joeyliu522/VVI-project/CAD files/Older 3D printed parts/production_parts/electronics/external_harness/EL-HR0181_Y-Z-end_Harness_revC.pdf

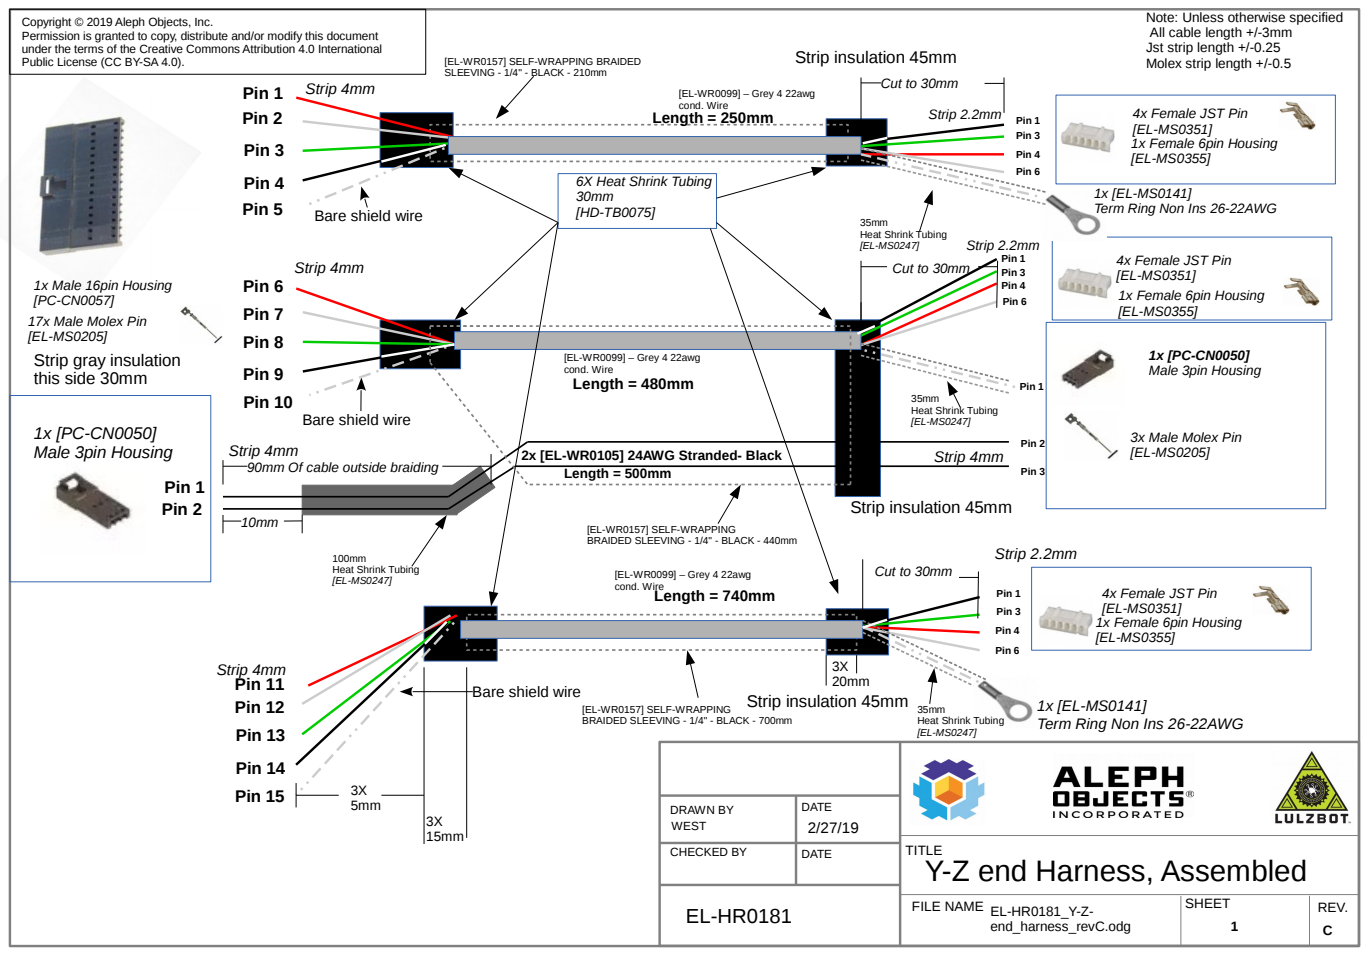
[picture p1: page 1]
FILE NAME; SHEET; REV.; Length = 250mm; Strip insulation 45mm; Pin 1 Pin 2; Pin 3; Pin 4 Pin 5; Pin 6; Strip 4mm; [EL-WR0099] – Grey 4 22awg; cond. Wire; 1x Female 6pin Housing [EL-MS0355]; Strip 2.2mm; Pin 7; Pin 8; Pin 9; Pin 10; Pin 11 Pin 12; Pin 15; Pin 13; Pin 14; [EL-MS0351] Pin 3; Pin 1; Pin 4; Length = 480mm; [EL-WR0099] – Grey 4 22awg cond. Wire; Length = 740mm; Pin 4 Pin 6; EL-HR0181_Y-Z- end_harness_revC.odg; Cut to 30mm; 35mm Heat Shrink Tubing [EL-MS0247]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

Copyright © 2019 Aleph Objects, Inc.
Permission is granted to copy, distribute and/or modify this document
under the terms of the Creative Commons Attribution 4.0 International
Public License (CC BY-SA 4.0).

Note: Unless otherwise specified
All cable length +/-3mm
Jst strip length +/-0.25
Molex strip length +/-0.5

[EL-WR0157] SELF-WRAPPING BRAIDED
SLEEVING - 1/4" - BLACK - 210mm

4x Female JST Pin

Term Ring Non Ins 26-22AWG

Bare shield wire

Heat Shrink Tubing
Cut to 30mm

1x Female 6pin Housing

1x Male 16pin Housing
17x Male Molex Pin
Strip gray insulation
this side 30mm

3x Male Molex Pin

Strip 4mm
90mm Of cable outside braiding

2x [EL-WR0105] 24AWG Stranded- Black
Length = 500mm

[EL-WR0157] SELF-WRAPPING
BRAIDED SLEEVING - 1/4" - BLACK - 440mm

BRAIDED SLEEVING - 1/4" - BLACK - 700mm

DRAWN BY WEST | DATE 2/27/19

CHECKED BY | DATE

TITLE
Y-Z end Harness, Assembled

Initial | comments | date | Rev
JW | update bom to have correct total amount of heat shrink tubing, remove pp-mp0059 | 03/25/19 | A
JW | Change pinout of z right jst side | 5/20/19 | B
JW | Add call out for position of heatshrink tubing | 7/10/19 | C

AO part number | qty | UoM | Supplier | supplier pn
EL-WR0099 | 1470 | mm | Allcable | C0762A.41.10
EL-MS0247 | 205 | mm | Electronics distributors corp | 88-01870
EL-MS0205 | 20 | pce | TTI global | 16-02-0107
HD-TB0075 | 180 | mm | McMaster | 7856k76
EL-WR0157 | 1350 | mm | Wirecare | F6N0.25BK
PC-CN0057 | 1 | pce | Sager | 70107-0015
EL-MS0351 | 12 | pce | Future electronics | SPH-002T-P0.5S
EL-MS0355 | 3 | pce | Future electronics | PHR-6
EL-MS0141 | 2 | pce | TTI global | P22-4R-M
PC-CN0050 | 2 | pce | TTI global | 701070002
EL-WR0105 | 1000 | mm | Allcable | HU1569247BK
