joeyliu522/VVI-project/CAD files/Older 3D printed parts/production_parts/electronics/external_harness/EL-HR0182_y_motor_ground_extension_revC.pdf

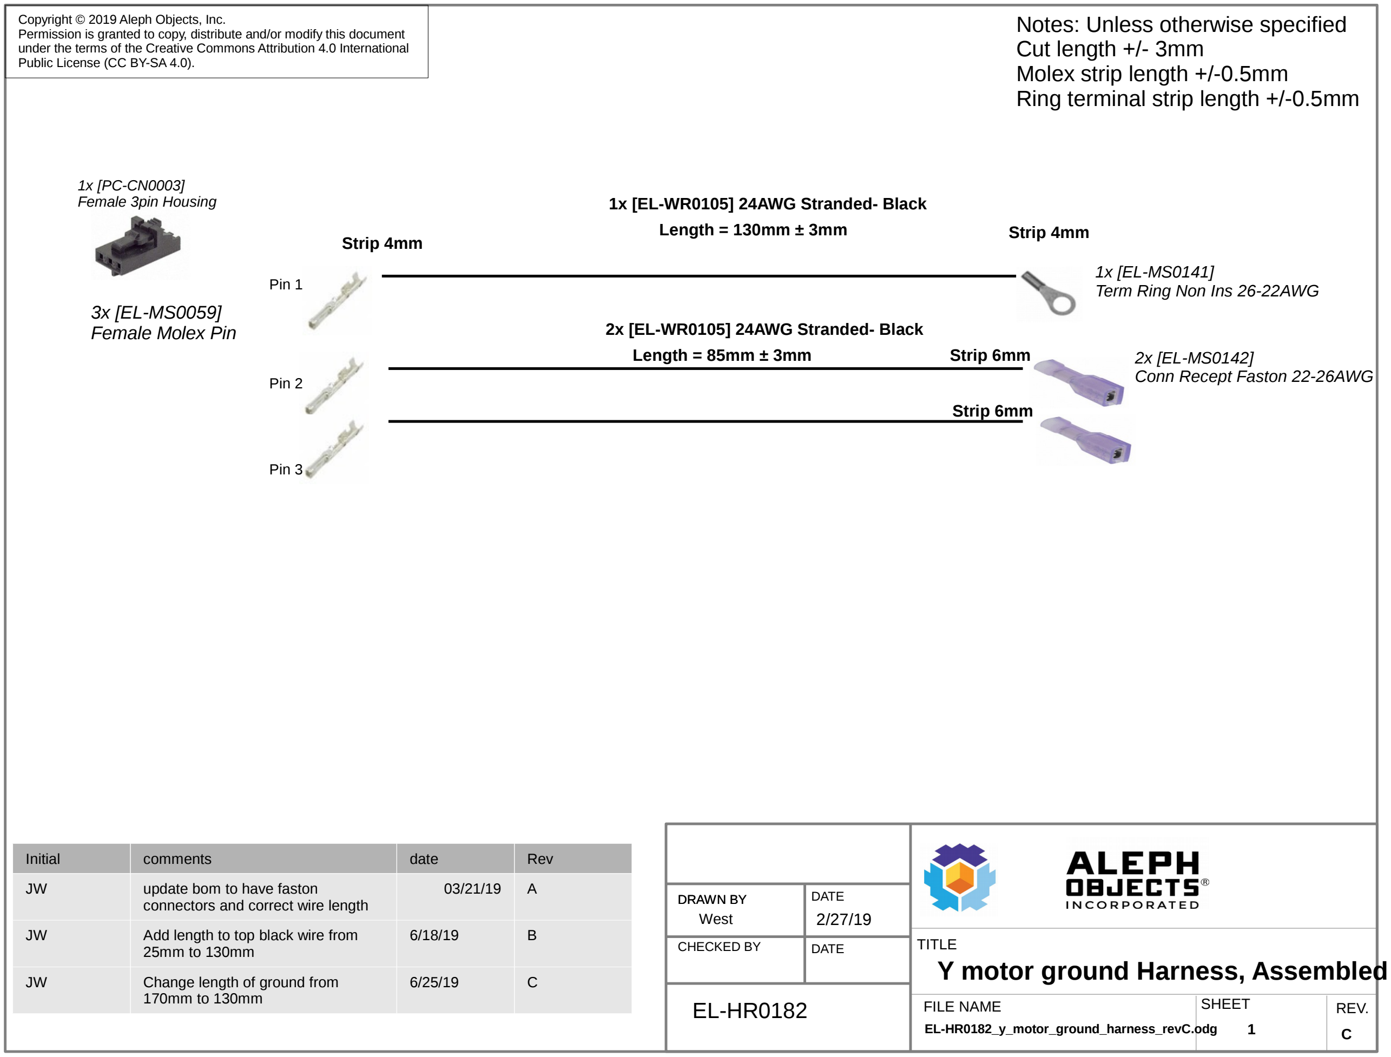
[picture p2: figure]
DRAWN BY DRAWN BY West; DATE 2/27/19; TITLE; FILE NAME; SHEET; REV.; Copyright © 2019 Aleph Objects, Inc.; Public License (CC BY-SA 4.0).; CHECKED BY; DATE; Length = 130mm ± 3mm; 1x [EL-WR0105] 24AWG Stranded- Black; Strip 4mm Strip 4mm; Pin 1; 1x [EL-MS0141] Term Ring Non Ins 26-22AWG; 3x [EL-MS0059] Female Molex Pin; Notes: Unless otherwise specified Cut length +/- 3mm Molex strip length +/-0.5mm Ring terminal strip length +/-0.5mm; 2x [EL-MS0142] Conn Recept Faston 22-26AWG; Strip 6mm; Pin 2; Pin 3; Length = 85mm ± 3mm; 1x [PC-CN0003] Female 3pin Housing; Y motor ground Harness, Assembled; 2x [EL-WR0105] 24AWG Stranded- Black; Initial; comments; date; Rev

Permission is granted to copy, distribute and/or modify this document under the terms of the Creative Commons Attribution 4.0 International

EL-HR0182_y_motor_ground_harness_revC.odg

JW | update bom to have faston connectors and correct wire length | 03/21/19 | A
JW | Add length to top black wire from 25mm to 130mm | 6/18/19 | B
JW | Change length of ground from 170mm to 130mm | 6/25/19 | C

AO P/n | qty | unit | Supplier | supplier P/n
PC-CN0003 | 1 | pce | TTI | 0050579403
EL-MS0059 | 3 | pce | TTI | 16-02-0086
EL-WR0105 | 340 | mm | Allcable | HU1569247B K
EL-MS0141 | 1 | pce | TTI | P22-4R-M
EL-MS0142 | 2 | pce | TTI | 7-520365-2
