joeyliu522/VVI-project/CAD files/Older 3D printed parts/production_parts/electronics/internal_harness/EL-HR0152_CB_PSU_to_ground_green.pdf

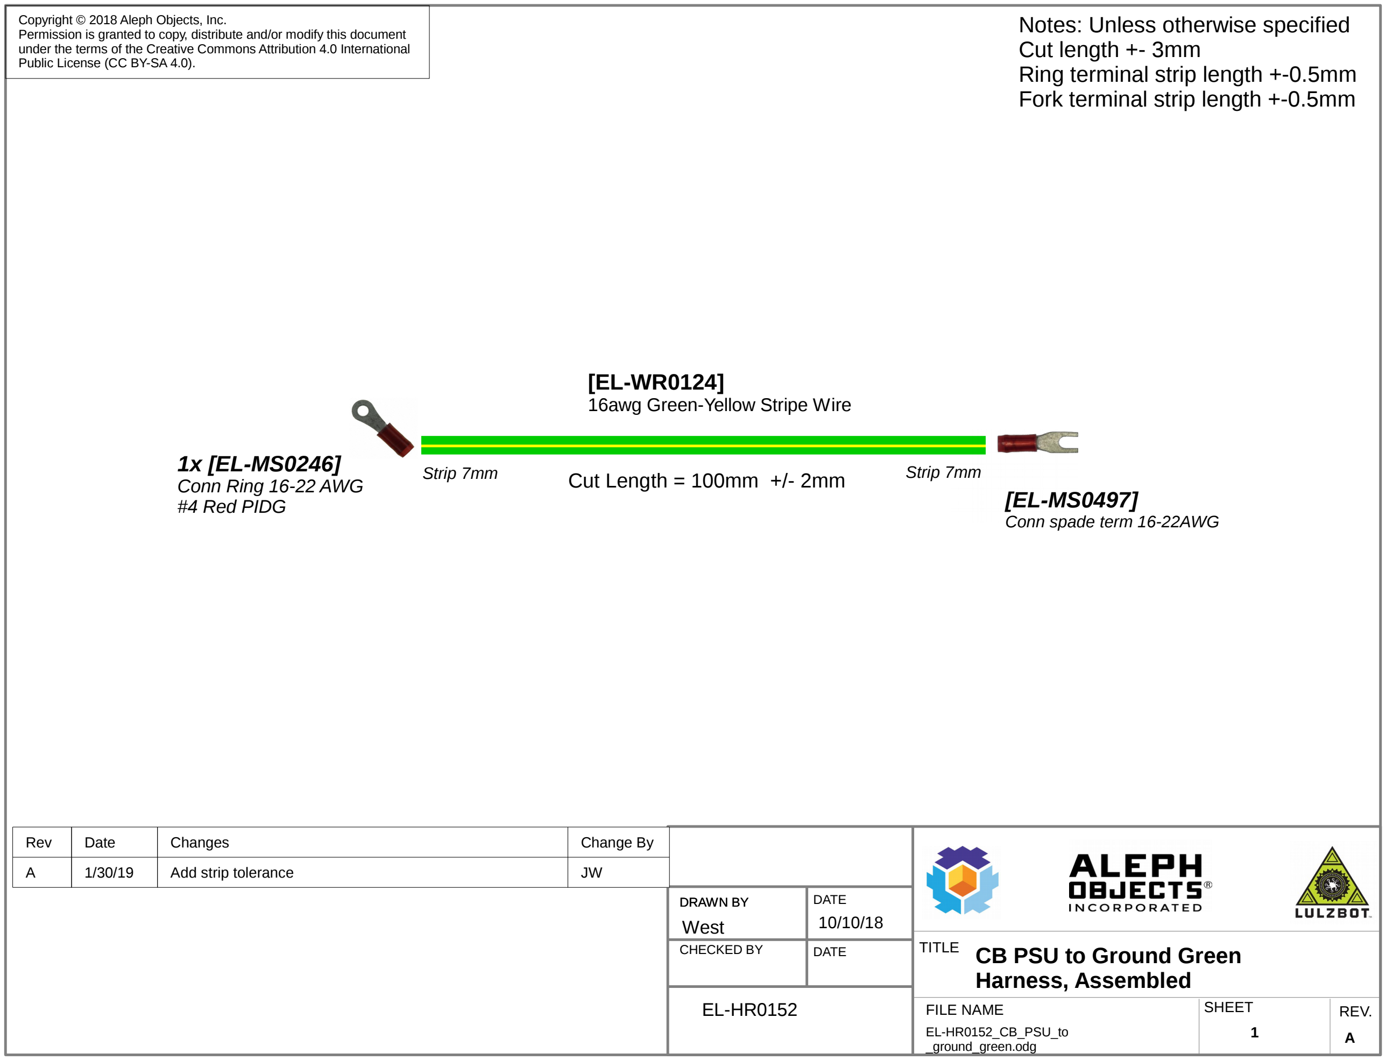
[picture p3: figure]
DRAWN BY DRAWN BY West; DATE 10/10/18; TITLE; FILE NAME; SHEET; REV.; CB PSU to Ground Green Harness, Assembled; Copyright © 2018 Aleph Objects, Inc.; Public License (CC BY-SA 4.0).; Cut Length = 100mm +/- 2mm; 1x [EL-MS0246] Conn Ring 16-22 AWG #4 Red PIDG; CHECKED BY; DATE; EL-HR0152_CB_PSU_to _ground_green.odg; [EL-WR0124] 16awg Green-Yellow Stripe Wire; Strip 7mm; [EL-MS0497] Conn spade term 16-22AWG; Notes: Unless otherwise specified Cut length +- 3mm Ring terminal strip length +-0.5mm Fork terminal strip length +-0.5mm; Rev; Date; Changes; Change By; Add strip tolerance

Permission is granted to copy, distribute and/or modify this document under the terms of the Creative Commons Attribution 4.0 International

AO P/n | qty | unit | Supplier | supplier P/n
EL-MS0246 | 1 | pce | digikey | A27229TR-ND
EL-WR0124 | 100 | mm | allcable | HU15691626 GN
EL-MS0497 | 1 | pce | tti | 2-34541-1
