joeyliu522/VVI-project/CAD files/Older 3D printed parts/production_parts/electronics/internal_harness/EL-HR0154_CB_DC_Power_Harness.pdf

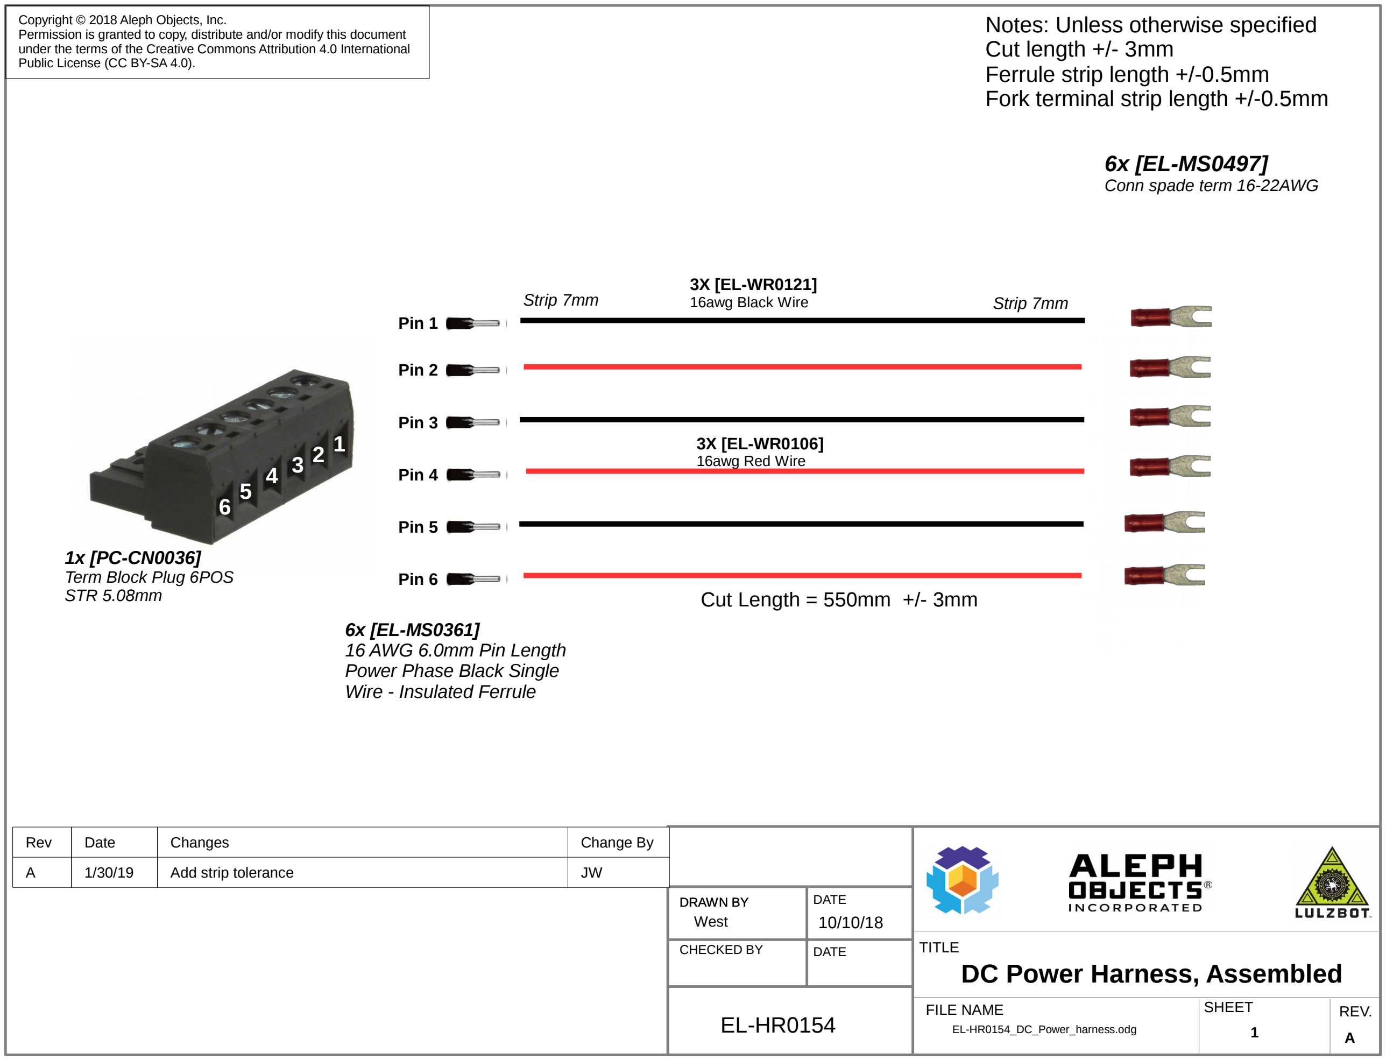
[picture p4: figure]
DRAWN BY DRAWN BY West; DATE 10/10/18; TITLE; FILE NAME; SHEET; REV.; DC Power Harness, Assembled; Copyright © 2018 Aleph Objects, Inc.; Public License (CC BY-SA 4.0).; Cut Length = 550mm +/- 3mm; 6x [EL-MS0361] 16 AWG 6.0mm Pin Length Power Phase Black Single Wire - Insulated Ferrule; CHECKED BY; DATE; Strip 7mm; 16awg Black Wire; 3X [EL-WR0106] 16awg Red Wire; Pin 1; Pin 2; Pin 3; Pin 4; Pin 5; Pin 6; 1x [PC-CN0036] Term Block Plug 6POS STR 5.08mm; 6x [EL-MS0497] Conn spade term 16-22AWG; EL-HR0154_DC_Power_harness.odg; Notes: Unless otherwise specified Cut length +/- 3mm Ferrule strip length +/-0.5mm Fork terminal strip length +/-0.5mm; Rev; Date; Changes; Change By; Add strip tolerance

Permission is granted to copy, distribute and/or modify this document under the terms of the Creative Commons Attribution 4.0 International

AO P/n | qty | unit | Supplier | supplier P/n
EL-WR0121 | 1650 | mm | Allcable | HU15691626BK
EL-WR0106 | 1650 | mm | Allcable | HU15691626RD
PC-CN0036 | 1 | pce | TTI Global Distribution | 03953000006
EL-MS0361 | 6 | pce | TTI Global Distribution | FSD78-6-D
EL-MS0497 | 6 | pce | TTI Global Distribution | 2-34541-1
