joeyliu522/VVI-project/CAD files/Older 3D printed parts/production_parts/electronics/internal_harness/EL-HR0167_plug_to_ground_green.pdf

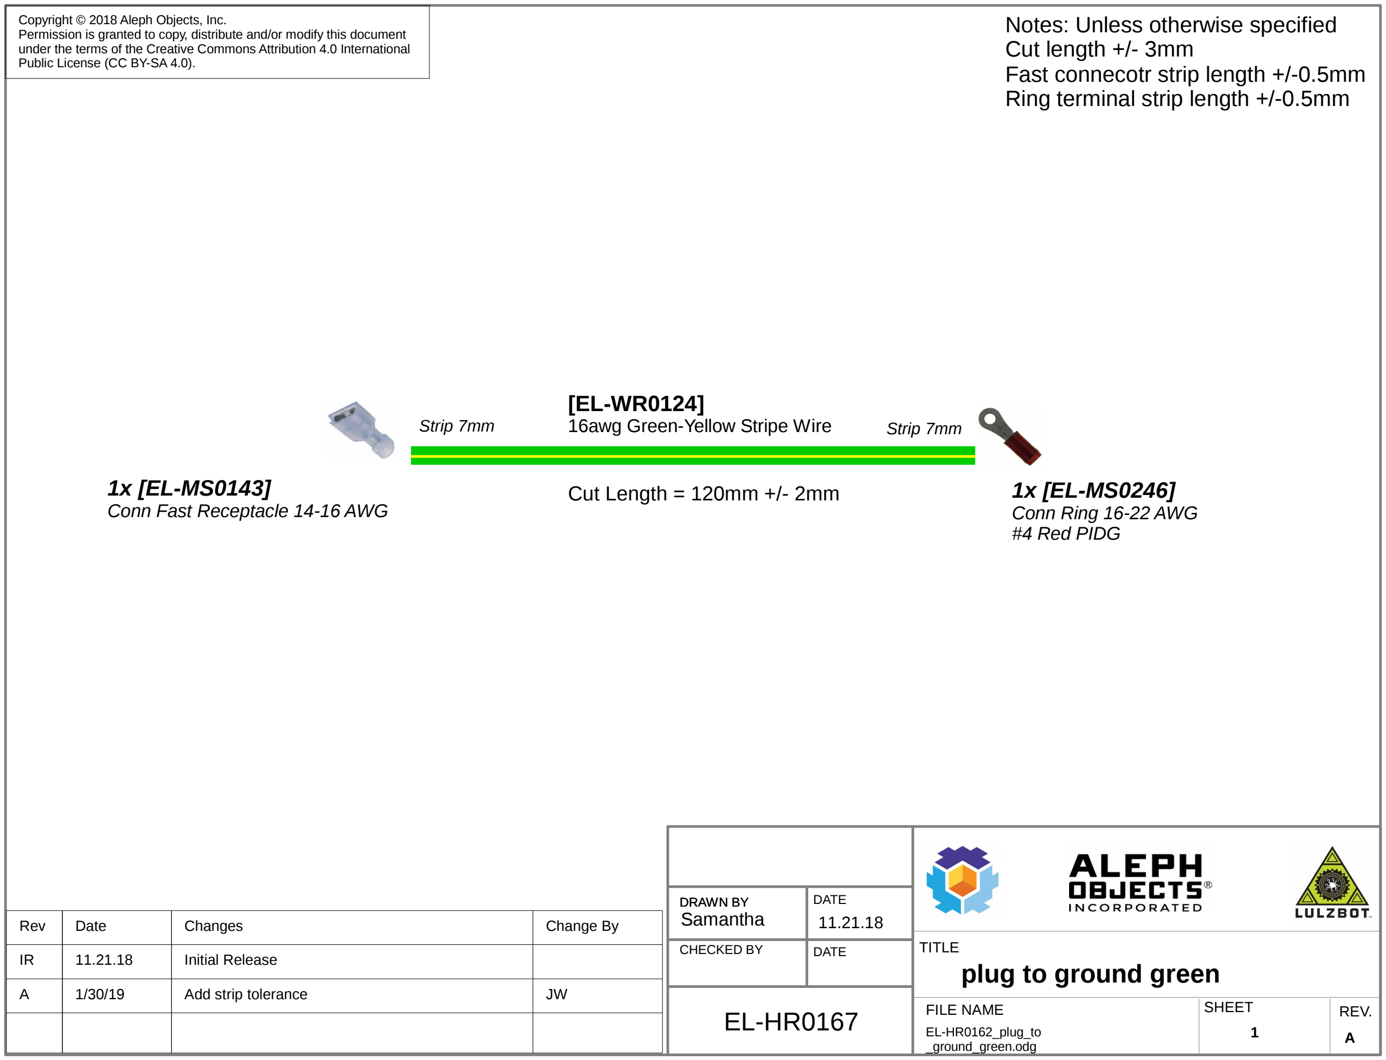
[picture p5: figure]
TITLE; FILE NAME; SHEET; REV.; plug to ground green; Copyright © 2018 Aleph Objects, Inc.; Public License (CC BY-SA 4.0).; Cut Length = 120mm +/- 2mm; CHECKED BY; DATE; EL-HR0162_plug_to _ground_green.odg; 1x [EL-MS0246] Conn Ring 16-22 AWG #4 Red PIDG; 1x [EL-MS0143] Conn Fast Receptacle 14-16 AWG; Rev; Date; Changes; Change By; Initial Release; Add strip tolerance; Notes: Unless otherwise specified Cut length +/- 3mm Fast connecotr strip length +/-0.5mm Ring terminal strip length +/-0.5mm

DRAWN BY DRAWN BY Samantha | DATE 11.21.18

Permission is granted to copy, distribute and/or modify this document under the terms of the Creative Commons Attribution 4.0 International

Strip 7mm | 16awg Green-Yellow Stripe Wire | Strip 7mm

AO P/n | qty | unit | Supplier | supplier P/n
EL-MS0143 | 1 | pce | TTI Global Distribution | 3-350820-2
EL-WR0124 | 120 | mm | Allcable | HU15691626GN
EL-MS0246 | 1 | pce | Digi-Key Corp | A27229TR-ND
