joeyliu522/VVI-project/CAD files/Older 3D printed parts/production_parts/electronics/toolhead/AS-CB0061_extruder_motor_harness_revB.pdf

DRAWN BY DRAWN BY Tutley | DATE 09/28/2017
CHECKED BY Kent | DATE 11/14/17

TITLE

FILE NAME AS-CB0061_extruder_motor_harness_revB.odg | SHEET 1 | REV. B

v2Aero Extruder Motor Harness

Copyright © 2017 Aleph Objects, Inc.
Permission is granted to copy, distribute and/or modify this document under the terms of the Creative Commons Attribution 4.0 International Public License (CC BY-SA 4.0).

4x
[EL-MS0480]
CONN TERM MALE
20-24AWG TIN
(Micro-Fit 3.0™)

1x [PC-CN0101]
Molex-CONN PLUG 20POS
3MM VERT DUAL, BLACK

1 11

2

3 | 13
4 | 14
5 | 15
6 | 16
7 | 17
8 | 18

Pin 1

12

| 9 | 19
Length = 180mm | 10 | 20

Pin 4

Strip 2.5mm | [EL-WR0103] – 24awg Red Wire

[EL-WR0105] – 24awg Black Wire

Strip 3mm

Pin 6

[EL-WR0107] – 24awg White Wire

[EL-WR0119] – 24awg Green Wire
Pin 3

Pin 1

Pin 11

Pin 1

Pin 12

Pin 2

1x 2mm 6pos Connector
[EL-MS0355]

4x Female JST Pin
[EL-MS0351]
Rev | Date | Changes | Change by
A | 11/1/17 | Adjusted strip length for molex microfit from 4mm to 3mm | TJU | AS-CB0061
B | 11/14/17 | Changed PN for connector housing | Kent

AO part number | qty | UoM | Supplier | supplier pn
EL-MS0351 | 4 | pce | Future electronics | SPH-002T-P0.5S
EL-MS0355 | 1 | pce | Future electronics | PHR-6
EL-MS0480 | 4 | pce | TTI global | 43031-0001
PC-CN0101 | 1 | pce | TTI global | 43020-2001
EL-WR0105 | 180 | mm | Allcable | HU1569247BK
EL-WR0107 | 180 | mm | Allcable | HU1569247WE
EL-WR0119 | 180 | mm | Allcable | HU1569247GN
EL-WR0103 | 180 | mm | Allcable | HU1569247RD
