joeyliu522/VVI-project/CAD files/Older 3D printed parts/production_parts/electronics/toolhead/AS-CB0062_230mm_extruder_blower_harness_revB.pdf

DRAWN BY DRAWN BY Tutley | DATE 09/28/2017
CHECKED BY | DATE

TITLE

FILE NAME | SHEET | REV.

# V2Aero Extruder Blower Harness

Copyright © 2018 Aleph Objects, Inc.
Permission is granted to copy, distribute and/or modify this document under the terms of the Creative Commons Attribution 4.0 International Public License (CC BY-SA 4.0).

B

AS-CB0062_230mm_extruder_
blower_harness_revB.odg | 1

### Length = 230mm

### 1x [EL-FA0047]

## 51x15 24v Blower

Rev | Date | Changes | Change By | Mini 2 / TAZ 7
A | 11/1/17 | Reduced strip length for microfit terminals from 4mm to 3mm | LF
B | 3/22/18 | Reduce cut length by 20mm | West

Strip 3mm
2x

## [EL-MS0480] CONN TERM MALE 20-24AWG TIN (Micro-Fit 3.0™)

# AS-CB0062

## These wires are 28AWG
