joeyliu522/VVI-project/CAD files/Older 3D printed parts/production_parts/electronics/toolhead/AS-CB0063_hotend_gnd_wire_revB.pdf

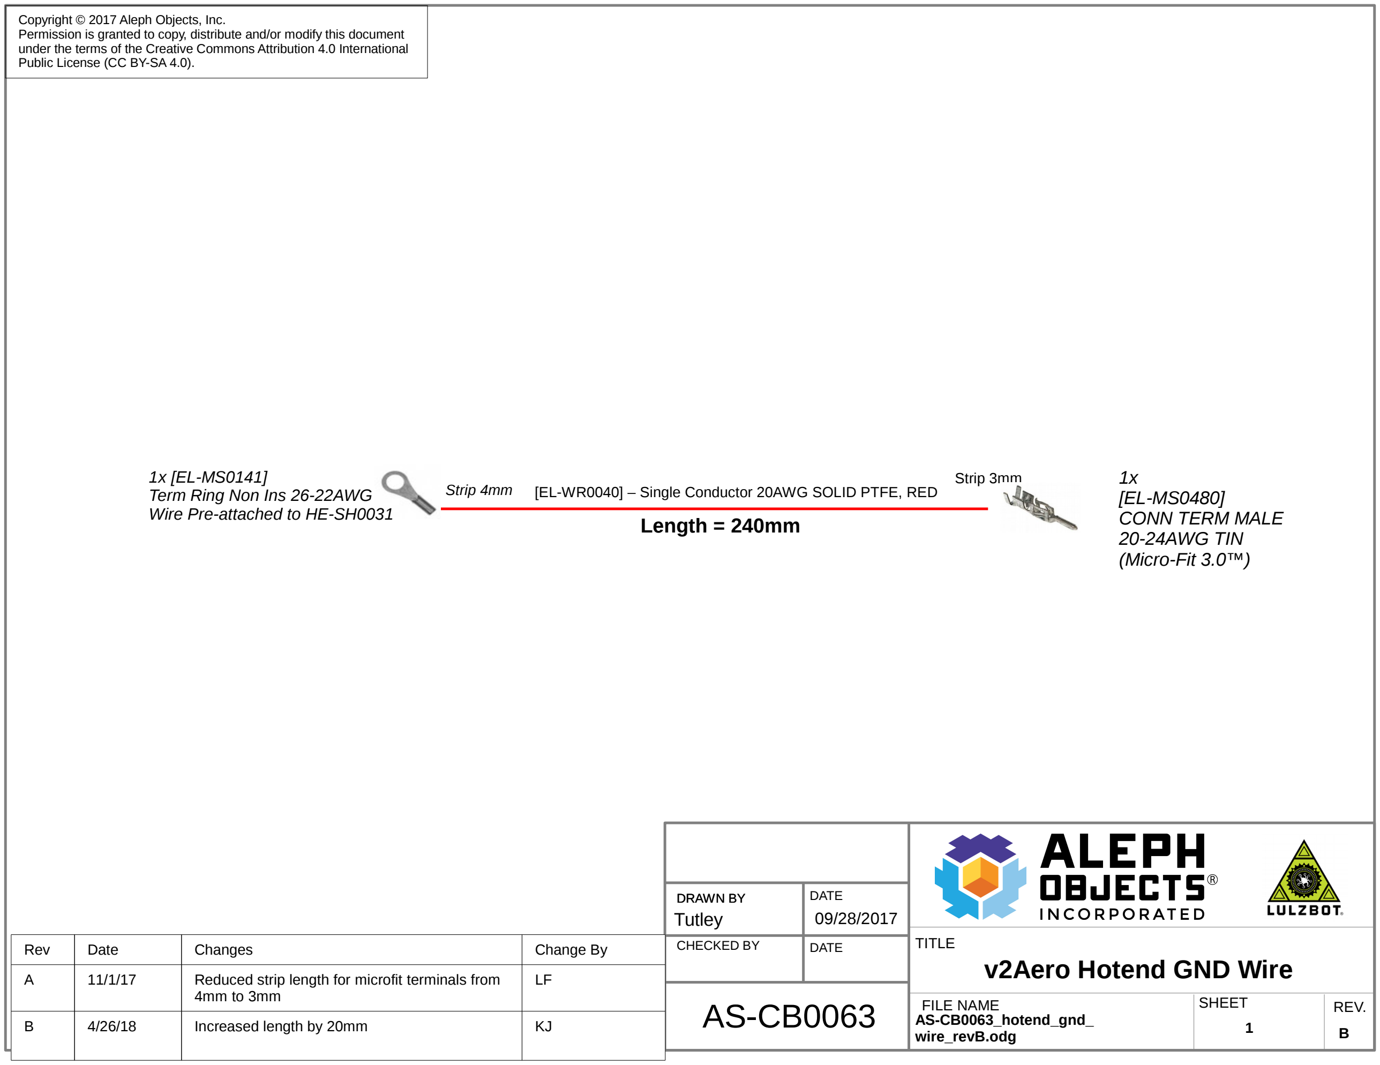
[picture p6: figure]
TITLE; FILE NAME; SHEET; REV.; v2Aero Hotend GND Wire; Copyright © 2017 Aleph Objects, Inc.; Public License (CC BY-SA 4.0).; Length = 240mm; 1x [EL-MS0141] Term Ring Non Ins 26-22AWG Wire Pre-attached to HE-SH0031; Strip 3mm; AS-CB0063_hotend_gnd_ wire_revB.odg; 1x [EL-MS0480] CONN TERM MALE 20-24AWG TIN (Micro-Fit 3.0™)

DRAWN BY DRAWN BY Tutley | DATE 09/28/2017
Rev | Date | Changes | Change By | CHECKED BY | DATE

Permission is granted to copy, distribute and/or modify this document under the terms of the Creative Commons Attribution 4.0 International

Strip 4mm | [EL-WR0040] – Single Conductor 20AWG SOLID PTFE, RED
A | 11/1/17 | Reduced strip length for microfit terminals from
B | 4/26/18 | Increased length by 20mm | KJ | AS-CB0063

AO part number | qty | UoM | Supplier | supplier pn
EL-MS0480 | 1 | pce | TTI global | 43031-0001
EL-MS0141 | 1 | pce | TTI global | P22-4R-M
EL-WR0040 | 240 | mm | Allcable | M16878/4BGA-2
