joeyliu522/VVI-project/CAD files/Older 3D printed parts/production_parts/electronics/toolhead/AS-CB0066_120mm_thermistor_harness_revA.pdf

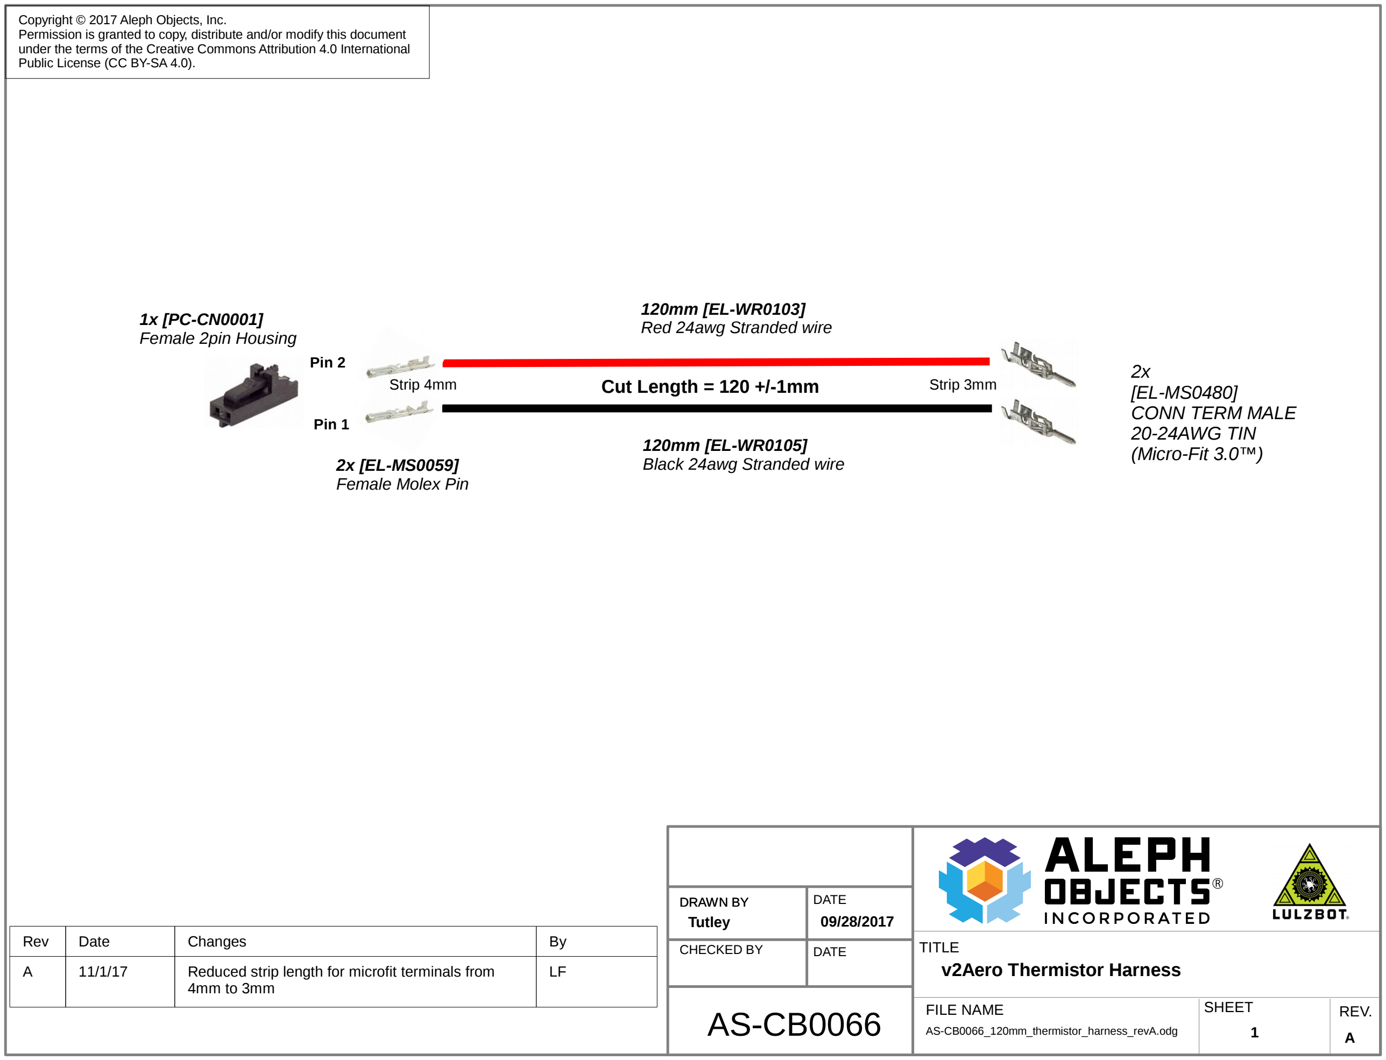
[picture p7: figure]
TITLE; FILE NAME; SHEET; REV.; v2Aero Thermistor Harness; Copyright © 2017 Aleph Objects, Inc.; Public License (CC BY-SA 4.0).; CHECKED BY; DATE; Cut Length = 120 +/-1mm; Strip 3mm; Rev; Date; Changes; 120mm [EL-WR0103] Red 24awg Stranded wire; 120mm [EL-WR0105] Black 24awg Stranded wire; Pin 1; Pin 2; 1x [PC-CN0001] Female 2pin Housing; 2x [EL-MS0059] Female Molex Pin; Strip 4mm; 2x [EL-MS0480] CONN TERM MALE 20-24AWG TIN (Micro-Fit 3.0™)

DRAWN BY DRAWN BY Tutley | DATE 09/28/2017

Permission is granted to copy, distribute and/or modify this document under the terms of the Creative Commons Attribution 4.0 International

AS-CB0066_120mm_thermistor_harness_revA.odg | 1
A | 11/1/17 | Reduced strip length for microfit terminals from 4mm to 3mm | LF

AO part number | qty | UoM | Supplier | supplier pn
PC-CN0001 | 1 | pce | Sager | 50579402
EL-MS0059 | 2 | pce | TTI global | 16-02-0086
EL-MS0480 | 2 | pce | TTI global | 43031-0001
EL-WR0105 | 180 | mm | Allcable | HU1569247BK
EL-WR0103 | 180 | mm | Allcable | HU1569247RD
