joeyliu522/VVI-project/CAD files/STLs/Servo_Mount_Chinese.stl

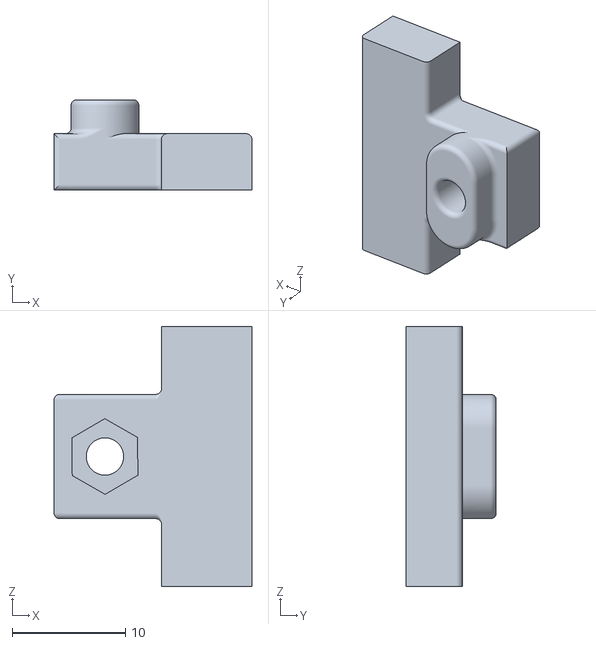
[picture p12: CAD file, 2023-08-08]
CAD files/STLs/Servo_Mount_Chinese.stl
17.5 x 8.00 x 23.0
