joeyliu522/VVI-project/CAD files/STLs/Cage_Holder_Corner.stl

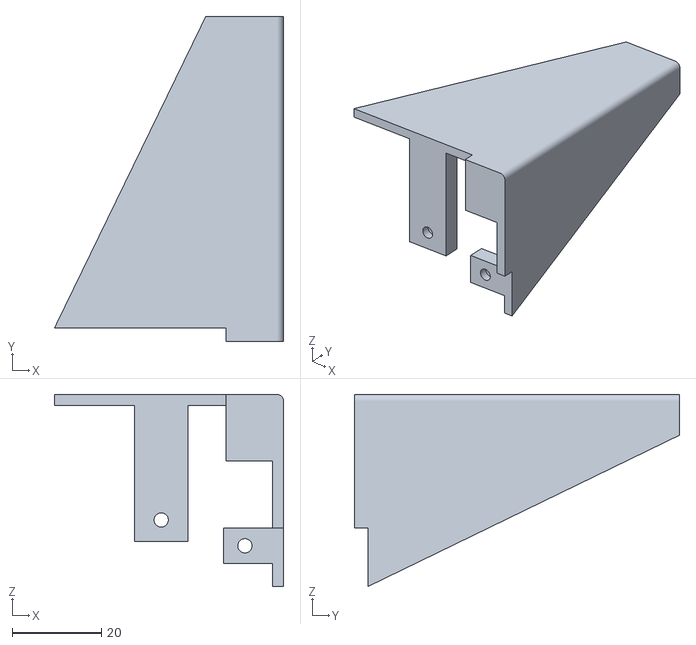
[picture p13: CAD file, 2023-08-08]
CAD files/STLs/Cage_Holder_Corner.stl
51.5 x 73.0 x 43.2
