joeyliu522/VVI-project/CAD files/STLs/Left_Cover_Sorter_Case.stl

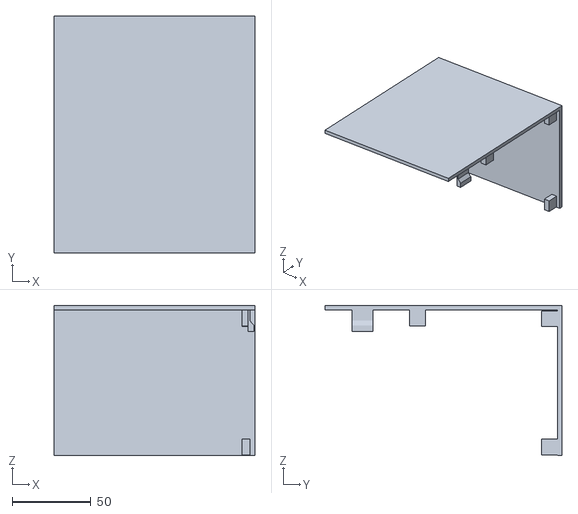
[picture p14: CAD file, 2023-08-08]
CAD files/STLs/Left_Cover_Sorter_Case.stl
128.0 x 150.9 x 95.7
