joeyliu522/VVI-project/CAD files/STLs/Antenna_Holder_Cap.stl

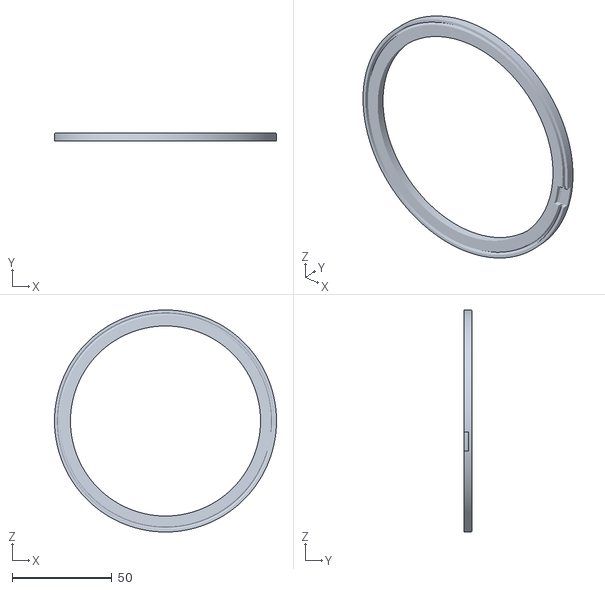
[picture p15: CAD file, 2023-08-08]
CAD files/STLs/Antenna_Holder_Cap.stl
111.1 x 4.00 x 111.1
