joeyliu522/VVI-project/CAD files/STLs/Cage_Holder_Leg.stl

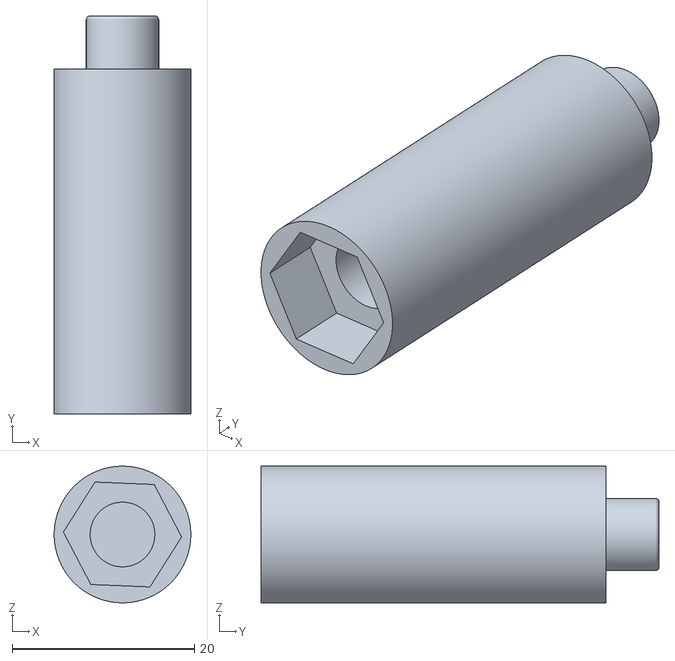
[picture p16: CAD file, 2023-08-08]
CAD files/STLs/Cage_Holder_Leg.stl
15.0 x 43.7 x 15.0
