joeyliu522/VVI-project/CAD files/STLs/Center_Cover_Sorter_Case.stl

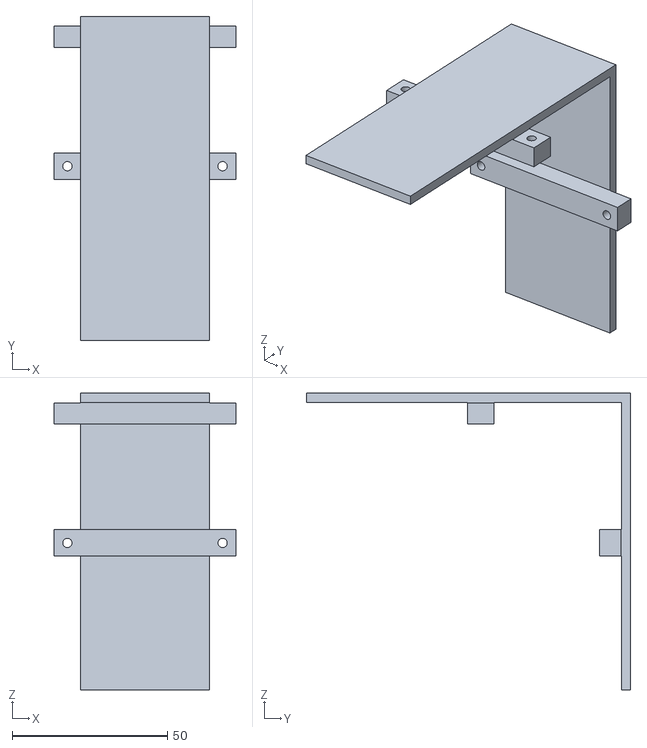
[picture p17: CAD file, 2023-08-08]
CAD files/STLs/Center_Cover_Sorter_Case.stl
58.5 x 104.5 x 95.7
