joeyliu522/VVI-project/CAD files/STLs/Antenna_Holder_Base.stl

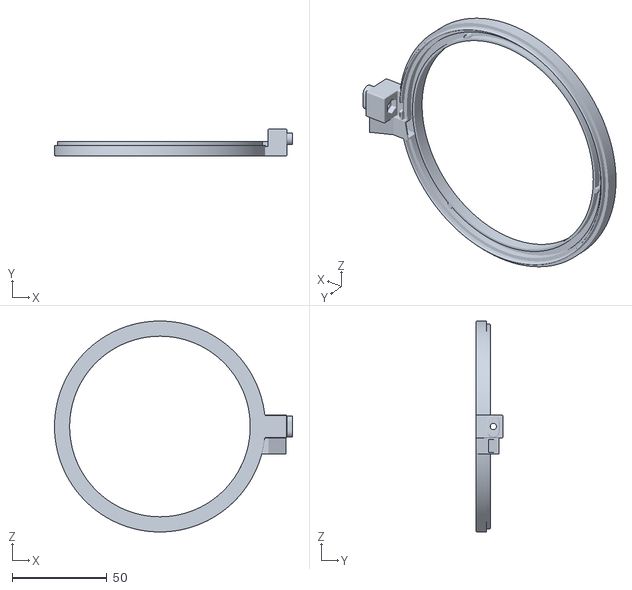
[picture p18: CAD file, 2023-08-08]
CAD files/STLs/Antenna_Holder_Base.stl
125.4 x 14.0 x 111.1
