joeyliu522/VVI-project/CAD files/STLs/Center_Wall_Sorter_Case.stl

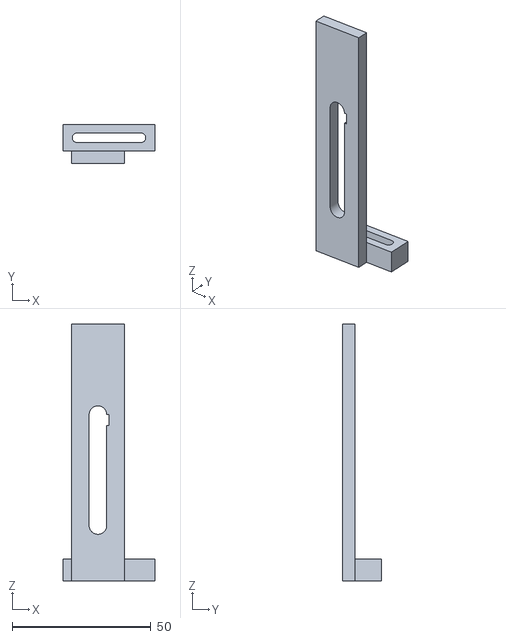
[picture p19: CAD file, 2023-08-08]
CAD files/STLs/Center_Wall_Sorter_Case.stl
33.0 x 14.0 x 92.7
