joeyliu522/VVI-project/CAD files/STLs/Right_Wall_Sorter_Case.stl

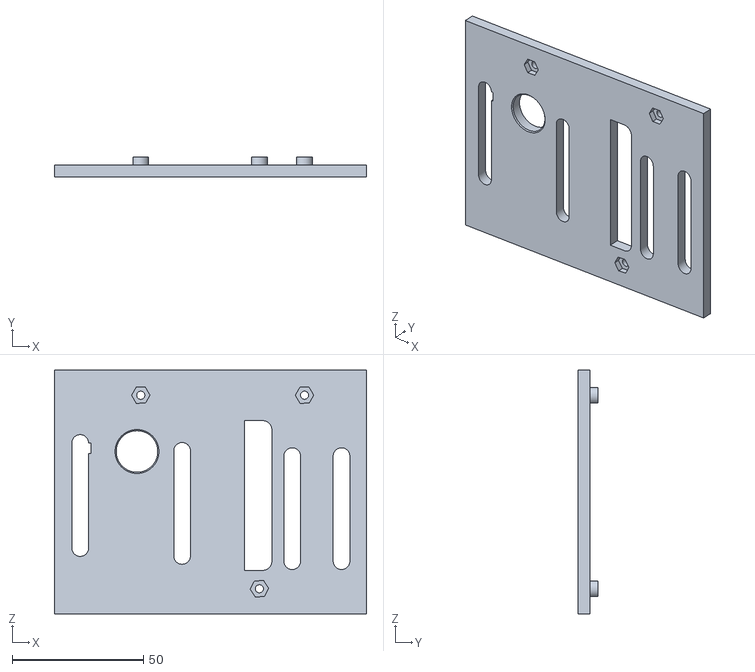
[picture p20: CAD file, 2023-08-08]
CAD files/STLs/Right_Wall_Sorter_Case.stl
118.8 x 7.50 x 92.7
