joeyliu522/VVI-project/CAD files/STLs/Left_Wall_Sorter_Case.stl

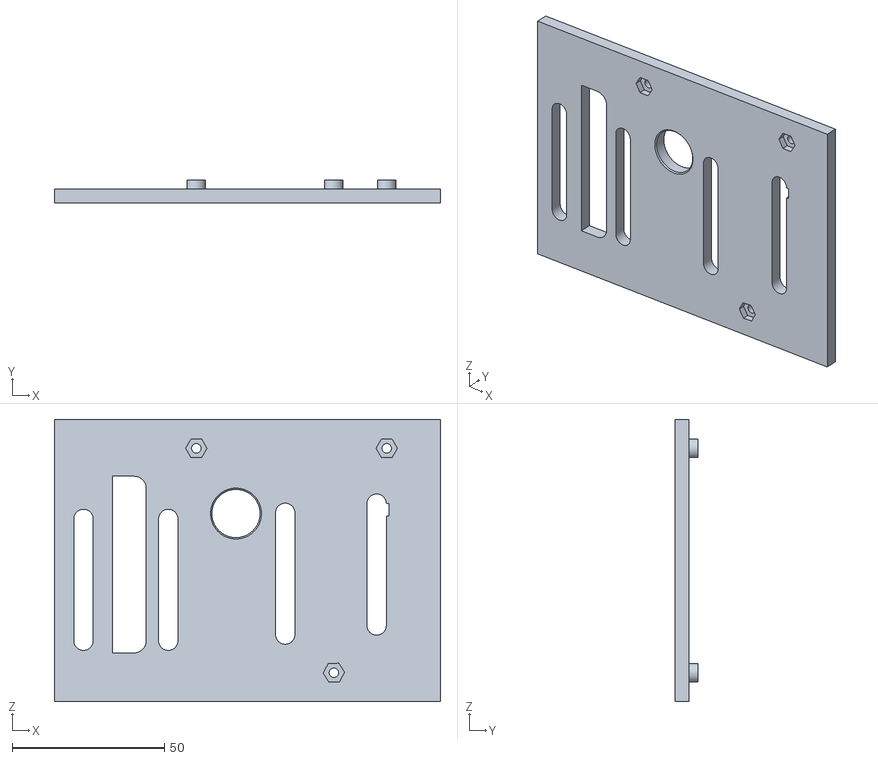
[picture p21: CAD file, 2023-08-08]
CAD files/STLs/Left_Wall_Sorter_Case.stl
126.7 x 7.50 x 92.7
