joeyliu522/VVI-project/CAD files/STLs/Servo_Mount_HiTec.stl

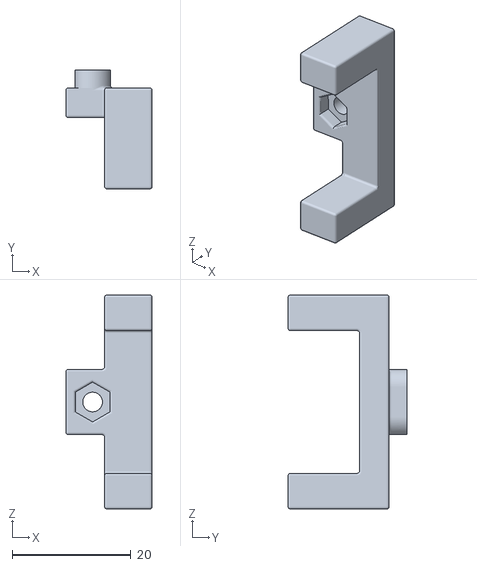
[picture p23: CAD file, 2023-08-08]
CAD files/STLs/Servo_Mount_HiTec.stl
14.5 x 20.0 x 36.0
