joeyliu522/VVI-project/CAD files/STLs/Connecting_Plate_Sorter_Case.stl

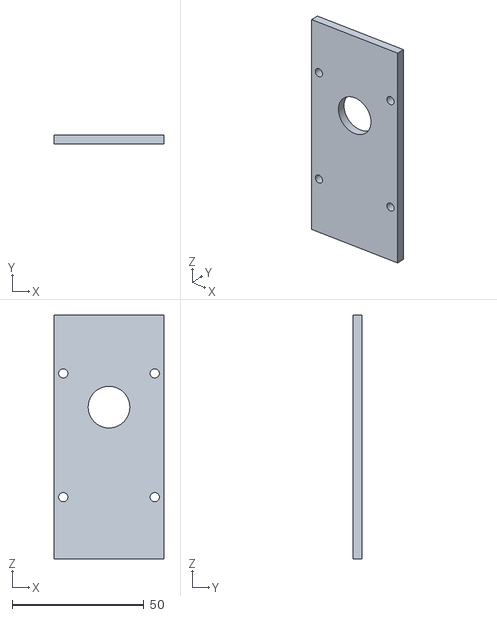
[picture p24: CAD file, 2023-08-08]
CAD files/STLs/Connecting_Plate_Sorter_Case.stl
41.8 x 3.50 x 92.7
