joeyliu522/VVI-project/CAD files/STLs/Left_Bracket_Sorter_Case.stl

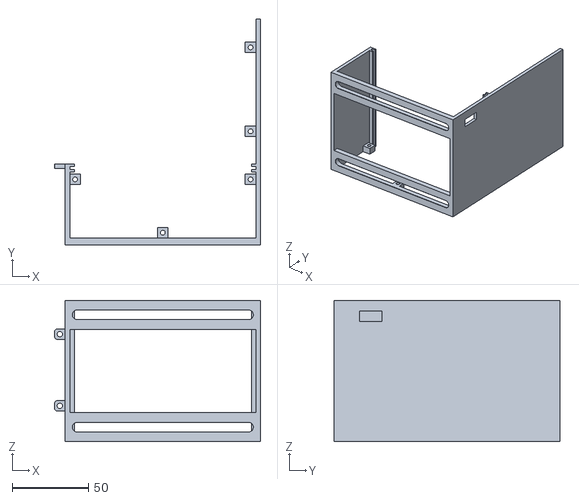
[picture p25: CAD file, 2023-08-08]
CAD files/STLs/Left_Bracket_Sorter_Case.stl
135.0 x 147.9 x 92.7
