joeyliu522/VVI-project/CAD files/STLs/Separating_Plate_Sorter_Case.stl

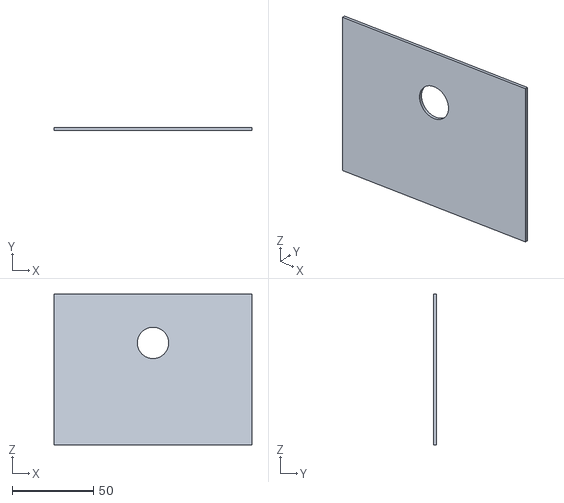
[picture p26: CAD file, 2023-08-08]
CAD files/STLs/Separating_Plate_Sorter_Case.stl
121.7 x 1.65 x 92.7
