joeyliu522/VVI-project/CAD files/Older 3D printed parts/production_parts/tooling/control_box_test_stand/assembly/assembly_front.fcstd

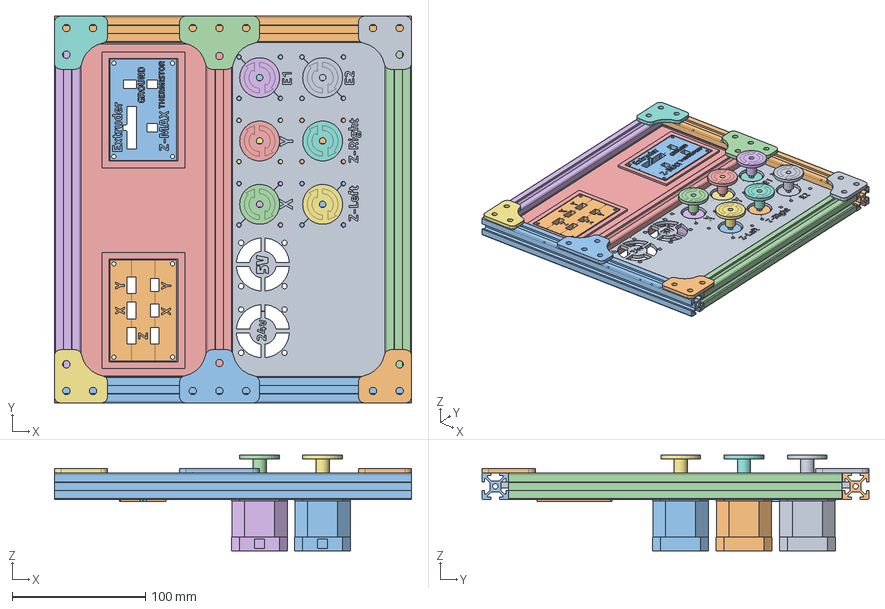
[picture p27: CAD file, 2023-08-08, an earlier design]
CAD files/Older 3D printed parts/production_parts/tooling/control_box_test_stand/assembly/assembly_front.fcstd
268.0 x 290.3 x 71.8 mm
panel_front_bottom_01
268mm_extrusion_01
268mm_extrusion_02
250mm_extrusion_01
250mm_extrusion_02
250mm_extrusion_03
frame_corner_01
frame_corner_02
frame_corner_03
frame_corner_04
frame_t_01
frame_t_02
panel_front_top_main_01
nema_17_motor_01
nema_17_motor_02
nema_17_motor_03
nema_17_motor_04
nema_17_motor_05
nema_17_motor_06
stepper_arrow_01
stepper_arrow_02
stepper_arrow_03
stepper_arrow_04
stepper_arrow_05
stepper_arrow_06
panel_front_top_left_01
panel_front_top_right_01
