joeyliu522/VVI-project/CAD files/Older 3D printed parts/production_parts/tooling/y-axis_assembly_jig/y-axis_assemblyjig_v2.1.fcstd

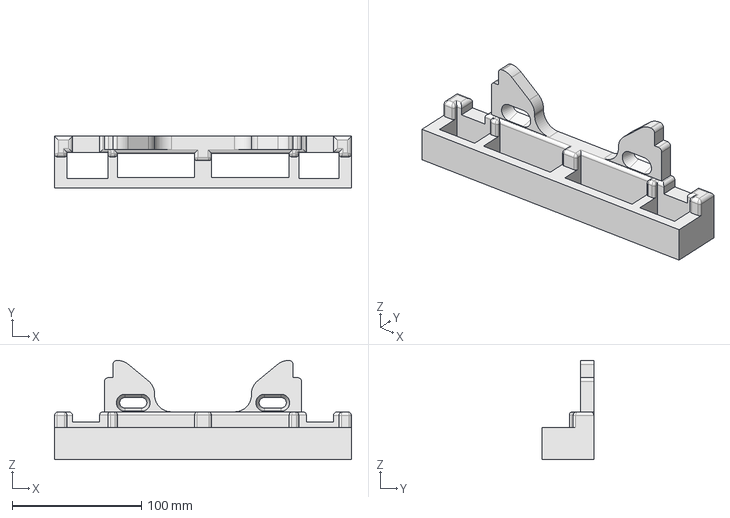
[picture p28: CAD file, 2023-08-08, an earlier design]
CAD files/Older 3D printed parts/production_parts/tooling/y-axis_assembly_jig/y-axis_assemblyjig_v2.1.fcstd
230.0 x 40.0 x 76.8 mm
