joeyliu522/VVI-project/(list of files, cad)

Other CAD files:
CAD files/STLs/Right_Cover_Sorter_Case.stl
CAD files/Older 3D printed parts/STL files/Center Cover.stl
CAD files/Older 3D printed parts/STL files/Center Wall.stl
CAD files/Older 3D printed parts/STL files/Connecting Plate.stl
CAD files/Older 3D printed parts/STL files/Left Bracket.stl
CAD files/Older 3D printed parts/STL files/Left Cover.stl
CAD files/Older 3D printed parts/STL files/Left Wall.stl
CAD files/Older 3D printed parts/STL files/Right Bracket.stl
CAD files/Older 3D printed parts/STL files/Right Cover.stl
CAD files/Older 3D printed parts/STL files/Right Wall.stl
CAD files/Older 3D printed parts/STL files/Separating Plate.stl
CAD files/Older 3D printed parts/production_parts/assemblies/10mm_high_precision_bushing.fcstd
CAD files/Older 3D printed parts/production_parts/assemblies/10mm_leveling_washer_spacer.fcstd
CAD files/Older 3D printed parts/production_parts/assemblies/10mm_self_aligning_bushing.fcstd
CAD files/Older 3D printed parts/production_parts/assemblies/10x405mm_smooth_rod.fcstd
CAD files/Older 3D printed parts/production_parts/assemblies/10x500_smooth_rod.fcstd
CAD files/Older 3D printed parts/production_parts/assemblies/12mm_high_precision_bushing.fcstd
CAD files/Older 3D printed parts/production_parts/assemblies/12x540MM_smooth_rod.fcstd
CAD files/Older 3D printed parts/production_parts/assemblies/40mm_fan.fcstd
CAD files/Older 3D printed parts/production_parts/assemblies/50mm_blower.fcstd
CAD files/Older 3D printed parts/production_parts/assemblies/5_1_stepper_motor.fcstd
CAD files/Older 3D printed parts/production_parts/assemblies/625_bearing.fcstd
CAD files/Older 3D printed parts/production_parts/assemblies/80MM_FAN.fcstd
CAD files/Older 3D printed parts/production_parts/assemblies/8x10mm_spacer.fcstd
CAD files/Older 3D printed parts/production_parts/assemblies/90degree_bracket.fcstd
CAD files/Older 3D printed parts/production_parts/assemblies/LCD.fcstd
CAD files/Older 3D printed parts/production_parts/assemblies/M2_insert.fcstd
CAD files/Older 3D printed parts/production_parts/assemblies/M3_insert.fcstd
CAD files/Older 3D printed parts/production_parts/assemblies/M5_insert.fcstd
CAD files/Older 3D printed parts/production_parts/assemblies/M5x16_thumb_screw.fcstd
CAD files/Older 3D printed parts/production_parts/assemblies/NEMA17_half_size.fcstd
CAD files/Older 3D printed parts/production_parts/assemblies/RAMBo.fcstd
CAD files/Older 3D printed parts/production_parts/assemblies/bed_standoff.fcstd
CAD files/Older 3D printed parts/production_parts/assemblies/dual_connector.fcstd
CAD files/Older 3D printed parts/production_parts/assemblies/grounding_bracket.fcstd
CAD files/Older 3D printed parts/production_parts/assemblies/heatbed.fcstd
CAD files/Older 3D printed parts/production_parts/assemblies/insert_assmeblies/Y_belt_clamp_inserts.fcstd
CAD files/Older 3D printed parts/production_parts/assemblies/insert_assmeblies/Y_corner_left_insert.fcstd
CAD files/Older 3D printed parts/production_parts/assemblies/insert_assmeblies/Y_corner_right_inserts.fcstd
CAD files/Older 3D printed parts/production_parts/assemblies/insert_assmeblies/Y_idler_housing_inserts.fcstd
CAD files/Older 3D printed parts/production_parts/assemblies/insert_assmeblies/Z_upper_right_inserts.fcstd
CAD files/Older 3D printed parts/production_parts/assemblies/insert_assmeblies/bed_mount_chassis_inserts.fcstd
CAD files/Older 3D printed parts/production_parts/assemblies/insert_assmeblies/extruder_cap_inserts_revA.fcstd
CAD files/Older 3D printed parts/production_parts/assemblies/insert_assmeblies/extruder_mount_inserts.fcstd
CAD files/Older 3D printed parts/production_parts/assemblies/insert_assmeblies/idler-tube-clamp_right_inserts.fcstd
CAD files/Older 3D printed parts/production_parts/assemblies/insert_assmeblies/universal_blower_shroud_inserts.fcstd
CAD files/Older 3D printed parts/production_parts/assemblies/insert_assmeblies/v3_adaptor_inserts.fcstd
CAD files/Older 3D printed parts/production_parts/assemblies/insert_assmeblies/x_belt_clamp_inserts.fcstd
CAD files/Older 3D printed parts/production_parts/assemblies/insert_assmeblies/x_belt_tensioner_inserts.fcstd
CAD files/Older 3D printed parts/production_parts/assemblies/insert_assmeblies/x_carriage_cover_inserts.fcstd
CAD files/Older 3D printed parts/production_parts/assemblies/insert_assmeblies/x_carriage_sub assembly.fcstd
CAD files/Older 3D printed parts/production_parts/assemblies/insert_assmeblies/x_double_bearing_holder_sub-assembly.fcstd
CAD files/Older 3D printed parts/production_parts/assemblies/insert_assmeblies/x_idler_inserts.fcstd
CAD files/Older 3D printed parts/production_parts/assemblies/insert_assmeblies/x_motor_sub_assmebly.fcstd
CAD files/Older 3D printed parts/production_parts/assemblies/insert_assmeblies/y_cable_mount_inserts.fcstd
CAD files/Older 3D printed parts/production_parts/assemblies/insert_assmeblies/y_motor_mount_inserts.fcstd
CAD files/Older 3D printed parts/production_parts/assemblies/insert_assmeblies/z_upper_left_inserts.fcstd
CAD files/Older 3D printed parts/production_parts/assemblies/internal_corner_bracket.fcstd
CAD files/Older 3D printed parts/production_parts/assemblies/limit_switch.fcstd
CAD files/Older 3D printed parts/production_parts/assemblies/m3_nylock_nut.fcstd
CAD files/Older 3D printed parts/production_parts/assemblies/m5_nylock_nut.fcstd
CAD files/Older 3D printed parts/production_parts/assemblies/nema_17_motor.fcstd
CAD files/Older 3D printed parts/production_parts/assemblies/power_entry_module.fcstd
CAD files/Older 3D printed parts/production_parts/assemblies/power_switch.fcstd
CAD files/Older 3D printed parts/production_parts/assemblies/pully.fcstd
CAD files/Older 3D printed parts/production_parts/assemblies/schnoz_wad.fcstd
CAD files/Older 3D printed parts/production_parts/assemblies/sub_assemblies/aerostruder_v2_HS0.5.fcstd
CAD files/Older 3D printed parts/production_parts/assemblies/sub_assemblies/control_box.fcstd
CAD files/Older 3D printed parts/production_parts/assemblies/sub_assemblies/final_frame.fcstd
CAD files/Older 3D printed parts/production_parts/assemblies/sub_assemblies/x_axis.fcstd
CAD files/Older 3D printed parts/production_parts/assemblies/sub_assemblies/y_bed.fcstd
CAD files/Older 3D printed parts/production_parts/assemblies/t-slot_nut_position_back.fcstd
CAD files/Older 3D printed parts/production_parts/assemblies/t-slot_nut_position_front.fcstd
CAD files/Older 3D printed parts/production_parts/assemblies/t_slot_500mm.fcstd
CAD files/Older 3D printed parts/production_parts/assemblies/t_slot_530mm.fcstd
CAD files/Older 3D printed parts/production_parts/assemblies/x_belt.fcstd
CAD files/Older 3D printed parts/production_parts/assemblies/y_belt.fcstd
CAD files/Older 3D printed parts/production_parts/assemblies/z_belt.fcstd
CAD files/Older 3D printed parts/production_parts/assemblies/z_upper_left_switch.fcstd
CAD files/Older 3D printed parts/production_parts/assemblies/z_upper_right_switch.fcstd
CAD files/Older 3D printed parts/production_parts/hot_end/e3d_hot_tightened_assembly/hardened_steel_0.5_hotend.fcstd
CAD files/Older 3D printed parts/production_parts/hot_end/e3d_hot_tightened_assembly/step_files/Idler_tension_screw.step
CAD files/Older 3D printed parts/production_parts/hot_end/e3d_hot_tightened_assembly/step_files/Mirrored_aero_assem.fcstd
CAD files/Older 3D printed parts/production_parts/hot_end/e3d_hot_tightened_assembly/step_files/PTFE_HOLDER_300 (Edition 2.3)_MIRRORED.stp
CAD files/Older 3D printed parts/production_parts/hot_end/e3d_hot_tightened_assembly/step_files/TITAN-GUIDE-300-LH.stp
CAD files/Older 3D printed parts/production_parts/hot_end/e3d_hot_tightened_assembly/step_files/V6 3mm Break.stp
CAD files/Older 3D printed parts/production_parts/hot_end/e3d_hot_tightened_assembly/step_files/V6 Heater Block.stp
CAD files/Older 3D printed parts/production_parts/hot_end/e3d_hot_tightened_assembly/step_files/V6 Nozzle.stp
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
