joeyliu522/VVI-project/CAD files/Older 3D printed parts/production_docs/assembly_instructions/README.txt

For complete assembly instructions, visit https://ohai.lulzbot.com/
