joeyliu522/VVI-project/CAD files/Older 3D printed parts/production_parts/electronics/internal_harness/EL-FA0061_CB_Case_Fan_Assembly.pdf

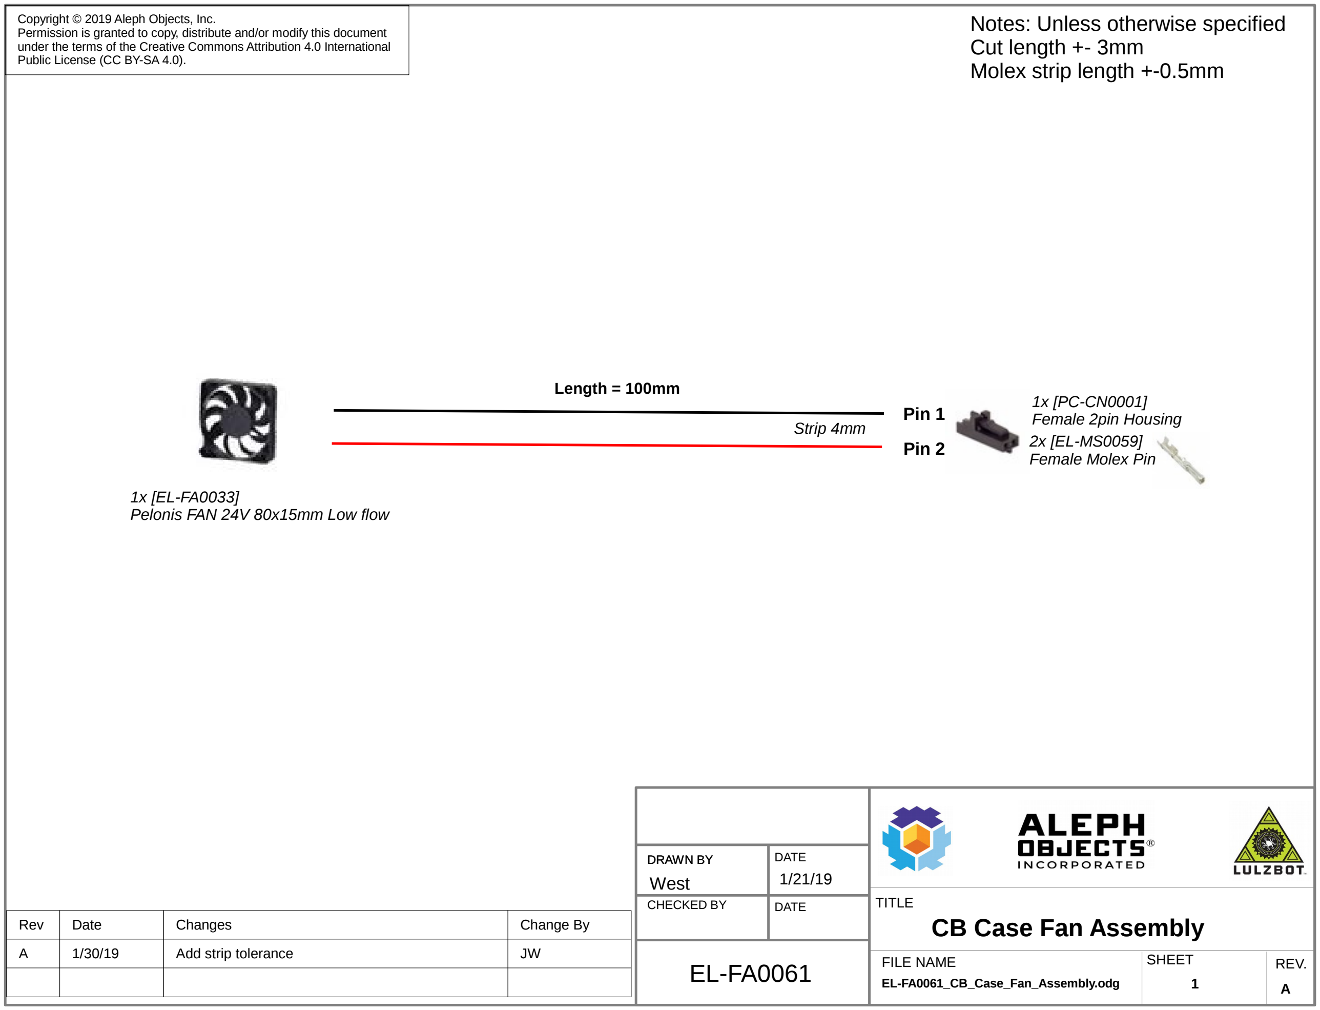
[picture p29: figure]
DRAWN BY DRAWN BY West; DATE 1/21/19; TITLE; FILE NAME; SHEET; REV.; CB Case Fan Assembly; Copyright © 2019 Aleph Objects, Inc.; Public License (CC BY-SA 4.0).; CHECKED BY; DATE; EL-FA0061_CB_Case_Fan_Assembly.odg; 1x [EL-FA0033] Pelonis FAN 24V 80x15mm Low flow; Pin 1; Length = 100mm; Strip 4mm; Pin 2; 1x [PC-CN0001] Female 2pin Housing 2x [EL-MS0059] Female Molex Pin; Rev; Date; Changes; Change By; Notes: Unless otherwise specified Cut length +- 3mm Molex strip length +-0.5mm

Permission is granted to copy, distribute and/or modify this document under the terms of the Creative Commons Attribution 4.0 International

A | 1/30/19 | Add strip tolerance | JW | EL-FA0061

AO P/n | qty | unit | Supplier | supplier P/n
EL-FA0033 | 1 | pce | Pelonis Technologies, Inc. | C8015L24BPLP1b-7
PC-CN0001 | 1 | pce | Sager Electronics | 050579402
EL-MS0059 | 2 | pce | TTI Global Distribution | 16-02-0086
