joeyliu522/VVI-project/CAD files/Older 3D printed parts/production_parts/electronics/toolhead/AS-HE0043_workhorse_0.5_aero_hotend_assembly_revA.pdf

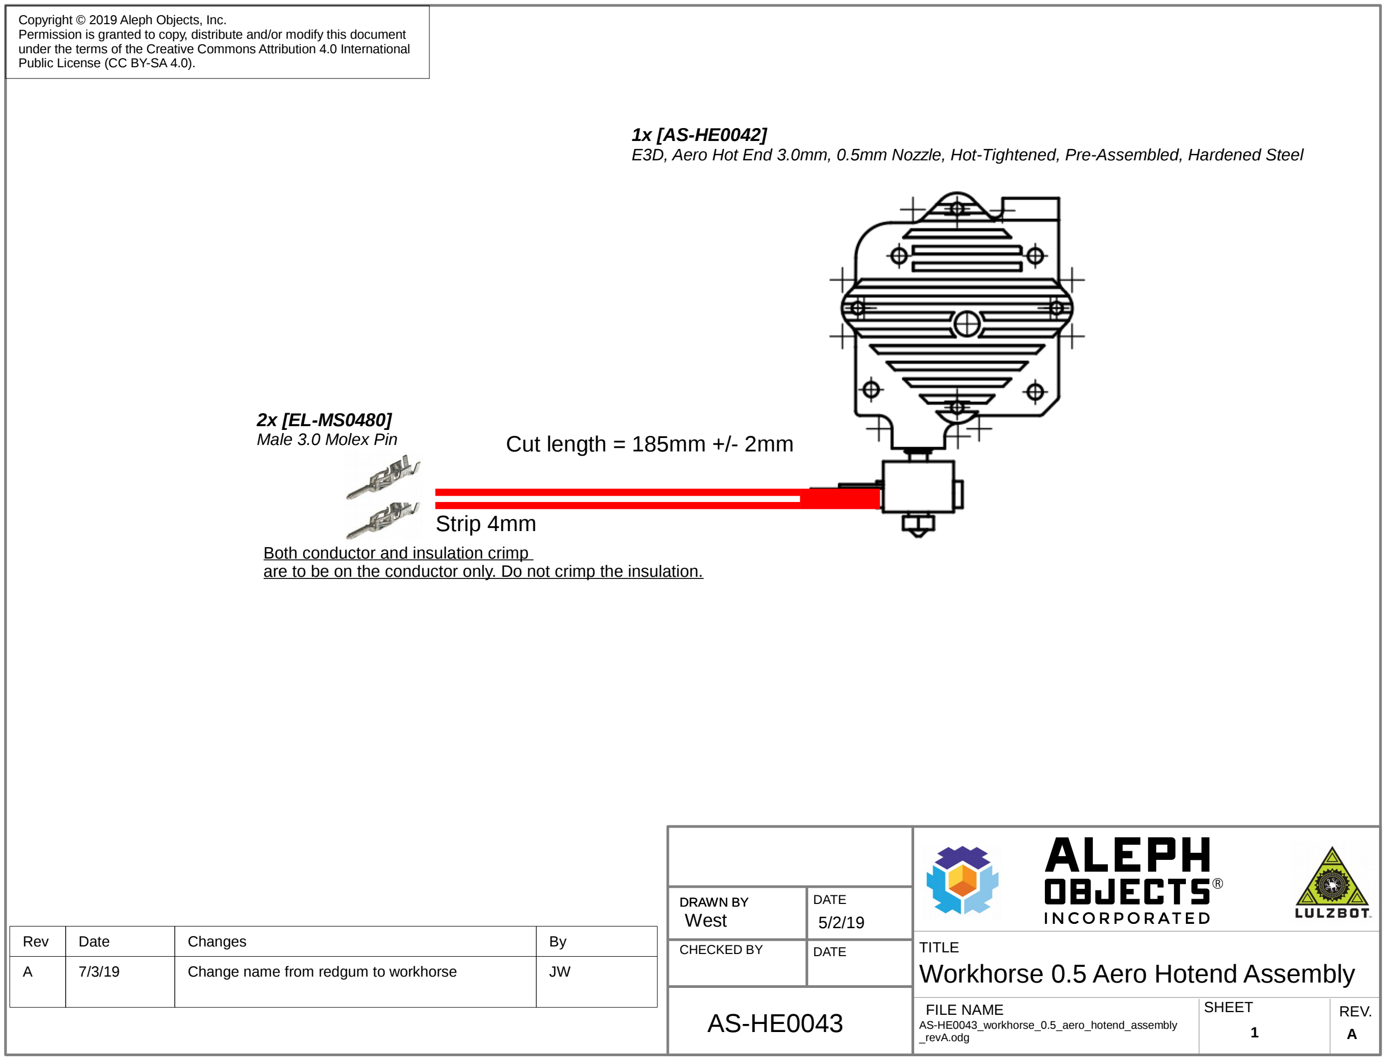
[picture p30: figure]
DRAWN BY DRAWN BY West; DATE 5/2/19; TITLE; FILE NAME; SHEET; REV.; Copyright © 2019 Aleph Objects, Inc.; Public License (CC BY-SA 4.0).; CHECKED BY; DATE; 2x [EL-MS0480] Male 3.0 Molex Pin; Workhorse 0.5 Aero Hotend Assembly; _revA.odg; Strip 4mm; Cut length = 185mm +/- 2mm; Both conductor and insulation crimp; Rev; Date; Changes

Permission is granted to copy, distribute and/or modify this document under the terms of the Creative Commons Attribution 4.0 International

AS-HE0043_workhorse_0.5_aero_hotend_assembly

### E3D, Aero Hot End 3.0mm, 0.5mm Nozzle, Hot-Tightened, Pre-Assembled, Hardened Steel

are to be on the conductor only. Do not crimp the insulation.

A | 7/3/19 | Change name from redgum to workhorse | JW
