joeyliu522/VVI-project/CAD files/Older 3D printed parts/production_docs/compliance/Aleph_Objects-TAZ_Workhorse-EMC_Emissions_and_Immunity_CE_and_AS_NZS_Test_Report_27-June-2019-Rev_1_0.pdf

EMI Test Lab LLC Electro Magnetic Interference Testing

EmiTestLab.com

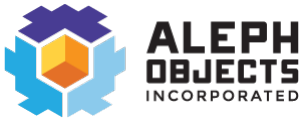
[picture p31: figure]

Test Specification: CISPR 24, 32 | Prepared by EMI Test Lab - EMITestLab.com
Model Name of EUT: TAZ Workhorse
Manufacturer: Aleph Objects Inc. | Revision 1.0
Page 1 of 80

# Electro Magnetic Compatibility Test Report Regarding the CE Mark and the Australia / New Zealand Compliance of the Aleph Objects TAZ Workhorse 3D Printer

## In Accordance with the Information Technology Standards

AS/NZS CISPR 24, AS/NZS CISPR 32 and EN 55024, EN 55032,

## EN 61000-3-2, EN 61000-3-3 for Emissions, Class B for home use

Report Revision History

Revision | Date | Reason
1.0 | 27 June 2019 | Initial Release

EMI Test Lab LLC Electro Magnetic Interference Testing

EmiTestLab.com

Test Specification: CISPR 24, 32 | Prepared by EMI Test Lab - EMITestLab.com
Model Name of EUT: TAZ Workhorse
Manufacturer: Aleph Objects Inc. | Revision 1.0
Page 2 of 80

Description of Equipment Under Test (EUT)
Test Item | : | TAZ Workhorse 3D Printer
Manufacturer | : | Aleph Objects, Inc.

Manufacturer’s information
Manufacturers
Representative | : | Mark Pelletier - Engineer
Company | : | Aleph Objects, Inc.
Address | : | 626 West 66th Street
| | Loveland, Colorado 80538
| | U.S.A.
Website | : | https://www.lulzbot.com/store/printers/lulzbot-taz-Workhorse

Tests Performed at
Address | : | EMI Test Lab LLC
| | 1822 Skyway Drive Unit J
| | Longmont, Colorado 80504
| | U.S.A
Website | : | http://www.emitestlab.com/
Test Specifications | : | EN 55024, EN 55032, CISPR 24,
| | CISPR 32, AS/NZS CISPR 24 and 32, All Class B emissions
Tests completed | : | 28 May 2019
Result of Testing | : | The EUT is in Compliance with EN 61000-3-2, EN 61000-3-3
| | EN 55024:2010+A1:2015, EN 55032:2015,
| | CISPR 24:2015, CISPR 32:2015, Class B
| | AS/NZS CISPR 24:2013, AS/NZS CISPR 32:2015
Senior EMC Engineer | : | Dennis King
Report written by | : | Dennis King – EMI Test Lab
Test Plan | : | Dennis King and Mark Pelletier for Aleph Objects
Report date | : | 27 June 2019

These test results relate only to the specific unit that was tested. A periodic production audit to verify continued compliance is recommended.

EMI Test Lab LLC Electro Magnetic Interference Testing

EmiTestLab.com

Test Specification: CISPR 24, 32 | Prepared by EMI Test Lab - EMITestLab.com
Model Name of EUT: TAZ Workhorse
Manufacturer: Aleph Objects Inc. | Revision 1.0
Page 3 of 80

Table of Contents
1. General Test Information | page 4
1.1. Applied Standards
1.2. Detailed description of test configuration, input and output ports 1.2.1.Description of test configuration
1.2.2.Description of input and output ports and power supply information 1.2.3.Operating modes
2. Emissions | page 9
2.1. AC Mains conducted emissions
2.2. Enclosure radiated emissions
2.2.1.30-1,000 MHz
2.2.2.1-6 GHz
2.3. Harmonic current emissions
2.4.Voltage fluctuations and flicker
3. Immunity | page 41
3.1. Performance criteria
3.2. Enclosure tests
3.2.1.Radio-frequency electromagnetic fields
3.2.2.Electrostatic discharge
3.2.3.RF common mode on signal and telecom ports 3.2.4.Fast transients on signal and telecom ports
3.3. AC power port tests
3.3.1.Radio-frequency immunity, common mode 3.3.2.Surges
3.3.3.Fast Transients, common mode
3.3.4.Voltage Dips and Interruptions
3.3.5.Power Frequency Magnetic Fields
4. Modifications | page 74
5. Test equipment. | page 75
6. Measurement Uncertainty | page 77
7. Test Plan | page 79
8. Conclusion | page 80

EMI Test Lab LLC Electro Magnetic Interference Testing

EmiTestLab.com

Test Specification: CISPR 24, 32 | Prepared by EMI Test Lab - EMITestLab.com
Model Name of EUT: TAZ Workhorse
Manufacturer: Aleph Objects Inc. | Revision 1.0
Page 4 of 80

### 1 General

### 1.1 Applied Standards

The Aleph TAZ Workhorse 3D Printer was evaluated for emissions using the international standards CISPR 32:2015, the EU European standards EN 55032:2015 and Australia’s standard AS/NZS CISPR 32:2015.

Immunity standards applied are the international standards CISPR 24:2015, the EU European standard EN 55024:2010+A1:2015 and Australia’s standard AS/NZS CISPR 24:2013.

CISPR are the international standards, countries across the world adopt the CISPR standards with sometimes minor changes and sometimes with no changes at all. The EU adopts the CISPR standards and adds the prefix “EN”. Australia and New Zealand adopt the CISPR standards and adopt the prefix AS/NZS, and so on around the world. North America has harmonized with the CISPR emissions standards but has no requirement for immunity.

### 1.2 Detailed description of the test configuration, input and output ports

The 3D Printer was tested while running test code that simulates a worst case for operation of the printer. The heater bed was on during all the testing.
Test code used is called TEST_2.gcode
For all test configurations the equipment under test (EUT) is powered by European AC power: 230VAC/50Hz. This voltage also covers Australia and New Zealand. All I/O cables are less than 3 meters.

LulzBot Software:

The default software for the TAZ WORKHORSE 3D printer is called Cura LulzBot Edition. Cura is a Free Software program that both prepares your files for printing (by converting your model into GCODE), and also allows you to control the operation of your LulzBot 3D printer.

EMI Test Lab LLC Electro Magnetic Interference Testing

EmiTestLab.com

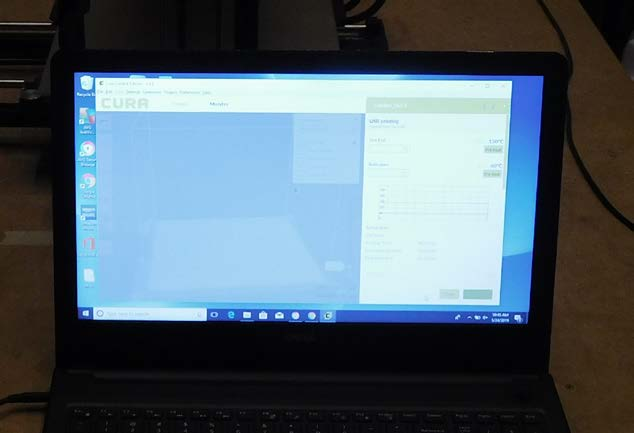
[picture p32: figure]
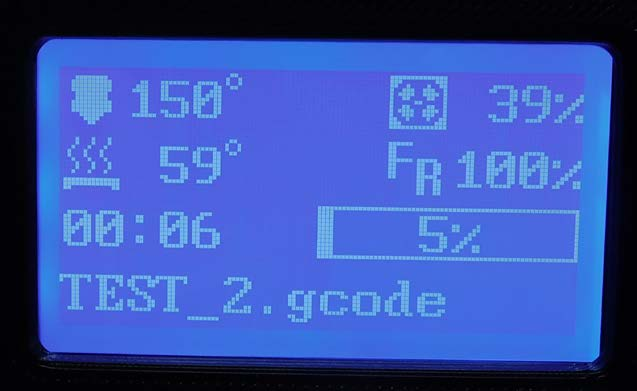
[picture p33: figure]

Test Specification: CISPR 24, 32 | Prepared by EMI Test Lab - EMITestLab.com
Model Name of EUT: TAZ Workhorse
Manufacturer: Aleph Objects Inc. | Revision 1.0
Page 5 of 80

Typical screen shot of software used during emissions and immunity testing.

EMI Test Lab LLC Electro Magnetic Interference Testing

EmiTestLab.com

Test Specification: CISPR 24, 32 | Prepared by EMI Test Lab - EMITestLab.com
Model Name of EUT: TAZ Workhorse
Manufacturer: Aleph Objects Inc. | Revision 1.0
Page 6 of 80

### 1.2.1 Description of test configuration

EUT | : | TAZ Workhorse 3D Printer
Manufacturer | : | Aleph Objects, Inc.
System model name | : | TAZ Workhorse
Serial Number | : | WH001
Test Voltage | : | 230 VAC 50 Hz

### 1.2.2. Description of tested input and output ports and power supply information

Number of cable type | Type of Cable | From | To | Shielded? | Remarks - length
1 | USB | unterminated | TAZ Workhorse | Yes | 6 ft. Tripp Lite model: U023-006 – ferrites on both ends
Power supply location | Manufacturer | Model | Serial number | Shielded | Remarks
Internal AC supply | Meanwell | RSP-500-24 | Not available | Shielded enclosure | UL and TUV Rheinland Certified – Output; 24V 21A

EMI Test Lab LLC Electro Magnetic Interference Testing

EmiTestLab.com

Test Specification: CISPR 24, 32 | Prepared by EMI Test Lab - EMITestLab.com
Model Name of EUT: TAZ Workhorse
Manufacturer: Aleph Objects Inc. | Revision 1.0
Page 7 of 80

### 1.2.3 Operation modes

During preliminary testing for emissions it was determined that the following configurations are worst case for emissions and immunity. All further testing was done in these modes.

The 3D Printer was tested while running test code that continuously moves the print heads and heats the heater bed.
The 3D Printer was checked while printing from the SD Card and also while operated from a laptop connecting to the printer through a USB cable that is supplied with the unit.

EMI Test Lab LLC Electro Magnetic Interference Testing

EmiTestLab.com

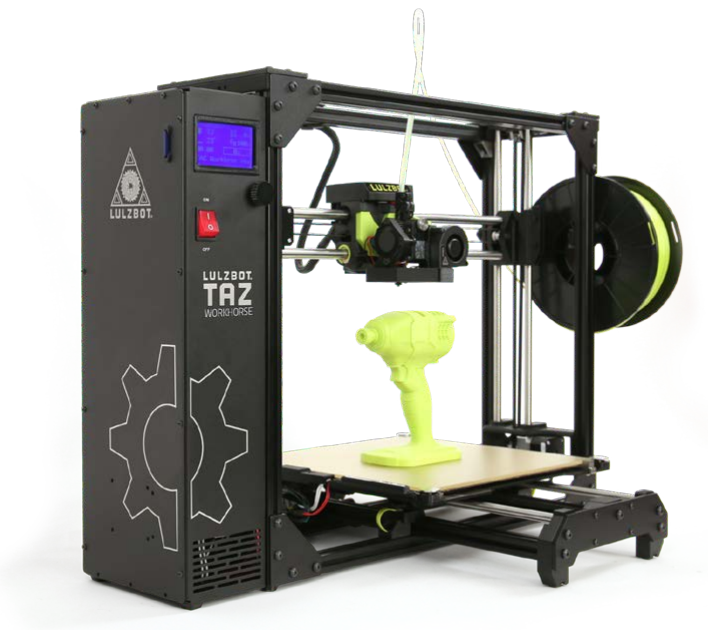
[picture p34: figure]

Test Specification: CISPR 24, 32 | Prepared by EMI Test Lab - EMITestLab.com
Model Name of EUT: TAZ Workhorse
Manufacturer: Aleph Objects Inc. | Revision 1.0
Page 8 of 80

## The TAZ Workhorse – 3D Printer

https://www.lulzbot.com/store/printers/lulzbot-taz-workhorse

EMI Test Lab LLC Electro Magnetic Interference Testing

EmiTestLab.com

Test Specification: CISPR 24, 32 | Prepared by EMI Test Lab - EMITestLab.com
Model Name of EUT: TAZ Workhorse
Manufacturer: Aleph Objects Inc. | Revision 1.0
Page 9 of 80

### 2 Emissions

The EUT (equipment under test) has been tested to determine conformity with the relevant emissions parts of EN 55032:2015, CISPR 32, and AS/NZS 32:2015.
AC Power line conducted and radiated field strength measurements concerning the emission of radiated and conducted electromagnetic disturbances were made. Harmonic currents at the AC mains connection terminals of the EUT were measured in conformance with and according to EN 61000-3-2:2014.

Voltage fluctuations and flicker at the AC mains connection terminals of the EUT were measured in conformance with and according to EN 61000-3-3:2013.

EMI Test Lab LLC Electro Magnetic Interference Testing

EmiTestLab.com

Test Specification: CISPR 24, 32 | Prepared by EMI Test Lab - EMITestLab.com
Model Name of EUT: TAZ Workhorse
Manufacturer: Aleph Objects Inc. | Revision 1.0
Page 10 of 80

### 2.1 AC Mains Power Input Ports

The disturbance voltage emissions levels at the AC mains power port of the EUT were measured in conformity with and according to the criteria as stated below.
Basic standard | : | CISPR 32:2015
Test setup | : | EN 55032, AS/NZS CISOR 32
Frequency range 1 | : | 0.15 – 0.5 MHz
Limit | : | 66 dBuV quasi peak, 56 dBuV average
| | Decreasing with the log of frequency to range 2
Frequency range 2 | : | 0.5 – 5 MHz
Limit | : | 56 dBuV quasi peak, 46 dBuV average
Frequency range 3 | : | 5 – 30 MHz
Limit | : | 60 dBuV quasi peak, 50 dBuV average
Results of the measurements concerning the emissions of voltage levels at the AC mains input port of the EUT. | PASS Class B
Name of Test Engineer: Signature: Date: | Dennis King 27 May 2019

Remarks: The configuration was tested at 230 VAC 50Hz. Conducted Emission Summary:
Passing.

EMI Test Lab LLC Electro Magnetic Interference Testing

EmiTestLab.com

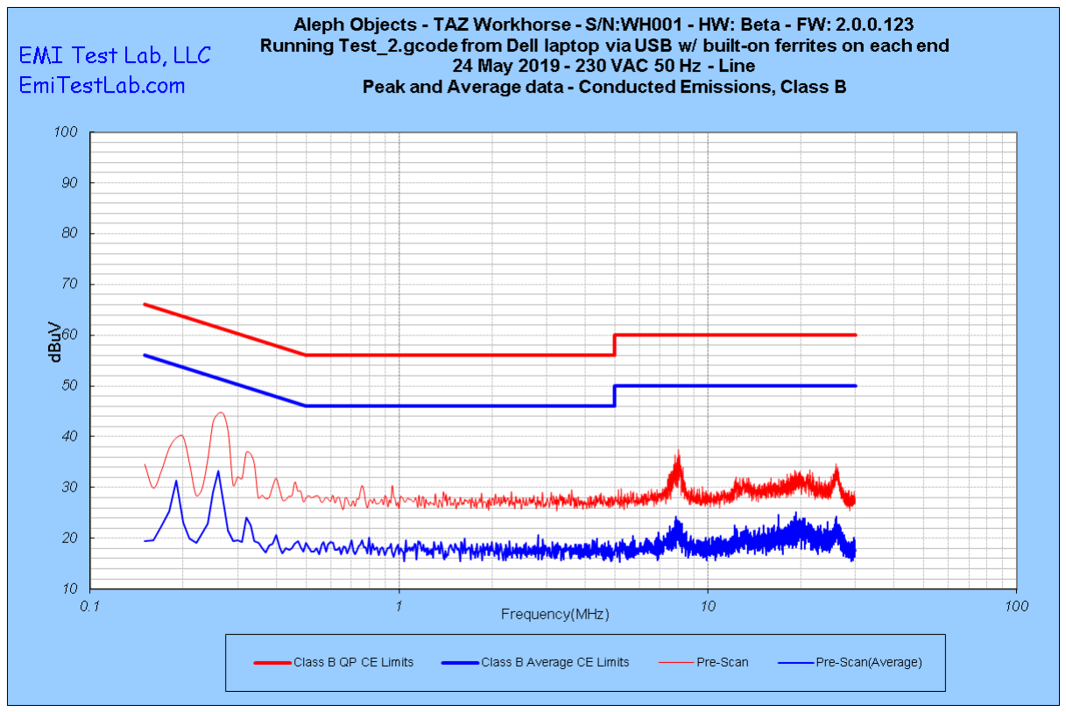
[picture p35: figure]

Test Specification: CISPR 24, 32 | Prepared by EMI Test Lab - EMITestLab.com
Model Name of EUT: TAZ Workhorse
Manufacturer: Aleph Objects Inc. | Revision 1.0
Page 11 of 80

230 VAC 50 Hz – Line – Peak passing Quasi peak limit – Average data passing the average limit
Running from a laptop through usb

EMI Test Lab LLC Electro Magnetic Interference Testing

EmiTestLab.com

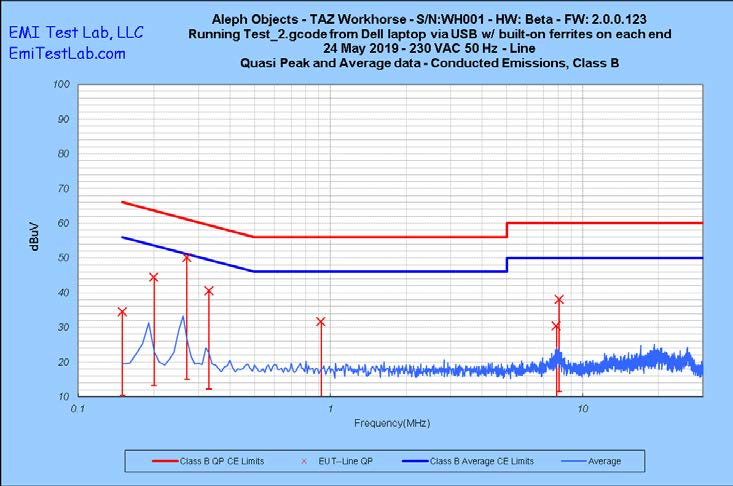
[picture p36: figure]

Test Specification: CISPR 24, 32 | Prepared by EMI Test Lab - EMITestLab.com
Model Name of EUT: TAZ Workhorse
Manufacturer: Aleph Objects Inc. | Revision 1.0
Page 12 of 80

230 VAC 50 Hz – Line – Peak passing Quasi peak limit – Average data passing the average limit
Running from a laptop through usb
Frequency (MHz) | QP Disturbance (dBuV) | QP Limit | EUT--Line QP | Tranducer Connection | Correction Factor (dB)
0.150 | 36.00 | 66.00 | 30.00 | AMN | 0.20
7.880 | 30.43 | 60.00 | 29.57 | AMN | 1.13
0.200 | 44.31 | 64.57 | 20.26 | AMN | 0.21
0.338 | 40.55 | 60.63 | 20.08 | AMN | 0.25
0.270 | 50.03 | 62.56 | 12.53 | AMN | 0.23
0.920 | 31.60 | 56.00 | 24.40 | AMN | 0.80
8.100 | 38.08 | 60.00 | 21.92 | AMN | 1.14

EMI Test Lab LLC Electro Magnetic Interference Testing

EmiTestLab.com

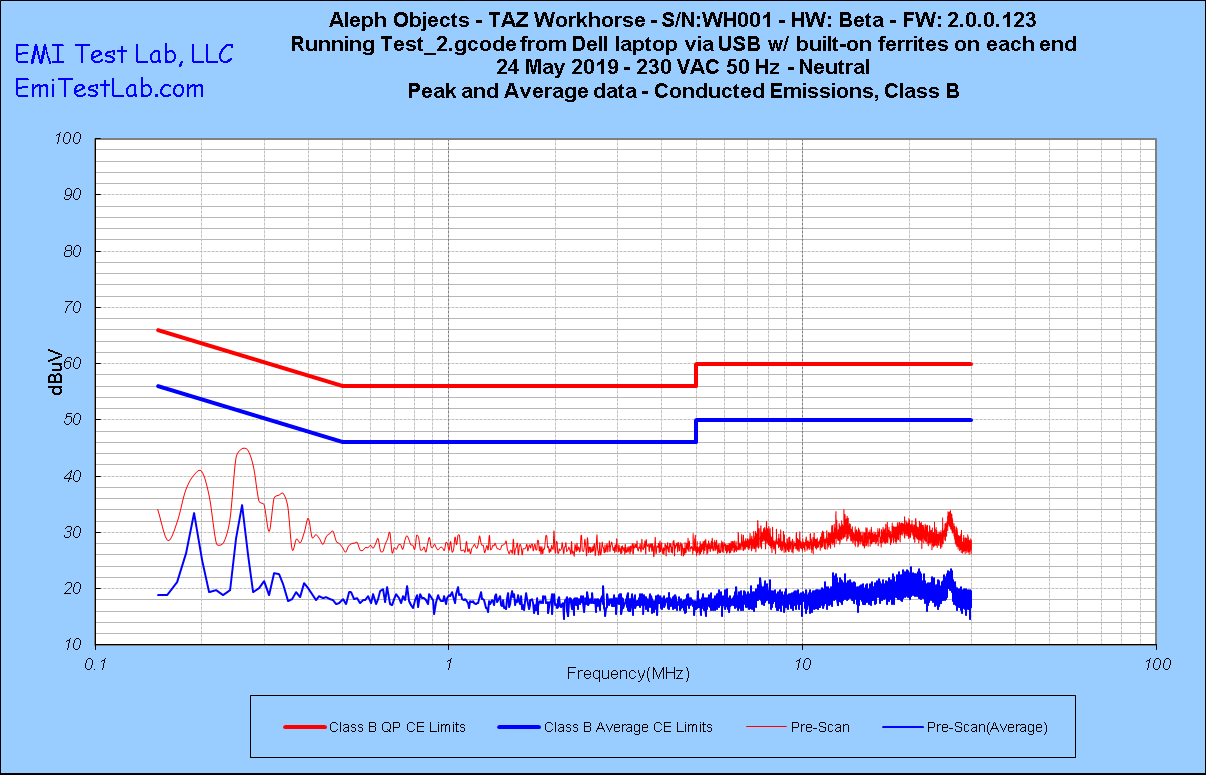
[picture p37: figure]

Test Specification: CISPR 24, 32 | Prepared by EMI Test Lab - EMITestLab.com
Model Name of EUT: TAZ Workhorse
Manufacturer: Aleph Objects Inc. | Revision 1.0
Page 13 of 80

230 VAC 50 Hz – Neutral – Peak passing Quasi peak limit – Average data passing the average limit
Running from a laptop through usb

EMI Test Lab LLC Electro Magnetic Interference Testing

EmiTestLab.com

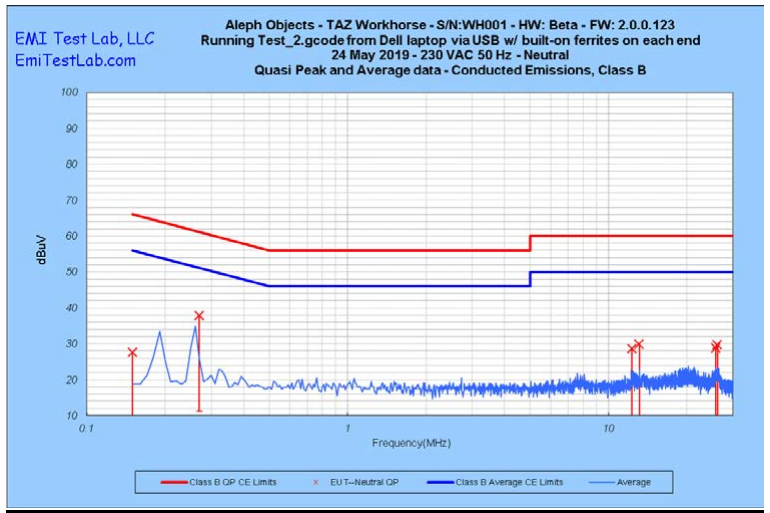
[picture p38: figure]

Test Specification: CISPR 24, 32 | Prepared by EMI Test Lab - EMITestLab.com
Model Name of EUT: TAZ Workhorse
Manufacturer: Aleph Objects Inc. | Revision 1.0
Page 14 of 80

230 VAC 50 Hz – Neutral – Peak passing Quasi peak limit – Average data passing the average limit
Running from a laptop through usb
Frequency (MHz) | QP Disturbance (dBuV) | QP Limit | EUT--Line QP | Tranducer Connection | Correction Factor (dB)
0.150 | 36.40 | 66.00 | 29.60 | AMN | 0.20
0.270 | 43.34 | 62.57 | 19.23 | AMN | 0.23
12.320 | 28.53 | 60.00 | 31.47 | AMN | 1.23
13.130 | 29.92 | 60.00 | 30.08 | AMN | 1.25
25.770 | 28.74 | 60.00 | 31.26 | AMN | 1.44
26.150 | 29.71 | 60.00 | 30.29 | AMN | 1.44

EMI Test Lab LLC Electro Magnetic Interference Testing

EmiTestLab.com

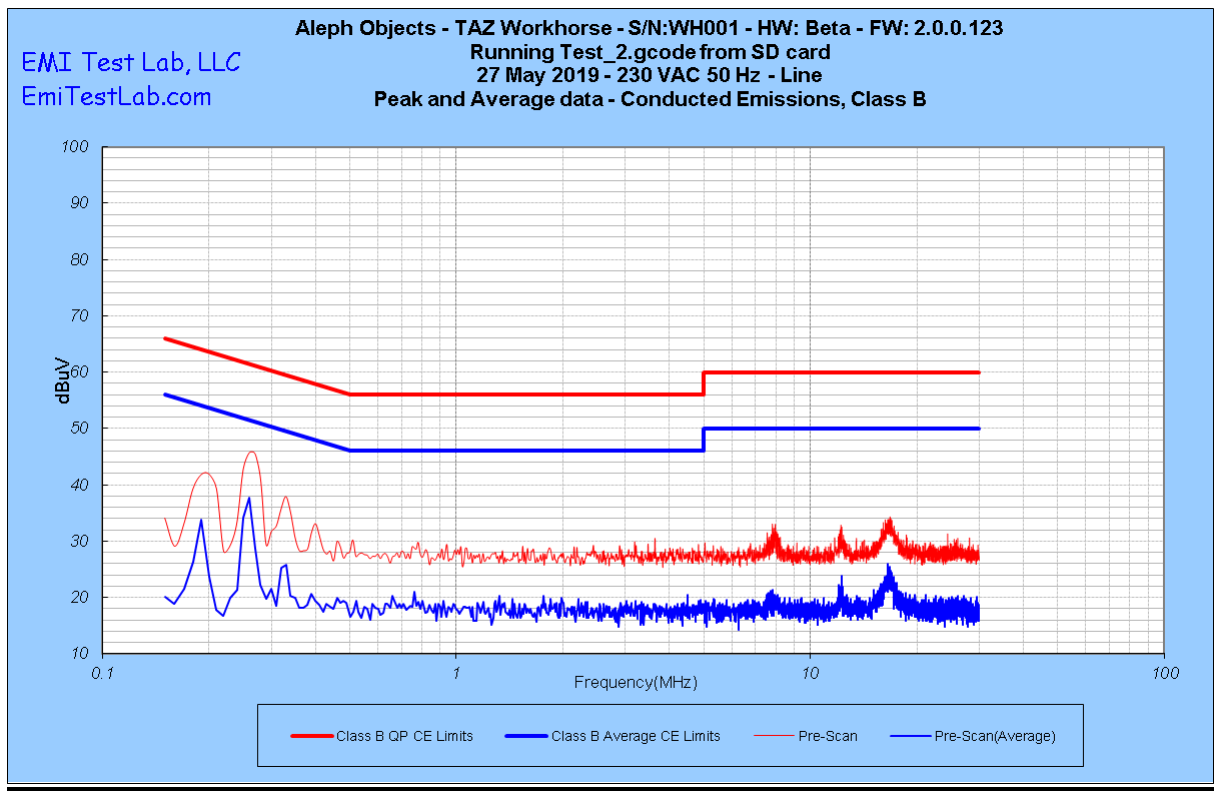
[picture p39: figure]

Test Specification: CISPR 24, 32 | Prepared by EMI Test Lab - EMITestLab.com
Model Name of EUT: TAZ Workhorse
Manufacturer: Aleph Objects Inc. | Revision 1.0
Page 15 of 80

230 VAC 50 Hz – Line – Peak passing Quasi peak limit – Average data passing the average limit
Running from the SD card

EMI Test Lab LLC Electro Magnetic Interference Testing

EmiTestLab.com

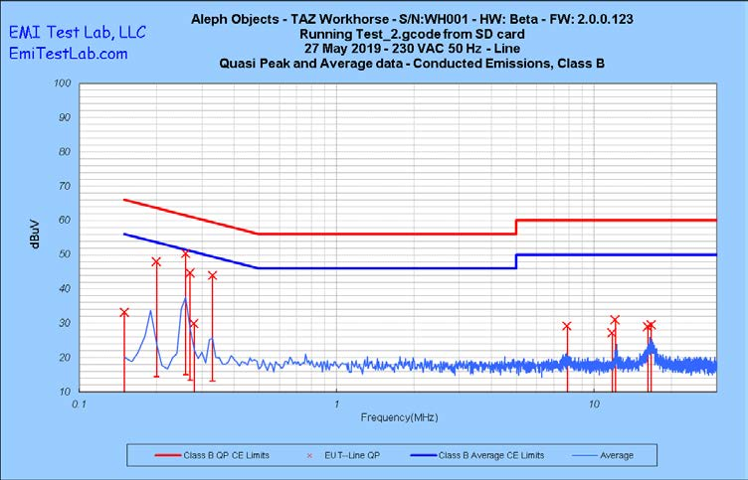
[picture p40: figure]

Test Specification: CISPR 24, 32 | Prepared by EMI Test Lab - EMITestLab.com
Model Name of EUT: TAZ Workhorse
Manufacturer: Aleph Objects Inc. | Revision 1.0
Page 16 of 80

230 VAC 50 Hz – Line – Peak passing Quasi peak limit – Average data passing the average limit
Running from the SD card
Frequency (MHz) | QP Disturbance (dBuV) | QP Limit | EUT--Line QP | Tranducer Connection | Correction Factor (dB)
0.150 | 36.00 | 66.00 | 30.00 | AMN | 0.20
0.270 | 44.56 | 62.57 | 18.01 | AMN | 0.23
0.280 | 29.84 | 62.28 | 32.45 | AMN | 0.24
7.880 | 29.22 | 60.00 | 30.78 | AMN | 1.13
11.780 | 27.15 | 60.00 | 32.85 | AMN | 1.23
12.120 | 30.94 | 60.00 | 29.06 | AMN | 1.23
16.190 | 28.95 | 60.00 | 31.05 | AMN | 1.29
16.710 | 29.60 | 60.00 | 30.40 | AMN | 1.30
0.203 | 48.02 | 64.49 | 16.48 | AMN | 0.22
0.269 | 50.23 | 62.61 | 12.38 | AMN | 0.23
0.339 | 43.95 | 60.61 | 16.66 | AMN | 0.25

EMI Test Lab LLC Electro Magnetic Interference Testing

EmiTestLab.com

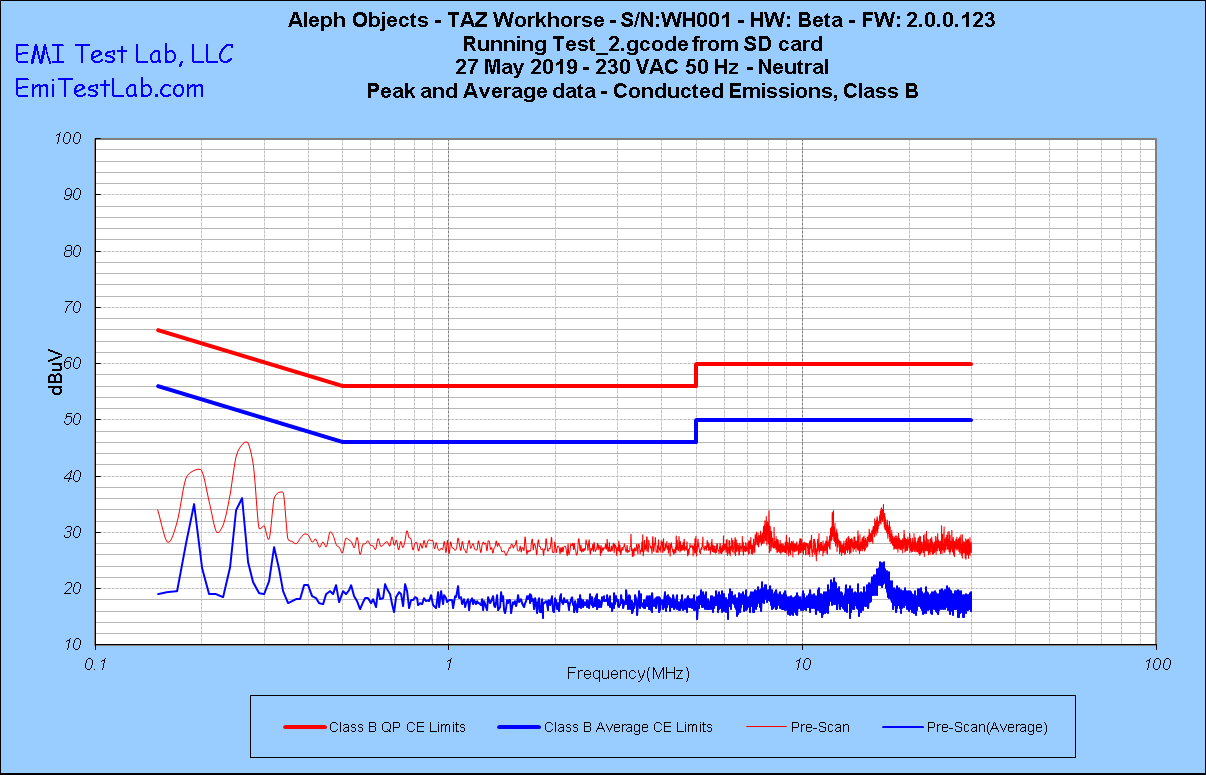
[picture p41: figure]

Test Specification: CISPR 24, 32 | Prepared by EMI Test Lab - EMITestLab.com
Model Name of EUT: TAZ Workhorse
Manufacturer: Aleph Objects Inc. | Revision 1.0
Page 17 of 80

230 VAC 50 Hz – Neutral – Peak passing Quasi peak limit – Average data passing the average limit
Running from the SD card

EMI Test Lab LLC Electro Magnetic Interference Testing

EmiTestLab.com

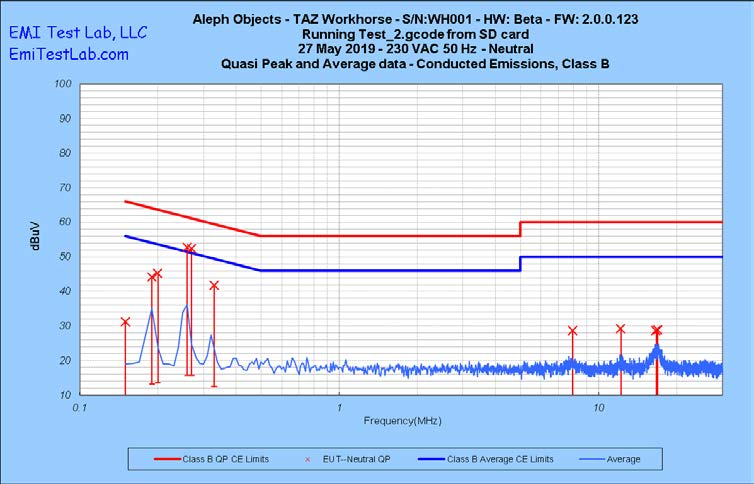
[picture p42: figure]

Test Specification: CISPR 24, 32 | Prepared by EMI Test Lab - EMITestLab.com
Model Name of EUT: TAZ Workhorse
Manufacturer: Aleph Objects Inc. | Revision 1.0
Page 18 of 80

230 VAC 50 Hz – Neutral – Peak passing Quasi peak limit – Average data passing the average limit
Running from the SD card
Frequency (MHz) | QP Disturbance (dBuV) | QP Limit | EUT--Line QP | Tranducer Connection | Correction Factor (dB)
0.150 | 34.70 | 66.00 | 31.30 | AMN | 0.20
7.950 | 28.61 | 60.00 | 31.39 | AMN | 1.13
0.150 | 31.10 | 66.00 | 34.90 | AMN | 0.20
12.180 | 29.16 | 60.00 | 30.84 | AMN | 1.23
16.680 | 28.60 | 60.00 | 31.40 | AMN | 1.30
16.880 | 28.71 | 60.00 | 31.29 | AMN | 1.30
0.204 | 45.22 | 64.45 | 19.23 | AMN | 0.22
0.200 | 44.01 | 64.57 | 20.56 | AMN | 0.21
0.270 | 52.73 | 62.58 | 9.85 | AMN | 0.23
0.337 | 41.65 | 60.64 | 18.99 | AMN | 0.25

EMI Test Lab LLC Electro Magnetic Interference Testing

EmiTestLab.com

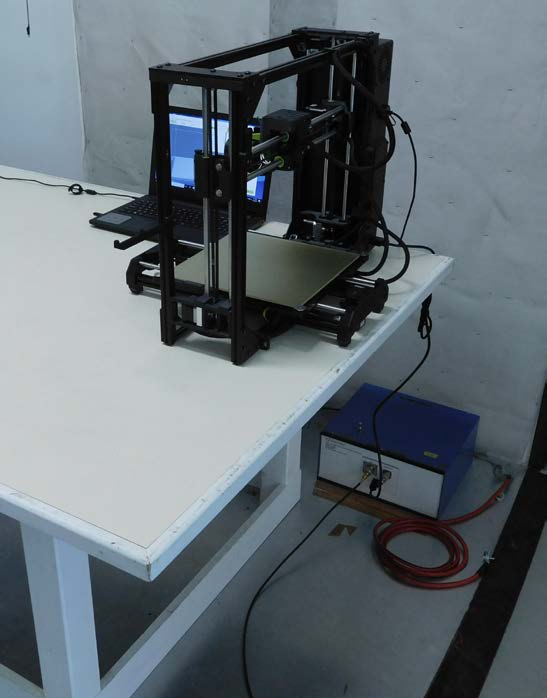
[picture p43: figure]

Test Specification: CISPR 24, 32 | Prepared by EMI Test Lab - EMITestLab.com
Model Name of EUT: TAZ Workhorse
Manufacturer: Aleph Objects Inc. | Revision 1.0
Page 19 of 80

Test setup for Conducted Emissions – with laptop

EMI Test Lab LLC Electro Magnetic Interference Testing

EmiTestLab.com

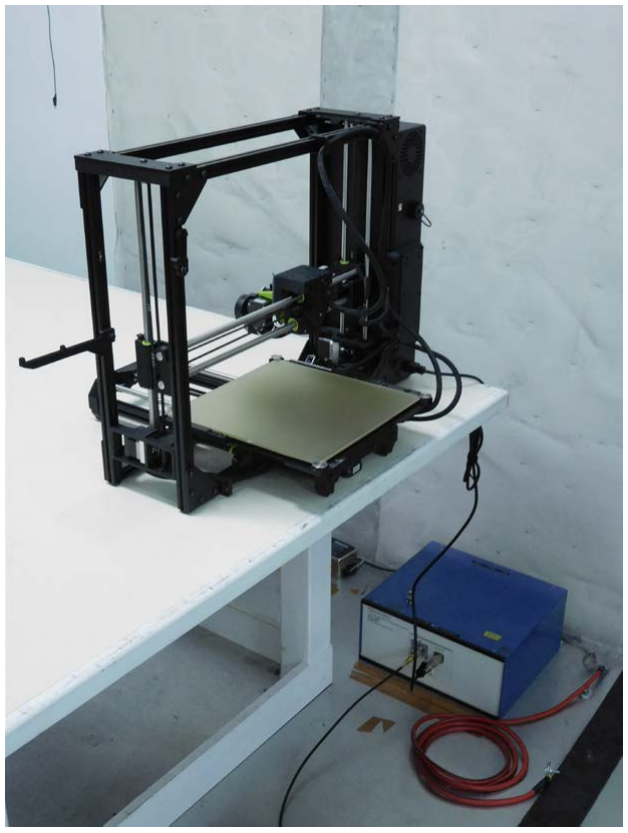
[picture p44: figure]

Test Specification: CISPR 24, 32 | Prepared by EMI Test Lab - EMITestLab.com
Model Name of EUT: TAZ Workhorse
Manufacturer: Aleph Objects Inc. | Revision 1.0
Page 20 of 80

Test setup for Conducted Emissions – with SD Card

EMI Test Lab LLC Electro Magnetic Interference Testing

EmiTestLab.com

Test Specification: CISPR 24, 32 | Prepared by EMI Test Lab - EMITestLab.com
Model Name of EUT: TAZ Workhorse
Manufacturer: Aleph Objects Inc. | Revision 1.0
Page 21 of 80

### 2.2 Enclosure

2.2.1 30-1,000 MHz
The radiated field strength levels (electric component) have been measured in conformity with and according to the criteria as stated below.
Basic standard | : | CISPR 32:2015
Test setup | : | EN 55032, AS/NZS CISPR 32
Limit distance | : | 3 meters
Frequency range 1 | : | 30 -230 MHz
Limits | : | 40 dBuV/m
Frequency range 2 | : | 230 – 1,000 MHz
Limits | : | 47 dBuV/m
Results of the measurements concerning radiated electromagnetic fields (electric component) emitted by the EUT, enclosure, as a tested system | PASS Class B
Name of Test Engineer: Signature: Date: | Dennis King 24 May 2019

Remarks:
Radiated Emissions Summary:
Passing Class B for Home and Commercial use.

EMI Test Lab LLC Electro Magnetic Interference Testing

EmiTestLab.com

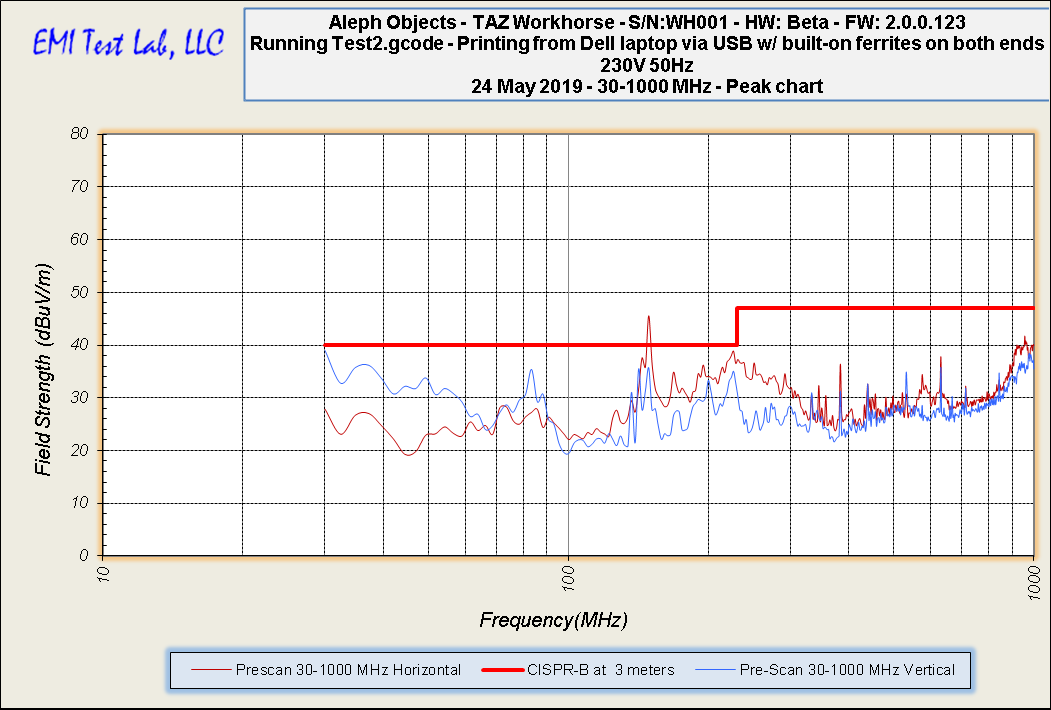
[picture p45: figure]

Test Specification: CISPR 24, 32 | Prepared by EMI Test Lab - EMITestLab.com
Model Name of EUT: TAZ Workhorse
Manufacturer: Aleph Objects Inc. | Revision 1.0
Page 22 of 80

Peak data compared to a quasi peak limit – see the next chart for the passing quasi peak data – with usb connection

EMI Test Lab LLC Electro Magnetic Interference Testing

EmiTestLab.com

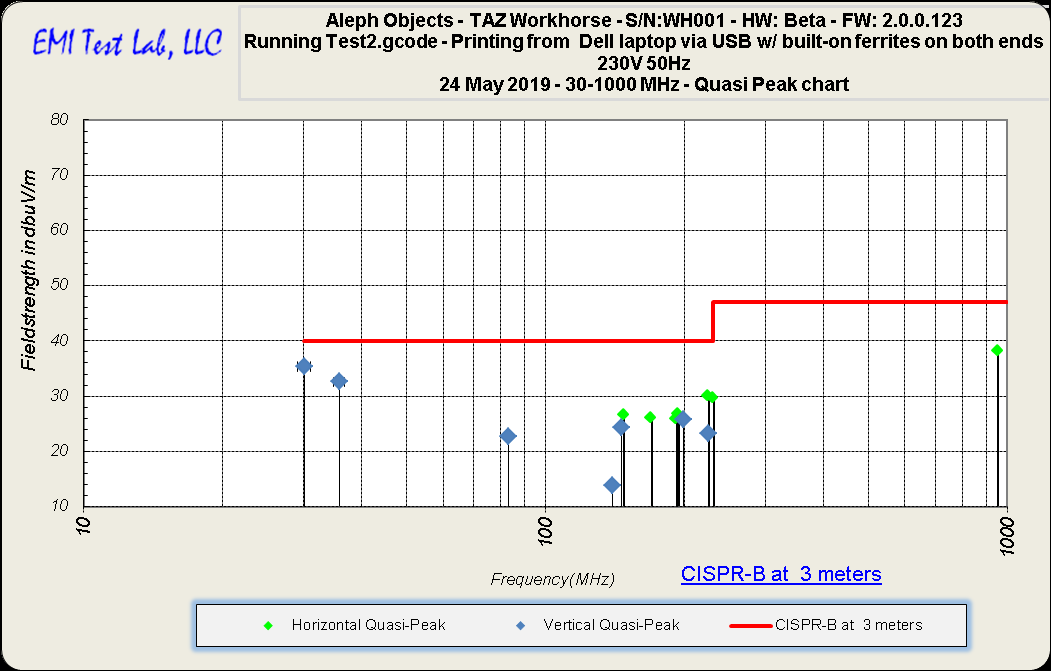
[picture p46: figure]

Test Specification: CISPR 24, 32 | Prepared by EMI Test Lab - EMITestLab.com
Model Name of EUT: TAZ Workhorse
Manufacturer: Aleph Objects Inc. | Revision 1.0
Page 23 of 80

Passing Quasi peak data compared to the quasi peak limit – with usb connection

EMI Test Lab LLC Electro Magnetic Interference Testing

EmiTestLab.com

Test Specification: CISPR 24, 32 | Prepared by EMI Test Lab - EMITestLab.com
Model Name of EUT: TAZ Workhorse
Manufacturer: Aleph Objects Inc. | Revision 1.0
Page 24 of 80

Quasi peak data – with usb connection

Sheet4

Frequency | Field Strength EUT | Limit | Azimuth | Height | Antenna Polarization | Delta from the Limit
(MHz) | (dBuV/m) | (dBuV/m) | Degrees | meters | H or V | dB micro volts
199.45 | 25.83 | 40 | 20.0 | 1.4 | V | -14.17
139.55 | 13.84 | 40 | 32.0 | 1.4 | V | -26.16
225.26 | 23.32 | 40 | 168.0 | 1.4 | V | -16.68
83.36 | 22.76 | 40 | 192.0 | 1.4 | V | -17.24
30.04 | 35.37 | 40 | 236.0 | 1.4 | V | -4.63
35.74 | 32.61 | 40 | 272.0 | 1.4 | V | -7.39
146.39 | 24.28 | 40 | 356.0 | 1.4 | V | -15.72
231.56 | 29.51 | 47 | 4.0 | 1.4 | H | -17.49
192.20 | 25.75 | 40 | 76.0 | 1.4 | H | -14.25
225.99 | 30.53 | 40 | 168.0 | 1.4 | H | -9.47
955.71 | 38.17 | 47 | 228.0 | 1.4 | H | -8.83
170.03 | 25.88 | 40 | 316.0 | 1.4 | H | -14.12
194.40 | 26.65 | 40 | 356.0 | 1.4 | H | -13.35
225.55 | 29.98 | 40 | 356.0 | 1.4 | H | -10.02
148.05 | 26.56 | 40 | 356.0 | 1 | H | -13.44

## EMI Test Lab

EMI Test Lab LLC Electro Magnetic Interference Testing

EmiTestLab.com

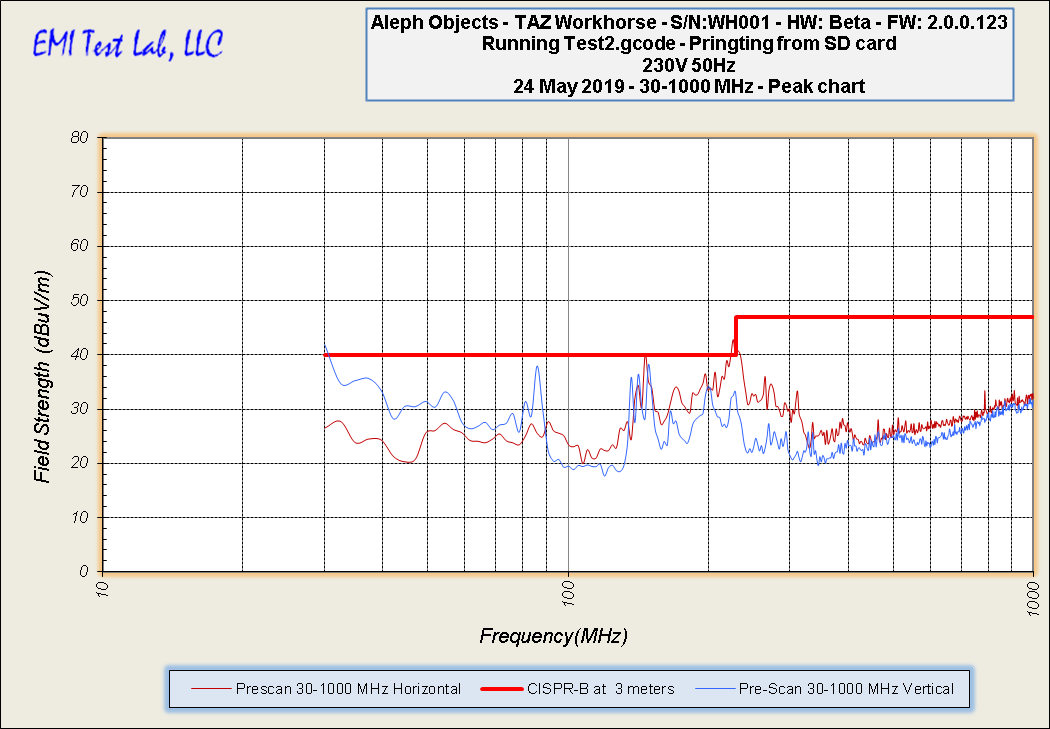
[picture p47: figure]

Test Specification: CISPR 24, 32 | Prepared by EMI Test Lab - EMITestLab.com
Model Name of EUT: TAZ Workhorse
Manufacturer: Aleph Objects Inc. | Revision 1.0
Page 25 of 80

Peak data compared to a quasi peak limit – see the next chart for the passing quasi peak data – with SD Card

EMI Test Lab LLC Electro Magnetic Interference Testing

EmiTestLab.com

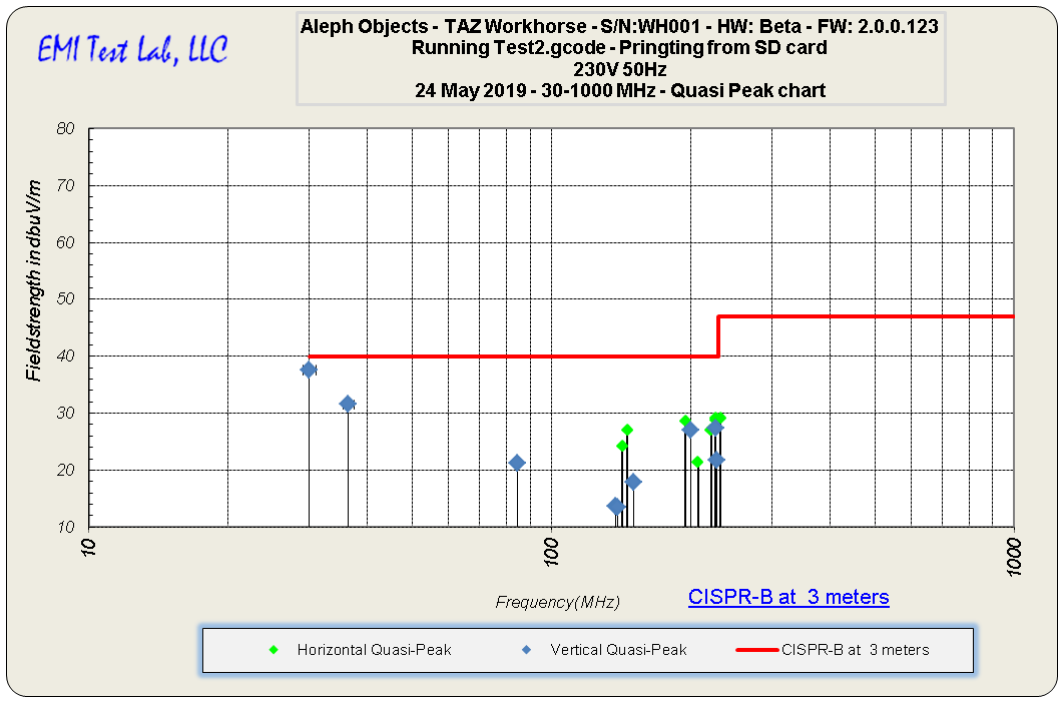
[picture p48: figure]

Test Specification: CISPR 24, 32 | Prepared by EMI Test Lab - EMITestLab.com
Model Name of EUT: TAZ Workhorse
Manufacturer: Aleph Objects Inc. | Revision 1.0
Page 26 of 80

Passing Quasi peak data compared to the quasi peak limit – with SD Card

EMI Test Lab LLC Electro Magnetic Interference Testing

EmiTestLab.com

Test Specification: CISPR 24, 32 | Prepared by EMI Test Lab - EMITestLab.com
Model Name of EUT: TAZ Workhorse
Manufacturer: Aleph Objects Inc. | Revision 1.0
Page 27 of 80

Quasi peak data – with SD Card

Sheet4

Frequency | Field Strength EUT | Limit | Azimuth | Height | Antenna Polarization | Delta from the Limit
(MHz) | (dBuV/m) | (dBuV/m) | Degrees | meters | H or V | dB micro volts
227.65 | 21.69 | 40 | 32.0 | 1.4 | V | -18.31
137.95 | 13.6 | 40 | 32.0 | 1.4 | V | -26.4
227.30 | 27.36 | 40 | 48.0 | 1.4 | V | -12.64
150.40 | 17.79 | 40 | 148.0 | 1.4 | V | -22.21
84.36 | 21.13 | 40 | 152.0 | 1.4 | V | -18.87
30.00 | 37.60 | 40 | 232.0 | 1.4 | V | -2.4
36.45 | 31.52 | 40 | 264.0 | 1.4 | V | -8.48
139.15 | 13.50 | 40 | 340.0 | 1.4 | V | -26.5
200.46 | 26.94 | 40 | 352.0 | 1.4 | V | -13.06
146.13 | 26.99 | 40 | 0.0 | 1.4 | H | -13.01
207.49 | 21.42 | 40 | 24.0 | 1.4 | H | -18.58
195.14 | 28.52 | 40 | 24.0 | 1.4 | H | -11.48
226.44 | 28.74 | 40 | 32.0 | 1.4 | H | -11.26
232.29 | 29.15 | 47 | 48.0 | 1.4 | H | -17.85
226.59 | 29.21 | 40 | 48.0 | 1 | H | -10.79
221.64 | 27.00 | 40 | 192.0 | 1 | H | -13
142.35 | 24.22 | 40 | 340.0 | 1 | H | -15.78

## EMI Test Lab

EMI Test Lab LLC Electro Magnetic Interference Testing

EmiTestLab.com

Test Specification: CISPR 24, 32 | Prepared by EMI Test Lab - EMITestLab.com
Model Name of EUT: TAZ Workhorse
Manufacturer: Aleph Objects Inc. | Revision 1.0
Page 28 of 80

2.2.2 1-6 GHz
The radiated field strength levels (electric component) have been measured in conformity with and according to the criteria as stated below.
Basic standard | : | CISPR 32:2015
Test setup | : | EN 55032, AS/NZS CISPR 32
Limit distance | : | 3 meters
Frequency range 1 | : | 1-3 GHz
Limits | : | Average 50 dBuV/m, Peak 70 dBuV/m
Frequency range 2 | : | 3-6 GHz
Limits | : | Average 54 dBuV/m, Peak 74 dBuV/m
Results of the measurements concerning radiated electromagnetic fields (electric component) emitted by the EUT, enclosure, as a tested system | Pass
Name of Test Engineer: Signature: Date: | Dennis King 24 May 2019

Remarks:

Passing from 1-6 GHz

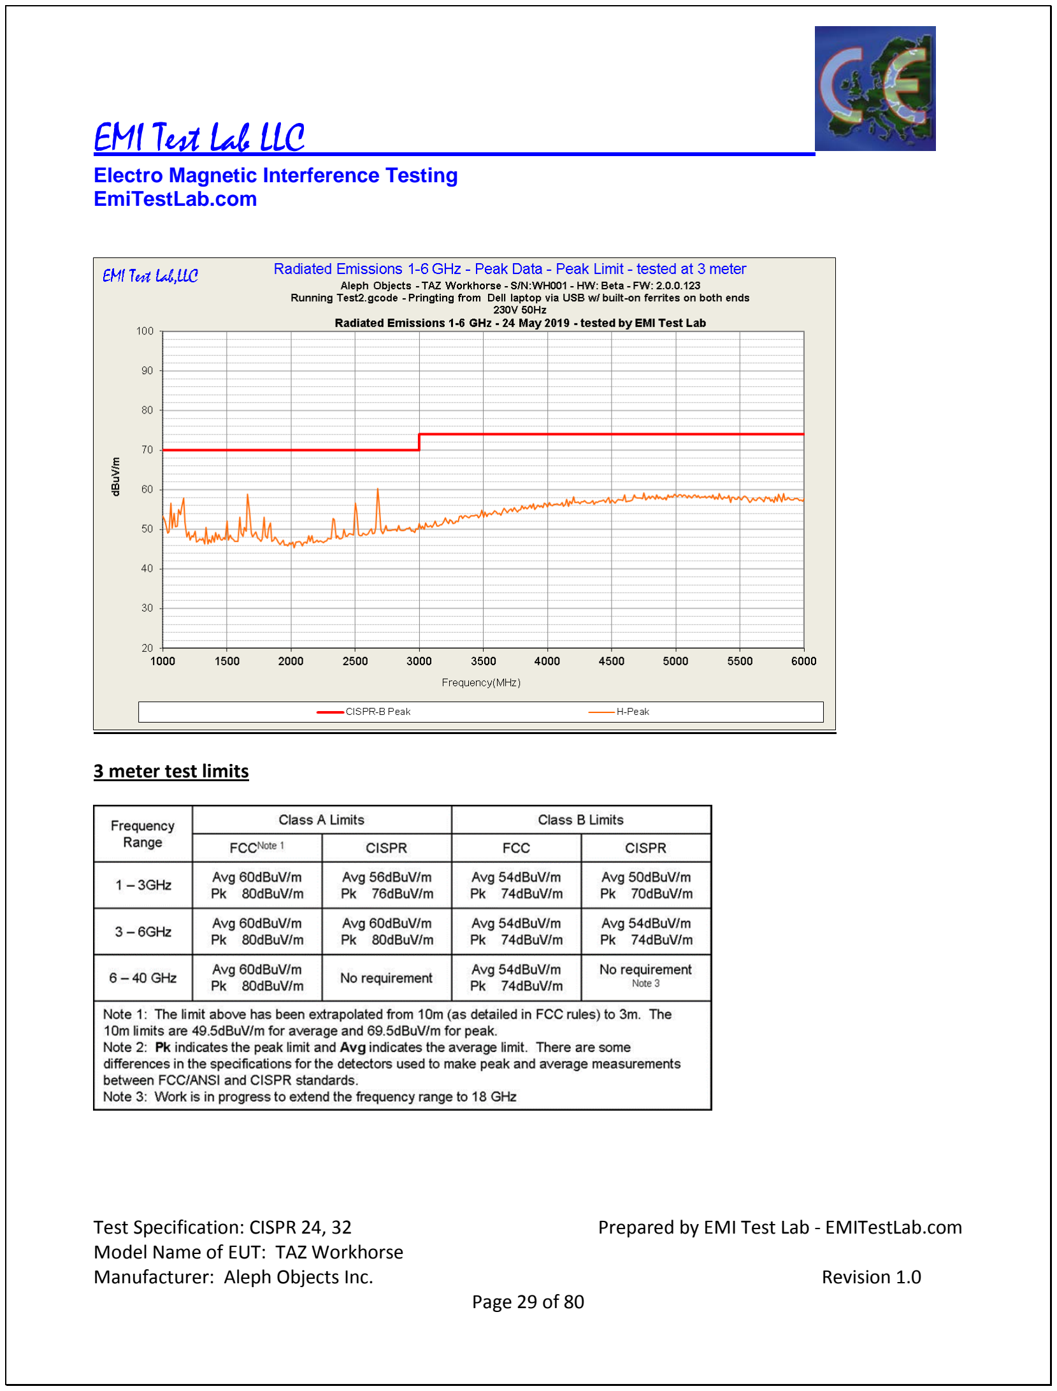
[picture p49: page 29]

EMI Test Lab LLC Electro Magnetic Interference Testing

EmiTestLab.com

Test Specification: CISPR 24, 32 | Prepared by EMI Test Lab - EMITestLab.com
Model Name of EUT: TAZ Workhorse
Manufacturer: Aleph Objects Inc. | Revision 1.0
Page 29 of 80

### 3 meter test limits

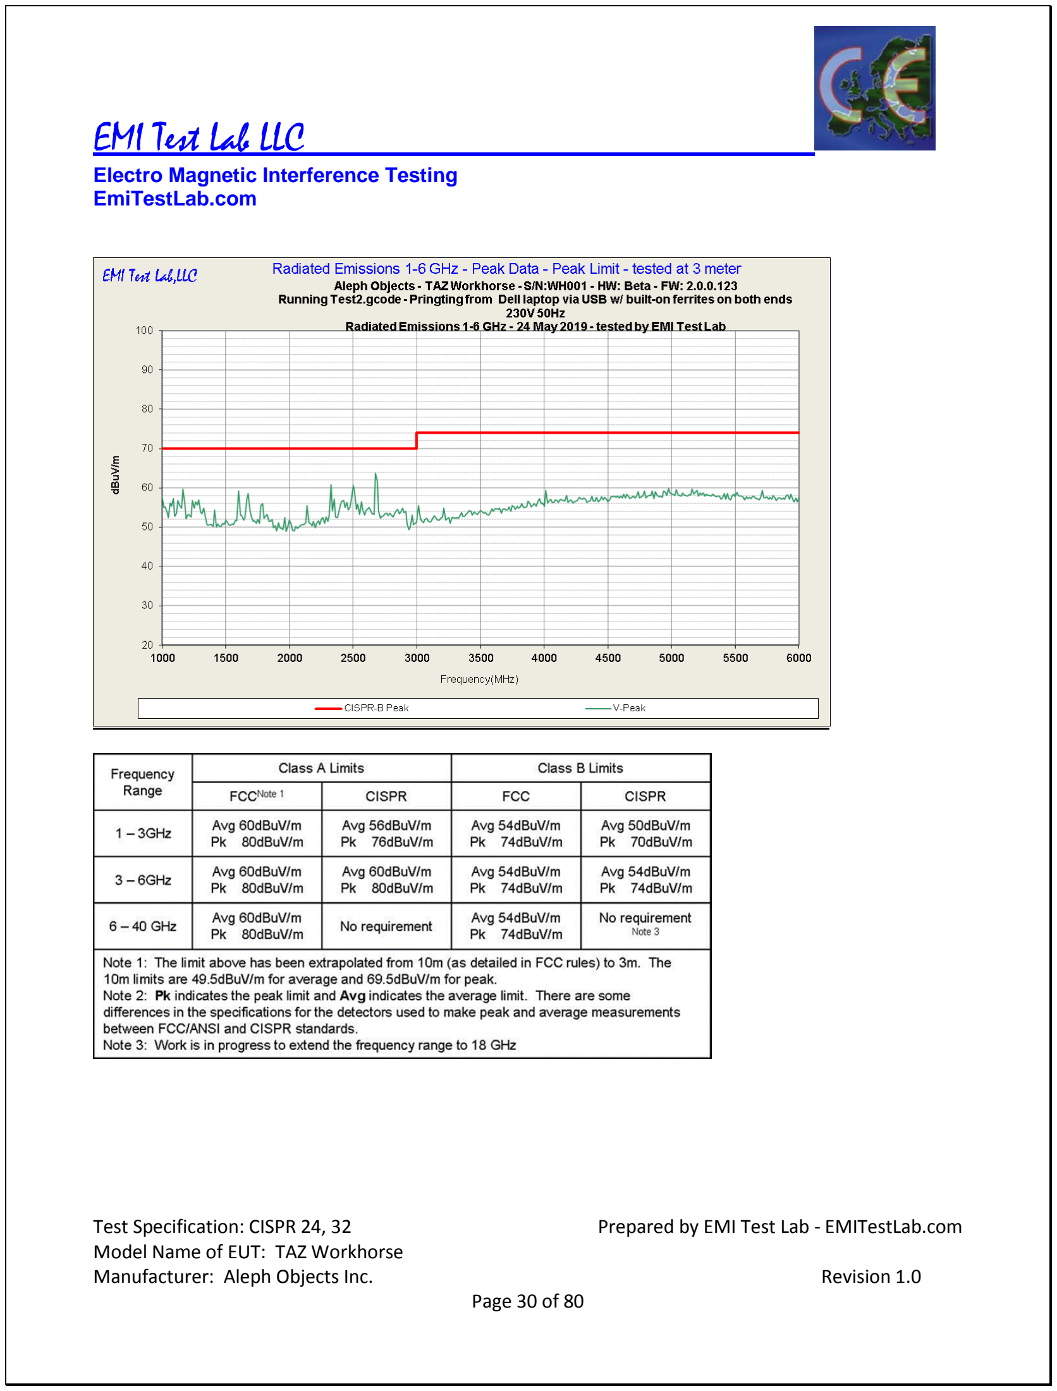
[picture p50: page 30]

EMI Test Lab LLC Electro Magnetic Interference Testing

EmiTestLab.com

Test Specification: CISPR 24, 32 | Prepared by EMI Test Lab - EMITestLab.com
Model Name of EUT: TAZ Workhorse
Manufacturer: Aleph Objects Inc. | Revision 1.0
Page 30 of 80

EMI Test Lab LLC Electro Magnetic Interference Testing

EmiTestLab.com

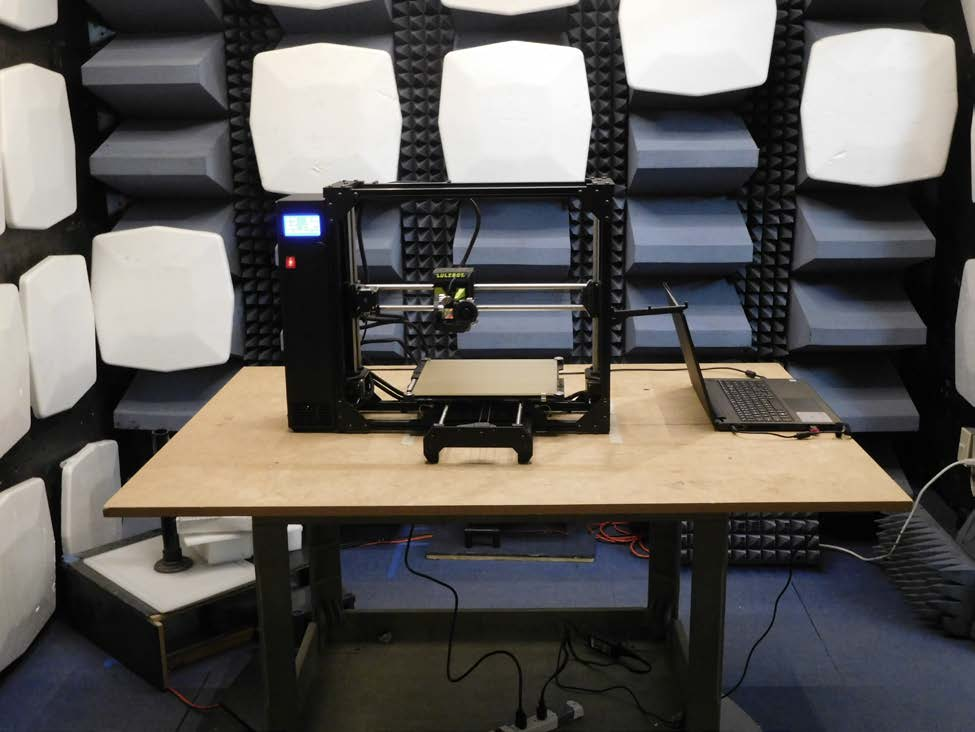
[picture p51: figure]

Test Specification: CISPR 24, 32 | Prepared by EMI Test Lab - EMITestLab.com
Model Name of EUT: TAZ Workhorse
Manufacturer: Aleph Objects Inc. | Revision 1.0
Page 31 of 80

Test setup for Radiated Emissions - usb

EMI Test Lab LLC Electro Magnetic Interference Testing

EmiTestLab.com

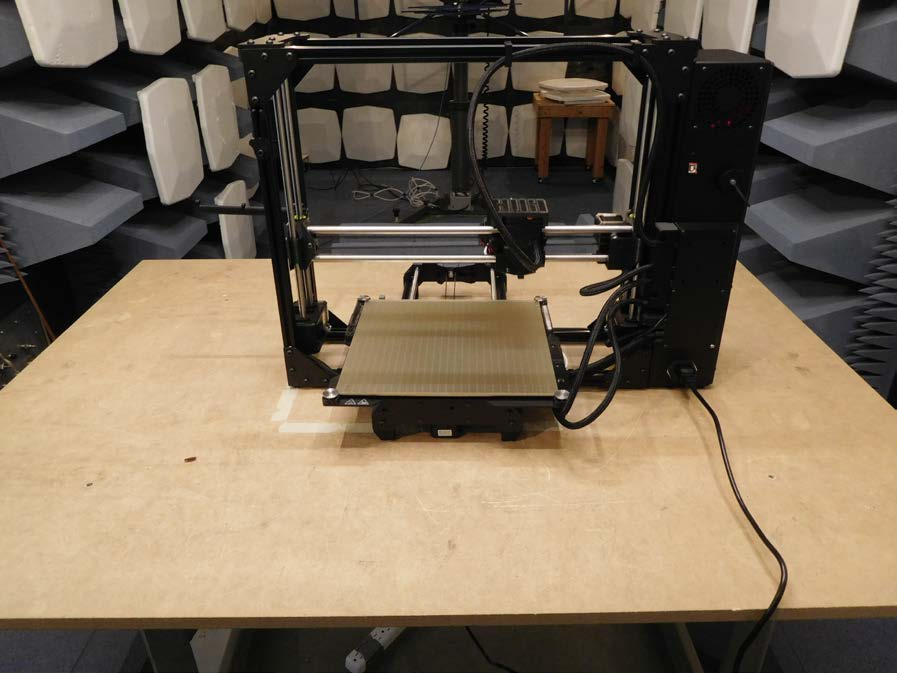
[picture p52: figure]

Test Specification: CISPR 24, 32 | Prepared by EMI Test Lab - EMITestLab.com
Model Name of EUT: TAZ Workhorse
Manufacturer: Aleph Objects Inc. | Revision 1.0
Page 32 of 80

Test setup for Radiated Emissions – SD Card

EMI Test Lab LLC Electro Magnetic Interference Testing

EmiTestLab.com

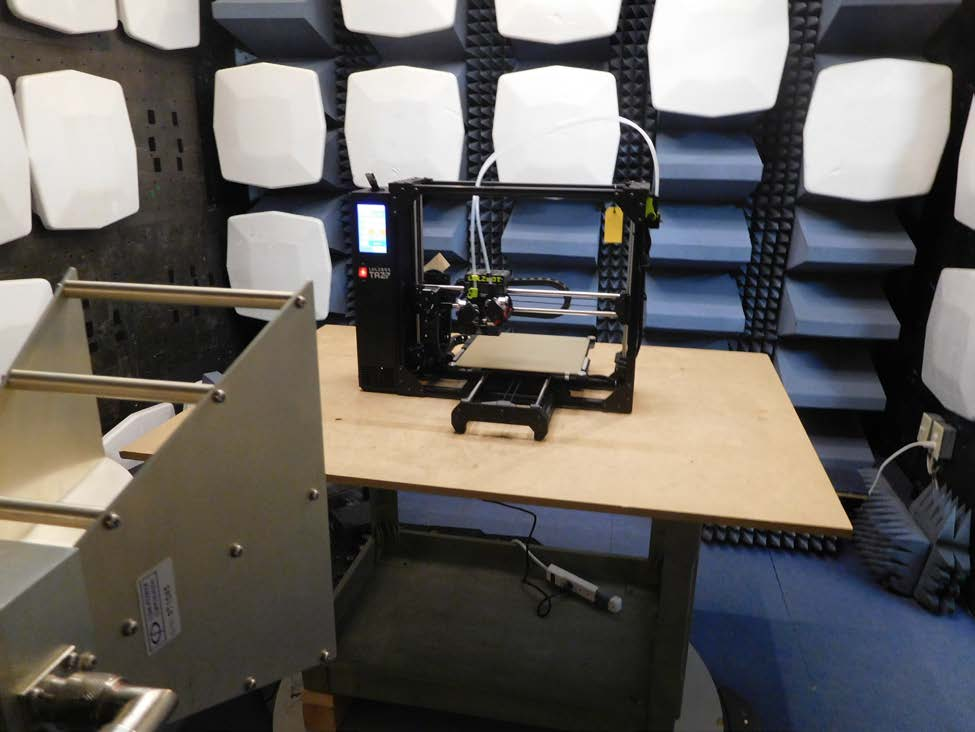
[picture p53: figure]

Test Specification: CISPR 24, 32 | Prepared by EMI Test Lab - EMITestLab.com
Model Name of EUT: TAZ Workhorse
Manufacturer: Aleph Objects Inc. | Revision 1.0
Page 33 of 80

Test setup for Radiated Emissions – SD card – 1- 6 GHz Horn antenna

EMI Test Lab LLC Electro Magnetic Interference Testing

EmiTestLab.com

Test Specification: CISPR 24, 32 | Prepared by EMI Test Lab - EMITestLab.com
Model Name of EUT: TAZ Workhorse
Manufacturer: Aleph Objects Inc. | Revision 1.0
Page 34 of 80

### 2.3 Harmonic current emissions

The emissions of harmonic currents at the AC mains connection terminals of the EUT were measured in conformance with and according to the criteria as stated below.

Basic standard | : | EN 61000-3-2:2014
Test setup | : | EN 61000-3-2:2014
Frequency range : | 100 Hz – 2000 Hz
Results of the measurements concerning the emission of harmonic currents at the AC mains connection terminals of the EUT | PASS
Name of Test Engineer: Signature: Date: | Dennis King 28 May 2019

Remarks:

The power supply was tested at 230VAC 50Hz.

EMI Test Lab LLC Electro Magnetic Interference Testing

EmiTestLab.com

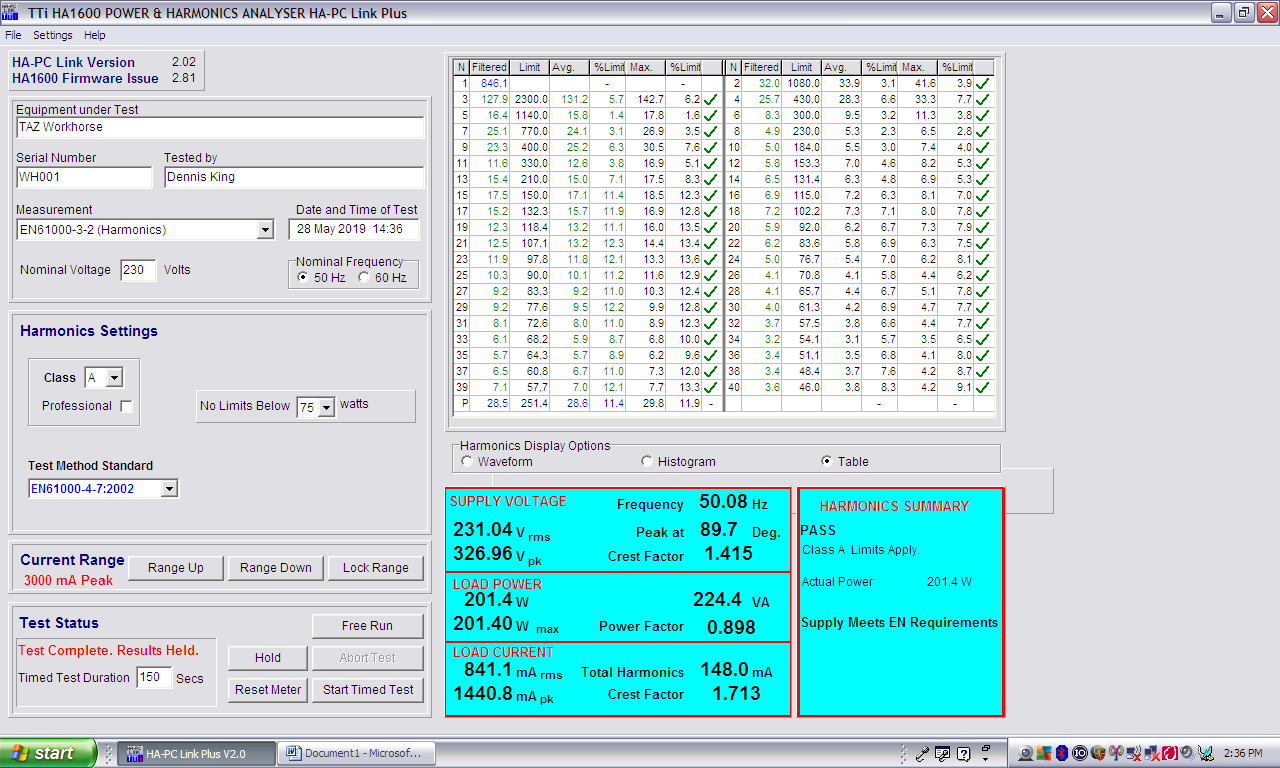
[picture p54: figure]

Test Specification: CISPR 24, 32 | Prepared by EMI Test Lab - EMITestLab.com
Model Name of EUT: TAZ Workhorse
Manufacturer: Aleph Objects Inc. | Revision 1.0
Page 35 of 80

HA-PC Link Plus. Software v2.02. Firmware v2.81
Report Number | : 165
Tested On | : 28 May 2019 15:40 for 150 Seconds.
Equipment Under Test : TAZ Workhorse
Serial Number | :
Tested by | : Dennis King
Supply Voltage : 230.8 to 231.1 Vrms 327.0 Vpk Frequency : 50.07 to 50.18 Hz Supply Meets EN Requirements
Load Power : 0.36 to 386.80 W 199.7 VA Power Factor 0.881
Load Current : 0.9 to 1555.1 mArms 1.4 to 2512.0 mApk Crest Factor: 1.703 Measurement Standard : EN61000-4-7:2002
Limits Applied | : EN61000-3-2 Class A Limits Apply.
Harmonic | Limit | Average | % | max. Value % | Assessment
Number | Current (filtered) Limit (Filtered) Limit
| mA | mA | | mA
Fundamental : | 846.1
2 : | 1080.0 | 33.9 | 3.1 | 41.6 | 3.9 | Pass
3 : | 2300.0 | 131.2 | 5.7 | 142.7 | 6.2 | Pass
4 : | 430.0 | 28.3 | 6.6 | 33.3 | 7.7 | Pass

EMI Test Lab LLC Electro Magnetic Interference Testing

EmiTestLab.com

Test Specification: CISPR 24, 32 | Prepared by EMI Test Lab - EMITestLab.com
Model Name of EUT: TAZ Workhorse
Manufacturer: Aleph Objects Inc. | Revision 1.0
Page 36 of 80
5 : | 1140.0 | 15.8 | 1.4 | 17.8 | 1.6 | Pass
6 : | 300.0 | 9.5 | 3.2 | 11.3 | 3.8 | Pass
7 : | 770.0 | 24.1 | 3.1 | 26.9 | 3.5 | Pass
8 : | 230.0 | 5.3 | 2.3 | 6.5 | 2.8 | Pass
9 : | 400.0 | 25.2 | 6.3 | 30.5 | 7.6 | Pass
10 : | 184.0 | 5.5 | 3.0 | 7.4 | 4.0 | Pass
11 : | 330.0 | 12.6 | 3.8 | 16.9 | 5.1 | Pass
12 : | 153.3 | 7.0 | 4.6 | 8.2 | 5.3 | Pass
13 : | 210.0 | 15.0 | 7.1 | 17.5 | 8.3 | Pass
14 : | 131.4 | 6.3 | 4.8 | 6.9 | 5.3 | Pass
15 : | 150.0 | 17.1 | 11.4 | 18.5 | 12.3 | Pass
16 : | 115.0 | 7.2 | 6.3 | 8.1 | 7.0 | Pass
17 : | 132.3 | 15.7 | 11.9 | 16.9 | 12.8 | Pass
18 : | 102.2 | 7.3 | 7.1 | 8.0 | 7.8 | Pass
19 : | 118.4 | 13.2 | 11.1 | 16.0 | 13.5 | Pass
20 : | 92.0 | 6.2 | 6.7 | 7.3 | 7.9 | Pass
21 : | 107.1 | 13.2 | 12.3 | 14.4 | 13.4 | Pass
22 : | 83.6 | 5.8 | 6.9 | 6.3 | 7.5 | Pass
23 : | 97.8 | 11.8 | 12.1 | 13.3 | 13.6 | Pass
24 : | 76.7 | 5.4 | 7.0 | 6.2 | 8.1 | Pass
25 : | 90.0 | 10.1 | 11.2 | 11.6 | 12.9 | Pass
26 : | 70.8 | 4.1 | 5.8 | 4.4 | 6.2 | Pass
27 : | 83.3 | 9.2 | 11.0 | 10.3 | 12.4 | Pass
28 : | 65.7 | 4.4 | 6.7 | 5.1 | 7.8 | Pass
29 : | 77.6 | 9.5 | 12.2 | 9.9 | 12.8 | Pass
30 : | 61.3 | 4.2 | 6.9 | 4.7 | 7.7 | Pass
31 : | 72.6 | 8.0 | 11.0 | 8.9 | 12.3 | Pass
32 : | 57.5 | 3.8 | 6.6 | 4.4 | 7.7 | Pass
33 : | 68.2 | 5.9 | 8.7 | 6.8 | 10.0 | Pass
34 : | 54.1 | 3.1 | 5.7 | 3.5 | 6.5 | Pass
35 : | 64.3 | 5.7 | 8.9 | 6.2 | 9.6 | Pass
36 : | 51.1 | 3.5 | 6.8 | 4.1 | 8.0 | Pass
37 : | 60.8 | 6.7 | 11.0 | 7.3 | 12.0 | Pass
38 : | 48.4 | 3.7 | 7.6 | 4.2 | 8.7 | Pass
39 : | 57.7 | 7.0 | 12.1 | 7.7 | 13.3 | Pass
40 : | 46.0 | 3.8 | 8.3 | 4.2 | 9.1 | Pass
21 - 39 : 251.4 | 28.6 | 11.4 | 29.8 | 11.9 | -

EMI Test Lab LLC Electro Magnetic Interference Testing

EmiTestLab.com

Test Specification: CISPR 24, 32 | Prepared by EMI Test Lab - EMITestLab.com
Model Name of EUT: TAZ Workhorse
Manufacturer: Aleph Objects Inc. | Revision 1.0
Page 37 of 80

### 2.4 Voltage fluctuations and flicker

Voltage fluctuations and flicker at the AC mains connection terminals of the EUT were measured in conformance with and according to the criteria as stated below.

Basic standard | : | EN 61000-3-3:2013
Test setup | : | EN 61000-3-3:2013
Results of the measurements concerning voltage fluctuations and flicker at the AC mains connection terminals of the EUT | PASS
Name of Test Engineer: Signature: Date: | Dennis King 28 May 2019

Remarks:
The unit was tested at 230VAC 50Hz.

EMI Test Lab LLC Electro Magnetic Interference Testing

EmiTestLab.com

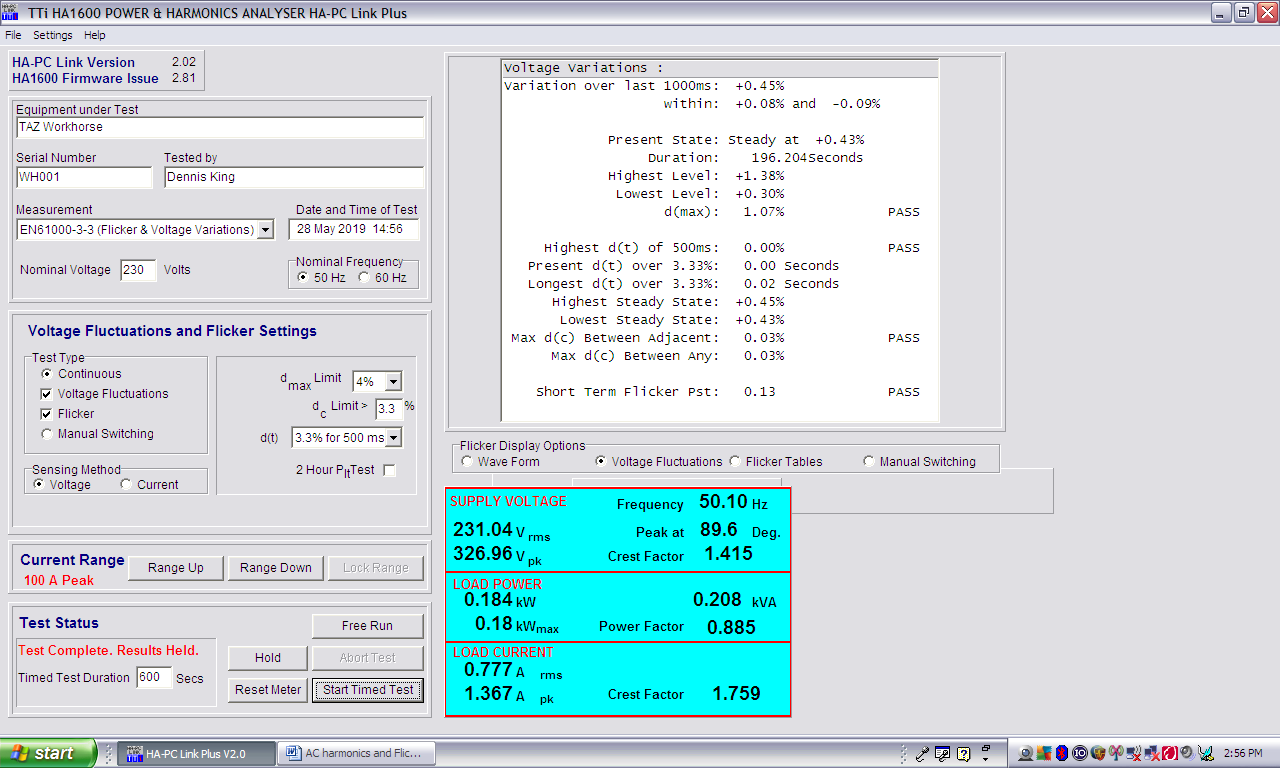
[picture p55: figure]

Test Specification: CISPR 24, 32 | Prepared by EMI Test Lab - EMITestLab.com
Model Name of EUT: TAZ Workhorse
Manufacturer: Aleph Objects Inc. | Revision 1.0
Page 38 of 80

HA-PC Link Plus. Software v2.02. Firmware v2.81
Report Number | : 166
Tested On | : 28 May 2019 14:30 for 600 Seconds.
Equipment Under Test : TAZ Workhorse
Serial Number | : WH001
Tested by | : Dennis King

Supply Voltage : 231.1 Vrms 327.0 Vpk Frequency : 50.07 to 50.18 Hz Load Current : 0.8 Arms 1.4 Apk Crest Factor: 1.707

Test Method: EN61000-3-3:2008

Voltage Variations :
Highest Level: +1.38%
Lowest Level: +0.30%
d(max): 1.07% | PASS
Highest d(t) of 500ms: 0.00% | PASS
Present d(t) over 3.33%: 0.00 Seconds Longest d(t) over 3.33%: 0.02 Seconds Highest Steady State: +0.45%

EMI Test Lab LLC Electro Magnetic Interference Testing

EmiTestLab.com

Test Specification: CISPR 24, 32 | Prepared by EMI Test Lab - EMITestLab.com
Model Name of EUT: TAZ Workhorse
Manufacturer: Aleph Objects Inc. | Revision 1.0
Page 39 of 80

Lowest Steady State: +0.43%
Max d(c) Between Adjacent: 0.03% PASS Max d(c) Between Any: 0.03%

Short Term Flicker Pst: 0.13 PASS

Flicker Results :
Pst Classifier | Plt Calculation
Duration | Flicker Interval Pst
0.1% | 0.18
0.7% | 0.04
1.0% | 0.04
1.5% | 0.03
2.2% | 0.03
3% | 0.03
4% | 0.03
6% | 0.02
8% | 0.02
10% | 0.02
13% | 0.02
17% | 0.02
30% | 0.02
50% | 0.02
80% | 0.01

EMI Test Lab LLC Electro Magnetic Interference Testing

EmiTestLab.com

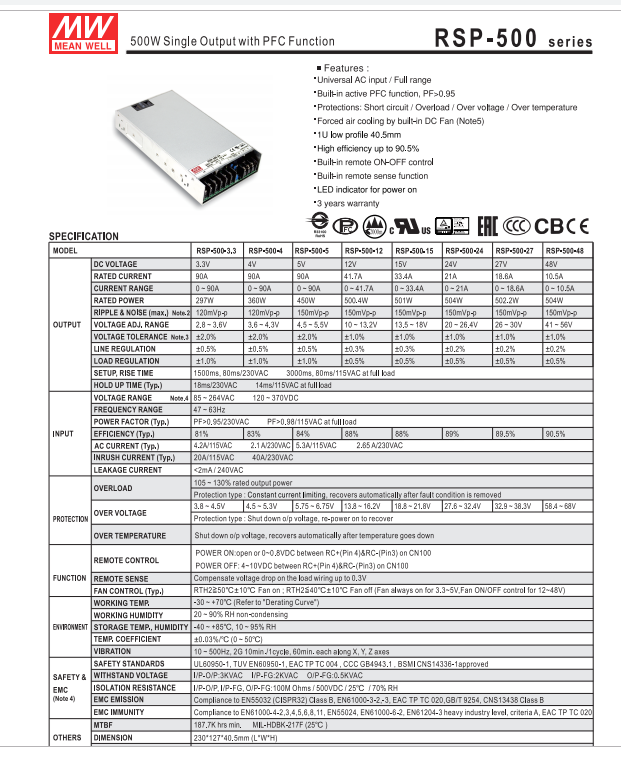
[picture p56: figure]

Test Specification: CISPR 24, 32 | Prepared by EMI Test Lab - EMITestLab.com
Model Name of EUT: TAZ Workhorse
Manufacturer: Aleph Objects Inc. | Revision 1.0
Page 40 of 80

EMI Test Lab LLC Electro Magnetic Interference Testing

EmiTestLab.com

Test Specification: CISPR 24, 32 | Prepared by EMI Test Lab - EMITestLab.com
Model Name of EUT: TAZ Workhorse
Manufacturer: Aleph Objects Inc. | Revision 1.0
Page 41 of 80

### 3 Immunity

The EUT has been tested in conformity with the standards EN 55024:2010+A1:2015, CISPR 24:2015 and AS/NZS CISPR 24:2013 (immunity) concerning susceptibility and transient, conducted and radiated disturbances including electrostatic discharges.

### 3.1 Performance criteria

The general principles (performance criteria) for the evaluation of the immunity test results are given below. The details are in EN 55024:2010+A1:2015, CISPR 24:2015 and AS/NZS CISPR 24:2013.

Performance Criterion A: The apparatus shall continue to operate as intended during the test. No degradation of performance or loss of function is allowed below a performance level (or permissible loss of performance) specified by the manufacturer, when the apparatus is used as intended.

Performance Criterion B: The apparatus shall continue to operate as intended after the test. No degradation of performance or loss of function is allowed below a performance level (or permissible loss of function) specified by the manufacturer, when the apparatus is used as intended. During the test, degradation of performance is allowed, however, no change of actual operating state or stored data is allowed.

Performance Criterion C: Temporary loss of function is allowed, provided the function is self-recoverable or can be restored by the operation of the controls, or by any operation specified in the instructions for use.

EMI Test Lab LLC Electro Magnetic Interference Testing

EmiTestLab.com

Test Specification: CISPR 24, 32 | Prepared by EMI Test Lab - EMITestLab.com
Model Name of EUT: TAZ Workhorse
Manufacturer: Aleph Objects Inc. | Revision 1.0
Page 42 of 80

### 3.2 Enclosure Port

3.2.1 Radio-frequency electromagnetic field. Amplitude modulated.

The susceptibility of the EUT to radio-frequency electromagnetic fields has been tested in conformity with and according to the criteria as stated below.

Basic standard | : | CISPR 24:2015
Test setup | : | EN 61000-4-3
Frequency range | : | 80 MHz to 1000 MHz
Field strength level | : | 3 V/m (selected w/o modulation, applied w/mod.)
Modulation | : | 1 kHz AM modulation, 80% depth
Performance criteria | : | Criteria A
Results of the measurements concerning the susceptibility of the EUT to radio-frequency electromagnetic fields | PASS Criteria A
Name of Test Engineer: Signature: Date: | Dennis King 27 May 2019

Remarks:
No loss of performance was observed during and after the test, all sides and both antenna polarizations meet Performance Criteria A.
Radiated Immunity Summary:
Configuration :The printer was running test software during the entire test using the usb cable connected to a laptop: PASS 3 V/M
No loss of function or data was detected during the testing.

EMI Test Lab LLC Electro Magnetic Interference Testing

EmiTestLab.com

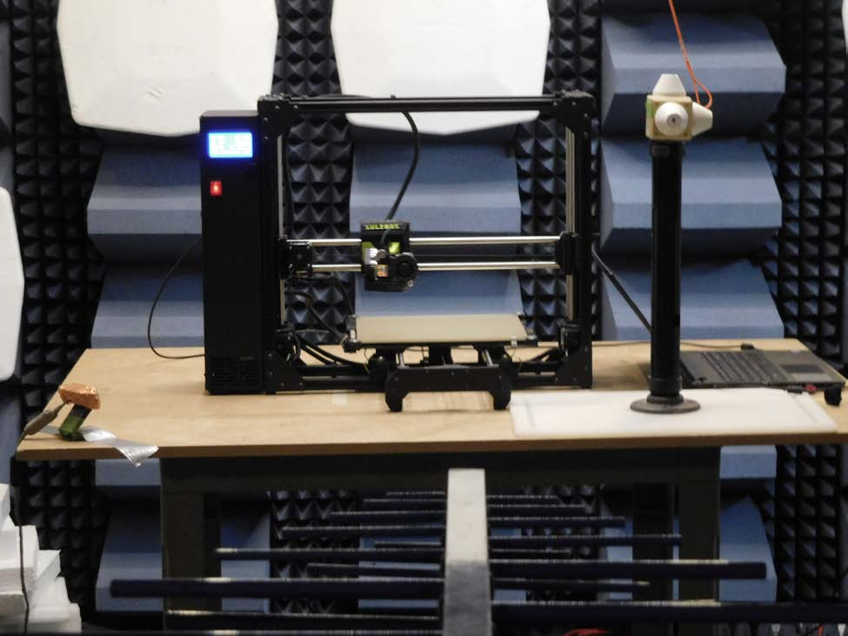
[picture p57: figure]

Test Specification: CISPR 24, 32 | Prepared by EMI Test Lab - EMITestLab.com
Model Name of EUT: TAZ Workhorse
Manufacturer: Aleph Objects Inc. | Revision 1.0
Page 43 of 80

Radiated immunity test setup – 80-1,000 MHz

All 4 sides, Vertical and Horizontal were checked at 3 V/M No errors were detected - passing Criteria A.

EMI Test Lab LLC Electro Magnetic Interference Testing

EmiTestLab.com

Test Specification: CISPR 24, 32 | Prepared by EMI Test Lab - EMITestLab.com
Model Name of EUT: TAZ Workhorse
Manufacturer: Aleph Objects Inc. | Revision 1.0
Page 44 of 80

### 3.2.2 Electrostatic discharge

The susceptibility of the EUT to electrostatic discharge was tested.
Basic standard | : | CISPR 24:2015
Test setup | : | EN 61000-4-2
Test levels | : | +- 2,4kV and +- 8 kV air discharge
| | +- 2kV and +- 4 kV contact discharge
| | +- 2kV and +- 4 kV, indirect, horizontal and vertical
| | coupling plane.
Performance criteria | : | B
Results of the test concerning the susceptibility of the EUT to electrostatic discharges (enclosure port) | Pass Criteria A
Name of Test Engineer: Signature: Date: | Dennis King 27 May 2019

Remarks:
The printer continued to function as intended during the testing with no loss of data or function. PASS Criteria A.

EMI Test Lab LLC Electro Magnetic Interference Testing

EmiTestLab.com

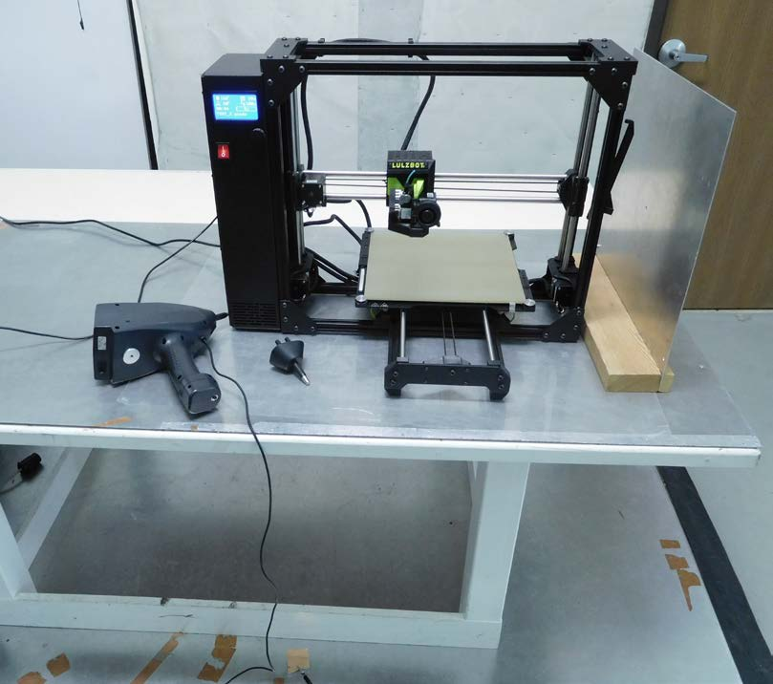
[picture p58: figure]

Test Specification: CISPR 24, 32 | Prepared by EMI Test Lab - EMITestLab.com
Model Name of EUT: TAZ Workhorse
Manufacturer: Aleph Objects Inc. | Revision 1.0
Page 45 of 80

ESD test setup per EN 61000-4-2 Horizontal and Vertical coupling planes were also checked

EMI Test Lab LLC Electro Magnetic Interference Testing

EmiTestLab.com

Test Specification: CISPR 24, 32 | Prepared by EMI Test Lab - EMITestLab.com
Model Name of EUT: TAZ Workhorse
Manufacturer: Aleph Objects Inc. | Revision 1.0
Page 46 of 80

ESD Test Setup per EN 61000-4-2:2009

Blue arrows are places that were checked for Air Discharge Red arrows are places that were checked for Contact Discharge

All metal parts that the user might touch were tested for contact discharge. All plastic areas that the user might touch were tested for air discharge.

EMI Test Lab LLC Electro Magnetic Interference Testing

EmiTestLab.com

Test Specification: CISPR 24, 32 | Prepared by EMI Test Lab - EMITestLab.com
Model Name of EUT: TAZ Workhorse
Manufacturer: Aleph Objects Inc. | Revision 1.0
Page 47 of 80

ESD Test Setup per EN 61000-4-2:2009

Blue arrows are places that were checked for Air Discharge Red arrows are places that were checked for Contact Discharge

All metal parts that the user might touch were tested for contact discharge. All plastic areas that the user might touch were tested for air discharge.

EMI Test Lab LLC Electro Magnetic Interference Testing

EmiTestLab.com

Test Specification: CISPR 24, 32 | Prepared by EMI Test Lab - EMITestLab.com
Model Name of EUT: TAZ Workhorse
Manufacturer: Aleph Objects Inc. | Revision 1.0
Page 48 of 80

Signal ports including telecommunication ports

### 3.2.3 Radio-frequency (common mode). Amplitude modulated

The susceptibility of the EUT to radio-frequency (common mode, amplitude modulated) signals to be tested in conformity with and according to the criteria as stated below

Basic Standard | : | CISPR 24:2015
Test setup | : | EN 61000-4-6
Frequency range | : | 0.15 – 80 MHz
Test level | : | 3 Vrms
Modulation | : | 1 kHz AM to a depth of 80%
Source impedance | : | 150 Ohms
Performance criteria | : | Criteria A

Note: Conducted only on ports interfacing with cables whose total length, according to the manufacturer’s functional specification, may exceed 3 meters.

Results of the test concerning the susceptibility of the EUT to radio-frequency signals (common mode, AM modulated applied to signal and telecom ports) | Not Applicable
Name of Test Engineer: Signature: Date: | Dennis King 27 May 2019

Remarks: No I/O cables 3 meters or longer.
There are no interconnecting cables on the unit that exceed 3 meters. See the test plan.

EMI Test Lab LLC Electro Magnetic Interference Testing

EmiTestLab.com

Test Specification: CISPR 24, 32 | Prepared by EMI Test Lab - EMITestLab.com
Model Name of EUT: TAZ Workhorse
Manufacturer: Aleph Objects Inc. | Revision 1.0
Page 49 of 80

### 3.2.4 Fast Transients

The susceptibility of the EUT to fast transients has been tested in conformity with and according to the criteria as stated below.

Basic standard | : | CISPR 24:2015
Test setup | : | EN 61000-4-4
Test level | : | +- 0.5 KV
Tr/Th | : | 5/50 nSec
Repetition frequency | : | 5 kHz
Performance criteria | : | Criteria B

Note: Conducted only on ports interfacing with cables whose total length, according to the manufacturer’s functional specification, may exceed 3 meters.

Results of the test concerning the susceptibility of the EUT to fast transients | Not Applicable
Name of Test Engineer: Signature: Date: | Dennis King 27 May 2019

Remarks:
There are no interconnecting cables on the unit that exceed 3 meters.

EMI Test Lab LLC Electro Magnetic Interference Testing

EmiTestLab.com

Test Specification: CISPR 24, 32 | Prepared by EMI Test Lab - EMITestLab.com
Model Name of EUT: TAZ Workhorse
Manufacturer: Aleph Objects Inc. | Revision 1.0
Page 50 of 80

### 3.3 AC input and AC output power ports

### 3.3.1 Radio-frequency (common mode, amplitude modulated)

The susceptibility of the EUT to radio-frequency signals (common mode, amplitude modulated, has been tested in conformity with and according to the criteria as stated below.

Basic standard | : | CISPR 24:2015
Test setup | : | EN 61000-4-6
Frequency range | : | 0.15 – 80 MHz
Test level | : | 3 Vrms
Source impedance | : | 150 Ohms
Performance criteria | : | Criteria A
Results of the test concerning the susceptibility of the EUT to radio-frequency signals (common mode, amplitude modulated) – AC input and AC output power ports | Pass Criteria A – 3 Vrms
Name of Test Engineer: Signature: Date: | Dennis King 27 May 2019

Remarks:
Tested at 230 VAC 50 Hz – the EUT continued to operate as intended with no loss of data or function.
The TAZ WORKHORSE passed Criteria A, 3 Vrms PASS

EMI Test Lab LLC Electro Magnetic Interference Testing

EmiTestLab.com

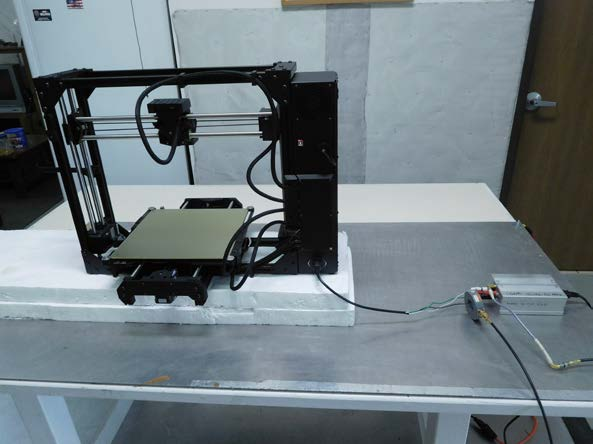
[picture p59: figure]
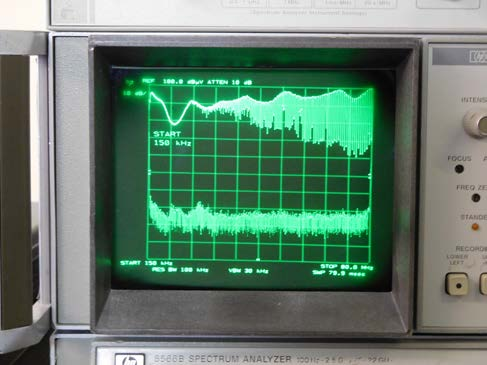
[picture p60: figure]

Test Specification: CISPR 24, 32 | Prepared by EMI Test Lab - EMITestLab.com
Model Name of EUT: TAZ Workhorse
Manufacturer: Aleph Objects Inc. | Revision 1.0
Page 51 of 80

AC power line conducted immunity setup per EN 61000-4-6 The injected signal is monitored with the current clamp on the spectrum analyzer

The spectrum analyzer display is recorded below

EMI Test Lab LLC Electro Magnetic Interference Testing

EmiTestLab.com

Test Specification: CISPR 24, 32 | Prepared by EMI Test Lab - EMITestLab.com
Model Name of EUT: TAZ Workhorse
Manufacturer: Aleph Objects Inc. | Revision 1.0
Page 52 of 80

### 3.3.2 Surges

The susceptibility of the EUT to surges has been tested in conformity with and according to the criteria as stated below

Basic Standard | : | CISPR 24:2015
Test setup | : | EN 61000-4-5
Test level 1 | : | +- 0.5 kV, +- 1.0 kV, Differential mode
Test level 2 | : | +- 0.5 kV, +- 1.0 kV, +- 2 kV Common Mode
Tr/Th | : | 1.2/50(8/20) micro Seconds
Number of pulses
Per phase angle/voltage : | 5
Performance criteria | : | Criteria B
Note | : | Applicable only to input AC ports
Results of the test concerning the susceptibility of the EUT to surges (AC input and AC output power ports | Pass Criteria A
Name of Test Engineer: Signature: Date: | Dennis King 27 May 2019

Remarks:
Tested at the highest voltage levels since this is a confirmation of the original passing data from the power supply manufacturer. PASS

EMI Test Lab LLC Electro Magnetic Interference Testing

EmiTestLab.com

Test Specification: CISPR 24, 32 | Prepared by EMI Test Lab - EMITestLab.com
Model Name of EUT: TAZ Workhorse
Manufacturer: Aleph Objects Inc. | Revision 1.0
Page 53 of 80

Surge Test Data

- Step #1 Setup

Filename: Internal\500V L-N
**** Setup ****
Peak Voltage: | +500 V | Repetition Rate: | 1 min
Async: | | Number of Surge: | 10
Trigger: | Auto | Test Mode: | Standard
Output: | Line
L1-N | ON | L1-PE | OFF
N-PE | OFF
Test Stop and Line Off | External Source: | ON
Monitor Line Current: | ON | Max Line Current | 16 A
Monitor Peak Voltage min: | OFF | Peak Voltage min: | ---
Monitor Peak Voltage max: | OFF | Peak Voltage max: | ---
Monitor Peak Current min: | OFF | Peak Current min: | ---
Monitor Peak Current max: | OFF | Peak Current max: | ---
**** Test End ****
Line: | OFF | Sound: | ON
**** Transition Function ****
** Alternate Polarity: | ON
No. of Surge Positive: | 5 | No. of Surge Negative | 5
** Peak Voltage Transition: | OFF
** Phase Transition: | OFF
- Step #2 Setup

Filename: Internal\1 kV L-N
**** Setup ****
Peak Voltage: | +1.00 kV | Repetition Rate: | 1 min
Line sync: | Transition | Number of Surge: | 10
Trigger: | Auto | Test Mode: | Standard
Output: | Line
L1-N | ON | L1-PE | OFF
N-PE | OFF
**** EUT Fail ****
EUT Fail Action: | Test Stop and Line Off | External Source: | ON
Monitor Line Current: | ON | Max Line Current | 16 A
Monitor Peak Voltage min: | OFF | Peak Voltage min: | ---

EMI Test Lab LLC Electro Magnetic Interference Testing

EmiTestLab.com

Test Specification: CISPR 24, 32 | Prepared by EMI Test Lab - EMITestLab.com
Model Name of EUT: TAZ Workhorse
Manufacturer: Aleph Objects Inc. | Revision 1.0
Page 54 of 80
Monitor Peak Voltage max: | OFF | Peak Voltage max: | ---
Monitor Peak Current min: | OFF | Peak Current min: | ---
Monitor Peak Current max: | OFF | Peak Current max: | ---
**** Test End ****
Line: | OFF | Sound: | ON
**** Transition Function ****
** Alternate Polarity: | ON
No. of Surge Positive: | 5 | No. of Surge Negative | 5
** Peak Voltage Transition: | OFF
** Phase Transition: | ON
Start Phase: | 0 deg | Delta Phase: | 90 deg
Stop Phase: | 270 deg

## Logs

- Sequence Log

Step
No.
Start Date | Start Time | End Date | End Time | Result
#1 | 27.05.2019 | 10:26:01

#1 | | | 27.05.2019 | 10:36:02 | PASSED

#2 | 27.05.2019 | 10:40:57

#2 | | | 27.05.2019 | 11:21:00 | PASSED

- Step #1 AXOS Surge Log
- Date Time

Coupling
Path

Repetition
Rate

Peak
Voltage
Sync | U peak | I peak
27.05.2019 | 10:26:02 | L1-N | 1 min | +500 V | --- | -2.39 kV | -0.05 kA | Test Start
27.05.2019 | 10:27:02 | L1-N | 1 min | +500 V | --- | +0.40 kV | 0.12 kA
27.05.2019 | 10:28:02 | L1-N | 1 min | +500 V | --- | +0.37 kV | 0.11 kA
27.05.2019 | 10:29:02 | L1-N | 1 min | +500 V | --- | +0.40 kV | 0.11 kA
27.05.2019 | 10:30:02 | L1-N | 1 min | +500 V | --- | +0.47 kV | 0.11 kA
27.05.2019 | 10:31:02 | L1-N | 1 min | +500 V | --- | +0.38 kV | 0.11 kA
27.05.2019 | 10:32:02 | L1-N | 1 min | -500 V | --- | -0.36 kV | -0.11 kA
27.05.2019 | 10:33:02 | L1-N | 1 min | -500 V | --- | -0.47 kV | -0.11 kA
27.05.2019 | 10:34:02 | L1-N | 1 min | -500 V | --- | -0.46 kV | -0.12 kA
27.05.2019 | 10:35:02 | L1-N | 1 min | -500 V | --- | -0.49 kV | -0.12 kA
27.05.2019 | 10:36:02 | L1-N | 1 min | -500 V | --- | -0.34 kV | -0.11 kA
27.05.2019 | 10:36:02 | L1-N | 1 min | -500 V | --- | -0.34 kV | -0.11 kA | Test End

EMI Test Lab LLC Electro Magnetic Interference Testing

EmiTestLab.com

Test Specification: CISPR 24, 32 | Prepared by EMI Test Lab - EMITestLab.com
Model Name of EUT: TAZ Workhorse
Manufacturer: Aleph Objects Inc. | Revision 1.0
Page 55 of 80
- Step #2 AXOS Surge Log
- Date Time

Coupling
Path

Repetition
Rate

Peak
Voltage
Sync | U peak | I peak
27.05.2019 | 10:40:57 | L1-N | 1 min | +1.00 kV | 0 deg | +0.84 kV | 0.23 kA | Test Start
27.05.2019 | 10:41:57 | L1-N | 1 min | +1.00 kV | 0 deg | +0.83 kV | 0.23 kA
27.05.2019 | 10:42:57 | L1-N | 1 min | +1.00 kV | 0 deg | +0.83 kV | 0.23 kA
27.05.2019 | 10:43:57 | L1-N | 1 min | +1.00 kV | 0 deg | +0.84 kV | 0.23 kA
27.05.2019 | 10:44:57 | L1-N | 1 min | +1.00 kV | 0 deg | +0.84 kV | 0.23 kA
27.05.2019 | 10:45:57 | L1-N | 1 min | +1.00 kV | 0 deg | +0.84 kV | 0.23 kA
27.05.2019 | 10:45:58 | L1-N | 1 min | +1.00 kV | 90 deg | +0.84 kV | 0.23 kA
27.05.2019 | 10:46:58 | L1-N | 1 min | +1.00 kV | 90 deg | +0.56 kV | 0.26 kA
27.05.2019 | 10:47:58 | L1-N | 1 min | +1.00 kV | 90 deg | +0.60 kV | 0.26 kA
27.05.2019 | 10:48:58 | L1-N | 1 min | +1.00 kV | 90 deg | +0.60 kV | 0.26 kA
27.05.2019 | 10:49:58 | L1-N | 1 min | +1.00 kV | 90 deg | +0.61 kV | 0.26 kA
27.05.2019 | 10:50:58 | L1-N | 1 min | +1.00 kV | 90 deg | +0.61 kV | 0.26 kA
27.05.2019 | 10:50:58 | L1-N | 1 min | +1.00 kV | 180 deg | +0.61 kV | 0.26 kA
27.05.2019 | 10:51:58 | L1-N | 1 min | +1.00 kV | 180 deg | +0.85 kV | 0.24 kA
27.05.2019 | 10:52:58 | L1-N | 1 min | +1.00 kV | 180 deg | +0.76 kV | 0.24 kA
27.05.2019 | 10:53:58 | L1-N | 1 min | +1.00 kV | 180 deg | +0.76 kV | 0.24 kA
27.05.2019 | 10:54:58 | L1-N | 1 min | +1.00 kV | 180 deg | +0.76 kV | 0.24 kA
27.05.2019 | 10:55:58 | L1-N | 1 min | +1.00 kV | 180 deg | +0.76 kV | 0.24 kA
27.05.2019 | 10:55:58 | L1-N | 1 min | +1.00 kV | 270 deg | +0.76 kV | 0.24 kA
27.05.2019 | 10:56:58 | L1-N | 1 min | +1.00 kV | 270 deg | +0.93 kV | 0.23 kA
27.05.2019 | 10:57:58 | L1-N | 1 min | +1.00 kV | 270 deg | +0.92 kV | 0.23 kA
27.05.2019 | 10:58:58 | L1-N | 1 min | +1.00 kV | 270 deg | +0.92 kV | 0.23 kA
27.05.2019 | 10:59:58 | L1-N | 1 min | +1.00 kV | 270 deg | +0.92 kV | 0.23 kA
27.05.2019 | 11:00:58 | L1-N | 1 min | +1.00 kV | 270 deg | +0.92 kV | 0.23 kA
27.05.2019 | 11:00:58 | L1-N | 1 min | -1.00 kV | 0 deg | +0.92 kV | 0.23 kA
27.05.2019 | 11:01:58 | L1-N | 1 min | -1.00 kV | 0 deg | -0.78 kV | -0.24 kA
27.05.2019 | 11:02:58 | L1-N | 1 min | -1.00 kV | 0 deg | -0.76 kV | -0.24 kA
27.05.2019 | 11:03:58 | L1-N | 1 min | -1.00 kV | 0 deg | -0.76 kV | -0.24 kA
27.05.2019 | 11:04:58 | L1-N | 1 min | -1.00 kV | 0 deg | -0.76 kV | -0.24 kA
27.05.2019 | 11:05:58 | L1-N | 1 min | -1.00 kV | 0 deg | -0.78 kV | -0.24 kA
27.05.2019 | 11:05:59 | L1-N | 1 min | -1.00 kV | 90 deg | -0.78 kV | -0.24 kA
27.05.2019 | 11:06:59 | L1-N | 1 min | -1.00 kV | 90 deg | -0.92 kV | -0.23 kA
27.05.2019 | 11:07:59 | L1-N | 1 min | -1.00 kV | 90 deg | -0.94 kV | -0.24 kA
27.05.2019 | 11:08:59 | L1-N | 1 min | -1.00 kV | 90 deg | -0.94 kV | -0.24 kA
27.05.2019 | 11:09:59 | L1-N | 1 min | -1.00 kV | 90 deg | -0.94 kV | -0.24 kA
27.05.2019 | 11:10:59 | L1-N | 1 min | -1.00 kV | 90 deg | -0.94 kV | -0.24 kA
27.05.2019 | 11:10:59 | L1-N | 1 min | -1.00 kV | 180 deg | -0.94 kV | -0.24 kA

EMI Test Lab LLC Electro Magnetic Interference Testing

EmiTestLab.com

Test Specification: CISPR 24, 32 | Prepared by EMI Test Lab - EMITestLab.com
Model Name of EUT: TAZ Workhorse
Manufacturer: Aleph Objects Inc. | Revision 1.0
Page 56 of 80
27.05.2019 11:11:59 | L1-N | 1 min | -1.00 kV | 180 deg | -0.85 kV -0.23 kA
27.05.2019 11:12:59 | L1-N | 1 min | -1.00 kV | 180 deg | -0.77 kV -0.23 kA
27.05.2019 11:13:59 | L1-N | 1 min | -1.00 kV | 180 deg | -0.84 kV -0.23 kA
27.05.2019 11:14:59 | L1-N | 1 min | -1.00 kV | 180 deg | -0.88 kV -0.23 kA
27.05.2019 11:15:59 | L1-N | 1 min | -1.00 kV | 180 deg | -0.85 kV -0.23 kA
27.05.2019 11:15:59 | L1-N | 1 min | -1.00 kV | 270 deg | -0.85 kV -0.23 kA
27.05.2019 11:16:59 | L1-N | 1 min | -1.00 kV | 270 deg | -0.58 kV -0.27 kA
27.05.2019 11:17:59 | L1-N | 1 min | -1.00 kV | 270 deg | -0.62 kV -0.27 kA
27.05.2019 11:18:59 | L1-N | 1 min | -1.00 kV | 270 deg | -0.62 kV -0.27 kA
27.05.2019 11:19:59 | L1-N | 1 min | -1.00 kV | 270 deg | -0.61 kV -0.27 kA
27.05.2019 11:20:59 | L1-N | 1 min | -1.00 kV | 270 deg | -0.60 kV -0.27 kA
27.05.2019 11:21:00 | L1-N | 1 min | -1.00 kV | 270 deg | -0.60 kV -0.27 kA Test End

## Results

- Sequence Result
- → Sequence Result (summary) : PASSED
- | → Immunity supervised : | YES
- | → EUT Immunity Criteria : | Normal performance of device
- Step Results

Step
No.
Step Type Generator Filename | Comments | Result
#1 | TEST | AXOS | Internal\500V L-N | PASSED

#2 | TEST | AXOS | Internal\1 kV L-N | PASSED

EMI Test Lab LLC Electro Magnetic Interference Testing

EmiTestLab.com

Test Specification: CISPR 24, 32 | Prepared by EMI Test Lab - EMITestLab.com
Model Name of EUT: TAZ Workhorse
Manufacturer: Aleph Objects Inc. | Revision 1.0
Page 57 of 80
- Date Time

Coupling
Path

Repetition
Rate

Peak
Voltage
Sync | U peak | I peak
#1 | 27.05.2019 | 17:51:26

#1 | | | 27.05.2019 | 19:11:29 | PASSED

1 ● Step #1 AXOS Surge Log

2
- Date

3
- Time

4
Coupling
Path

Repetition
Rate

Peak
Voltage
Sync | U peak | I peak | 5
27.05.2019 | 17:51:26 | L1-PE | 1 min | +2.00 kV | 0 deg | +0.00 kV | 0.00 kA | Test Start
27.05.2019 | 17:52:27 | L1-PE | 1 min | +2.00 kV | 0 deg | +2.49 kV | 0.04 kA
27.05.2019 | 17:53:27 | L1-PE | 1 min | +2.00 kV | 0 deg | +2.50 kV | 0.04 kA
27.05.2019 | 17:54:27 | L1-PE | 1 min | +2.00 kV | 0 deg | +2.47 kV | 0.05 kA
27.05.2019 | 17:55:27 | L1-PE | 1 min | +2.00 kV | 0 deg | +2.46 kV | 0.05 kA
27.05.2019 | 17:56:27 | L1-PE | 1 min | +2.00 kV | 0 deg | +2.46 kV | 0.05 kA
27.05.2019 | 17:56:27 | L1-PE | 1 min | +2.00 kV | 90 deg | +2.46 kV | 0.05 kA
27.05.2019 | 17:57:27 | L1-PE | 1 min | +2.00 kV | 90 deg | +2.33 kV | 0.05 kA
27.05.2019 | 17:58:27 | L1-PE | 1 min | +2.00 kV | 90 deg | +2.29 kV | 0.05 kA
27.05.2019 | 17:59:27 | L1-PE | 1 min | +2.00 kV | 90 deg | +2.35 kV | 0.05 kA
27.05.2019 | 18:00:27 | L1-PE | 1 min | +2.00 kV | 90 deg | +2.36 kV | 0.05 kA
27.05.2019 | 18:01:27 | L1-PE | 1 min | +2.00 kV | 90 deg | +2.32 kV | 0.05 kA
27.05.2019 | 18:01:27 | L1-PE | 1 min | +2.00 kV | 180 deg | +2.32 kV | 0.05 kA
27.05.2019 | 18:02:27 | L1-PE | 1 min | +2.00 kV | 180 deg | +2.47 kV | 0.05 kA
27.05.2019 | 18:03:27 | L1-PE | 1 min | +2.00 kV | 180 deg | +2.49 kV | 0.05 kA
27.05.2019 | 18:04:27 | L1-PE | 1 min | +2.00 kV | 180 deg | +2.51 kV | 0.05 kA
27.05.2019 | 18:05:27 | L1-PE | 1 min | +2.00 kV | 180 deg | +2.50 kV | 0.05 kA
27.05.2019 | 18:06:27 | L1-PE | 1 min | +2.00 kV | 180 deg | +2.51 kV | 0.04 kA
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
27.05.2019 | 19:10:29 | N-PE | 1 min | -2.00 kV | 270 deg | -2.40 kV | -0.05 kA
27.05.2019 | 19:11:29 | N-PE | 1 min | -2.00 kV | 270 deg | -2.39 kV | -0.05 kA
27.05.2019 | 19:11:29 | N-PE | 1 min | -2.00 kV | 270 deg | -2.39 kV | -0.05 kA | Test End

EMI Test Lab LLC Electro Magnetic Interference Testing

EmiTestLab.com

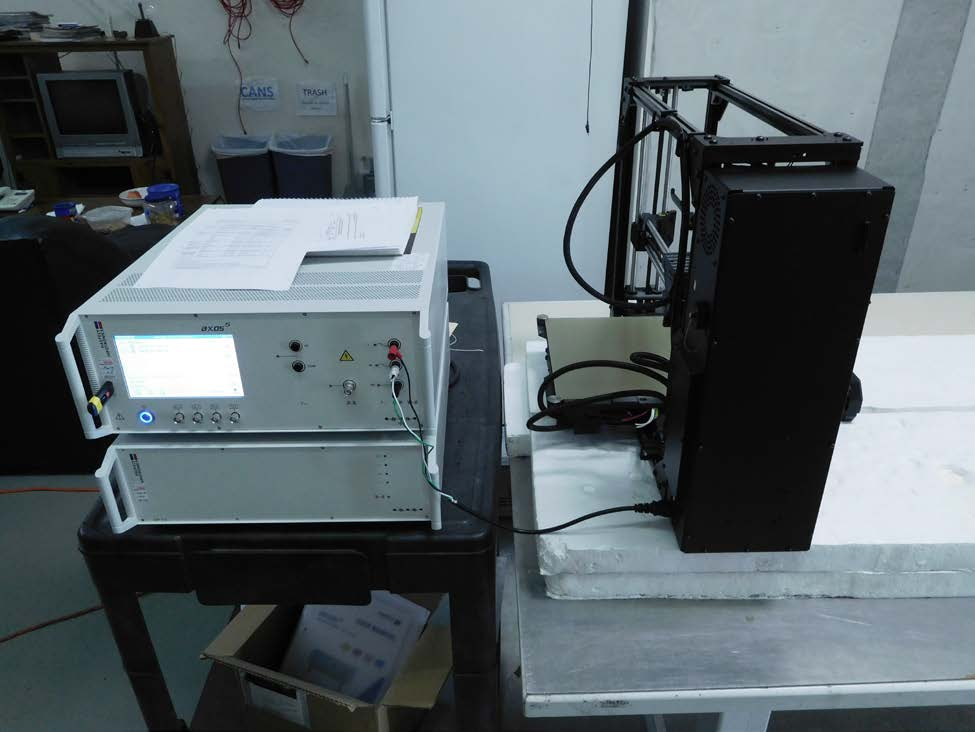
[picture p61: figure]

Test Specification: CISPR 24, 32 | Prepared by EMI Test Lab - EMITestLab.com
Model Name of EUT: TAZ Workhorse
Manufacturer: Aleph Objects Inc. | Revision 1.0
Page 60 of 80

Test setup according to EN 61000-4-5, Surge

EMI Test Lab LLC Electro Magnetic Interference Testing

EmiTestLab.com

Test Specification: CISPR 24, 32 | Prepared by EMI Test Lab - EMITestLab.com
Model Name of EUT: TAZ Workhorse
Manufacturer: Aleph Objects Inc. | Revision 1.0
Page 61 of 80

### 3.2.4 Fast Transients

The susceptibility of the EUT to fast transients (common mode) has been tested in conformity with and according to the criteria as stated below.

Basic standard | : | CISPR 24:2015
Test setup | : | EN 61000-4-4
Test level | : | +- 1 KV
Tr/Th | : | 5/50 nSec
Repetition frequency | : | 5 kHz
Performance criteria | : | Criteria B
Note | : | Conducted on the AC input.
Results of the test concerning the susceptibility of the EUT to fast transients (common mode, AC input and AC output ports) | Pass Criteria A
Name of Test Engineer: Signature: Date: | Dennis King 27 May 2019

Remarks:
Tested at 230 VAC 50 Hz . The unit continued to function as intended.

EMI Test Lab LLC Electro Magnetic Interference Testing

EmiTestLab.com

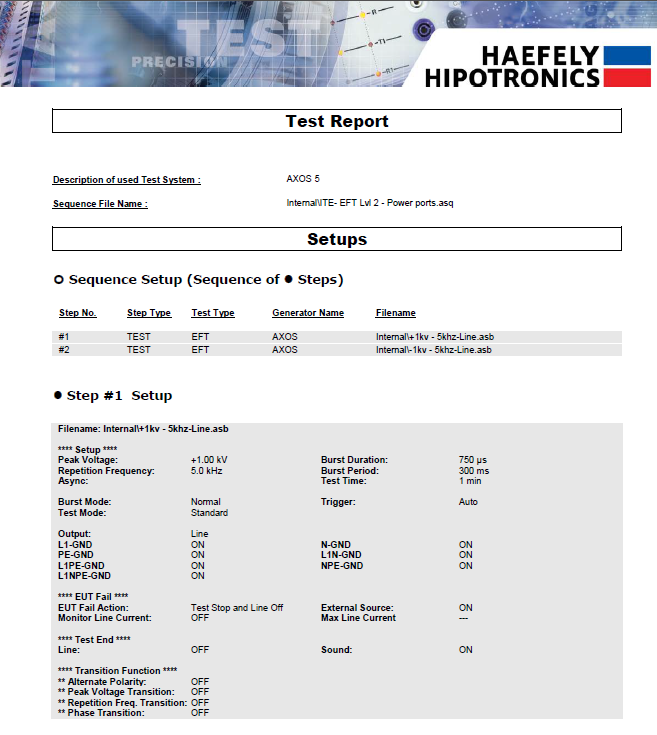
[picture p62: figure]

Test Specification: CISPR 24, 32 | Prepared by EMI Test Lab - EMITestLab.com
Model Name of EUT: TAZ Workhorse
Manufacturer: Aleph Objects Inc. | Revision 1.0
Page 62 of 80

EMI Test Lab LLC Electro Magnetic Interference Testing

EmiTestLab.com

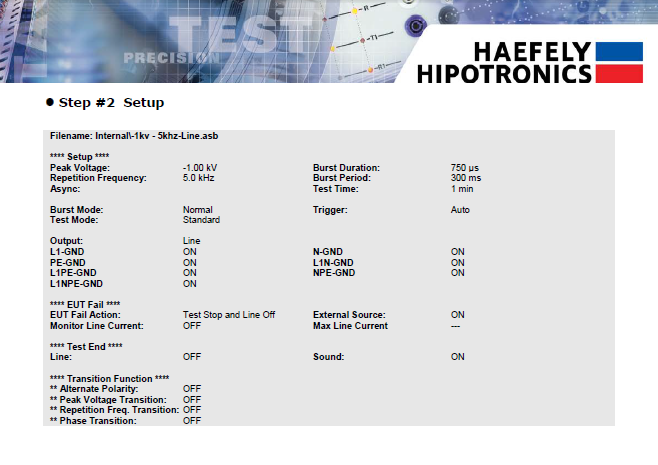
[picture p63: figure]

Test Specification: CISPR 24, 32 | Prepared by EMI Test Lab - EMITestLab.com
Model Name of EUT: TAZ Workhorse
Manufacturer: Aleph Objects Inc. | Revision 1.0
Page 63 of 80

EMI Test Lab LLC Electro Magnetic Interference Testing

EmiTestLab.com

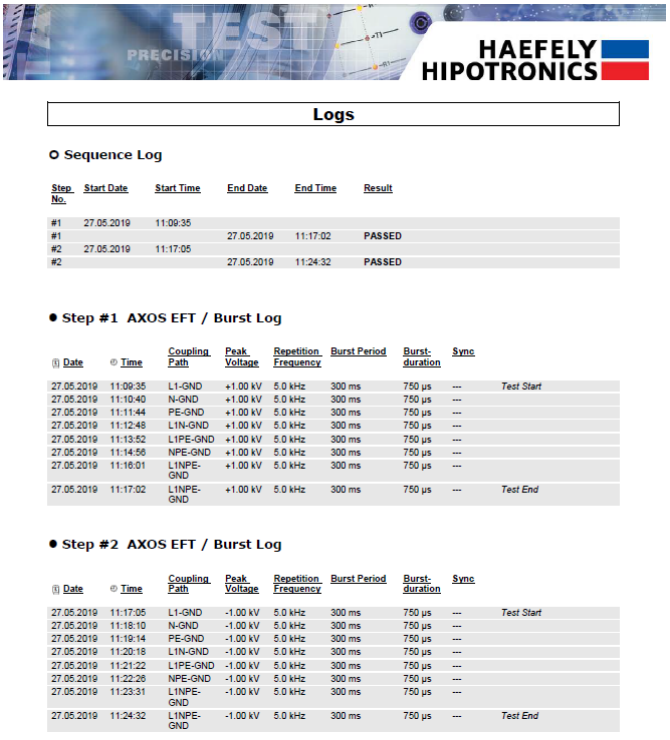
[picture p64: figure]

Test Specification: CISPR 24, 32 | Prepared by EMI Test Lab - EMITestLab.com
Model Name of EUT: TAZ Workhorse
Manufacturer: Aleph Objects Inc. | Revision 1.0
Page 64 of 80

EMI Test Lab LLC Electro Magnetic Interference Testing

EmiTestLab.com

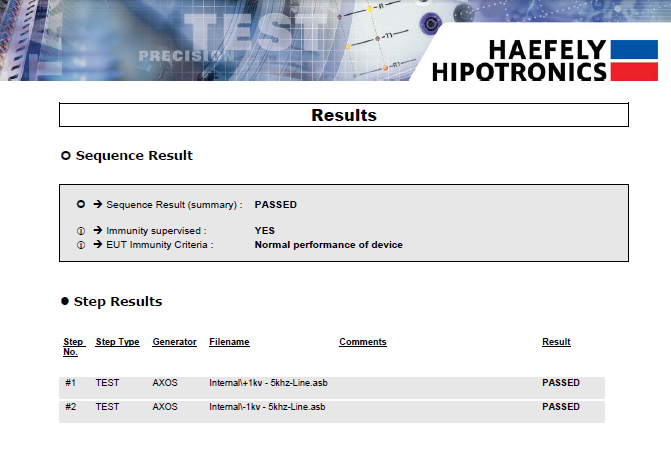
[picture p65: figure]

Test Specification: CISPR 24, 32 | Prepared by EMI Test Lab - EMITestLab.com
Model Name of EUT: TAZ Workhorse
Manufacturer: Aleph Objects Inc. | Revision 1.0
Page 65 of 80

EMI Test Lab LLC Electro Magnetic Interference Testing

EmiTestLab.com

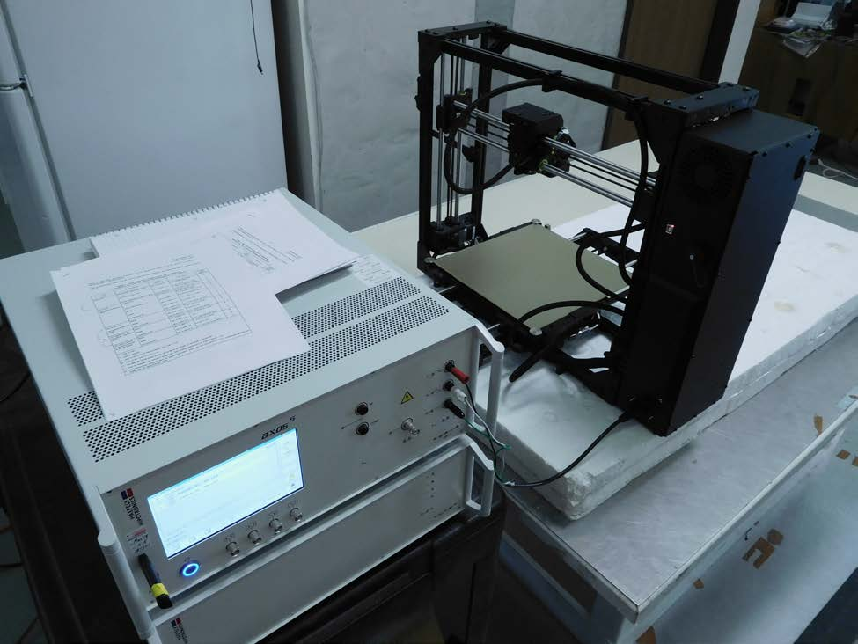
[picture p66: figure]

Test Specification: CISPR 24, 32 | Prepared by EMI Test Lab - EMITestLab.com
Model Name of EUT: TAZ Workhorse
Manufacturer: Aleph Objects Inc. | Revision 1.0
Page 66 of 80

Test Setup per EN 61000-4-4

EMI Test Lab LLC Electro Magnetic Interference Testing

EmiTestLab.com

Test Specification: CISPR 24, 32 | Prepared by EMI Test Lab - EMITestLab.com
Model Name of EUT: TAZ Workhorse
Manufacturer: Aleph Objects Inc. | Revision 1.0
Page 67 of 80

### 3.3.4 Voltage Dips and Interruptions

The susceptibility of the EUT to voltage dips and interruptions has been tested in conformity with and according to the criteria as stated below.

Basic Standard | : | CISPR 24:2015
Test setup | : | EN 61000-4-11
Test level (a) | : | Line at <5% of nominal for 0 .5 cycles
Test level (b) | : | Line at 70% of nominal for 25 cycles
Test level (c) | : | Line at <5% of nominal for 250 cycles
Results of the test concerning the susceptibility of the EUT to voltage dips and interruptions – AC input and AC output ports | Pass
Name of Test Engineer: Signature: Date: | Dennis King 27 May 2019

Remarks:
Tested at 230 VAC 50 Hz while printing. The unit continued to function as intended.

EMI Test Lab LLC Electro Magnetic Interference Testing

EmiTestLab.com

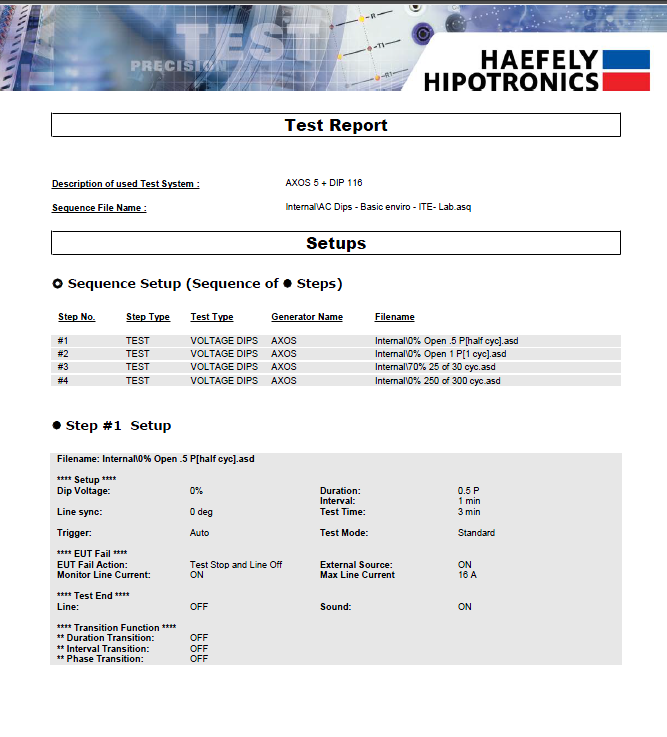
[picture p67: figure]

Test Specification: CISPR 24, 32 | Prepared by EMI Test Lab - EMITestLab.com
Model Name of EUT: TAZ Workhorse
Manufacturer: Aleph Objects Inc. | Revision 1.0
Page 68 of 80

EMI Test Lab LLC Electro Magnetic Interference Testing

EmiTestLab.com

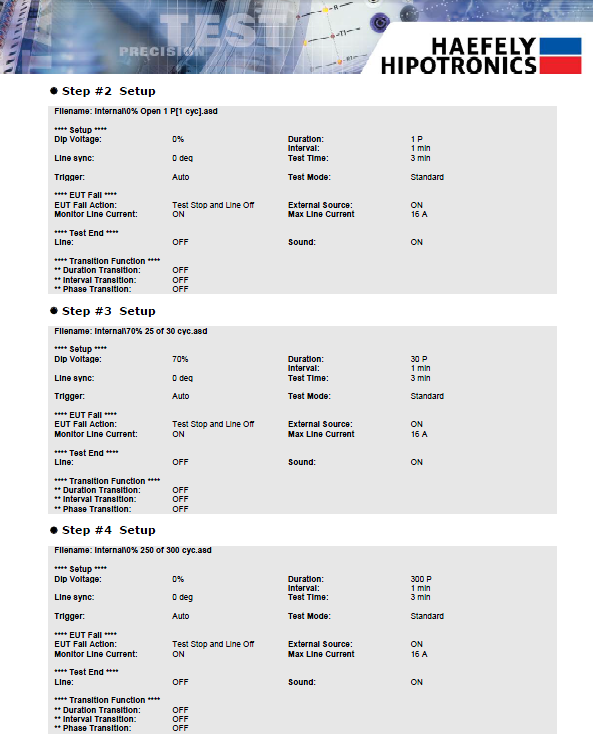
[picture p68: figure]

Test Specification: CISPR 24, 32 | Prepared by EMI Test Lab - EMITestLab.com
Model Name of EUT: TAZ Workhorse
Manufacturer: Aleph Objects Inc. | Revision 1.0
Page 69 of 80

EMI Test Lab LLC Electro Magnetic Interference Testing

EmiTestLab.com

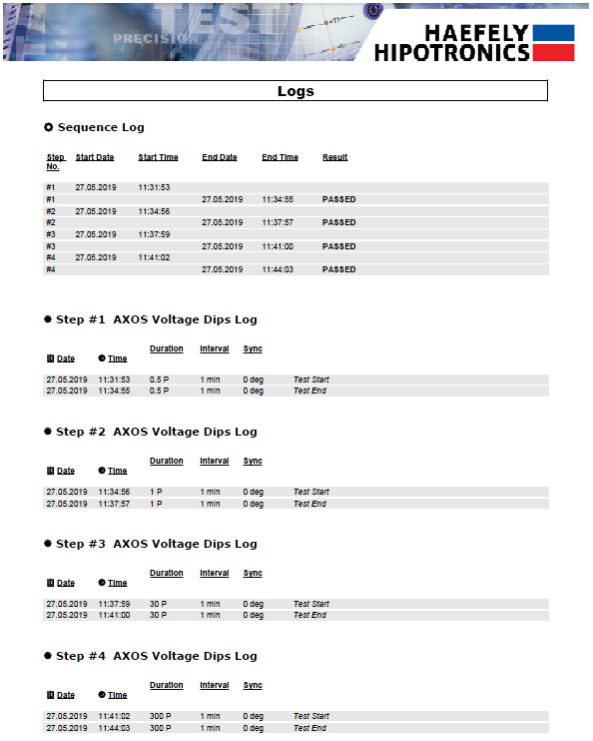
[picture p69: figure]

Test Specification: CISPR 24, 32 | Prepared by EMI Test Lab - EMITestLab.com
Model Name of EUT: TAZ Workhorse
Manufacturer: Aleph Objects Inc. | Revision 1.0
Page 70 of 80

EMI Test Lab LLC Electro Magnetic Interference Testing

EmiTestLab.com

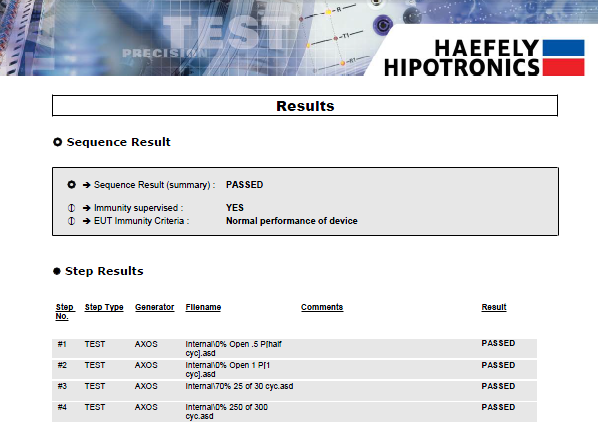
[picture p70: figure]

Test Specification: CISPR 24, 32 | Prepared by EMI Test Lab - EMITestLab.com
Model Name of EUT: TAZ Workhorse
Manufacturer: Aleph Objects Inc. | Revision 1.0
Page 71 of 80

EMI Test Lab LLC Electro Magnetic Interference Testing

EmiTestLab.com

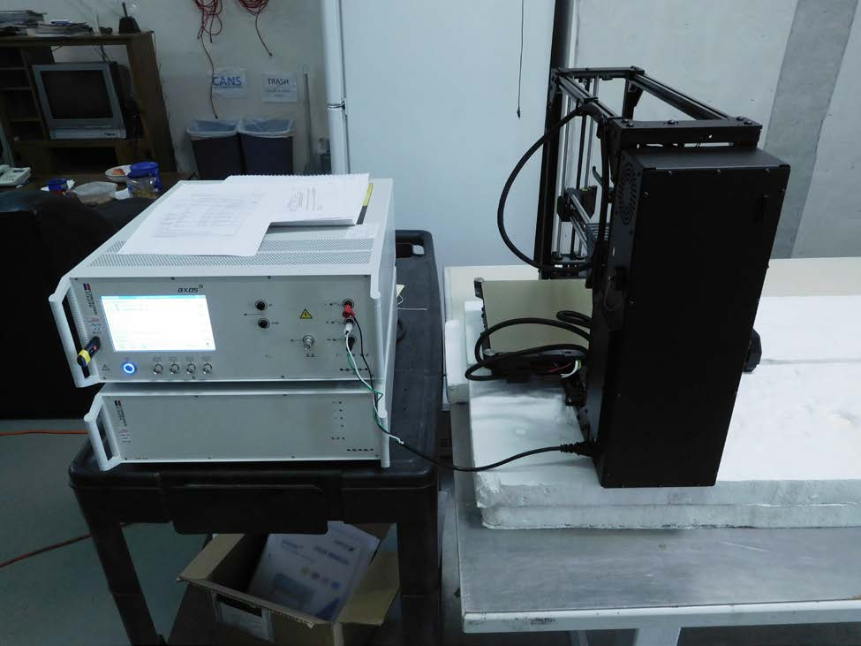
[picture p71: figure]

Test Specification: CISPR 24, 32 | Prepared by EMI Test Lab - EMITestLab.com
Model Name of EUT: TAZ Workhorse
Manufacturer: Aleph Objects Inc. | Revision 1.0
Page 72 of 80

Test setup according to EN 61000-4-11

EMI Test Lab LLC Electro Magnetic Interference Testing

EmiTestLab.com

Test Specification: CISPR 24, 32 | Prepared by EMI Test Lab - EMITestLab.com
Model Name of EUT: TAZ Workhorse
Manufacturer: Aleph Objects Inc. | Revision 1.0
Page 73 of 80

### 3.3.5 Power Frequency Magnetic Fields

The susceptibility of the EUT to power frequency magnetic fields has been tested in conformity with and according to the criteria as stated below.

Basic Standard | : | CISPR 24:2015
Test setup | : | EN 61000-4-8
Test level | : | 3 Amps per meter, X,Y and Z axis
Results of the test concerning the susceptibility of the EUT to | Not applicable
Name of Test Engineer: Signature: Date: | Dennis King 27 May 2019

Remarks:

Due to previous experience and magnetic field testing with this line of 3D printers there are no magnetically sensitive components in the system. Per the standard this test is not required.

EMI Test Lab LLC Electro Magnetic Interference Testing

EmiTestLab.com

Test Specification: CISPR 24, 32 | Prepared by EMI Test Lab - EMITestLab.com
Model Name of EUT: TAZ Workhorse
Manufacturer: Aleph Objects Inc. | Revision 1.0
Page 74 of 80

### 4.0 Modifications

No modifications required at the time of the compliance testing.

EMI Test Lab LLC Electro Magnetic Interference Testing

EmiTestLab.com

Test Specification: CISPR 24, 32 | Prepared by EMI Test Lab - EMITestLab.com
Model Name of EUT: TAZ Workhorse
Manufacturer: Aleph Objects Inc. | Revision 1.0
Page 75 of 80

### 5.0 Test equipment and Environmental Conditions

All tests were conducted within parameters specified for each test, for example >30% humidity for ESD. The lab temperature during all testing was between 72-74 degrees F.
All equipment used for testing has been calibrated or verified for cal using NIST traceable standards. Each piece of test equipment has a cal verification procedure that is conducted before and after each test.
Table of Test Equipment
Equipment | Description and Test | Model | Serial number | Next cal due
EMC Compact Tester -Haefely | EFT, Surge, AC Dips and Interrupts | AXOS 5 | 185501 | 28 March 2020
HP Spectrum Analyzer | Used for Radiated and Conducted Emissions | 8566B | 2607A02760 | 3 June 2020
HP Quasi-Peak Adapter | Used for Radiated and Conducted Emissions | 85650A | 8574A00233 | 3 June 2020
HP/Agilent Spectrum Analyzer | Used for Radiated and Conducted Emissions | E7401A | US41110467 | 22 Jan 2021
HP/Agilent Spectrum Analyzer | Used for Radiated Emissions 1-22 GHz | 8593E | 3710A02875 | 9 Jan 2021
HP/Agilent Spectrum Analyzer | Used for Radiated and Conducted Emissions | E7401A | US40240440 | 9 Jan 2021
Com-Power transient Limiter | Conducted Emissions | HZ560 | 001 | 3 June 2020
RF Bay Pre-Amp | Radiated emissions – 100kHz to 10 GHz | LPA-10-20 | 0643 | 12 Dec 2019
GTEM | Radiated Emissions and Radiated Immunity | 5317 | 9703-1209 | 25 April 2020 – Field Uniformity Cal per IEC 61000-4-20
3 Meter FAR – Fully Anechoic Room | Radiated Immunity and Emissions | N/A | FAR #1 | 15 October 2019 Field Uniformity per IEC/EN 61000-4-3 and Correlation data to GTEM
ComPower Horn Antenna | 1-18 GHz – Radiated Immunity and Emissions | AH 118 | 071040 | 20 March 2020
Chase BiLog Antenna | Radiated Emissions and Immunity | CBL6111 | 1121 | 20 March 2020
Marconi Instruments – Signal Generator 10kHz | Radiated Immunity | 2031 | 1196061031 | 20 October 2019

EMI Test Lab LLC Electro Magnetic Interference Testing

EmiTestLab.com

Test Specification: CISPR 24, 32 | Prepared by EMI Test Lab - EMITestLab.com
Model Name of EUT: TAZ Workhorse
Manufacturer: Aleph Objects Inc. | Revision 1.0
Page 76 of 80

– 2.7 GHz
HP Signal Generator | Radiated Immunity | 8657A | STD0578 | 3 May 2020
Amplifier Research .800 – 4.2 GHz Amp | Radiated Immunity – 1 GHz to 2.7 GHz | 10S1G4 | 34516 | 4 May 2020
Antenna Research Associates – 100 Watt amplifier w/controller | Radiated Immunity – 80-1000 MHz in the FAR | ARAPS/PC757LC ARA757LC-CE | 587V7 587V7 | 20 October 2019
Kalmus Power Amplifier | Radiated Immunity 150kHz – 1 GHz – in the GTEM | 747LC-CE | 7894-1 | 12 May 2020
Amplifier Research E- Field probe | Radiated Immunity | FP 2000 | 12845 | 12 May 2020
Com-Power LISN | Conducted emissions | LI-115 | 241010 | 17 May 2020
Com-Power LISN | Conducted emissions | LI-115 | 241011 | 17 May 2020
California Instruments 1000 VA Power Source | Emissions and Immunity -used as a 100/120/230/240-VAC 50/60 Hz AC source | 1001WP | L04788 | 4 June 2020
EMI Labs CDN | Conducted Immunity | EMICDN | 001 | 9 Dec 2019
Hafely ESD Gun | Electro Static Discharge | ONYX16 | 181726 | 24 June 2020
KeyTek ECAT | Fast transients / Burst | E412 | 32612 | 5 June 2020
FCC Inc. RF Current probe | Monitor Conducted Immunity signal | F-33-1 | 423 | 9 Dec 2019
EMI Labs Mag Loop | Magnetic Loop Antenna | Mag100 | 80162 | 12 Dec 2019
Thermo Keytek CE Master | Surge/ AC Dips and Interrupts | CE Master | 0405277 | 15 Dec 2019
Audio Frequency Helmholtz Coil – Tektronix Audio Signal Generator and Audio Amplifier Test System | 50 Hz to 10 kHz Magnetic field, homogenous – Immunity test | Audio Magnetic Field Test System | EMI-HH001 | 20 August 2020

EMI Test Lab LLC Electro Magnetic Interference Testing

EmiTestLab.com

Test Specification: CISPR 24, 32 | Prepared by EMI Test Lab - EMITestLab.com
Model Name of EUT: TAZ Workhorse
Manufacturer: Aleph Objects Inc. | Revision 1.0
Page 77 of 80

6.0 Measurement Uncertainty - Radiated Emissions example;
Table of Uncertainty Calculation
√ | Contribution | Designation | Probability Distribution | k | Uncertainty (dB)
| Equipment Under Test Uncertainties | UEUT | | | Note 1
√ | Measuring Receiver Amplitude Accuracy | URXaccuracy | rectangular | 3 | ± 0.9
√ | GTEM Uniformity | UUniformity | rectangular | 3 | ± 4.0
√ | Secondary Field Components | USecondary | | | Excluded by Test Method
√ | Mismatch Uncertainty-GTEM to Pre-Amplifier | U Mismatch | U-shaped | 2 | +0.63 and -0.65
√ | Mismatch Uncertainty-Pre-Amplifier to Spectrum Analyzer | U Mismatch | U-shaped | 2 | +0.92 and -1.03
√ | System Sensitivity Error | USensitivity | rectangular | 3 | 0.28
√ | GTEM Electric-Field Frequency Response | UE−Field | rectangular | 3 | ± 1.6
| Ambient Signal Uncertainty | U Abient | | | Not Significant
√ | GTEM to OATS Correlation | UCorr | rectangular | 3 | ±1.2
√ | Septum Height Variation | USeptum | normal | 2 | +0.72 and -0.82
| Coaxial Cable Temperature Variations | UCableTemperature | | | Not Significant
√ | Coaxial Cable Calibration | UCableCalibration | rectangular | 3 | ±0.05
√ | Pre-amplifier Calibration Uncertainty | UPr e−Amp | rectangular | 3 | ±0.05
| Combined Uncertainty(dB) Positive Terms | | | | 2.77
| Combined Uncertainty(dB) Negative Terms | | | | -2.75
| Expanded Uncertainty Positive Terms | | Normal | 2 | 5.54
| Expanded Uncertainty Negative Terms | | Normal | 2 | -5.50

EMI Test Lab LLC Electro Magnetic Interference Testing

EmiTestLab.com

Test Specification: CISPR 24, 32 | Prepared by EMI Test Lab - EMITestLab.com
Model Name of EUT: TAZ Workhorse
Manufacturer: Aleph Objects Inc. | Revision 1.0
Page 78 of 80

Typical Measurement Uncertainty for the following Tests:

The estimated combined standard uncertainty for ESD testing, EN 61000-4-2 is ± 4%
The estimated combined standard uncertainty for Radiated Immunity, EN 61000-4-3 is ± 2.7dB The estimated combined standard uncertainty for EFT/Burst, EN 61000-4-4 is ± 5.8%
The estimated combined standard uncertainty for Surge, EN 61000-4-5 is ± 8%
The estimated combined standard uncertainty for Conducted Immunity, EN 61000-4-6 is ± 1.5 dB
The estimated combined standard uncertainty for Magnetic Fields, EN 61000-4-8 is ± 0.6%
The estimated combined standard uncertainty for Voltage Dips and Interrupts, EN 61000-4-11 is ± 4.3% The estimated combined standard uncertainty for Conducted Emissions is ± 1.2dB
The estimated combined standard uncertainty for Harmonic current and flicker is ± 11.6%

EMI Test Lab LLC Electro Magnetic Interference Testing

EmiTestLab.com

Test Specification: CISPR 24, 32 | Prepared by EMI Test Lab - EMITestLab.com
Model Name of EUT: TAZ Workhorse
Manufacturer: Aleph Objects Inc. | Revision 1.0
Page 79 of 80

### 7.0 Test Plan

Testing required
The LulzBot TAZ WORKHORSE 3D Printer will be tested for Radiated and Conducted emissions, Harmonics and Flicker and all applicable Immunity tests as required for the EMC portion of the CE Mark and the Australia / New Zealand EMC standards. Previous power supply testing may be used as applicable.

Test Setup
The TAZ WORKHORSE will be operating using test software during all the testing.

The test software will be installed on an SD card, the program will be loaded from this drive.

The Printer will also be tested while connected and operated from a laptop through the usb cable supplied with the unit.

Failure Criteria
If the unit stops working or the printing process is altered by the injected noise, this would be considered a failure.

I/O cables
The unit has only one I/O cable, the USB cable that is used to control the printer from software installed on the host computer. There are no I/O cables on the unit 3 meters or longer.

Status of the test unit
Beta build.

EMI Test Lab LLC Electro Magnetic Interference Testing

EmiTestLab.com

Test Specification: CISPR 24, 32 | Prepared by EMI Test Lab - EMITestLab.com
Model Name of EUT: TAZ Workhorse
Manufacturer: Aleph Objects Inc. | Revision 1.0
Page 80 of 80

## 8.0 Conclusion

The Aleph Objects – TAZ Workhorse 3D Printer complies with the emissions standards:

### 1. AS/NZS CISPR 32:2015 2. EN 55032:2015 3. EN 61000-3-2:2014 4. EN 61000-3-3:2013

and the immunity standards:

### 1. AS/NZS CISPR 24:2013 2. EN 55024:2015

in the configurations and operating modes as stated in this test report.

End of Report
