joeyliu522/VVI-project/CAD files/Older 3D printed parts/production_docs/compliance/Aleph_Objects-TAZ_Workhorse-EMC_Emissions_FCC_and_Canada_Test_Report_28-June-2019_Rev_1_0.pdf

EMI Test Lab LLC Electro Magnetic Interference Testing

EmiTestLab.com

Test Specification: Title 47 CFR Part 15 and ICES-003 Prepared by EMI Test Lab - EMITestLab.com Model Name of EUT: TAZ WORKHORSE
Manufacturer: Aleph Objects Inc. | Revision 1.0
Page 1 of 44

# FCC Part 15 Subpart B Class B Verification Test Report Industry Canada ICES-003 Test Report

## Regarding Emissions Compliance of the

# Aleph Objects TAZ Workhorse 3D Printer

## In Accordance with the Emissions Standards FCC’s Title 47 CFR Part 15 Subpart B Class B ICES-003 Information Technology Equipment Class B

## Revision History

Release | Date | Description
1.0 | 28 June 2019 | Initial release

EMI Test Lab LLC Electro Magnetic Interference Testing

EmiTestLab.com

Test Specification: Title 47 CFR Part 15 and ICES-003 Prepared by EMI Test Lab - EMITestLab.com Model Name of EUT: TAZ WORKHORSE
Manufacturer: Aleph Objects Inc. | Revision 1.0
Page 2 of 44

Description of Equipment Under Test (EUT)

Test Item | : | TAZ Workhorse 3D Printer
Manufacturer | : | Aleph Objects, Inc.

Manufacturer’s information
Manufacturers
Representative | : | Mark Pelletier - Engineer
Company | : | Aleph Objects, Inc.
Address | : | 626 West 66th Street
| | Loveland, Colorado 80538
| | U.S.A.
Website | : | https://www.alephobjects.com/index.html
Tests Performed at
Address | : | EMI Test Lab LLC
| | 1822 Skyway Drive Unit J
| | Longmont, Colorado 80504
| | U.S.A
Website | : | http://www.emitestlab.com/
Test Specifications | : | FCC Part 15 Subpart B Class B, ICES-003 Class B
Tests completed | : | 28 May 2019
Result of Testing | : | The EUT is in Compliance with FCC Part 15 Class B for
home use. The EUT also meets ICES-003 Class B (Canada)
Senior EMC Engineer | : | Dennis King
Report written by | : | Dennis King – EMI Test Lab
Test Plan | : | Dennis King and Mark Pelletier for Aleph Objects
Report date | : | 28 June 2019

These test results relate only to the specific unit that was tested. A periodic production audit to verify continued compliance is recommended.

EMI Test Lab LLC Electro Magnetic Interference Testing

EmiTestLab.com

Test Specification: Title 47 CFR Part 15 and ICES-003 Prepared by EMI Test Lab - EMITestLab.com Model Name of EUT: TAZ WORKHORSE
Manufacturer: Aleph Objects Inc. | Revision 1.0
Page 3 of 44

Table of Contents

1. General Test Information | page 4
1.1. Applied Standards
1.2. Detailed description of test configuration, input and output ports 1.2.1.Description of test configuration
1.2.2.Description of input and output ports and power supply information 1.2.3.Operating modes
2. Emissions | page 9
2.1. AC Mains conducted emissions
2.2. Enclosure radiated emissions
2.2.1.30-1,000 MHz
2.2.2.1-6 GHz
3. Modifications | page 23
4. User Guide statements and labels | page 24
5. Test equipment. | page 28
6. Measurement Uncertainty | page 30
7. Test Plan | page 32
8. Conclusion | page 33

EMI Test Lab LLC Electro Magnetic Interference Testing

EmiTestLab.com

Test Specification: Title 47 CFR Part 15 and ICES-003 Prepared by EMI Test Lab - EMITestLab.com Model Name of EUT: TAZ WORKHORSE
Manufacturer: Aleph Objects Inc. | Revision 1.0
Page 4 of 44

### 1 General

### 1.1 Applied Standards

The TAZ Workhorse was evaluated for emissions using the FCC’s Title 47 CFR Part 15 Subpart B Class B for home use and Industry Canada’s ICES-003 Issue 6 Class B.

The following documents were also used as guidance for testing;

- (a) Canadian Standards Association Standard CAN/CSA-CISPR 22-10(R2014), Information technology equipment — Radio disturbance characteristics — Limits and methods of measurement
- This is an adoption with Canadian deviations of the identically titled IEC (International Electrotechnical Commission) Standard CISPR (International Special Committee on Radio Interference) 22, Sixth edition, 2008-09.
- (b) ANSI C63.4-2014, American National Standard for Methods of Measurement of Radio-Noise Emissions from Low-Voltage Electrical and Electronic Equipment in the Range of 9 kHz to 40 GHz, 2014

### 1.2 Detailed description of the test configuration, input and output ports

Test Configuration Definition:

The 3D Printer was tested while running test code that simulates a worst case for operation of the printer. The heater bed was on during all the testing.
Test code used is called TEST_2.gcode
All testing was done at 120 VAC 60 Hz, the nominal North American voltage and frequency.

Taz Workhorse Software:

The default software for the TAZ WORKHORSE 3D printer is called Cura LulzBot Edition. Cura is a Free Software program that both prepares your files for printing (by converting your model into GCODE), and also allows you to control the operation of your LulzBot 3D printer.

EMI Test Lab LLC Electro Magnetic Interference Testing

EmiTestLab.com


Test Specification: Title 47 CFR Part 15 and ICES-003 Prepared by EMI Test Lab - EMITestLab.com Model Name of EUT: TAZ WORKHORSE
Manufacturer: Aleph Objects Inc. | Revision 1.0
Page 5 of 44

Typical screen shot of software used during emissions and immunity testing.

EMI Test Lab LLC Electro Magnetic Interference Testing

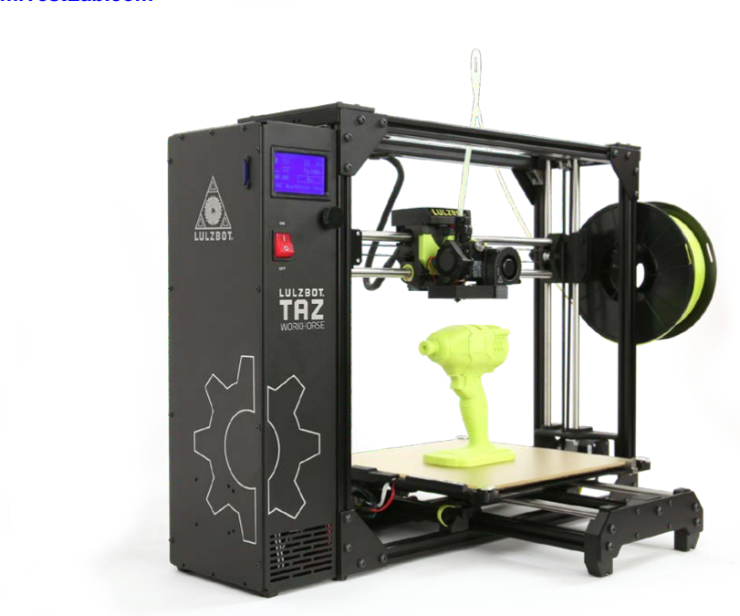
[picture p72: figure]

EmiTestLab.com

Test Specification: Title 47 CFR Part 15 and ICES-003 Prepared by EMI Test Lab - EMITestLab.com Model Name of EUT: TAZ WORKHORSE
Manufacturer: Aleph Objects Inc. | Revision 1.0
Page 6 of 44

## The Taz Workhorse – 3D Printer

https://www.lulzbot.com/store/printers/lulzbot-taz-workhorse

EMI Test Lab LLC Electro Magnetic Interference Testing

EmiTestLab.com

Test Specification: Title 47 CFR Part 15 and ICES-003 Prepared by EMI Test Lab - EMITestLab.com Model Name of EUT: TAZ WORKHORSE
Manufacturer: Aleph Objects Inc. | Revision 1.0
Page 7 of 44

### 1.2.1 Description of test configuration

EUT | : | TAZ WORKHORSE 3D Printer
Manufacturer | : | Aleph Objects, Inc.
System model name | : | TAZ WORKHORSE
Serial Number | : | WH001
Test Voltage | : | 120 VAC 60 Hz

### 1.2.2. Description of tested input and output ports and power supply information

Number of cable type | Type of Cable | From | To | Shielded? | Remarks - length
1 | USB | unterminated | Taz Workhorse | Yes | 6 ft. Tripp Lite model: U023-006 – ferrites on both ends
Power supply location | Manufacturer | Model | Serial number | Shielded | Remarks
Internal AC supply | Meanwell | RSP-500-24 | Not available | Shielded enclosure | UL and TUV Rheinland Certified – Output; 24V 21A

EMI Test Lab LLC Electro Magnetic Interference Testing

EmiTestLab.com

Test Specification: Title 47 CFR Part 15 and ICES-003 Prepared by EMI Test Lab - EMITestLab.com Model Name of EUT: TAZ WORKHORSE
Manufacturer: Aleph Objects Inc. | Revision 1.0
Page 8 of 44

### 1.2.3 Operation modes

The Equipment Under Test (EUT) was set up and operated as described in section 1.2.

During preliminary testing for emissions it was determined that the following configurations are worst case for emissions and immunity. All further testing was done in these modes.

The 3D Printer was tested while running test code that continuously moves the print heads and heats the heater bed.
The 3D Printer was checked while printing from the SD Card and also while operated from a laptop connecting to the printer through a USB cable that is supplied with the unit.

All testing was done at 120 VAC 60 Hz, the nominal North American voltage and frequency.

EMI Test Lab LLC Electro Magnetic Interference Testing

EmiTestLab.com

Test Specification: Title 47 CFR Part 15 and ICES-003 Prepared by EMI Test Lab - EMITestLab.com Model Name of EUT: TAZ WORKHORSE
Manufacturer: Aleph Objects Inc. | Revision 1.0
Page 9 of 44

## 2 Emissions

The EUT (equipment under test) has been tested to determine conformity with the relevant emissions parts of the FCC’s Title 47 CFR Part 15 Subpart B Class B for home or commercial use - section 15.107 for conducted and section 15.109 for radiated - and ICES-003 Issue 6 Class B for Canada.

AC Power line conducted and radiated field strength measurements concerning the emission of radiated and conducted electromagnetic disturbances were made.

EMI Test Lab LLC Electro Magnetic Interference Testing

EmiTestLab.com

Test Specification: Title 47 CFR Part 15 and ICES-003 Prepared by EMI Test Lab - EMITestLab.com Model Name of EUT: TAZ WORKHORSE
Manufacturer: Aleph Objects Inc. | Revision 1.0
Page 10 of 44

### 2.1 AC Mains Power Input Ports

The disturbance voltage emissions levels at the AC mains power port of the EUT were measured in conformity with and according to the criteria as stated below.
Basic standard | : | FCC Part 15, Subpart B, ICES-003 Issue 6
Test method | : | ANSI C63.4-2014, CAN/CSA – CISPR 22-10
Frequency range 1 | : | 0.15 – 0.5 MHz
Limit | : | 66 dBuV quasi peak, 56 dBuV average
| | Decreasing with the log of frequency to range 2
Frequency range 2 | : | 0.5 – 5 MHz
Limit | : | 56 dBuV quasi peak, 46 dBuV average
Frequency range 3 | : | 5 – 30 MHz
Limit | : | 60 dBuV quasi peak, 50 dBuV average
Results of the measurements concerning the emissions of voltage levels at the AC mains input port of the EUT. | PASS Class B for home or commercial use
Name of Test Engineer: Signature: Date: | Dennis King 27 May 2019

Remarks.
The EUT is plugged into the LISN powered at 120 VAC 60 Hz.

Conducted Emission Summary:
The EUT passes both the quasi peak and the average limits. | PASS

EMI Test Lab LLC Electro Magnetic Interference Testing

EmiTestLab.com

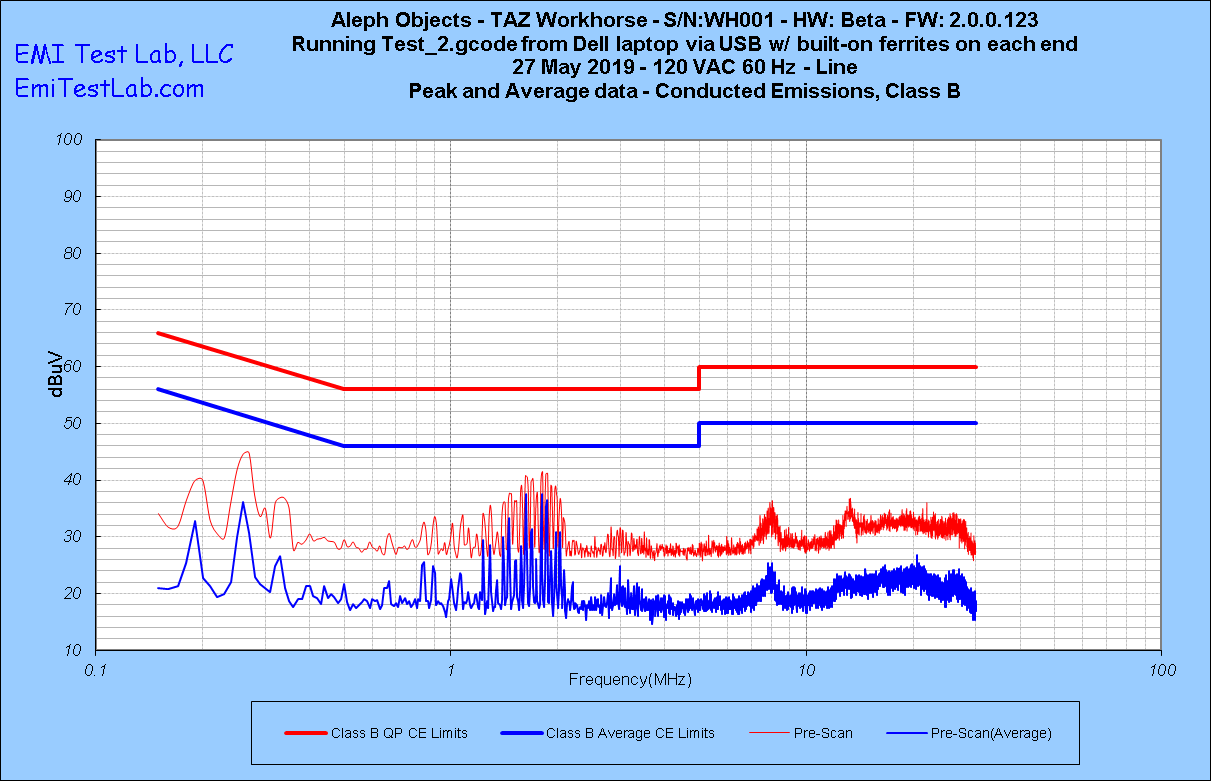
[picture p73: figure]

Test Specification: Title 47 CFR Part 15 and ICES-003 Prepared by EMI Test Lab - EMITestLab.com Model Name of EUT: TAZ WORKHORSE
Manufacturer: Aleph Objects Inc. | Revision 1.0
Page 11 of 44

### Peak Data – Line - usb connected to laptop see the following page for passing quasi peak data

EMI Test Lab LLC Electro Magnetic Interference Testing

EmiTestLab.com

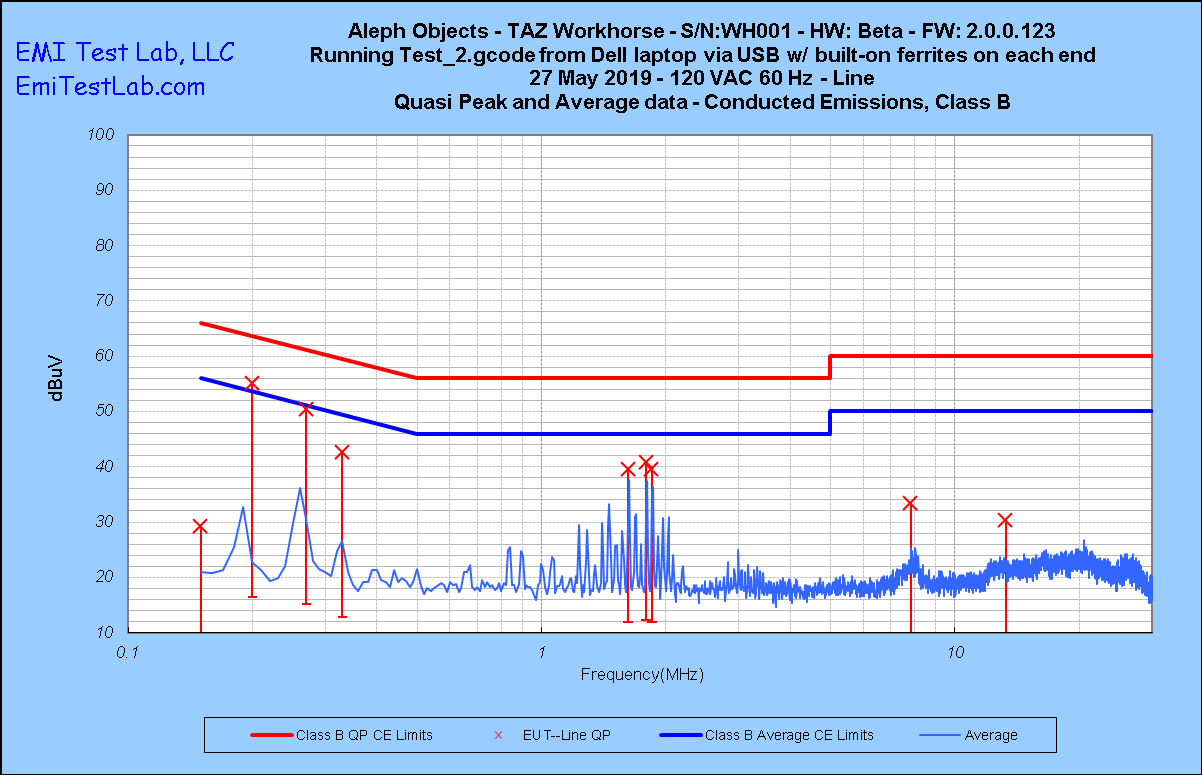
[picture p74: figure]

Test Specification: Title 47 CFR Part 15 and ICES-003 Prepared by EMI Test Lab - EMITestLab.com Model Name of EUT: TAZ WORKHORSE
Manufacturer: Aleph Objects Inc. | Revision 1.0
Page 12 of 44

### Quasi Peak Data – Line – usb connected to laptop

Frequency (MHz) | QP Disturbance (dBuV) | QP Limit | EUT--Line QP | Tranducer Connection | Correction Factor (dB)
0.150 | 34.60 | 66.00 | 31.40 | AMN | 0.20
1.620 | 39.47 | 56.00 | 16.53 | AMN | 0.92
1.850 | 39.48 | 56.00 | 16.52 | AMN | 0.93
1.790 | 40.73 | 56.00 | 15.27 | AMN | 0.93
7.820 | 33.41 | 60.00 | 26.59 | AMN | 1.13
13.260 | 30.31 | 60.00 | 29.69 | AMN | 1.25
0.204 | 55.12 | 64.45 | 9.33 | AMN | 0.22
0.272 | 50.43 | 62.53 | 12.09 | AMN | 0.23
0.339 | 42.65 | 60.60 | 17.95 | AMN | 0.25

EMI Test Lab LLC Electro Magnetic Interference Testing

EmiTestLab.com

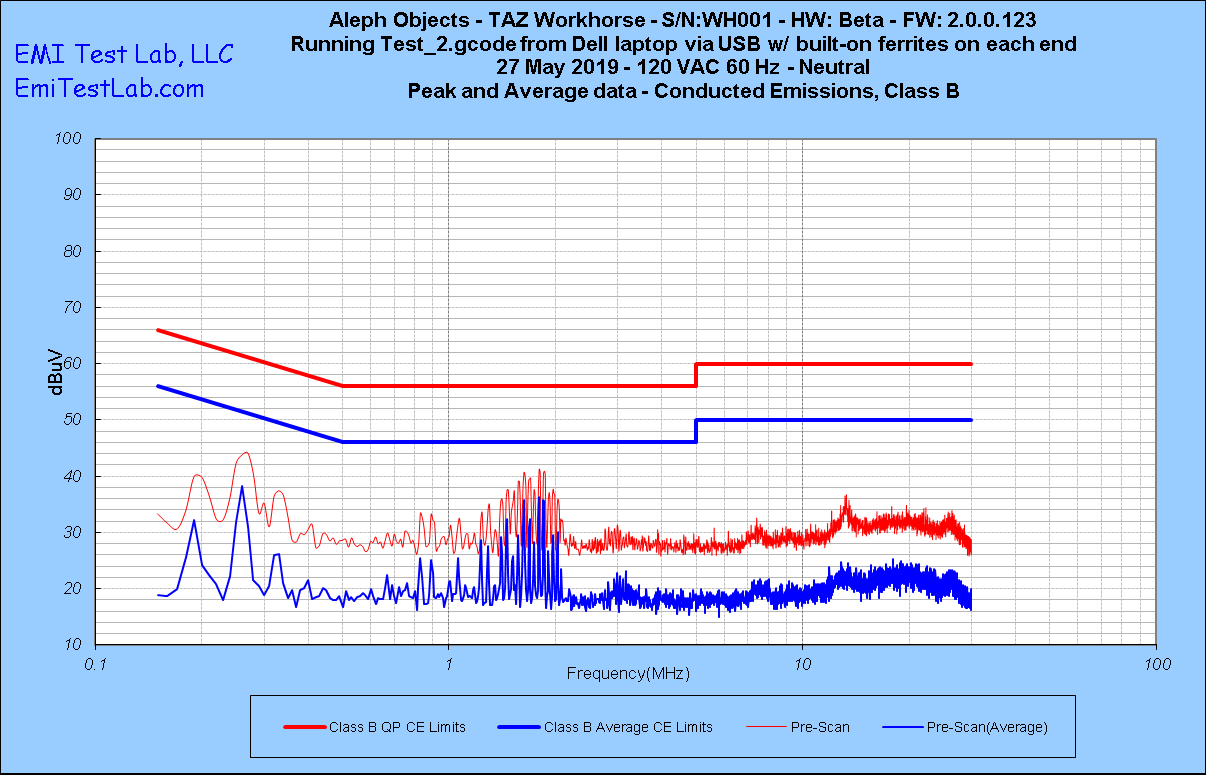
[picture p75: figure]

Test Specification: Title 47 CFR Part 15 and ICES-003 Prepared by EMI Test Lab - EMITestLab.com Model Name of EUT: TAZ WORKHORSE
Manufacturer: Aleph Objects Inc. | Revision 1.0
Page 13 of 44

### Peak Data – Neutral – usb connected to laptop - see the following page for passing quasi peak data

EMI Test Lab LLC Electro Magnetic Interference Testing

EmiTestLab.com

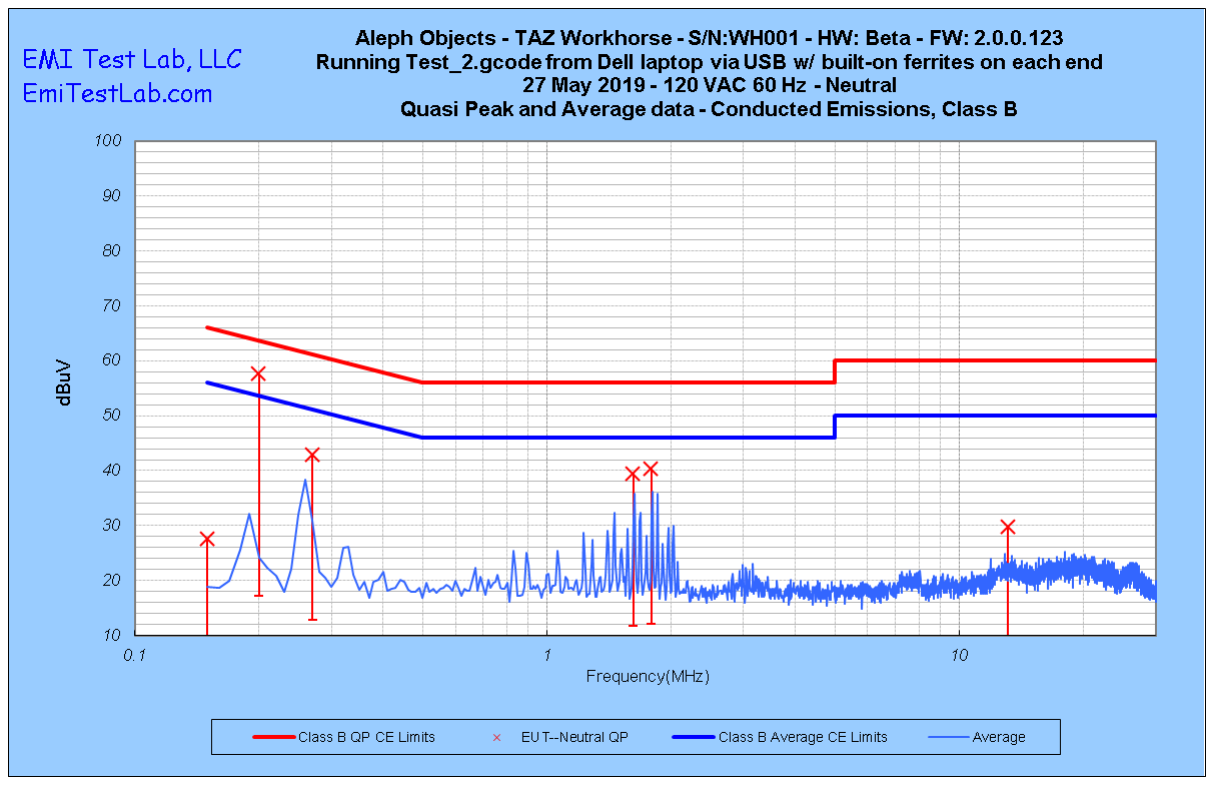
[picture p76: figure]

Test Specification: Title 47 CFR Part 15 and ICES-003 Prepared by EMI Test Lab - EMITestLab.com Model Name of EUT: TAZ WORKHORSE
Manufacturer: Aleph Objects Inc. | Revision 1.0
Page 14 of 44

### Quasi Peak Data – Neutral – usb connected to laptop

Frequency (MHz) | QP Disturbance (dBuV) | QP Limit | EUT--Line QP | Tranducer Connection | Correction Factor (dB)
0.150 | 34.90 | 66.00 | 31.10 | AMN | 0.20
0.270 | 42.79 | 62.57 | 19.78 | AMN | 0.23
1.620 | 39.36 | 56.00 | 16.64 | AMN | 0.92
1.790 | 40.44 | 56.00 | 15.56 | AMN | 0.93
1.790 | 40.34 | 56.00 | 15.66 | AMN | 0.93
13.130 | 29.63 | 60.00 | 30.37 | AMN | 1.25
0.204 | 57.58 | 64.46 | 6.88 | AMN | 0.22

EMI Test Lab LLC Electro Magnetic Interference Testing

EmiTestLab.com

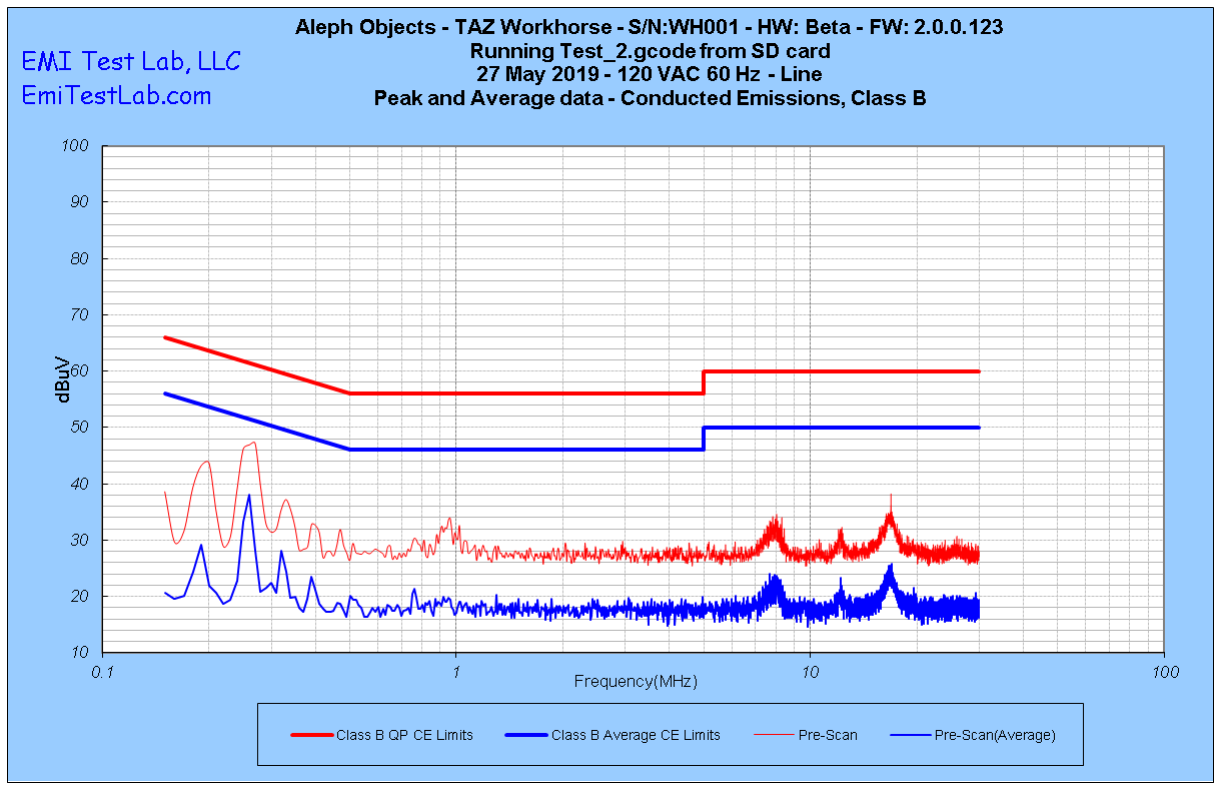
[picture p77: figure]

Test Specification: Title 47 CFR Part 15 and ICES-003 Prepared by EMI Test Lab - EMITestLab.com Model Name of EUT: TAZ WORKHORSE
Manufacturer: Aleph Objects Inc. | Revision 1.0
Page 15 of 44

### Peak Data – Line – running from sd card - see the following page for passing quasi peak data

EMI Test Lab LLC Electro Magnetic Interference Testing

EmiTestLab.com

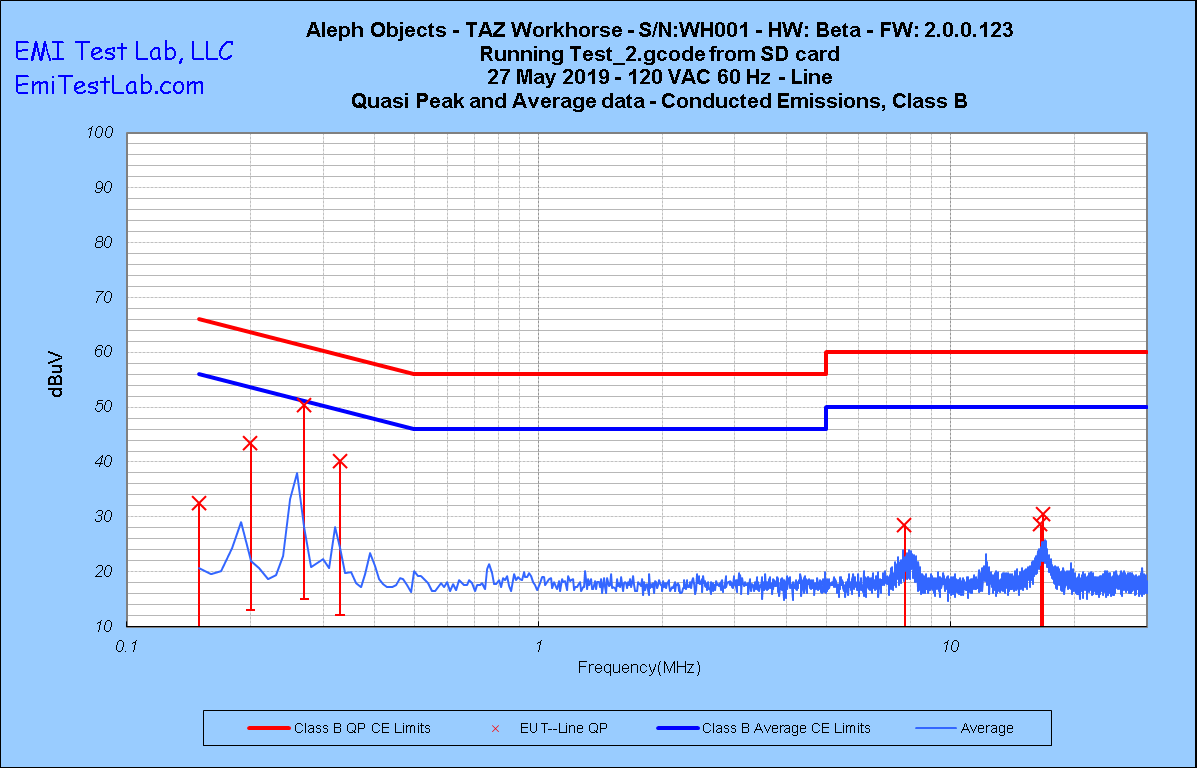
[picture p78: figure]

Test Specification: Title 47 CFR Part 15 and ICES-003 Prepared by EMI Test Lab - EMITestLab.com Model Name of EUT: TAZ WORKHORSE
Manufacturer: Aleph Objects Inc. | Revision 1.0
Page 16 of 44

### Quasi Peak Data – Line – running from sd card

Frequency (MHz) | QP Disturbance (dBuV) | QP Limit | EUT--Line QP | Tranducer Connection | Correction Factor (dB)
0.150 | 36.60 | 66.00 | 29.40 | AMN | 0.20
0.270 | 43.11 | 62.57 | 19.46 | AMN | 0.23
0.270 | 43.03 | 62.57 | 19.54 | AMN | 0.23
7.740 | 28.42 | 60.00 | 31.58 | AMN | 1.12
16.560 | 28.60 | 60.00 | 31.40 | AMN | 1.30
16.800 | 30.40 | 60.00 | 29.60 | AMN | 1.30
0.338 | 40.15 | 60.63 | 20.47 | AMN | 0.25
0.273 | 50.24 | 62.49 | 12.25 | AMN | 0.24

EMI Test Lab LLC Electro Magnetic Interference Testing

EmiTestLab.com

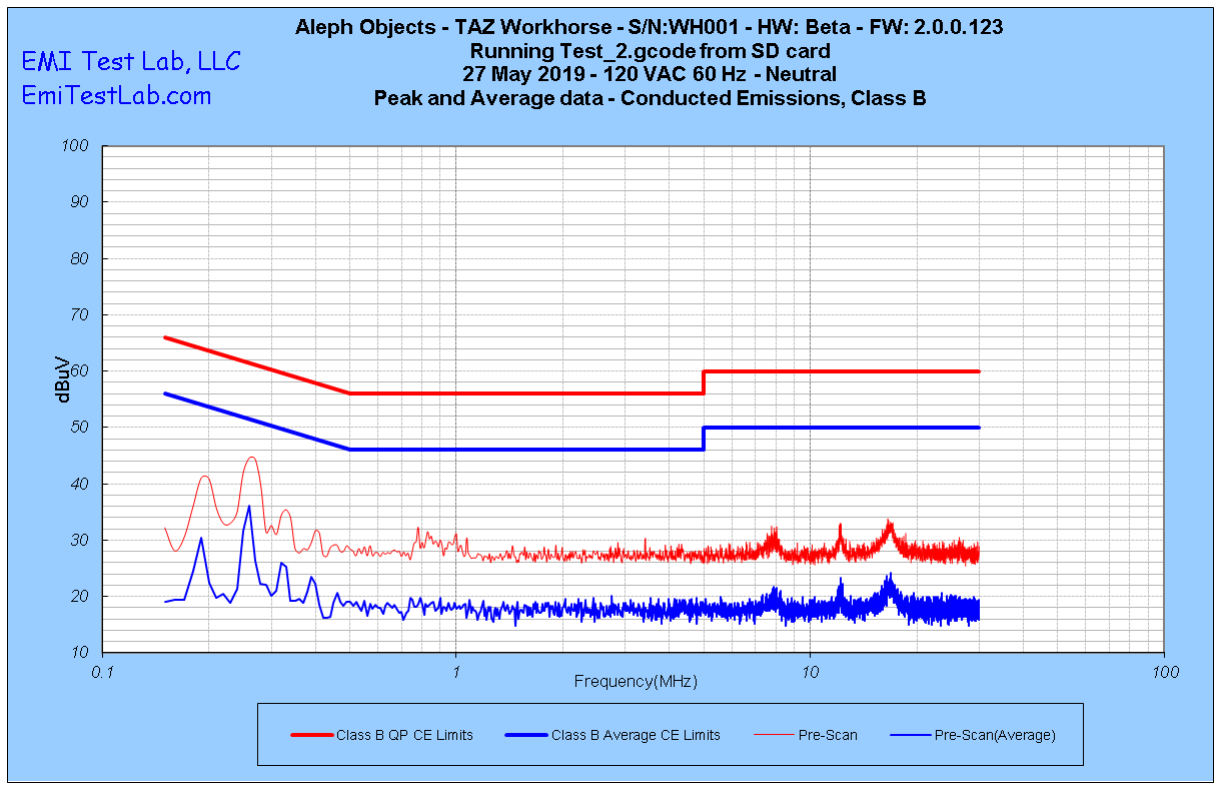
[picture p79: figure]

Test Specification: Title 47 CFR Part 15 and ICES-003 Prepared by EMI Test Lab - EMITestLab.com Model Name of EUT: TAZ WORKHORSE
Manufacturer: Aleph Objects Inc. | Revision 1.0
Page 17 of 44

### Peak Data – Neutral – running from sd card - see the following page for passing quasi peak data

EMI Test Lab LLC Electro Magnetic Interference Testing

EmiTestLab.com

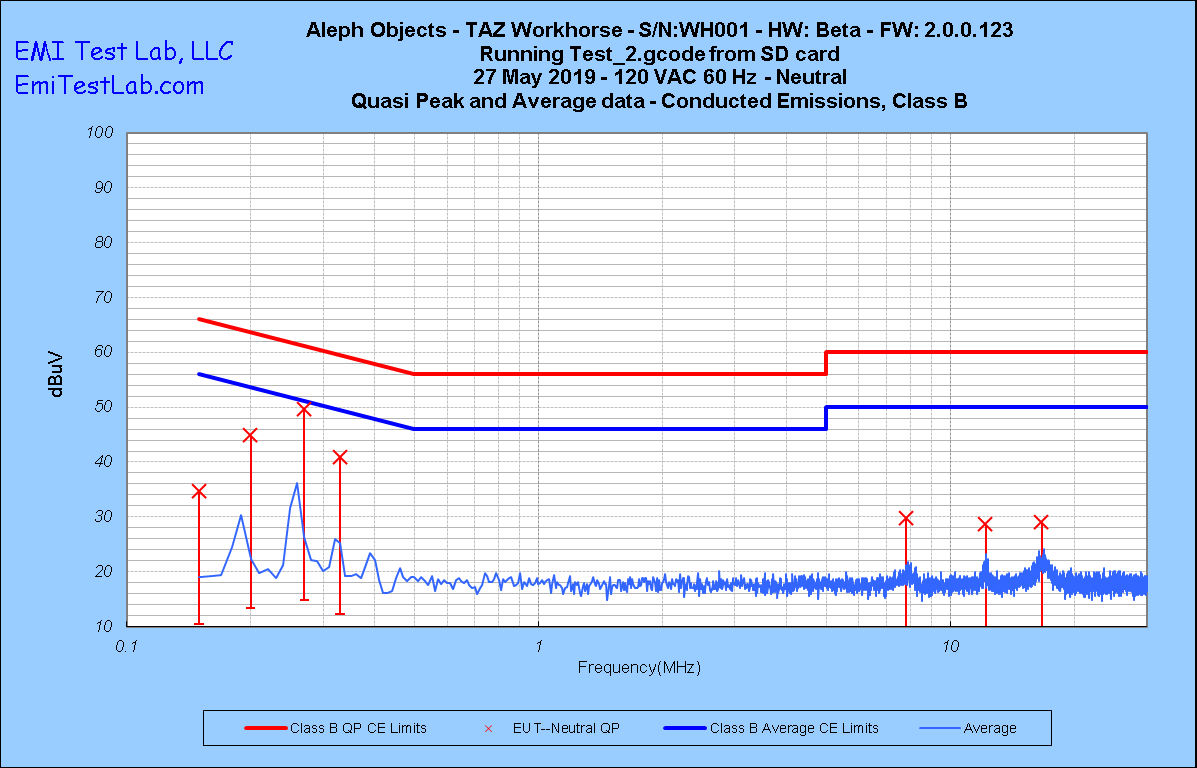
[picture p80: figure]

Test Specification: Title 47 CFR Part 15 and ICES-003 Prepared by EMI Test Lab - EMITestLab.com Model Name of EUT: TAZ WORKHORSE
Manufacturer: Aleph Objects Inc. | Revision 1.0
Page 18 of 44

### Quasi Peak Data – Neutral – running from sd card

Frequency (MHz) | QP Disturbance (dBuV) | QP Limit | EUT--Line QP | Tranducer Connection | Correction Factor (dB)
0.150 | 36.90 | 66.00 | 29.10 | AMN | 0.20
7.820 | 29.64 | 60.00 | 30.36 | AMN | 1.13
12.190 | 28.53 | 60.00 | 31.47 | AMN | 1.23
16.680 | 29.00 | 60.00 | 31.00 | AMN | 1.30
0.203 | 44.82 | 64.48 | 19.66 | AMN | 0.22
0.272 | 49.63 | 62.53 | 12.89 | AMN | 0.23
0.339 | 40.75 | 60.59 | 19.83 | AMN | 0.25

EMI Test Lab LLC Electro Magnetic Interference Testing

EmiTestLab.com

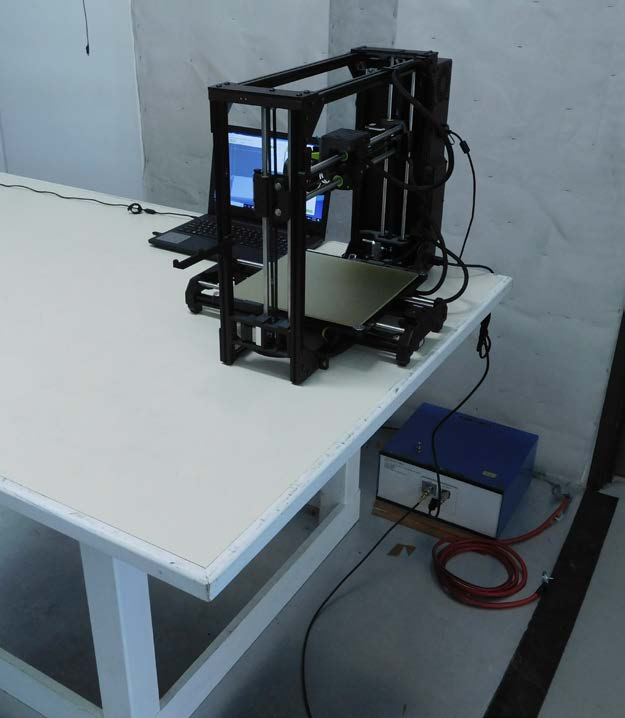
[picture p81: figure]

Test Specification: Title 47 CFR Part 15 and ICES-003 Prepared by EMI Test Lab - EMITestLab.com Model Name of EUT: TAZ WORKHORSE
Manufacturer: Aleph Objects Inc. | Revision 1.0
Page 19 of 44

Conducted emissions test setup – connected through usb cable

EMI Test Lab LLC Electro Magnetic Interference Testing

EmiTestLab.com

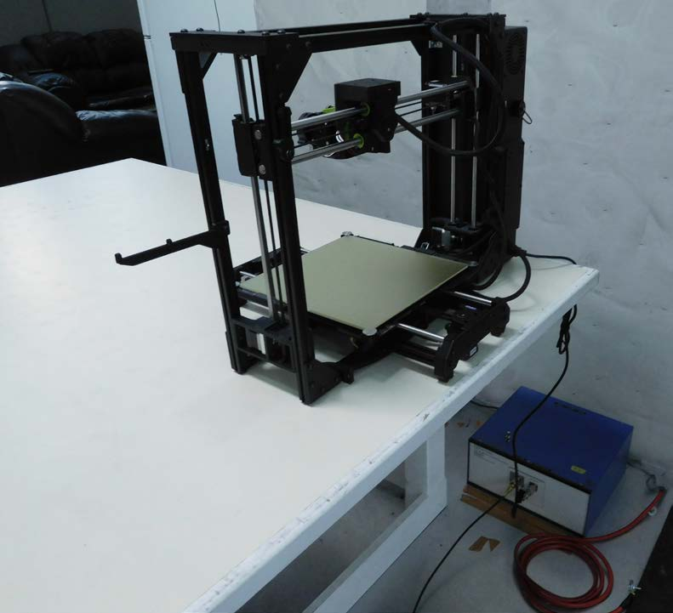
[picture p82: figure]

Test Specification: Title 47 CFR Part 15 and ICES-003 Prepared by EMI Test Lab - EMITestLab.com Model Name of EUT: TAZ WORKHORSE
Manufacturer: Aleph Objects Inc. | Revision 1.0
Page 20 of 44

Conducted emissions test setup – running from sd card

EMI Test Lab LLC Electro Magnetic Interference Testing

EmiTestLab.com

Test Specification: Title 47 CFR Part 15 and ICES-003 Prepared by EMI Test Lab - EMITestLab.com Model Name of EUT: TAZ WORKHORSE
Manufacturer: Aleph Objects Inc. | Revision 1.0
Page 21 of 44

### 2.2 Enclosure

2.2.1 30-1,000 MHz
The radiated field strength levels (electric component) have been measured in conformity with and according to the criteria as stated below.
Basic standard | : | FCC Part 15, Subpart B, ICES-003 Issue 6
Test method | : | ANSI C63.4-2014, CAN/CSA – CISPR 22-10
Limit distance | : | 3 meters
Frequency range 1 | : | 30 -230 MHz
Limits | : | 40 dBuV/m
Frequency range 2 | : | 230 – 1,000 MHz
Limits | : | 47 dBuV/m
Results of the measurements concerning radiated electromagnetic fields (electric component) emitted by the EUT, enclosure, as a tested system | PASS Class B for home or commercial use
Name of Test Engineer: Signature: Date: | Dennis King 24 May 2019
Radiated Emissions Summary: | PASS Class B
Remarks: 120 VAC 60 Hz
Max frequency or data rate is less than 108 MHz

EMI Test Lab LLC Electro Magnetic Interference Testing

EmiTestLab.com

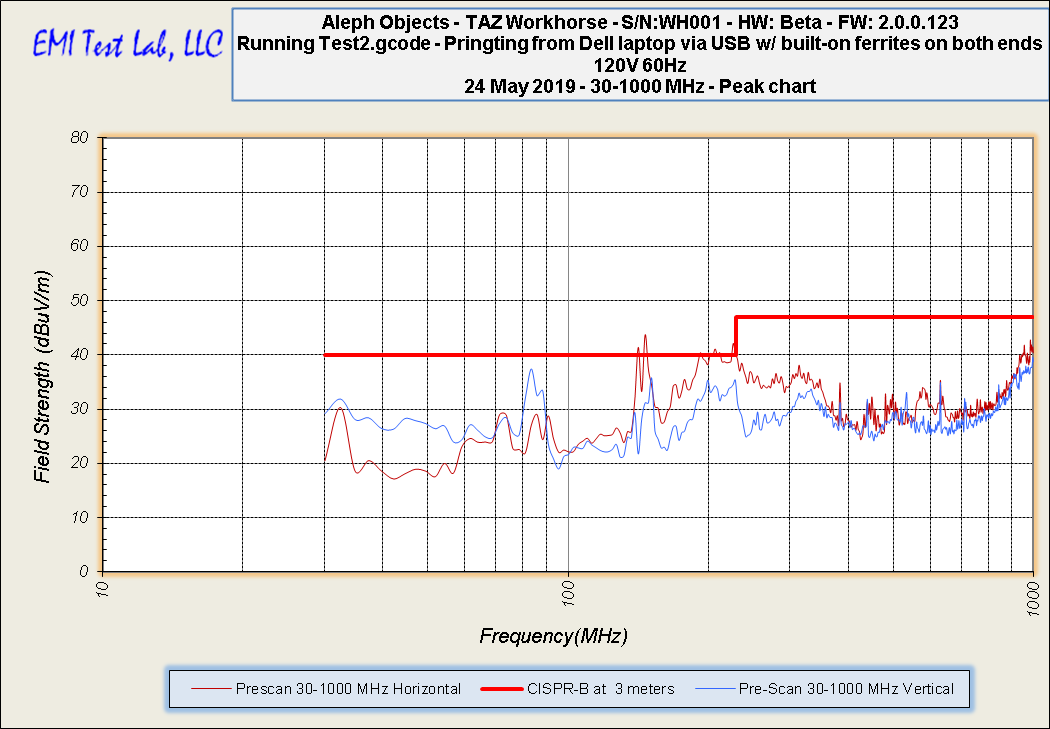
[picture p83: figure]

Test Specification: Title 47 CFR Part 15 and ICES-003 Prepared by EMI Test Lab - EMITestLab.com Model Name of EUT: TAZ WORKHORSE
Manufacturer: Aleph Objects Inc. | Revision 1.0
Page 22 of 44

The chart below is peak data compared to a quasi-peak limit – connected through the usb cable to a laptop See the Quasi peak data for passing results

The above chart is corrected peak data;
Spectrum Analyzer reading + Cable loss + Antenna Factor – pre-amp gain

EMI Test Lab LLC Electro Magnetic Interference Testing

EmiTestLab.com

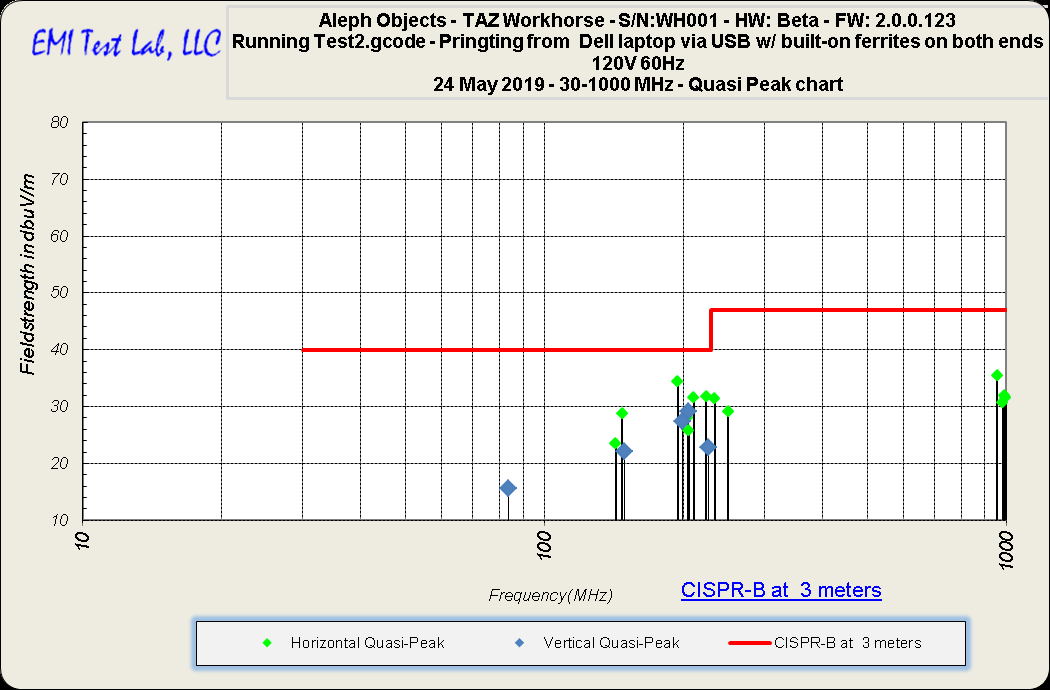
[picture p84: figure]

Test Specification: Title 47 CFR Part 15 and ICES-003 Prepared by EMI Test Lab - EMITestLab.com Model Name of EUT: TAZ WORKHORSE
Manufacturer: Aleph Objects Inc. | Revision 1.0
Page 23 of 44

The chart below is quasi peak data compared to a quasi-peak limit connected through the usb cable to a laptop

The above chart is corrected quasi peak data;
Spectrum Analyzer reading + Cable loss + Antenna Factor – pre-amp gain

EMI Test Lab LLC Electro Magnetic Interference Testing

EmiTestLab.com

Test Specification: Title 47 CFR Part 15 and ICES-003 Prepared by EMI Test Lab - EMITestLab.com Model Name of EUT: TAZ WORKHORSE
Manufacturer: Aleph Objects Inc. | Revision 1.0
Page 24 of 44

Quasi Peak Data
connected through the usb cable to a laptop

Sheet4

Frequency | Field Strength EUT | Limit | Azimuth | Height | Antenna Polarization | Delta from the Limit
(MHz) | (dBuV/m) | (dBuV/m) | Degrees | meters | H or V | dB micro volts
83.63 | 15.66 | 40 | 92.0 | 1.4 | V | -24.34
226.36 | 22.79 | 40 | 148.0 | 1.4 | V | -17.21
205.44 | 29.08 | 40 | 280.0 | 1.4 | V | -10.92
149.10 | 22.11 | 40 | 304.0 | 1.4 | V | -17.89
199.00 | 27.33 | 40 | 348.0 | 1.4 | V | -12.67
984.45 | 30.65 | 47 | 0.0 | 1.4 | H | -16.35
142.86 | 23.55 | 40 | 4.0 | 1.4 | H | -16.45
147.38 | 28.80 | 40 | 48.0 | 1.4 | H | -11.2
204.36 | 28.11 | 40 | 84.0 | 1.4 | H | -11.89
224.05 | 31.80 | 40 | 108.0 | 1.4 | H | -8.2
194.25 | 34.44 | 40 | 140.0 | 1.4 | H | -5.56
990.89 | 31.91 | 47 | 152.0 | 1.4 | H | -15.09
998.83 | 31.61 | 47 | 156.0 | 1.4 | H | -15.39
955.99 | 35.40 | 47 | 232.0 | 1.4 | H | -11.6
250.04 | 29.16 | 47 | 268.0 | 1.4 | H | -17.84
205.61 | 25.85 | 40 | 280.0 | 1.4 | H | -14.15
234.09 | 31.50 | 47 | 284.0 | 1.4 | H | -15.5
210.39 | 31.67 | 40 | 288.0 | 1.4 | H | -8.33

### EMI Test Lab

EMI Test Lab LLC Electro Magnetic Interference Testing

EmiTestLab.com

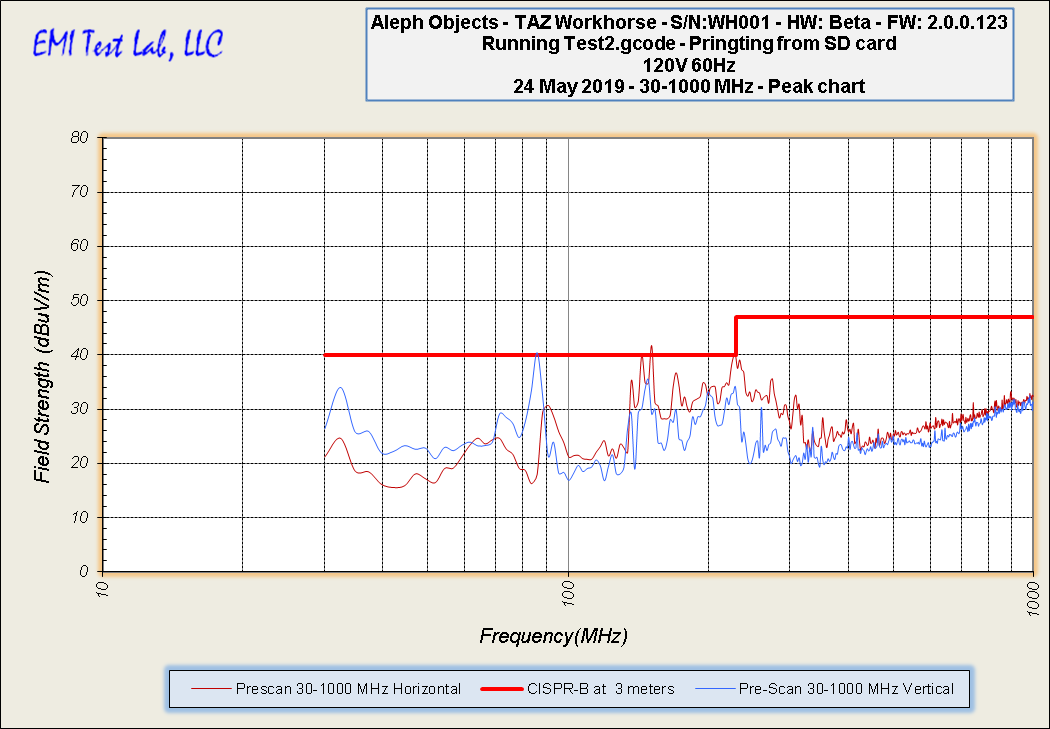
[picture p85: figure]

Test Specification: Title 47 CFR Part 15 and ICES-003 Prepared by EMI Test Lab - EMITestLab.com Model Name of EUT: TAZ WORKHORSE
Manufacturer: Aleph Objects Inc. | Revision 1.0
Page 25 of 44

The chart below is peak data compared to a quasi-peak limit – Running from the SD Card
See the Quasi peak data for passing results

The above chart is corrected peak data;
Spectrum Analyzer reading + Cable loss + Antenna Factor – pre-amp gain

EMI Test Lab LLC Electro Magnetic Interference Testing

EmiTestLab.com

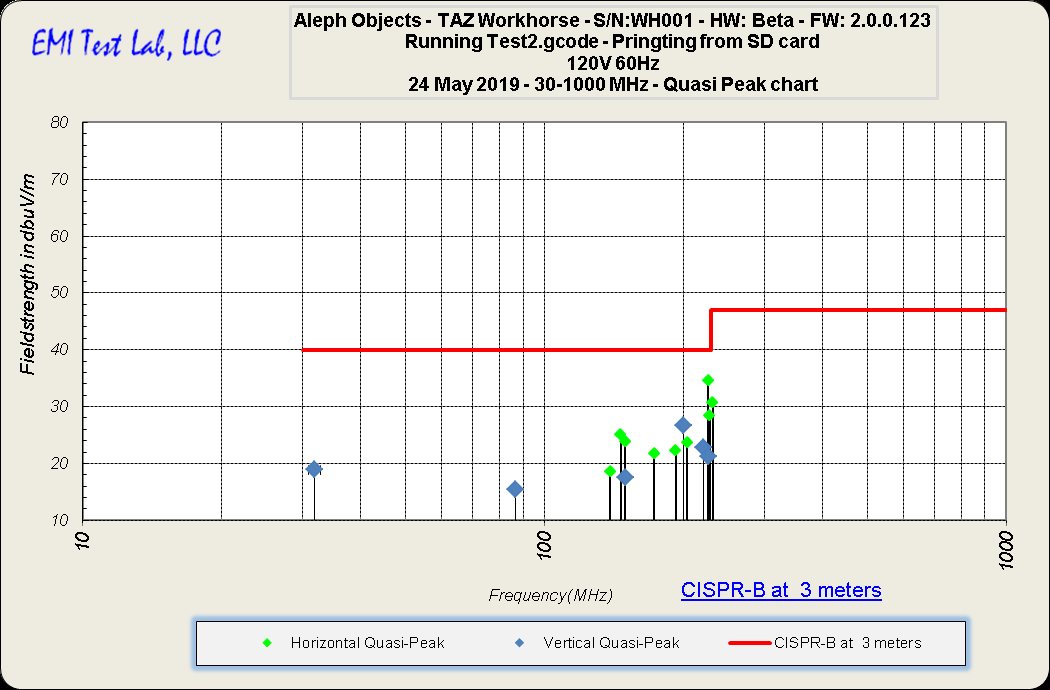
[picture p86: figure]

Test Specification: Title 47 CFR Part 15 and ICES-003 Prepared by EMI Test Lab - EMITestLab.com Model Name of EUT: TAZ WORKHORSE
Manufacturer: Aleph Objects Inc. | Revision 1.0
Page 26 of 44

The chart below is quasi peak data compared to a quasi-peak limit Running from the SD Card

The above chart is corrected quasi peak data;
Spectrum Analyzer reading + Cable loss + Antenna Factor – pre-amp gain

EMI Test Lab LLC Electro Magnetic Interference Testing

EmiTestLab.com

Test Specification: Title 47 CFR Part 15 and ICES-003 Prepared by EMI Test Lab - EMITestLab.com Model Name of EUT: TAZ WORKHORSE
Manufacturer: Aleph Objects Inc. | Revision 1.0
Page 27 of 44

Quasi Peak Data
Running from the SD Card

Sheet4

Frequency | Field Strength EUT | Limit | Azimuth | Height | Antenna Polarization | Delta from the Limit
(MHz) | (dBuV/m) | (dBuV/m) | Degrees | meters | H or V | dB micro volts
31.78 | 18.86 | 40 | 28.0 | 1.4 | V | -21.14
226.38 | 21.17 | 40 | 148.0 | 1.4 | V | -18.83
220.96 | 22.74 | 40 | 156.0 | 1.4 | V | -17.26
150.36 | 17.43 | 40 | 164.0 | 1.4 | V | -22.57
86.40 | 15.38 | 40 | 168.0 | 1.4 | V | -24.62
200.19 | 26.69 | 40 | 188.0 | 1.4 | V | -13.31
192.61 | 22.30 | 40 | 12.0 | 1.4 | H | -17.7
149.55 | 23.87 | 40 | 12.0 | 1.4 | H | -16.13
146.43 | 25.00 | 40 | 24.0 | 1.4 | H | -15
231.44 | 30.69 | 47 | 68.0 | 1.4 | H | -16.31
228.10 | 28.45 | 40 | 148.0 | 1.4 | H | -11.55
204.15 | 23.60 | 40 | 212.0 | 1.4 | H | -16.4
138.98 | 18.50 | 40 | 304.0 | 1.4 | H | -21.5
172.98 | 21.74 | 40 | 308.0 | 1.4 | H | -18.26
226.28 | 34.67 | 40 | 348.0 | 1.4 | H | -5.33

## EMI Test Lab

EMI Test Lab LLC Electro Magnetic Interference Testing

EmiTestLab.com

Test Specification: Title 47 CFR Part 15 and ICES-003 Prepared by EMI Test Lab - EMITestLab.com Model Name of EUT: TAZ WORKHORSE
Manufacturer: Aleph Objects Inc. | Revision 1.0
Page 28 of 44

2.2.2 1 – 40 GHz
The radiated field strength levels (electric component) have been measured in conformity with and according to the criteria as stated below.
Basic standard | : | FCC Part 15, Subpart B, ICES-003 Issue 6
Test method | : | ANSI C63.4-2014, CAN/CSA – CISPR 22-10
Limit distance | : | 3 meters
Frequency range | : | 1-40 GHz
Limits | : | Average 54 dBuV/m, Peak 74 dBuV/m
Results of the measurements concerning radiated electromagnetic fields (electric component) emitted by the EUT, enclosure, as a tested system | Not Required Highest frequency clock is less than 108 MHz
Name of Test Engineer: Signature: Date: | Dennis King 27 May 2019

Remarks:
The highest frequency clock is < 108 MHz. Not required data for information only.

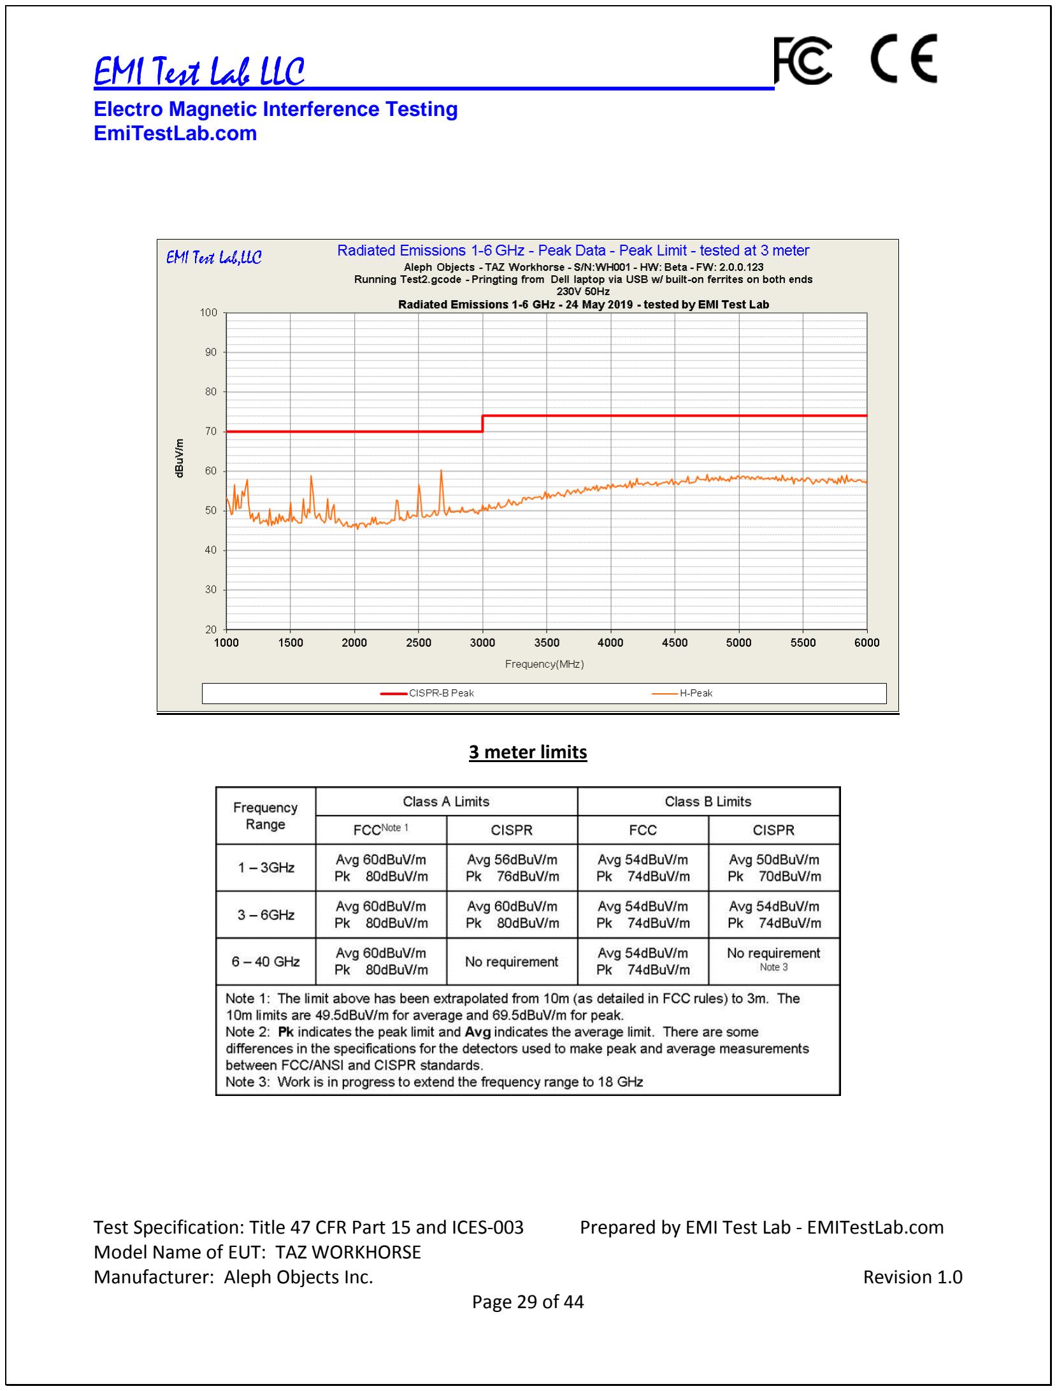
[picture p87: page 29]

EMI Test Lab LLC Electro Magnetic Interference Testing

EmiTestLab.com

Test Specification: Title 47 CFR Part 15 and ICES-003 Prepared by EMI Test Lab - EMITestLab.com Model Name of EUT: TAZ WORKHORSE
Manufacturer: Aleph Objects Inc. | Revision 1.0
Page 29 of 44

### 3 meter limits

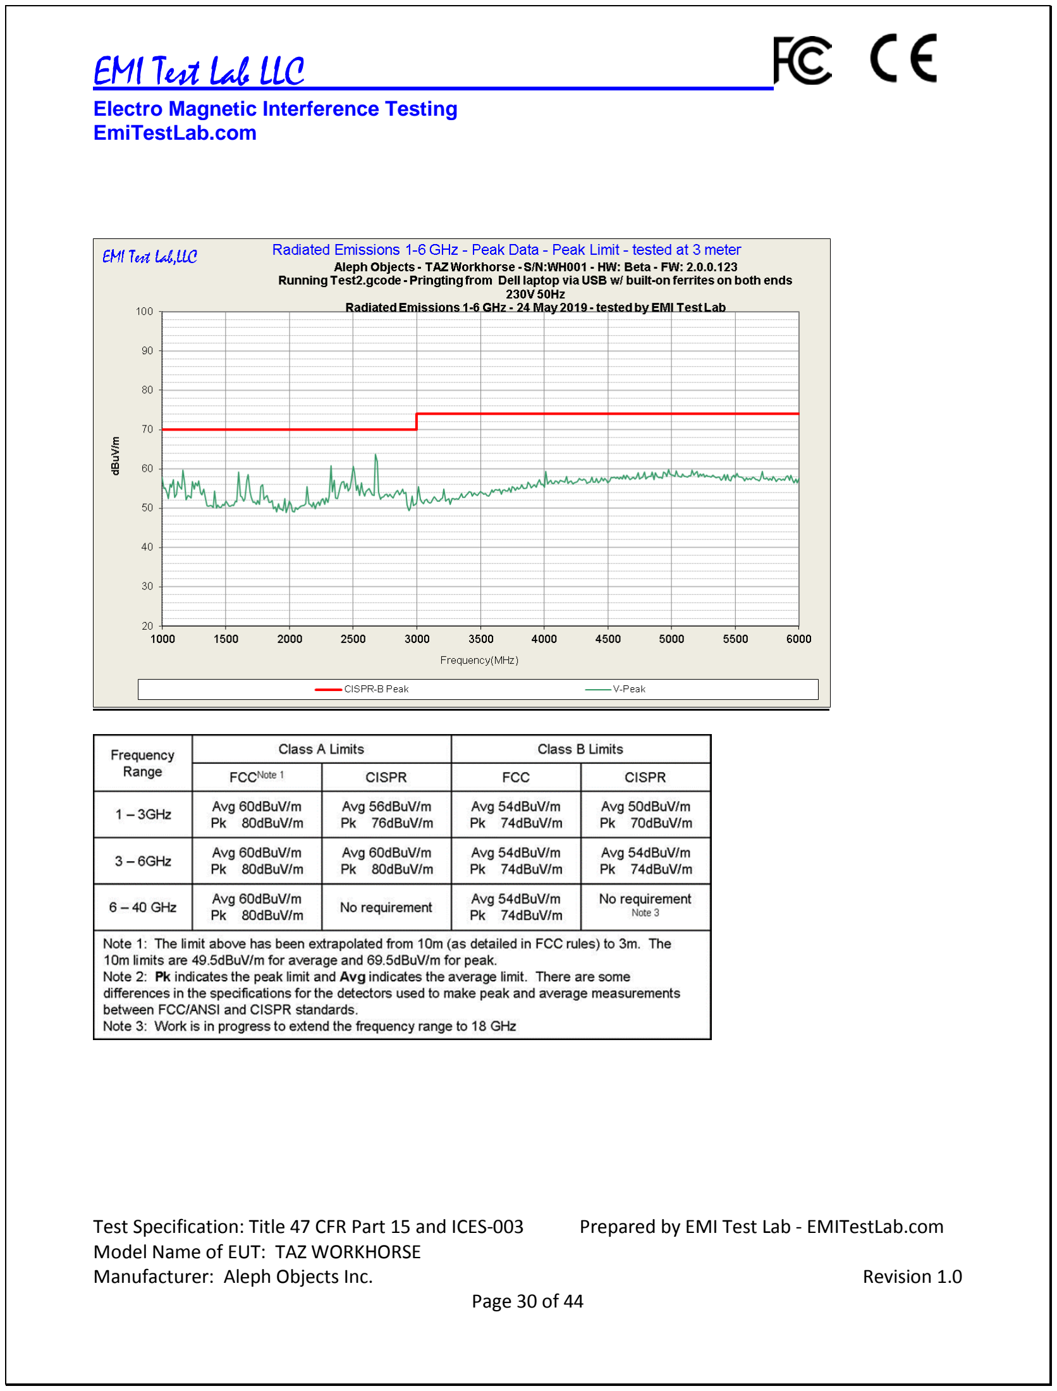
[picture p88: page 30]

EMI Test Lab LLC Electro Magnetic Interference Testing

EmiTestLab.com

Test Specification: Title 47 CFR Part 15 and ICES-003 Prepared by EMI Test Lab - EMITestLab.com Model Name of EUT: TAZ WORKHORSE
Manufacturer: Aleph Objects Inc. | Revision 1.0
Page 30 of 44

EMI Test Lab LLC Electro Magnetic Interference Testing

EmiTestLab.com

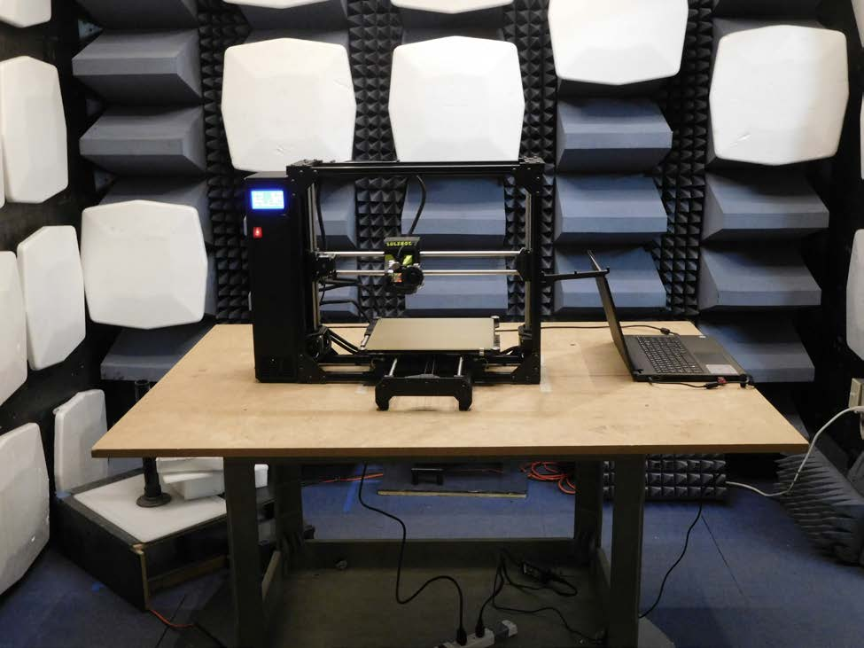
[picture p89: figure]

Test Specification: Title 47 CFR Part 15 and ICES-003 Prepared by EMI Test Lab - EMITestLab.com Model Name of EUT: TAZ WORKHORSE
Manufacturer: Aleph Objects Inc. | Revision 1.0
Page 31 of 44

Test setup for Radiated Emissions - usb

EMI Test Lab LLC Electro Magnetic Interference Testing

EmiTestLab.com


Test Specification: Title 47 CFR Part 15 and ICES-003 Prepared by EMI Test Lab - EMITestLab.com Model Name of EUT: TAZ WORKHORSE
Manufacturer: Aleph Objects Inc. | Revision 1.0
Page 32 of 44

Test setup for Radiated Emissions – SD Card

EMI Test Lab LLC Electro Magnetic Interference Testing

EmiTestLab.com


Test Specification: Title 47 CFR Part 15 and ICES-003 Prepared by EMI Test Lab - EMITestLab.com Model Name of EUT: TAZ WORKHORSE
Manufacturer: Aleph Objects Inc. | Revision 1.0
Page 33 of 44

Test setup for Radiated Emissions – SD card – 1- 6 GHz Horn antenna

EMI Test Lab LLC Electro Magnetic Interference Testing

EmiTestLab.com

Test Specification: Title 47 CFR Part 15 and ICES-003 Prepared by EMI Test Lab - EMITestLab.com Model Name of EUT: TAZ WORKHORSE
Manufacturer: Aleph Objects Inc. | Revision 1.0
Page 34 of 44

## 3.0 Modifications

No modifications were made during the testing.

EMI Test Lab LLC Electro Magnetic Interference Testing

EmiTestLab.com

Test Specification: Title 47 CFR Part 15 and ICES-003 Prepared by EMI Test Lab - EMITestLab.com Model Name of EUT: TAZ WORKHORSE
Manufacturer: Aleph Objects Inc. | Revision 1.0
Page 35 of 44

### 4.0 User Guide Statements and labels

From the FCC’s CFR Part 15 Subpart B
1.1 §15.105 Information to the user.
User Guide Statement
(a) For a Class A digital device or peripheral, the instructions furnished the user shall include the following or similar statement, placed in a prominent location in the text of the manual:

NOTE: This equipment has been tested and found to comply with the limits for a Class A digital device, pursuant to part 15 of the FCC Rules. These limits are designed to provide reasonable protection against harmful interference when the equipment is operated in a commercial environment. This equipment generates, uses, and can radiate radio frequency energy and, if not installed and used in accordance with the instruction manual, may cause harmful interference to radio communications. Operation of this equipment in a residential area is likely to cause harmful interference in which case the user will be required to correct the interference at his own expense.
Modifications not expressly approved by the manufacturer could void the user's authority to operate the equipment under FCC rules.

EMI Test Lab LLC Electro Magnetic Interference Testing

EmiTestLab.com

Test Specification: Title 47 CFR Part 15 and ICES-003 Prepared by EMI Test Lab - EMITestLab.com Model Name of EUT: TAZ WORKHORSE
Manufacturer: Aleph Objects Inc. | Revision 1.0
Page 36 of 44
(b) For a Class B digital device or peripheral, the instructions furnished the user shall include the following or similar statement, placed in a prominent location in the text of the manual:

NOTE: This equipment has been tested and found to comply with the limits for a Class B digital device, pursuant to part 15 of the FCC Rules. These limits are designed to provide reasonable protection against harmful interference in a residential installation. This equipment generates, uses and can radiate radio frequency energy and, if not installed and used in accordance with the instructions, may cause harmful interference to radio communications. However, there is no guarantee that interference will not occur in a particular installation. If this equipment does cause harmful interference to radio or television reception, which can be determined by turning the equipment off and on, the user is encouraged to try to correct the interference by one or more of the following measures:

—Reorient or relocate the receiving antenna.

—Increase the separation between the equipment and receiver.

—Connect the equipment into an outlet on a circuit different from that to which the receiver is connected.

—Consult the dealer or an experienced radio/TV technician for help.
Modifications not expressly approved by the manufacturer could void the user's authority to operate the equipment under FCC rules.

EMI Test Lab LLC Electro Magnetic Interference Testing

EmiTestLab.com

Test Specification: Title 47 CFR Part 15 and ICES-003 Prepared by EMI Test Lab - EMITestLab.com Model Name of EUT: TAZ WORKHORSE
Manufacturer: Aleph Objects Inc. | Revision 1.0
Page 37 of 44

§15.19 Labelling requirements.
(a) In addition to the requirements in part 2 of this chapter, a device subject to certification, or verification shall be labelled as follows:
(1) Receivers associated with the operation of a licensed radio service, e.g., FM broadcast under part 73 of this chapter, land mobile operation under part 90, etc., shall bear the following statement in a conspicuous location on the device:
This device complies with part 15 of the FCC Rules. Operation is subject to the condition that this device does not cause harmful interference.
(2) A stand-alone cable input selector switch, shall bear the following statement in a conspicuous location on the device:
This device is verified to comply with part 15 of the FCC Rules for use with cable television service.
(3) All other devices shall bear the following statement in a conspicuous location on the device:
This device complies with part 15 of the FCC Rules. Operation is subject to the following two conditions:
(1) This device may not cause harmful interference, and (2) this device must accept any interference received, including interference that may cause undesired operation.
(4) Where a device is constructed in two or more sections connected by wires and marketed together, the statement specified under paragraph (a) of this section is required to be affixed only to the main control unit.
(5) When the device is so small or for such use that it is not practicable to place the statement specified under paragraph (a) of this section on it, the information required by this paragraph shall be placed in a prominent location in the instruction manual or pamphlet supplied to the user or, alternatively, shall be placed on the container in which the device is marketed. However, the FCC identifier or the unique identifier, as appropriate, must be displayed on the device.

EMI Test Lab LLC Electro Magnetic Interference Testing

EmiTestLab.com

Test Specification: Title 47 CFR Part 15 and ICES-003 Prepared by EMI Test Lab - EMITestLab.com Model Name of EUT: TAZ WORKHORSE
Manufacturer: Aleph Objects Inc. | Revision 1.0
Page 38 of 44

### Canadian Label requirement From ICES-003 Issue 6 Published: January 2016 Updated: June 2016

### 9. Labelling Requirements

The manufacturer, importer or supplier shall meet the labelling requirements set out in this section and in Notice 2014-DRS1003 for electronic labelling for every unit: (i) prior to marketing in Canada, for ITE manufactured in Canada and (ii) prior to importation into Canada, for imported ITE. Each unit of an ITE model shall bear a label (see below) that represents the manufacturer’s or the importer’s SDoC with Innovation, Science and Economic Development Canada’s ICES-003. This label shall be permanently affixed to the ITE or displayed electronically and its text must be clearly legible. If the dimensions of the device are too small or if it is not practical to place the label on the ITE and electronic labelling has not been implemented, the label shall be, upon agreement with Innovation, Information Technology Equipment (Including Digital Apparatus) — Limits and Methods of Measurement ICES-003 9 Science and Economic Development Canada, placed in a prominent location in the user manual supplied with the ITE. The user manual may be in an electronic format and must be readily available.

Innovation, Science and Economic Development Canada ICES-003 Compliance Label:

CAN ICES-3 (*)/NMB-3(*)

* Insert either “A” or “B” but not both to identify the applicable Class of ITE.

EMI Test Lab LLC Electro Magnetic Interference Testing

EmiTestLab.com

Test Specification: Title 47 CFR Part 15 and ICES-003 Prepared by EMI Test Lab - EMITestLab.com Model Name of EUT: TAZ WORKHORSE
Manufacturer: Aleph Objects Inc. | Revision 1.0
Page 39 of 44

### 5.0 Test equipment and Environmental Conditions

All tests were conducted within parameters specified for each test, for example >30% humidity for ESD. The lab temperature during all testing was between 70-72 degrees F.
All equipment used for testing has been calibrated or verified for cal using NIST traceable standards. Each piece of test equipment has a cal verification procedure that is conducted before and after each test.
Table of Test Equipment
Equipment | Description and Test | Model | Serial number | Next cal due
EMC Compact Tester -Haefely | EFT, Surge, AC Dips and Interrupts | AXOS 5 | 185501 | 28 March 2020
HP Spectrum Analyzer | Used for Radiated and Conducted Emissions | 8566B | 2607A02760 | 3 June 2020
HP Quasi-Peak Adapter | Used for Radiated and Conducted Emissions | 85650A | 8574A00233 | 3 June 2020
HP/Agilent Spectrum Analyzer | Used for Radiated and Conducted Emissions | E7401A | US41110467 | 22 Jan 2021
HP/Agilent Spectrum Analyzer | Used for Radiated Emissions 1-22 GHz | 8593E | 3710A02875 | 9 Jan 2021
HP/Agilent Spectrum Analyzer | Used for Radiated and Conducted Emissions | E7401A | US40240440 | 9 Jan 2021
Com-Power transient Limiter | Conducted Emissions | HZ560 | 001 | 3 June 2020
RF Bay Pre-Amp | Radiated emissions – 100kHz to 10 GHz | LPA-10-20 | 0643 | 12 Dec 2019
GTEM | Radiated Emissions and Radiated Immunity | 5317 | 9703-1209 | 25 April 2020 – Field Uniformity Cal per IEC 61000-4-20
3 Meter FAR – Fully Anechoic Room | Radiated Immunity and Emissions | N/A | FAR #1 | 15 October 2019 Field Uniformity per IEC/EN 61000-4-3 and Correlation data to GTEM
ComPower Horn Antenna | 1-18 GHz – Radiated Immunity and Emissions | AH 118 | 071040 | 20 March 2020
Chase BiLog Antenna | Radiated Emissions and Immunity | CBL6111 | 1121 | 20 March 2020
Marconi Instruments – Signal Generator 10kHz – 2.7 GHz | Radiated Immunity | 2031 | 1196061031 | 20 October 2019
HP Signal Generator | Radiated Immunity | 8657A | STD0578 | 3 May 2020

EMI Test Lab LLC Electro Magnetic Interference Testing

EmiTestLab.com

Test Specification: Title 47 CFR Part 15 and ICES-003 Prepared by EMI Test Lab - EMITestLab.com Model Name of EUT: TAZ WORKHORSE
Manufacturer: Aleph Objects Inc. | Revision 1.0
Page 40 of 44
Amplifier Research .800 – 4.2 GHz Amp | Radiated Immunity – 1 GHz to 2.7 GHz | 10S1G4 | 34516 | 4 May 2020
Antenna Research Associates – 100 Watt amplifier w/controller | Radiated Immunity – 80-1000 MHz in the FAR | ARAPS/PC757LC ARA757LC-CE | 587V7 587V7 | 20 October 2019
Kalmus Power Amplifier | Radiated Immunity 150kHz – 1 GHz – in the GTEM | 747LC-CE | 7894-1 | 12 May 2020
Amplifier Research E- Field Probe | Radiated Immunity | FP 2000 | 12845 | 12 May 2020
Com-Power LISN | Conducted emissions | LI-115 | 241010 | 17 May 2020
Com-Power LISN | Conducted emissions | LI-115 | 241011 | 17 May 2020
California Instruments 1000 VA Power Source | Emissions and Immunity -used as a 100/120/230/240-VAC 50/60 Hz AC source | 1001WP | L04788 | 4 June 2020
EMI Labs CDN | Conducted Immunity | EMICDN | 001 | 9 Dec 2019
Hafely ESD Gun | Electro Static Discharge | ONYX16 | 181726 | 24 June 2020
KeyTek ECAT | Fast transients / Burst | E412 | 32612 | 5 June 2020
FCC Inc. RF Current Probe | Monitor Conducted Immunity signal | F-33-1 | 423 | 9 Dec 2019
EMI Labs Mag Loop | Magnetic Loop Antenna | Mag100 | 80162 | 12 Dec 2019
Thermo Keytek CE Master | Surge/ AC Dips and Interrupts | CE Master | 0405277 | 15 Dec 2019
Audio Frequency Helmholtz Coil – Tektronix Audio Signal Generator and Audio Amplifier Test System | 50 Hz to 10 kHz Magnetic field, homogenous – Immunity test | Audio Magnetic Field Test System | EMI-HH001 | 20 August 2020

EMI Test Lab LLC Electro Magnetic Interference Testing

EmiTestLab.com

Test Specification: Title 47 CFR Part 15 and ICES-003 Prepared by EMI Test Lab - EMITestLab.com Model Name of EUT: TAZ WORKHORSE
Manufacturer: Aleph Objects Inc. | Revision 1.0
Page 41 of 44

6.0 Measurement Uncertainty - Radiated Emissions example;
Table of Uncertainty Calculation
√ | Contribution | Designation | Probability Distribution | k | Uncertainty (dB)
| Equipment Under Test Uncertainties | UEUT | | | Note 1
√ | Measuring Receiver Amplitude Accuracy | URXaccuracy | rectangular | 3 | ± 0.9
√ | GTEM Uniformity | UUniformity | rectangular | 3 | ± 4.0
√ | Secondary Field Components | USecondary | | | Excluded by Test Method
√ | Mismatch Uncertainty-GTEM to Pre-Amplifier | U Mismatch | U-shaped | 2 | +0.63 and -0.65
√ | Mismatch Uncertainty-Pre-Amplifier to Spectrum Analyzer | U Mismatch | U-shaped | 2 | +0.92 and -1.03
√ | System Sensitivity Error | USensitivity | rectangular | 3 | 0.28
√ | GTEM Electric-Field Frequency Response | UE−Field | rectangular | 3 | ± 1.6
| Ambient Signal Uncertainty | U Abient | | | Not Significant
√ | GTEM to OATS Correlation | UCorr | rectangular | 3 | ±1.2
√ | Septum Height Variation | USeptum | normal | 2 | +0.72 and -0.82
| Coaxial Cable Temperature Variations | UCableTemperature | | | Not Significant
√ | Coaxial Cable Calibration | UCableCalibration | rectangular | 3 | ±0.05
√ | Pre-amplifier Calibration Uncertainty | UPr e−Amp | rectangular | 3 | ±0.05
| Combined Uncertainty(dB) Positive Terms | | | | 2.77
| Combined Uncertainty(dB) Negative Terms | | | | -2.75
| Expanded Uncertainty Positive Terms | | Normal | 2 | 5.54
| Expanded Uncertainty Negative Terms | | Normal | 2 | -5.50

EMI Test Lab LLC Electro Magnetic Interference Testing

EmiTestLab.com

Test Specification: Title 47 CFR Part 15 and ICES-003 Prepared by EMI Test Lab - EMITestLab.com Model Name of EUT: TAZ WORKHORSE
Manufacturer: Aleph Objects Inc. | Revision 1.0
Page 42 of 44

Typical Measurement Uncertainty for the following Tests:

The estimated combined standard uncertainty for Conducted Emissions is ± 1.2dB
The estimated combined standard uncertainty for Radiated Immunity, EN 61000-4-3 is ± 2.7dB The estimated combined standard uncertainty for EFT/Burst, EN 61000-4-4 is ± 5.8%
The estimated combined standard uncertainty for Surge, EN 61000-4-5 is ± 8%
The estimated combined standard uncertainty for Conducted Immunity, EN 61000-4-6 is ± 1.5 dB
The estimated combined standard uncertainty for Magnetic Fields, EN 61000-4-8 is ± 0.6%
The estimated combined standard uncertainty for Voltage Dips and Interrupts, EN 61000-4-11 is ± 4.3% The estimated combined standard uncertainty for Harmonic current and flicker is ± 11.6%
The estimated combined standard uncertainty for ESD testing, EN 61000-4-2 is ± 4%

EMI Test Lab LLC Electro Magnetic Interference Testing

EmiTestLab.com

Test Specification: Title 47 CFR Part 15 and ICES-003 Prepared by EMI Test Lab - EMITestLab.com Model Name of EUT: TAZ WORKHORSE
Manufacturer: Aleph Objects Inc. | Revision 1.0
Page 43 of 44

## 7.0 Test Plan

Testing required
The LulzBot TAZ WORKHORSE 3D Printer will be tested for Radiated and Conducted emissions, Harmonics and Flicker and all applicable Immunity tests as required for the EMC portion of the CE Mark and the Australia / New Zealand EMC standards. Previous power supply testing may be used as applicable.

Test Setup
The TAZ WORKHORSE will be operating using test software during all the testing.

The test software will be installed on a usb thumb drive, the program will be loaded from this drive.

The Printer will also be tested while connected and operated from a laptop through the usb cable supplied with the unit.

Failure Criteria
If the unit stops working or the printing process is altered by the injected noise, this would be considered a failure.

I/O cables
The unit has only one I/O cable, the USB cable that is used to control the printer from software installed on the host computer. There are no I/O cables on the unit 3 meters or longer.

Status of the test unit
Beta build.

EMI Test Lab LLC Electro Magnetic Interference Testing

EmiTestLab.com

Test Specification: Title 47 CFR Part 15 and ICES-003 Prepared by EMI Test Lab - EMITestLab.com Model Name of EUT: TAZ WORKHORSE
Manufacturer: Aleph Objects Inc. | Revision 1.0
Page 44 of 44

## 8.0 Conclusion

The Aleph Objects – TAZ Workhorse 3D Printer complies with the emissions standards:

### 1. FCC Part 15 Class B for home or commercial use and 2. Industry Canada’s ICES-003 Class B, also for home or commercial

use.

in the configurations and operating modes as stated in this test report.

End of Report
