joeyliu522/VVI-project/CAD files/Older 3D printed parts/production_docs/qa-records/DC-MS0094.pdf

# PACKING LIST

## Model: LulzBot TAZ Workhorse Desktop 3D Printer

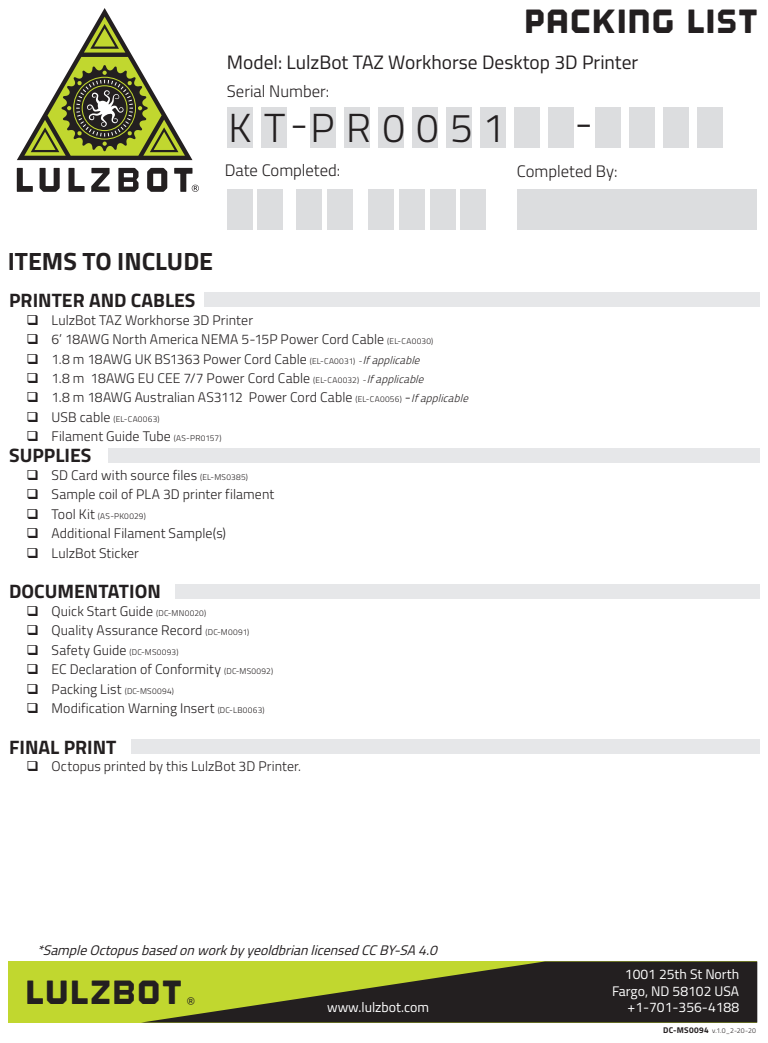
[picture p90: page 1]
www.lulzbot.com; Serial Number:; Date Completed:; Completed By:

ITEMS TO INCLUDE
PRINTER AND CABLES
LulzBot TAZ Workhorse 3D Printer
6’ 18AWG North America NEMA 5-15P Power Cord Cable (EL-CA0030)
1.8 m 18AWG UK BS1363 Power Cord Cable (EL-CA0031) -If applicable
1.8 m 18AWG EU CEE 7/7 Power Cord Cable (EL-CA0032) -If applicable
1.8 m 18AWG Australian AS3112 Power Cord Cable (EL-CA0056) -If applicable
USB cable (EL-CA0063)
Filament Guide Tube (AS-PR0157)
SUPPLIES
SD Card with source files (EL-MS0385)
Sample coil of PLA 3D printer filament
Tool Kit (AS-PK0029)
Additional Filament Sample(s)
LulzBot Sticker
DOCUMENTATION
Quick Start Guide (DC-MN0020)
Quality Assurance Record (DC-M0091)
Safety Guide (DC-MS0093)
EC Declaration of Conformity (DC-MS0092)
Packing List (DC-MS0094)
Modification Warning Insert (DC-LB0063)
FINAL PRINT
Octopus printed by this LulzBot 3D Printer.

*Sample Octopus based on work by yeoldbrian licensed CC BY-SA 4.0
LULZBOT ®

1001 25th St North
Fargo, ND 58102 USA
