joeyliu522/VVI-project/CAD files/Older 3D printed parts/production_parts/electronics/external_harness/EL-HR0142_Z_endstop_harness.pdf

## Note: Unless otherwise specified

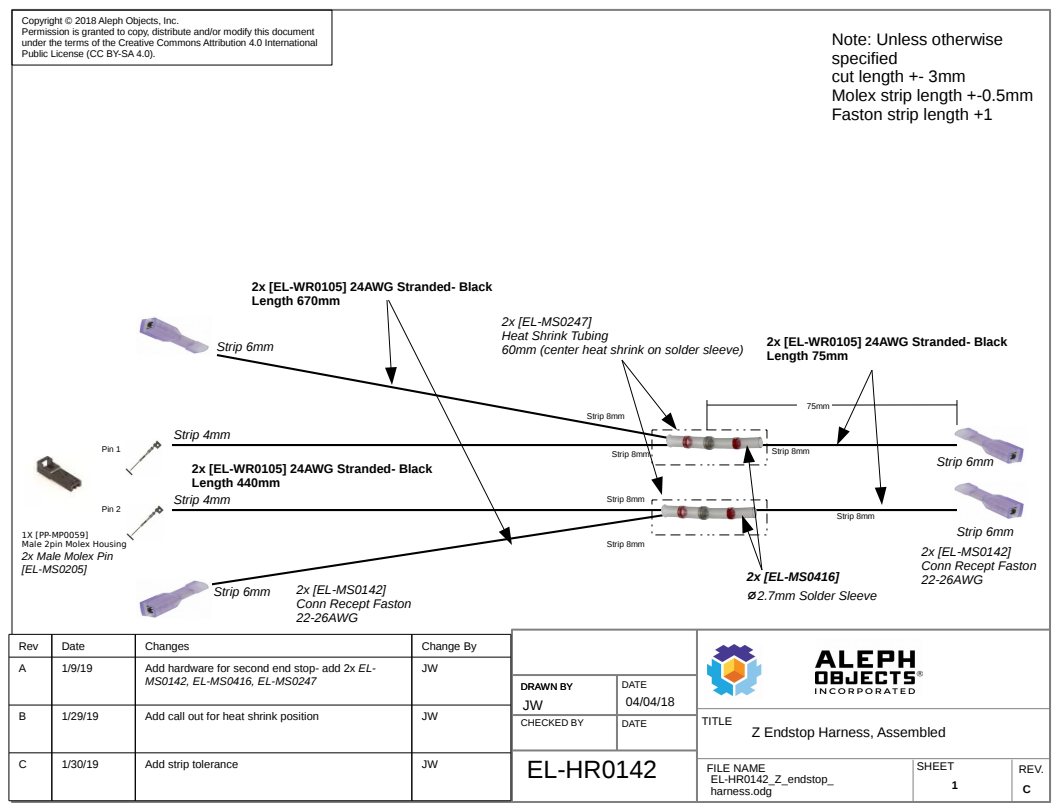
[picture p91: page 1]
TITLE; 2x [EL-MS0142] Conn Recept Faston 22-26AWG; Strip 4mm; Pin 1; Pin 2; Strip 6mm; 2x [EL-MS0416] ⌀2.7mm Solder Sleeve; Strip 8mm

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

cut length +- 3mm
Molex strip length +-0.5mm
Faston strip length +1

2x [EL-WR0105] 24AWG Stranded- Black
Length 670mm

Heat Shrink Tubing
60mm (center heat shrink on solder sleeve)

Length 75mm

Length 440mm
Strip 4mm

Male 2pin Molex Housing
2x Male Molex Pin

Rev | Date | Changes | Change By
A | 1/9/19 | Add hardware for second end stop- add 2x EL-MS0142, EL-MS0416, EL-MS0247 | JW

DRAWN BY DRAWN BY JW | DATE 04/04/18

B | 1/29/19 | Add call out for heat shrink position | JW
C | 1/30/19 | Add strip tolerance | JW | EL-HR0142

CHECKED BY | DATE

Z Endstop Harness, Assembled

FILE NAME EL-HR0142_Z_endstop_ harness.odg | SHEET 1 C | REV.

AO P/n | qty | unit | Supplier | supplier P/n
EL-MS0205 | 2 | pce | TTI global distribution | 16-02-0107
PP-MP0059 | 1 | pce | Sager electronics | 701070001
EL-WR0105 | 2370 | mm | Allcable | HU1569247B K
EL-MS0142 | 4 | pce | TTI global distribution | 7-520365-2
EL-MS0247 | 120 | mm | Electronics distributors corp | 88-01870
EL-MS0416 | 2 | pce | TTI | B-155-9002
