joeyliu522/VVI-project/CAD files/Older 3D printed parts/production_parts/electronics/external_harness/EL-HR0146_Bed_Extension_Harness_revC.pdf

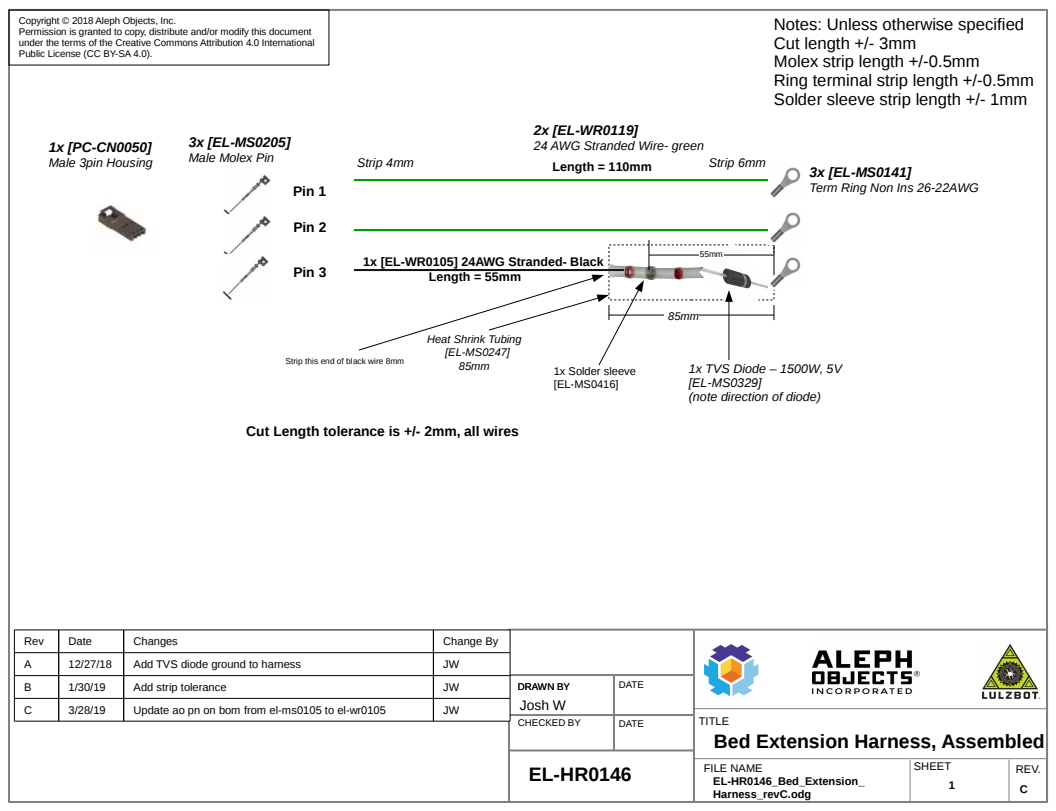
[picture p92: page 1]
FILE NAME; SHEET; REV.; CHECKED BY; DATE; 1x [PC-CN0050] Male 3pin Housing; Pin 1; Pin 2; Length = 110mm; Strip 4mm; EL-HR0146_Bed_Extension_; Harness_revC.odg; Strip 6mm; 1x Solder sleeve [EL-MS0416]; Pin 3; Length = 55mm; Heat Shrink Tubing [EL-MS0247] 85mm

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

Notes: Unless otherwise specified
Cut length +/- 3mm
Molex strip length +/-0.5mm
Ring terminal strip length +/-0.5mm
Solder sleeve strip length +/- 1mm

24 AWG Stranded Wire- green

Male Molex Pin

Term Ring Non Ins 26-22AWG

1x [EL-WR0105] 24AWG Stranded- Black

Strip this end of black wire 8mm

1x TVS Diode – 1500W, 5V
(note direction of diode)

Cut Length tolerance is +/- 2mm, all wires

Rev | Date | Changes | Change By
A | 12/27/18 | Add TVS diode ground to harness | JW

B | 1/30/19 | Add strip tolerance | JW | DRAWN BY DRAWN BY Josh W | DATE

C | 3/28/19 | Update ao pn on bom from el-ms0105 to el-wr0105 | JW

TITLE
Bed Extension Harness, Assembled

AO P/n | qty | unit | Supplier | supplier P/n
PC-CN0050 | 1 | pce | TTI | 701070002
EL-MS0205 | 2 | pce | TTI | 16-02-0107
EL-WR0119 | 220 | mm | allcable | HU1569247GN
EL-MS0141 | 2 | pce | TTI | P22-4R-M
EL-WR0105 | 55 | mm | Allcable | HU1569247BK
EL-MS0416 | 1 | pce | tti | B-155-9002
EL-MS0329 | 1 | pce | future electronics | 1N6373G
EL-MS0247 | 85 | mm | Electronics distributors corp | 88-01870
