joeyliu522/VVI-project/CAD files/Older 3D printed parts/production_parts/electronics/external_harness/EL-HR0174_bed_power_harness_revB.pdf

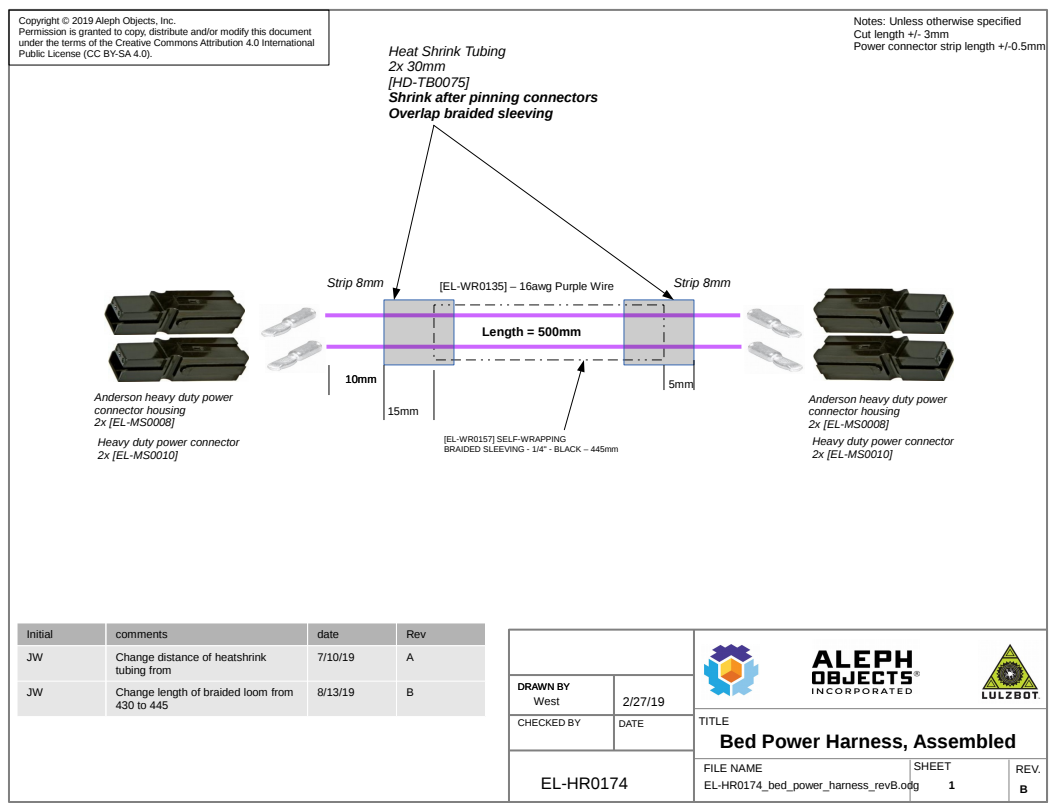
[picture p93: page 1]
FILE NAME; SHEET; REV.; Length = 500mm; Strip 8mm; [EL-WR0135] – 16awg Purple Wire; EL-HR0174_bed_power_harness_revB.odg

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

Notes: Unless otherwise specified
Cut length +/- 3mm
Power connector strip length +/-0.5mm

Heat Shrink Tubing
Shrink after pinning connectors
Overlap braided sleeving

Anderson heavy duty power
connector housing
Heavy duty power connector

[EL-WR0157] SELF-WRAPPING
BRAIDED SLEEVING - 1/4" - BLACK – 445mm

Initial | comments | date | Rev
JW | Change distance of heatshrink tubing from | 7/10/19 | A

DRAWN BY DRAWN BY West | 2/27/19

JW | Change length of braided loom from 430 to 445 | 8/13/19 | B

TITLE
Bed Power Harness, Assembled

CHECKED BY | DATE

AO part number | qty | UoM | Supplier | supplier pn
HD-TB0075 | 60 | mm | McMaster | 7856k76
EL-WR0135 | 900 | mm | Allcable | MTW16VT
EL-WR0157 | 445 | mm | Wirecare | F6N0.25BK
EL-MS0008 | 4 | pce | Sager | 879-1327G6-BK
EL-MS0010 | 4 | pce | Sager | 1332-BK
