joeyliu522/VVI-project/CAD files/Older 3D printed parts/production_parts/electronics/external_harness/EL-HR0178_extruder_harness_revD.pdf

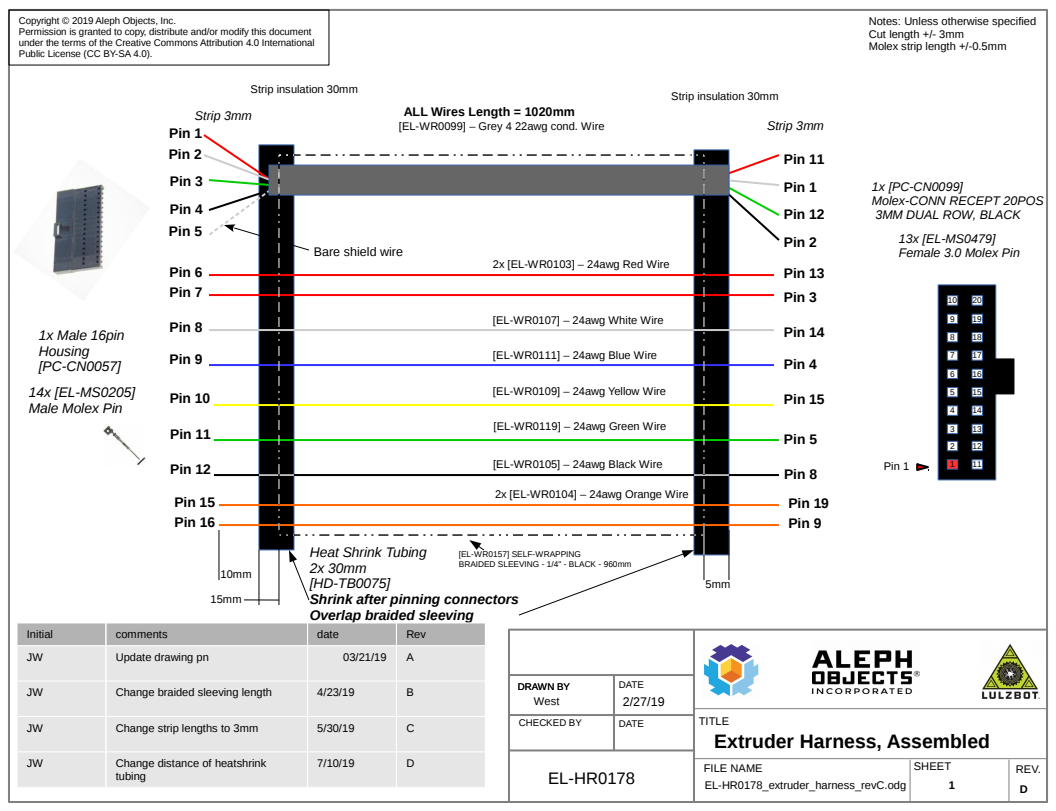
[picture p94: page 1]
FILE NAME; SHEET; REV.; CHECKED BY; DATE; Strip insulation 30mm; Pin 1 Pin 2; Pin 3; Pin 4 Pin 5; Pin 6; Strip 3mm; Pin 7; Pin 8; [EL-WR0107] – 24awg White Wire; Pin 12; Pin 15 Pin 16; Pin 13; Pin 1; Pin 11; Pin 2; Pin 14; Pin 4; Pin 15; Pin 5; Pin 19 Pin 9; 14x [EL-MS0205] Male Molex Pin; 1x Male 16pin Housing [PC-CN0057]; EL-HR0178_extruder_harness_revC.odg; Change strip lengths to 3mm; Change distance of heatshrink; tubing

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

Notes: Unless otherwise specified
Cut length +/- 3mm
Molex strip length +/-0.5mm

ALL Wires Length = 1020mm
[EL-WR0099] – Grey 4 22awg cond. Wire

Molex-CONN RECEPT 20POS
3MM DUAL ROW, BLACK
Female 3.0 Molex Pin

Bare shield wire

2x [EL-WR0103] – 24awg Red Wire

[EL-WR0111] – 24awg Blue Wire Pin 9

[EL-WR0109] – 24awg Yellow Wire Pin 10

[EL-WR0119] – 24awg Green Wire Pin 11

[EL-WR0105] – 24awg Black Wire

2x [EL-WR0104] – 24awg Orange Wire

Heat Shrink Tubing
Shrink after pinning connectors
Overlap braided sleeving

[EL-WR0157] SELF-WRAPPING
BRAIDED SLEEVING - 1/4" - BLACK - 960mm

Initial | comments | date | Rev
JW | Update drawing pn | 03/21/19 | A

DRAWN BY DRAWN BY West | DATE 2/27/19

JW | Change braided sleeving length | 4/23/19 | B

TITLE
Extruder Harness, Assembled

AO part number | qty | UoM | Supplier | supplier pn
EL-WR0099 | 1020 | mm | Allcable | C0762A.41.10
EL-MS0205 | 14 | pce | TTI global | 16-02-0107
HD-TB0075 | 60 | mm | McMaster | 7856k76
EL-WR0157 | 960 | mm | Wirecare | F6N0.25BK
PC-CN0057 | 1 | pce | Sager | 70107-0015
PC-CN0099 | 1 | pce | Digikey | WM2492-ND
EL-MS0479 | 13 | pce | TTI global | 43030-0001
EL-WR0103 | 2040 | mm | Allcable | HU1569247RD
EL-WR0107 | 1020 | mm | Allcable | HU1569247WE
EL-WR0111 | 1020 | mm | Allcable | HU1569247BE
EL-WR0109 | 1020 | mm | Allcable | HU1569247YW
EL-WR0119 | 1020 | mm | Allcable | HU1569247GN
EL-WR0105 | 1020 | mm | Allcable | HU1569247BK
EL-WR0104 | 2040 | mm | Allcable | HU1569247OE
