joeyliu522/VVI-project/CAD files/Older 3D printed parts/production_parts/electronics/external_harness/EL-HR0179_x_harness_revC.pdf

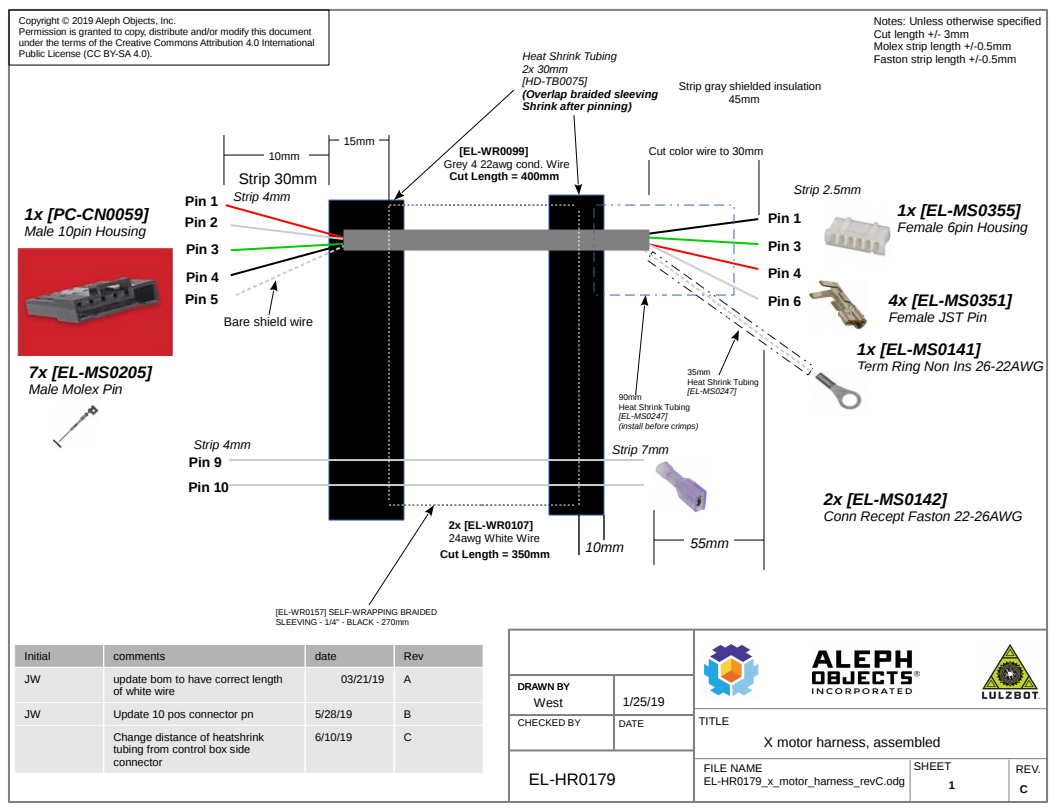
[picture p95: page 1]
TITLE; FILE NAME; SHEET; REV.; Strip 30mm; Cut Length = 400mm; Bare shield wire; Pin 1 Pin 2; Pin 3; Pin 4 Pin 5; Strip 4mm; 1x [EL-MS0355] Female 6pin Housing; Strip 2.5mm; Pin 1; Pin 4; Pin 6; 1x [PC-CN0059] Male 10pin Housing; Pin 9; 2x [EL-WR0107] 24awg White Wire Cut Length = 350mm; Pin 10; Strip 7mm; Term Ring Non Ins 26-22AWG; EL-HR0179_x_motor_harness_revC.odg

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

Notes: Unless otherwise specified
Cut length +/- 3mm
Molex strip length +/-0.5mm
Faston strip length +/-0.5mm

Heat Shrink Tubing
(Overlap braided sleeving
Shrink after pinning)

Strip gray shielded insulation

Grey 4 22awg cond. Wire

Cut color wire to 30mm

Female JST Pin

Male Molex Pin

(install before crimps)

Conn Recept Faston 22-26AWG

[EL-WR0157] SELF-WRAPPING BRAIDED
SLEEVING - 1/4" - BLACK - 270mm

Initial | comments | date | Rev
JW | update bom to have correct length of white wire | 03/21/19 | A

DRAWN BY DRAWN BY West | 1/25/19

JW | Update 10 pos connector pn | 5/28/19 | B

CHECKED BY | DATE

Change distance of heatshrink tubing from control box side connector | 6/10/19 | C

X motor harness, assembled

AO part number | qty | UoM | Supplier | supplier pn
EL-WR0099 | 400 | mm | Allcable | C0762A.41.10
EL-MS0205 | 7 | pce | TTI global | 16-02-0107
HD-TB0075 | 60 | mm | McMaster | 7856k76
EL-WR0157 | 270 | mm | Wirecare | F6N0.25BK
PC-CN0059 | 1 | pce | TTI global | 70107-0009
EL-MS0355 | 1 | pce | Future electronics | PHR-6
EL-MS0351 | 4 | pce | Future electronics | SPH-002T-P0.5S
EL-MS0141 | 1 | pce | TTI global | P22-4R-M
EL-WR0107 | 700 | mm | Allcable | HU1569247WE
EL-MS0142 | 2 | pce | TTI global | 7-520365-2
EL-MS0247 | 125 | mm | Electronics distributors corp | 88-01870
