joeyliu522/VVI-project/CAD files/Older 3D printed parts/production_parts/electronics/external_harness/EL-HR0180_y_bed_harness_revA.pdf

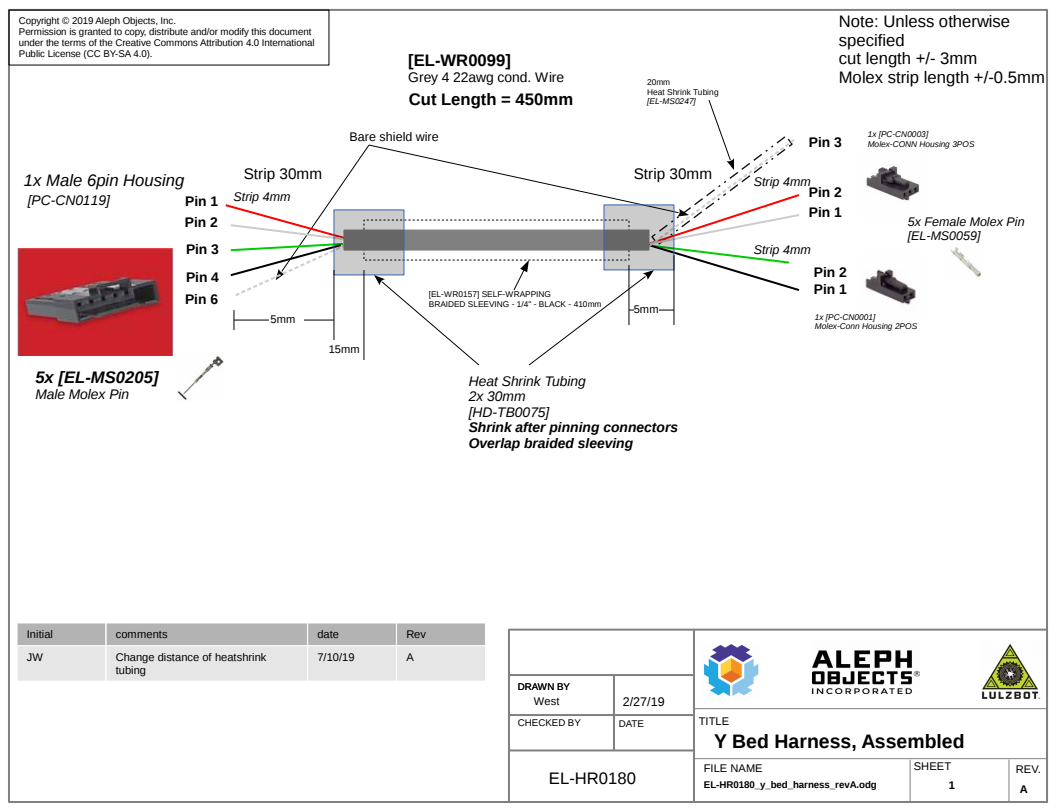
[picture p96: page 1]
FILE NAME; SHEET; REV.; Strip 30mm; Pin 1 Pin 2; Pin 3; Pin 4 Pin 6; Strip 4mm; Strip 4mm Pin 2 Pin 1; Pin 2 Pin 1; 20mm Heat Shrink Tubing [EL-MS0247]; 1x Male 6pin Housing [PC-CN0119]; BRAIDED SLEEVING - 1/4" - BLACK - 410mm; EL-HR0180_y_bed_harness_revA.odg

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

Note: Unless otherwise
specified
cut length +/- 3mm
Molex strip length +/-0.5mm

Grey 4 22awg cond. Wire
Cut Length = 450mm

Bare shield wire

Molex-CONN Housing 3POS

5x Female Molex Pin

[EL-WR0157] SELF-WRAPPING

Molex-Conn Housing 2POS

Male Molex Pin

Heat Shrink Tubing
Shrink after pinning connectors
Overlap braided sleeving

Initial | comments | date | Rev
JW | Change distance of heatshrink tubing | 7/10/19 | A

DRAWN BY DRAWN BY West | 2/27/19

TITLE
Y Bed Harness, Assembled

CHECKED BY | DATE

AO part number | qty | UoM | Supplier | supplier pn
EL-WR0099 | 450 | mm | Allcable | C0762A.41.10
EL-MS0247 | 20 | mm | Electronics distributors corp | 88-01870
PC-CN0003 | 1 | pce | Digikey | WM2901-ND
EL-MS0059 | 5 | pce | TTI global | 16-02-0086
PC-CN0001 | 1 | pce | Sager | 50579402
PC-CN0119 | 1 | pce | Digikey | WM2537-ND
EL-MS0205 | 5 | pce | TTI global | 16-02-0107
HD-TB0075 | 60 | mm | McMaster | 7856k76
EL-WR0157 | 430 | mm | Wirecare | F6N0.25BK
