joeyliu522/VVI-project/CAD files/Older 3D printed parts/production_parts/electronics/internal_harness/EL-HR0147_LCD-USB.pdf

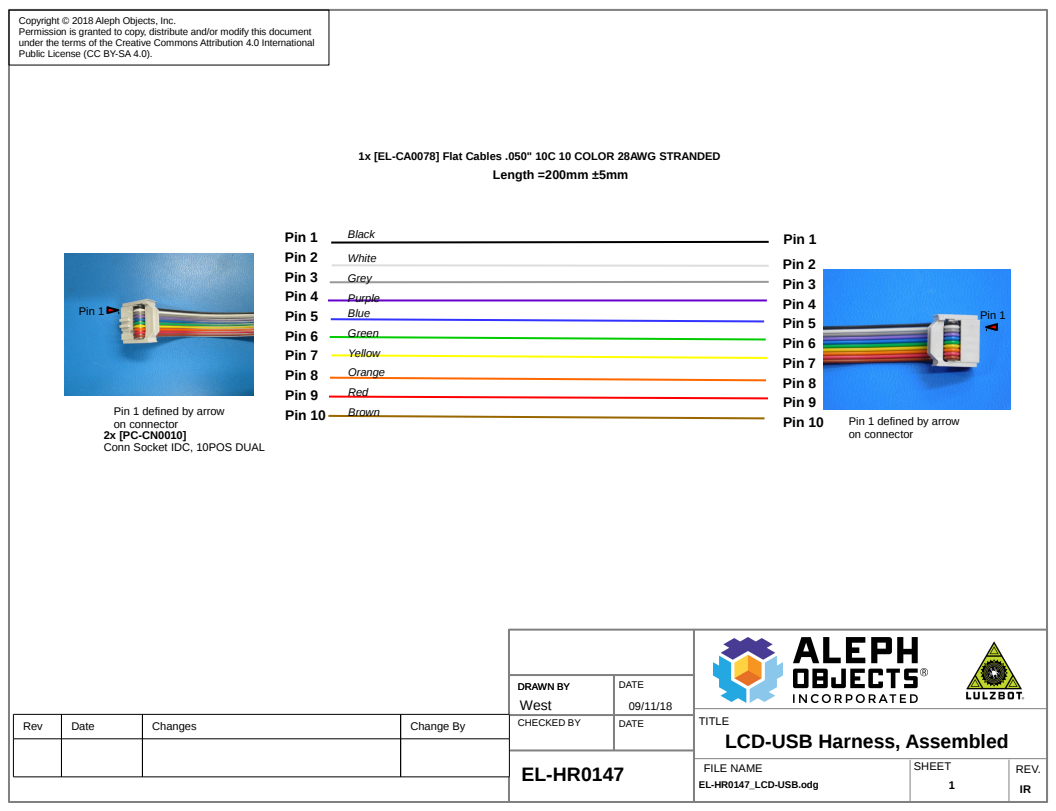
[picture p97: page 1]
FILE NAME; SHEET; REV.; IR EL-HR0147_LCD-USB.odg; Length =200mm ±5mm; Pin 1 Pin 2 Pin 3 Pin 4 Pin 5 Pin 6 Pin 7 Pin 8 Pin 9 Pin 10; Black; White; Grey; Purple Blue; Green; Yellow; Orange; Red; Brown; Pin 1; Pin 2 Pin 3 Pin 4 Pin 5 Pin 6 Pin 7 Pin 8 Pin 9 Pin 10; on connector; Pin 1 defined by arrow

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

1x [EL-CA0078] Flat Cables .050" 10C 10 COLOR 28AWG STRANDED

Pin 1 defined by arrow
Conn Socket IDC, 10POS DUAL

DRAWN BY DRAWN BY West | DATE 09/11/18

TITLE
LCD-USB Harness, Assembled

Rev | Date | Changes | Change By | CHECKED BY | DATE

AO P/n | qty | unit | Supplier | supplier P/n
PC-CN0010 | 2 | pce | TTI | 71600-010LF
EL-CA0078 | 200 | mm | TTI | 3302/10-300
