joeyliu522/VVI-project/CAD files/Older 3D printed parts/production_parts/electronics/internal_harness/EL-HR0148_CB_Bed_Power_Harness.pdf

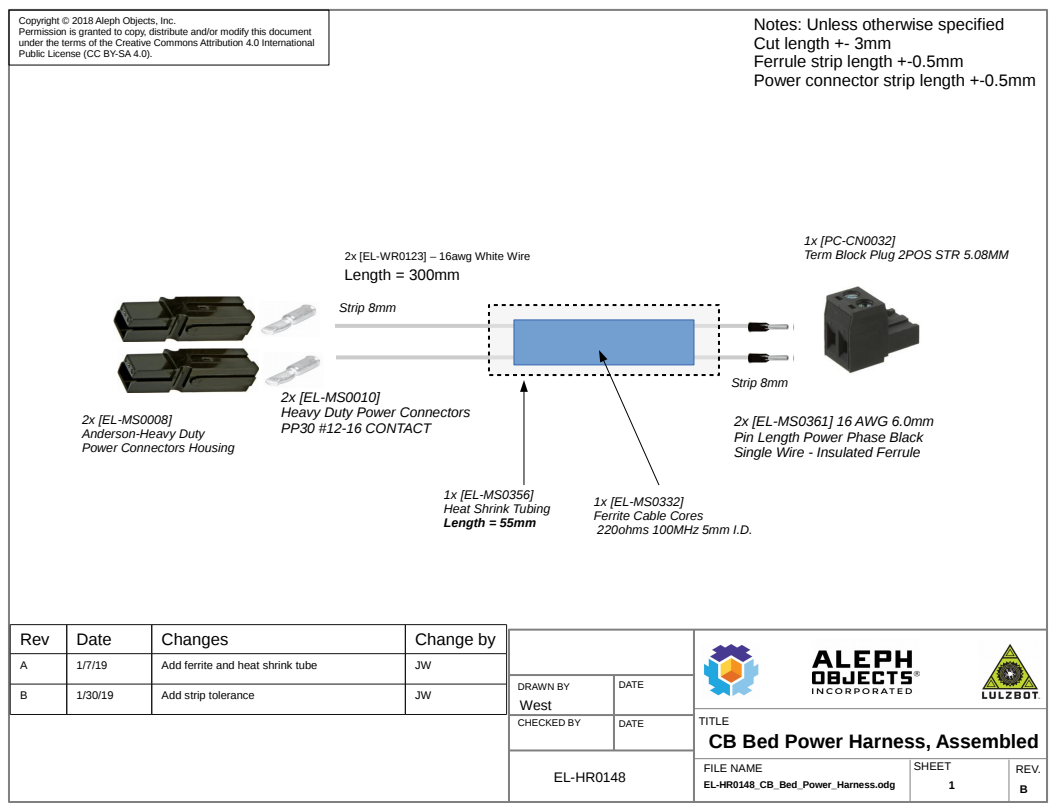
[picture p98: page 1]
FILE NAME; SHEET; REV.; Length = 300mm; Strip 8mm; EL-HR0148_CB_Bed_Power_Harness.odg; 2x [EL-WR0123] – 16awg White Wire; Term Block Plug 2POS STR 5.08MM; 1x [EL-MS0332] Ferrite Cable Cores 220ohms 100MHz 5mm I.D.

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

Notes: Unless otherwise specified
Cut length +- 3mm
Ferrule strip length +-0.5mm
Power connector strip length +-0.5mm

Heavy Duty Power Connectors
PP30 #12-16 CONTACT

Anderson-Heavy Duty
Power Connectors Housing

2x [EL-MS0361] 16 AWG 6.0mm
Pin Length Power Phase Black
Single Wire - Insulated Ferrule

Heat Shrink Tubing
Length = 55mm

Rev | Date | Changes | Change by

A | 1/7/19 | Add ferrite and heat shrink tube | JW

DRAWN BY West | DATE

B | 1/30/19 | Add strip tolerance | JW

TITLE
CB Bed Power Harness, Assembled

CHECKED BY | DATE

AO P/n | qty | unit | Supplier | supplier P/n
EL-MS0008 | 2 | pce | sager | 879-1327G6-BK
EL-WR0123 | 600 | mm | allcable | HU15691626W E
EL-MS0010 | 2 | pce | sager | 1332-BK
EL-MS0361 | 2 | pce | tti | FSD78-6-D
PC-CN0032 | 1 | pce | tti | 395300002
EL-MS0332 | 1 | Pce | sager | 28B0434-000
EL-MS0356 | 55 | mm | Electronics distributors corp | 84-60500
