joeyliu522/VVI-project/CAD files/Older 3D printed parts/production_parts/electronics/internal_harness/EL-HR0157_CB_switch_to_PSU.pdf

## Notes: Unless otherwise specified Cut length +/- 3mm

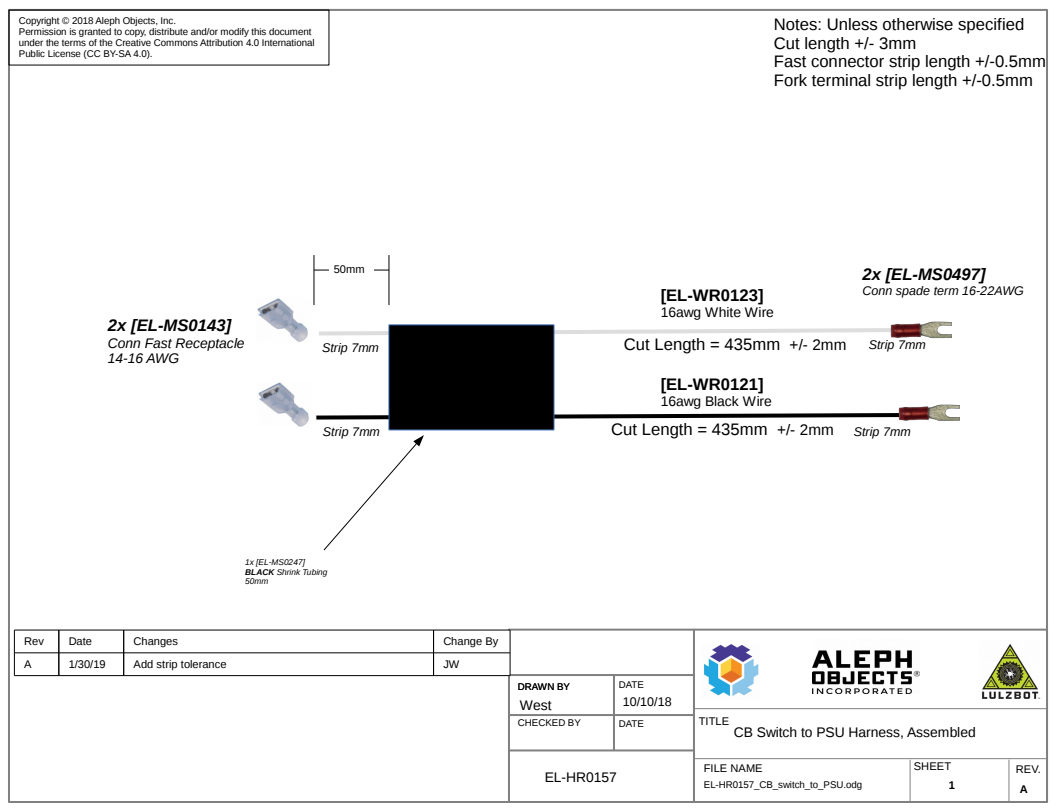
[picture p99: page 1]
FILE NAME; SHEET; REV.; EL-HR0157_CB_switch_to_PSU.odg; [EL-WR0123] 16awg White Wire; Strip 7mm; Cut Length = 435mm +/- 2mm; [EL-WR0121] 16awg Black Wire; 1x [EL-MS0247] BLACK Shrink Tubing 50mm

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

Fast connector strip length +/-0.5mm
Fork terminal strip length +/-0.5mm

Conn spade term 16-22AWG

Conn Fast Receptacle
14-16 AWG

Rev | Date | Changes | Change By
A | 1/30/19 | Add strip tolerance | JW

DRAWN BY DRAWN BY West | DATE 10/10/18

TITLE
CB Switch to PSU Harness, Assembled

CHECKED BY | DATE

AO P/n | qty | unit | Supplier | supplier P/n
EL-MS014 3 | 2 | pce | TTI | 3-350820-2
EL-MS024 7 | 50 | mm | Electronics Distributors Corp | 88-01870
EL-MS049 7 | 2 | pce | TTI | 2-34541-1
EL-WR012 3 | 435 | mm | allcable | HU15691626WE
EL-WR012 1 | 435 | mm | allcable | HU15691626BK
