joeyliu522/VVI-project/CAD files/Older 3D printed parts/production_parts/electronics/internal_harness/EL-HR0168_plug_to_switch_black_and_white_with_ferrite.pdf

## Notes: Unless otherwise specified Cut length +/- 3mm

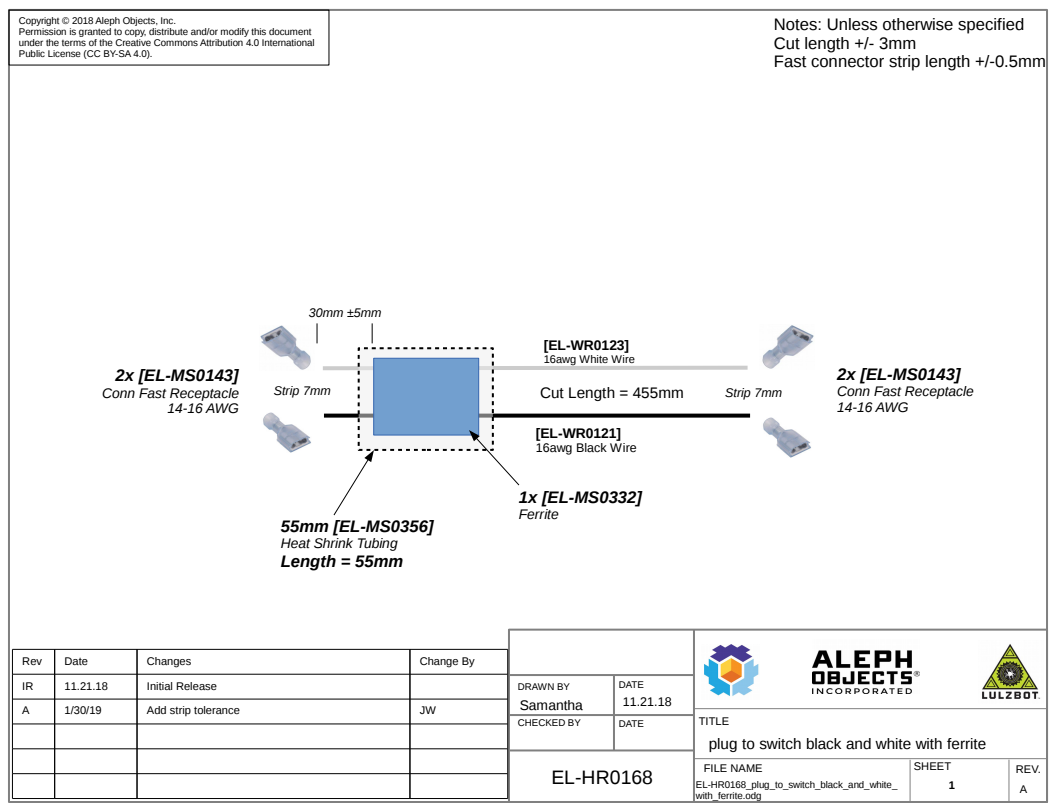
[picture p100: page 1]
FILE NAME; SHEET; REV.; 14-16 AWG; CHECKED BY; DATE; EL-HR0168_plug_to_switch_black_and_white_ with_ferrite.odg; [EL-WR0123] 16awg White Wire; Strip 7mm; Cut Length = 455mm; [EL-WR0121] 16awg Black Wire; 1x [EL-MS0332] Ferrite

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

Fast connector strip length +/-0.5mm

Conn Fast Receptacle

14-16 AWG

Heat Shrink Tubing
Length = 55mm

Rev | Date | Changes | Change By

IR | 11.21.18 | Initial Release | | DRAWN BY Samantha | DATE 11.21.18

A | 1/30/19 | Add strip tolerance | JW

TITLE
plug to switch black and white with ferrite

AO P/n | qty | unit | Supplier | supplier P/n
EL-MS0143 | 4 | pce | TTI Global Distribution | 3-350820-2
EL-WR0123 | 455 | mm | Allcable | HU15691626WE
EL-WR0121 | 455 | mm | Allcable | HU15691626BK
EL-MS0332 | 1 | pce | Sager Electronics | 28B0434-000
EL-MS0356 | 55 | mm | Electronics Distributors Corp. | 84-60500
