joeyliu522/VVI-project/CAD files/Older 3D printed parts/production_parts/electronics/internal_harness/EL-HR0173_CB_X-Harness_revE.pdf

`

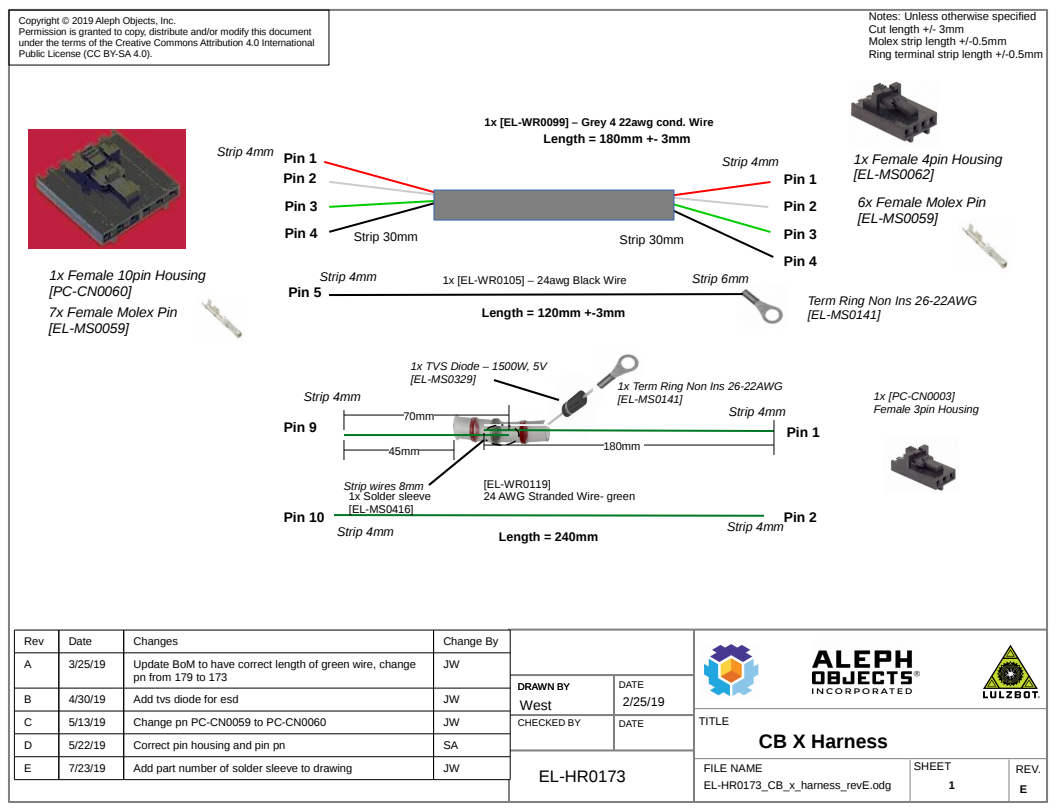
[picture p101: page 1]
Length = 180mm +- 3mm; Pin 1 Pin 2; Pin 3; Pin 4; Strip 4mm; Pin 9; Pin 10; Pin 2; Pin 1; Strip 30mm; Length = 120mm +-3mm; Pin 5; Length = 240mm; Strip 6mm; 1x [PC-CN0003] Female 3pin Housing; 1x TVS Diode – 1500W, 5V [EL-MS0329]; Strip wires 8mm; 1x Solder sleeve [EL-MS0416]

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

1x [EL-WR0099] – Grey 4 22awg cond. Wire

1x Female 4pin Housing
6x Female Molex Pin

1x Female 10pin Housing
7x Female Molex Pin

1x [EL-WR0105] – 24awg Black Wire

Term Ring Non Ins 26-22AWG

1x Term Ring Non Ins 26-22AWG

24 AWG Stranded Wire- green

Rev | Date | Changes | Change By
A | 3/25/19 | Update BoM to have correct length of green wire, change pn from 179 to 173 | JW

DRAWN BY DRAWN BY West | DATE 2/25/19

B | 4/30/19 | Add tvs diode for esd | JW
C | 5/13/19 | Change pn PC-CN0059 to PC-CN0060 | JW | | TITLE CB X Harness

CHECKED BY | DATE

D | 5/22/19 | Correct pin housing and pin pn | SA
E | 7/23/19 | Add part number of solder sleeve to drawing | JW | FILE NAME EL-HR0173_CB_x_harness_revE.odg | SHEET 1 | REV. E

AO part number | qty | UoM | Supplier | supplier pn
EL-WR0099 | 180 | mm | Allcable | C0762A.41.10
EL-MS0059 | 13 | pce | TTI global | 16-02-0086
PC-CN0060 | 1 | pce | TTI global | 50-57-9410
EL-MS0062 | 1 | pce | Sager | 50579404
PC-CN0003 | 1 | pce | Digikey | WM2901-ND
EL-MS0141 | 2 | pce | TTI global | P22-4R-M
EL-WR0105 | 120 | mm | Allcable | HU1569247BK
EL-WR0119 | 490 | mm | Allcable | HU1569247GN
EL-MS0329 | 1 | pce | future electronics | 1N6373G
EL-MS0416 | 1 | pce | tti | B-155-9002
