joeyliu522/VVI-project/CAD files/Older 3D printed parts/production_parts/electronics/internal_harness/EL-HR0175_CB_Extruder_Harness_revD.pdf

`

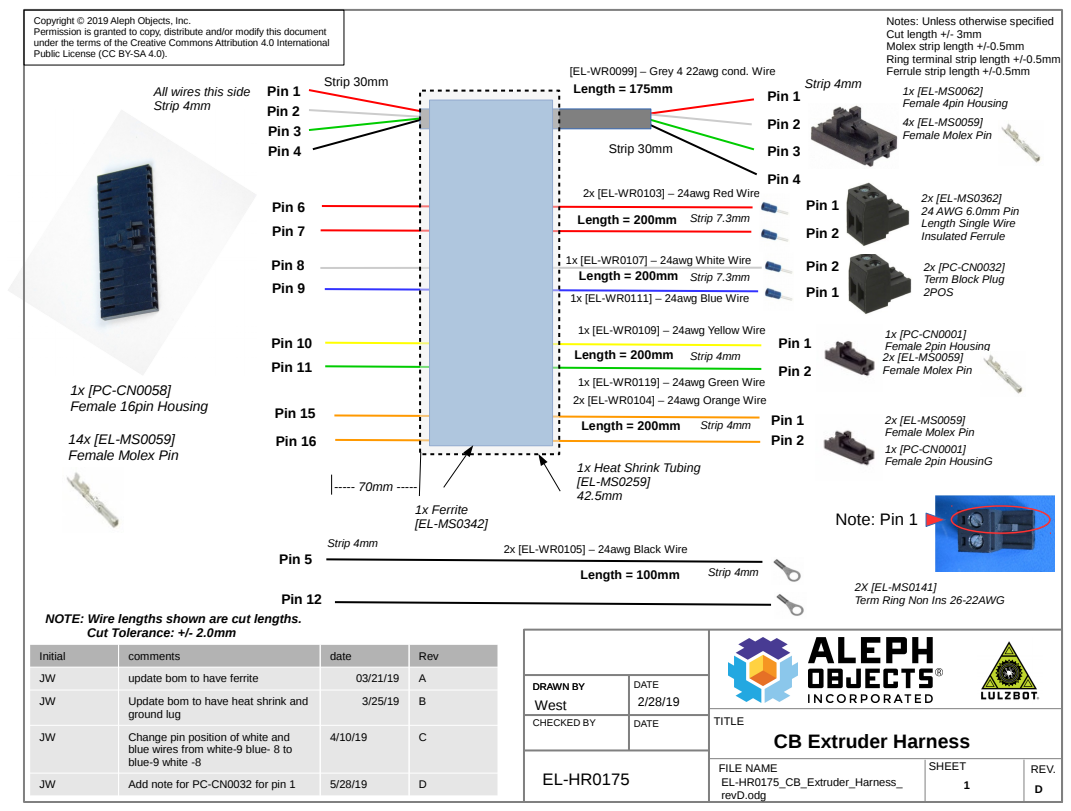
[picture p102: page 1]
FILE NAME; SHEET; REV.; EL-HR0175_CB_Extruder_Harness_ revD.odg; Pin 10; Pin 12; 1x [PC-CN0058] Female 16pin Housing; Pin 1; Pin 6; Pin 9; Pin 15; Pin 16; Pin 2; Strip 4mm; Pin 1 Pin 2 Pin 3 Pin 4; Strip 30mm; Pin 3; Pin 7; Pin 8; 1x [EL-WR0107] – 24awg White Wire; Pin 11; Pin 5; Length = 100mm; Pin 4; 2x [PC-CN0032] Term Block Plug 2POS; Cut Tolerance: +/- 2.0mm; 1x Ferrite [EL-MS0342]; 1x Heat Shrink Tubing [EL-MS0259] 42.5mm; Note: Pin 1

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

Notes: Unless otherwise specified
Cut length +/- 3mm
Molex strip length +/-0.5mm
Ring terminal strip length +/-0.5mm
Ferrule strip length +/-0.5mm

[EL-WR0099] – Grey 4 22awg cond. Wire
Length = 175mm

All wires this side
Strip 4mm

Female 4pin Housing
Female Molex Pin

2x [EL-WR0103] – 24awg Red Wire
Length = 200mm Strip 7.3mm

24 AWG 6.0mm Pin
Length Single Wire
Insulated Ferrule

1x [EL-WR0111] – 24awg Blue Wire

1x [EL-WR0109] – 24awg Yellow Wire
Length = 200mm

Female 2pin Housing

1x [EL-WR0119] – 24awg Green Wire
2x [EL-WR0104] – 24awg Orange Wire

Female 2pin HousinG

2x [EL-WR0105] – 24awg Black Wire

Term Ring Non Ins 26-22AWG

NOTE: Wire lengths shown are cut lengths.

Initial | comments | date | Rev
JW | update bom to have ferrite | 03/21/19 | A
JW | Update bom to have heat shrink and ground lug | 3/25/19 | B

DRAWN BY DRAWN BY West | DATE 2/28/19

TITLE
CB Extruder Harness

CHECKED BY | DATE

JW | Change pin position of white and blue wires from white-9 blue- 8 to blue-9 white -8 | 4/10/19 | C

JW | Add note for PC-CN0032 for pin 1 | 5/28/19 | D

AO part number | qty | UoM | Supplier | supplier pn
EL-WR0099 | 175 | mm | Allcable | C0762A.41.10
EL-MS0059 | 22 | pce | TTI global | 16-02-0086
PC-CN0058 | 1 | pce | TTI global | 50-57-9416
EL-MS0062 | 1 | pce | Sager | 50579404
EL-MS0362 | 2 | pce | Digikey | FSD74-8-D
PC-CN0032 | 2 | pce | TTI global | 395300002
PC-CN0001 | 2 | pce | Sager | 50579402
EL-WR0103 | 400 | mm | Allcable | HU1569247RD
EL-WR0107 | 200 | mm | Allcable | HU1569247WE
EL-WR0111 | 200 | mm | Allcable | HU1569247BE
EL-WR0109 | 200 | mm | Allcable | HU1569247YW
EL-WR0104 | 400 | mm | Allcable | HU1569247OE
EL-WR0105 | 200 | mm | Allcable | HU1569247BK
EL-WR0119 | 200 | mm | Allcable | HU1569247GN
EL-MS0342 | 1 | pce | Sager | 28B0625-100
EL-MS0141 | 2 | pce | TTI global | P22-4R-M
EL-MS0259 | 42.5 | mm | Electronics distributor corp | 67-30751
