joeyliu522/VVI-project/CAD files/Older 3D printed parts/production_parts/electronics/internal_harness/EL-HR0177_CB_Y-endstop_harness_revD.pdf

## Notes: Unless otherwise specified Cut length +/- 3mm

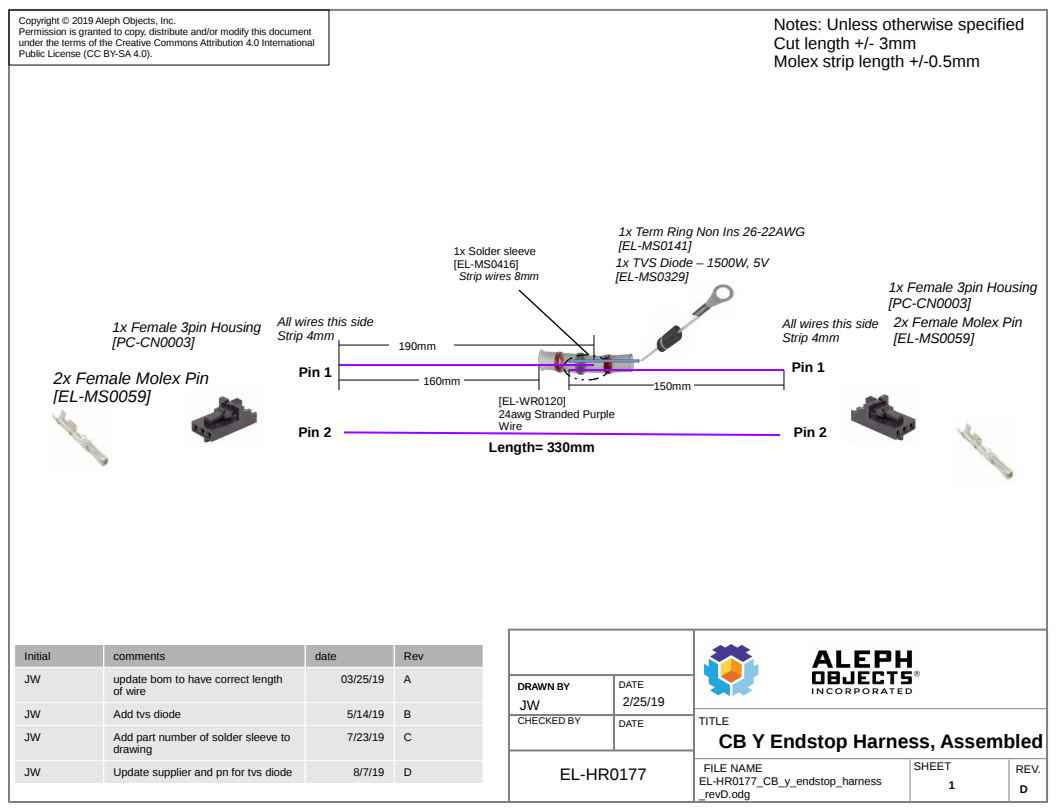
[picture p104: page 1]
FILE NAME; SHEET; REV.; Pin 2; Pin 1; Length= 330mm; 1x Female 3pin Housing [PC-CN0003]; EL-HR0177_CB_y_endstop_harness _revD.odg; Update supplier and pn for tvs diode; Strip wires 8mm; [EL-WR0120] 24awg Stranded Purple Wire; 1x Solder sleeve [EL-MS0416]

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

Molex strip length +/-0.5mm

1x Term Ring Non Ins 26-22AWG
1x TVS Diode – 1500W, 5V

1x Female 3pin Housing
2x Female Molex Pin

All wires this side
Strip 4mm

Pin 1

Initial | comments | date | Rev
JW | update bom to have correct length of wire | 03/25/19 | A

DRAWN BY DRAWN BY JW | DATE 2/25/19

JW | Add tvs diode | 5/14/19 | B
JW | Add part number of solder sleeve to drawing | 7/23/19 | C

CHECKED BY | DATE

TITLE
CB Y Endstop Harness, Assembled

AO P/n | qty | unit | Supplier | supplier P/n
EL-MS0059 | 4 | pce | TTI | 16-02-0086
EL-WR0120 | 670 | mm | allcable | HU1569247 VT
PC-CN0003 | 2 | pce | digikey | WM2901-ND
EL-MS0329 | 1 | pce | Digikey | 1N6373-E3/54
EL-MS0416 | 1 | pce | tti | B-155-9002
EL-MS0141 | 1 | pce | tti | P22-4R-M
