joeyliu522/VVI-project/CAD files/Older 3D printed parts/production_parts/electronics/internal_harness/EL-HR0183_CB_Y-Z_Harness_revA.pdf

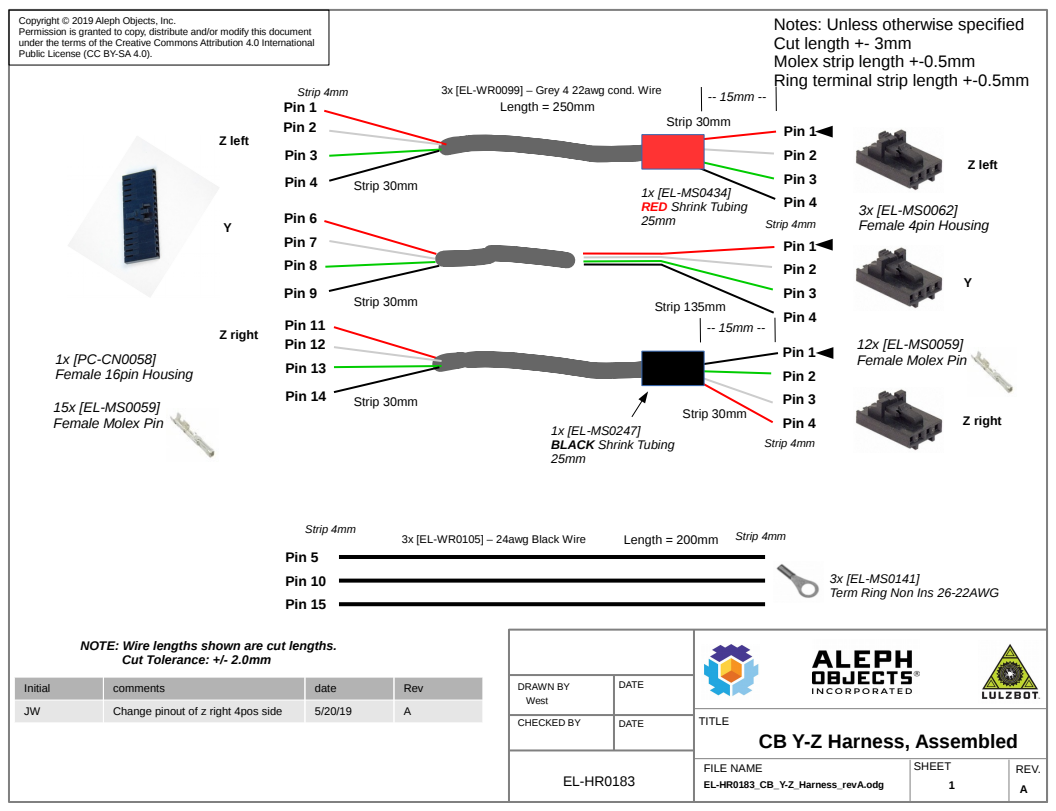
[picture p105: page 1]
DRAWN BY; FILE NAME; SHEET; REV.; DATE; CHECKED BY; EL-HR0183_CB_Y-Z_Harness_revA.odg; Pin 1; Length = 250mm; Pin 2; Pin 3; Pin 4; Pin 6; Strip 4mm; Female 4pin Housing; Pin 7; Pin 8; Pin 9; Pin 11 Pin 12; Pin 13; Pin 14; 1x [PC-CN0058] Female 16pin Housing; Strip 30mm; 3x [EL-WR0105] – 24awg Black Wire; Length = 200mm; Pin 5; Pin 10; Pin 15; Strip 135mm; Z left; Z right; Cut Tolerance: +/- 2.0mm; 1x [EL-MS0434] RED Shrink Tubing 25mm; 1x [EL-MS0247] BLACK Shrink Tubing 25mm; West; Initial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

3x [EL-WR0099] – Grey 4 22awg cond. Wire

Female Molex Pin

Term Ring Non Ins 26-22AWG

NOTE: Wire lengths shown are cut lengths.

TITLE
CB Y-Z Harness, Assembled

AO P/n | qty | unit | Supplier | supplier P/n
EL-WR0099 | 750 | mm | Allcable | C0762A.41.1 0
EL-MS0434 | 25 | mm | Electronics distribution corp | 99-01872
EL-MS0062 | 3 | pce | sager | 50579404
PC-CN0058 | 1 | pce | tti | 50-57-9416
EL-MS0059 | 27 | pce | tti | 16-02-0086
EL-WR0105 | 600 | mm | Allcable | HU1569247B K
EL-MS0141 | 3 | pce | tti | P22-4R-M
EL-MS0247 | 25 | mm | Electronics distribution corp | 88-01870
