joeyliu522/VVI-project/CAD files/Older 3D printed parts/production_parts/electronics/internal_harness/EL-HR0184_CB_Bed_Harness_revB.pdf

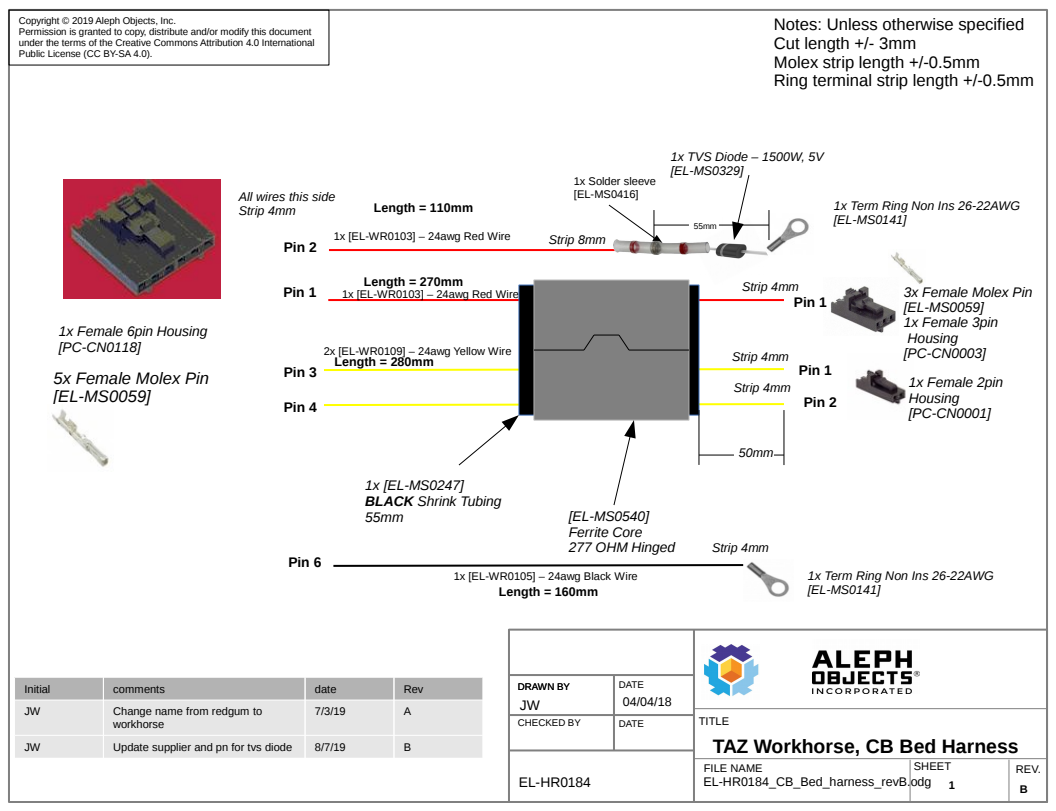
[picture p106: page 1]
DRAWN BY; FILE NAME; SHEET; REV.; DATE; CHECKED BY; Pin 3; Pin 4; Pin 2; Pin 1; Strip 8mm; 1x [EL-WR0103] – 24awg Red Wire; Length = 270mm; 1x Female 2pin Housing [PC-CN0001]; Strip 4mm; Length = 110mm; 3x Female Molex Pin [EL-MS0059]; 1x TVS Diode – 1500W, 5V [EL-MS0329]; 1x Solder sleeve [EL-MS0416]; 1x Female 3pin Housing [PC-CN0003]; EL-HR0184_CB_Bed_harness_revB.odg; [EL-MS0540] Ferrite Core 277 OHM Hinged; 1x [EL-MS0247] BLACK Shrink Tubing 55mm; Pin 6; Length = 160mm; Initial; comments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

All wires this side
Strip 4mm

1x Term Ring Non Ins 26-22AWG

1x [EL-WR0103] – 24awg Red Wire

1x Female 6pin Housing
5x Female Molex Pin

2x [EL-WR0109] – 24awg Yellow Wire
Length = 280mm

1x [EL-WR0105] – 24awg Black Wire

JW | Change name from redgum to workhorse | 7/3/19 | A

TITLE
TAZ Workhorse, CB Bed Harness

JW | Update supplier and pn for tvs diode | 8/7/19 | B

AO P/n | qty | unit | Supplier | supplier P/n
EL-MS0062 | 1 | pce | sager | 50579404
EL-MS0059 | 8 | pce | tti | 16-02-0086
EL-MS0416 | 1 | pce | tti | B-155-9002
EL-MS0329 | 1 | pce | Digikey | 1N6373-E3/54
PC-CN0001 | 1 | pce | sager | 50579402
PC-CN0003 | 1 | pce | digikey | WM2901-ND
EL-MS0141 | 1 | pce | tti | P22-4R-M
EL-WR0103 | 380 | mm | allcable | HU15692 47RD
EL-WR0109 | 560 | mm | allcable | HU15692 47YW
EL-MS0540 | 1 | pce | digikey | 240-2344-ND
EL-MS0247 | 55 | mm | electronics distributors corp | 88-01870
