joeyliu522/VVI-project/CAD files/Older 3D printed parts/production_parts/electronics/toolhead/AS-TH0076_workhorse_toolhead_pin_assignment_revA.pdf

## 1x- [AS-CB0061]

### Extruder Motor Harness v2Aero

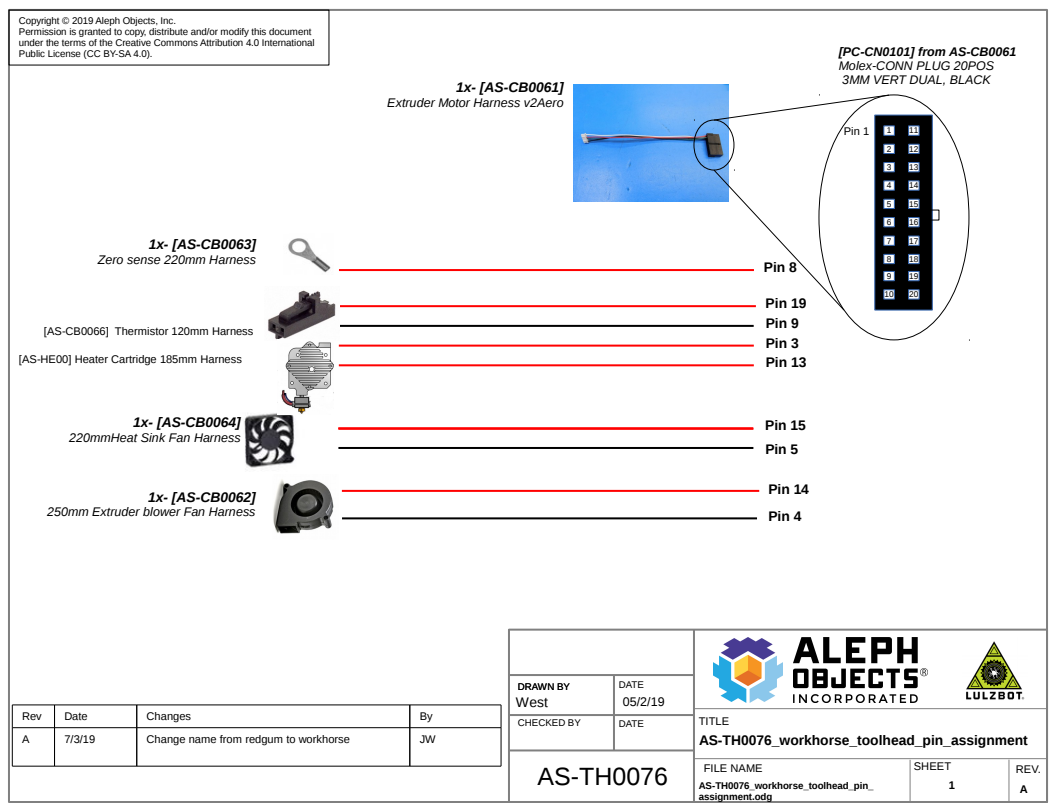
[picture p107: page 1]
TITLE; FILE NAME; SHEET; REV.; AS-TH0076_workhorse_toolhead_pin_assignment; AS-TH0076_workhorse_toolhead_pin_ assignment.odg; Pin 19 Pin 9 Pin 3 Pin 13; Pin 15; Pin 5; Pin 8; Pin 14; Pin 4; Pin 1

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

[PC-CN0101] from AS-CB0061
Molex-CONN PLUG 20POS
3MM VERT DUAL, BLACK

Zero sense 220mm Harness

[AS-CB0066] Thermistor 120mm Harness

[AS-HE00] Heater Cartridge 185mm Harness

220mmHeat Sink Fan Harness

250mm Extruder blower Fan Harness

DRAWN BY DRAWN BY West | DATE 05/2/19

Rev | Date | Changes | By
A | 7/3/19 | Change name from redgum to workhorse | JW

CHECKED BY | DATE
