joeyliu522/VVI-project/CAD files/Older 3D printed parts/production_parts/electronics/toolhead/EL-HR0186_dual_v3_adapter_harness_revA.pdf

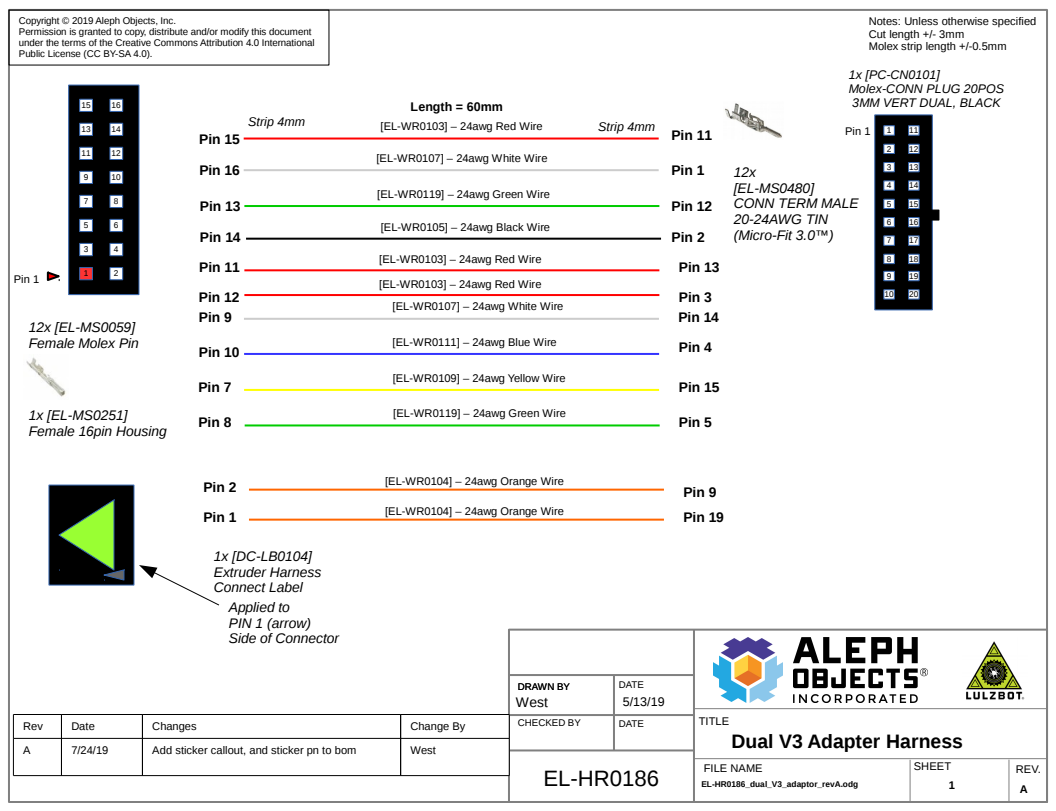
[picture p108: page 1]
FILE NAME; SHEET; REV.; EL-HR0186_dual_V3_adaptor_revA.odg; 12x [EL-MS0480] CONN TERM MALE 20-24AWG TIN (Micro-Fit 3.0™); Pin 1; Length = 60mm; Pin 15; Strip 4mm; [EL-WR0103] – 24awg Red Wire; Pin 16; Pin 13; Pin 14; Pin 11; Pin 12; Pin 2; Pin 3; Pin 9; Pin 19; 1x [EL-MS0251] Female 16pin Housing; Pin 4; Pin 5; Pin 10; Pin 7; Pin 8

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

Notes: Unless otherwise specified
Cut length +/- 3mm
Molex strip length +/-0.5mm

Molex-CONN PLUG 20POS
3MM VERT DUAL, BLACK

[EL-WR0107] – 24awg White Wire

[EL-WR0119] – 24awg Green Wire

[EL-WR0105] – 24awg Black Wire

[EL-WR0103] – 24awg Red Wire

Female Molex Pin

[EL-WR0111] – 24awg Blue Wire

[EL-WR0109] – 24awg Yellow Wire

[EL-WR0104] – 24awg Orange Wire

Extruder Harness
Connect Label
Applied to
PIN 1 (arrow)
Side of Connector

DRAWN BY DRAWN BY West | DATE 5/13/19

TITLE
Dual V3 Adapter Harness

Rev | Date | Changes | Change By | CHECKED BY | DATE

A | 7/24/19 | Add sticker callout, and sticker pn to bom | West

AO part number | qty | UoM | Supplier | supplier pn
EL-WR0103 | 180 | mm | Allcable | HU1569247RD
EL-WR0107 | 120 | mm | Allcable | HU1569247WE
EL-WR0119 | 120 | mm | Allcable | HU1569247GN
EL-WR0105 | 60 | mm | Allcable | HU1569247BK
EL-WR0111 | 60 | mm | Allcable | HU1569247BE
EL-WR0109 | 60 | mm | Allcable | HU1569247YW
EL-WR0104 | 60 | mm | Allcable | HU1569247OE
EL-MS0059 | 12 | mm | TTI global | 16-02-0086
EL-MS0251 | 1 | pce | TTI global | 22552161
EL-MS0480 | 12 | mm | TTI global | 43031-0001
PC-CN0101 | 1 | pce | TTI global | 43020-2001
DC-LB0104 | 1 | pce | Sticker Giant | -
