joeyliu522/VVI-project/CAD files/Older 3D printed parts/production_parts/electronics/toolhead/EL-HR0187_taz_extruder_extension_v4.0_revB.pdf

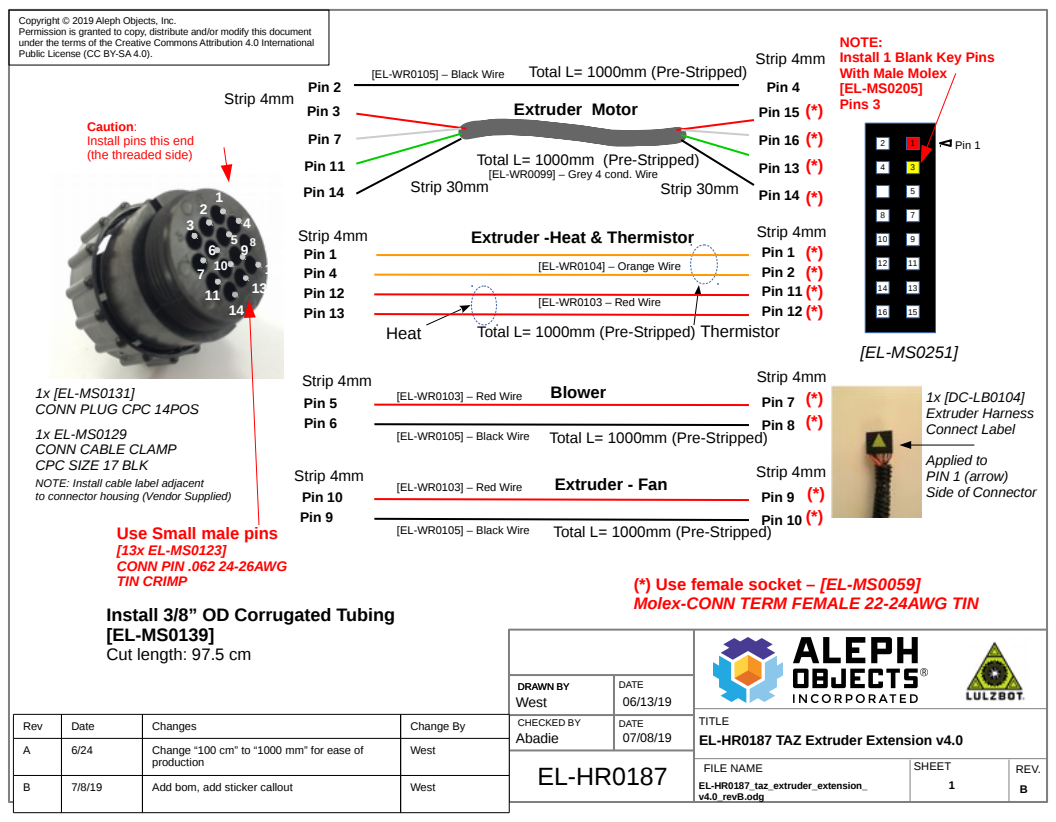
[picture p109: page 1]
FILE NAME; SHEET; REV.; EL-HR0187_taz_extruder_extension_ v4.0_revB.odg; Extruder Motor; Strip 30mm; Thermistor; Heat; Extruder - Fan; Blower; Pin 2; Pin 3; Pin 7; Pin 11; Pin 14 1; Pin 1 Pin 4 Pin 12 Pin 13; Pin 15; Pin 16; Pin 13; Pin 14; Pin 1 Pin 2 Pin 11 Pin 12; Strip 4mm; Pin 5 Pin 6; Pin 8; Pin 9; Pin 10; NOTE: Install 1 Blank Key Pins With Male Molex [EL-MS0205] Pins 3; Pin 1; Pin 4; [EL-WR0105] – Black Wire; Total L= 1000mm (Pre-Stripped); 1x [DC-LB0104] Extruder Harness Connect Label

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

Caution:
Install pins this end
(the threaded side)

Total L= 1000mm (Pre-Stripped)
[EL-WR0099] – Grey 4 cond. Wire

Extruder -Heat & Thermistor

[EL-WR0104] – Orange Wire

[EL-WR0103 – Red Wire

CONN PLUG CPC 14POS
CONN CABLE CLAMP
CPC SIZE 17 BLK
NOTE: Install cable label adjacent
to connector housing (Vendor Supplied)

[EL-WR0103] – Red Wire

[EL-WR0105] – Black Wire

Applied to
PIN 1 (arrow)
Side of Connector

Use Small male pins
CONN PIN .062 24-26AWG
TIN CRIMP
Molex-CONN TERM FEMALE 22-24AWG TIN Install 3/8” OD Corrugated Tubing
Cut length: 97.5 cm

(*) Use female socket – [EL-MS0059]

DRAWN BY DRAWN BY West | DATE 06/13/19

TITLE
EL-HR0187 TAZ Extruder Extension v4.0

Rev | Date | Changes | Change By | CHECKED BY Abadie | DATE 07/08/19

A | 6/24 | Change “100 cm” to “1000 mm” for ease of production | West

B | 7/8/19 | Add bom, add sticker callout | West

AO part number | qty | UoM | Supplier | supplier pn
EL-MS0131 | 1 | pce | Sager | 206044-1
EL-MS0129 | 1 | pce | Heilind | 206070-8
EL-WR0105 | 3000 | mm | Allcable | HU1569247BK
EL-WR0099 | 1000 | mm | Allcable | C0762A.41.10
EL-WR0104 | 2000 | mm | Allcable | HU1569247OE
EL-WR0103 | 4000 | mm | Allcable | HU1569247RD
EL-MS0251 | 1 | pce | TTI global | 22552161
EL-MS0205 | 1 | pce | TTI global | 16-02-0107
EL-MS0059 | 13 | pce | TTI global | 16-02-0086
DC-LB0104 | 1 | pce | Sticker Giant | -
EL-MS0139 | 975 | mm | Electronics Distributors Corp | 88-00012
