joeyliu522/VVI-project/CAD files/Older 3D printed parts/production_parts/hot_end/e3d_hot_tightened_assembly/TITAN-HOBB (Edition 2).pdf

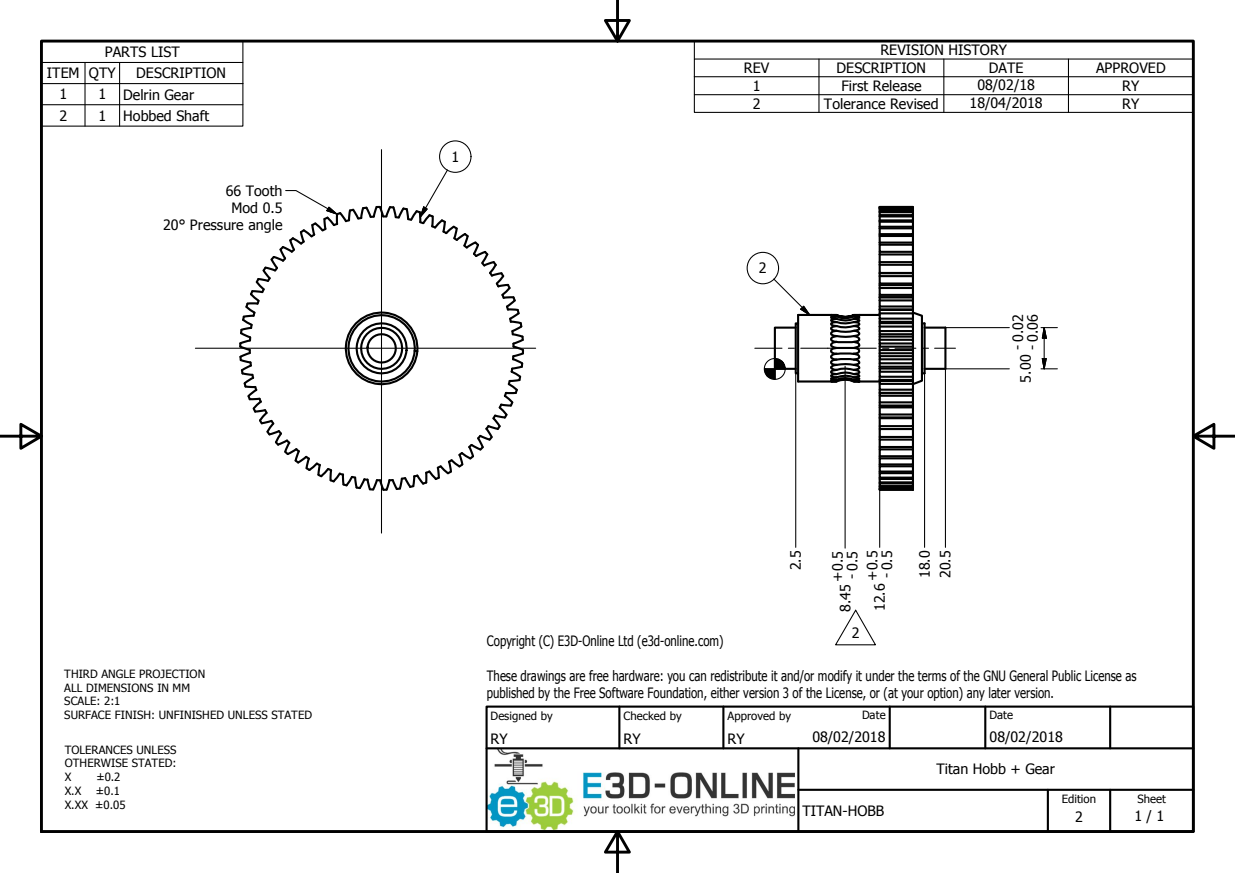
[picture p110: page 1]
PARTS LIST; ITEM; QTY; DESCRIPTION; Delrin Gear; Hobbed Shaft; TITAN-HOBB; Designed by; Checked by; Approved by; Date; Edition; Sheet; TOLERANCES UNLESS OTHERWISE STATED:; REVISION HISTORY; REV; DATE; APPROVED; First Release; Tolerance Revised; 66 Tooth Mod 0.5 20° Pressure angle

Copyright (C) E3D-Online Ltd (e3d-online.com)

THIRD ANGLE PROJECTION
ALL DIMENSIONS IN MM
SCALE: 2:1
SURFACE FINISH: UNFINISHED UNLESS STATED

These drawings are free hardware: you can redistribute it and/or modify it under the terms of the GNU General Public License as
published by the Free Software Foundation, either version 3 of the License, or (at your option) any later version.

Titan Hobb + Gear
