joeyliu522/VVI-project/CAD files/Older 3D printed parts/production_parts/machined_parts/bed_mount_plate/bed_mount_plate_revF.pdf

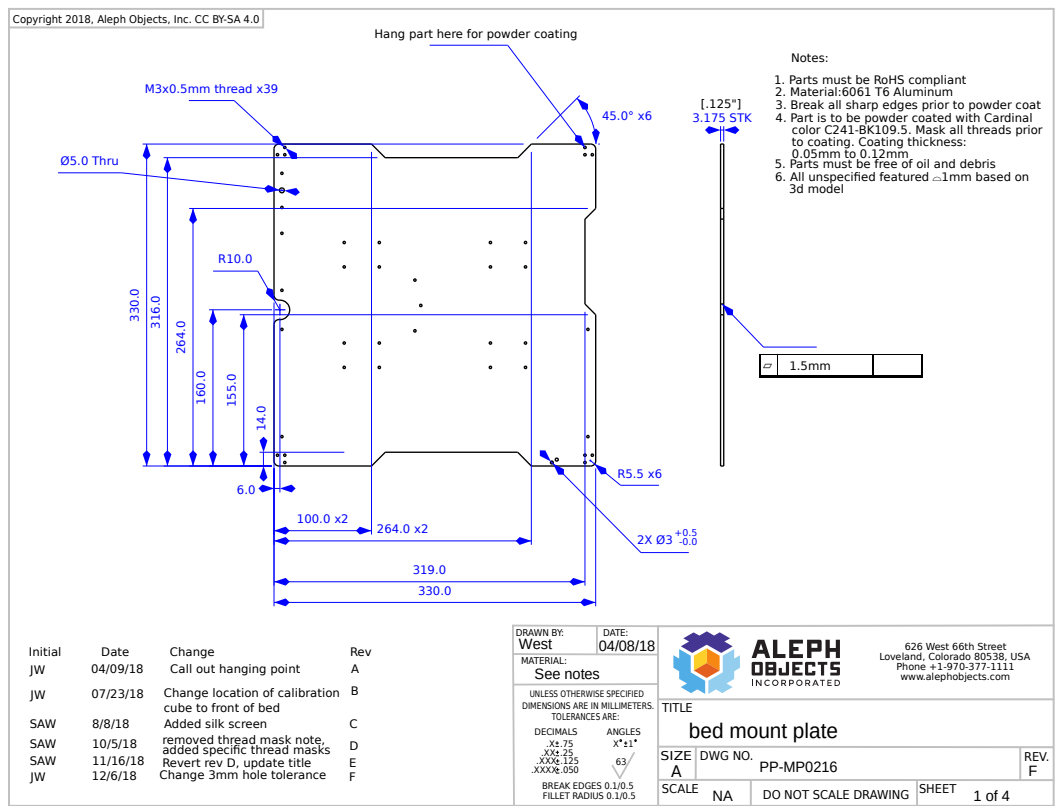
[picture p112: page 1]
3.175 STK; Ø5.0 Thru; 5. Parts must be free of oil and debris; M3x0.5mm thread x39; Initial; Date; Change; Call out hanging point; Rev A; Change location of calibration; SAW; Added silk screen; removed thread mask note,; added specific thread masks; Revert rev D, update title; Change 3mm hole tolerance; ANGLES; MATERIAL:; DRAWN BY:; SIZE; SCALE; SHEET; DWG NO.; REV.; West; DATE:; See notes

Copyright 2018, Aleph Objects, Inc. CC BY-SA 4.0

Hang part here for powder coating

Notes:
1. Parts must be RoHS compliant
2. Material:6061 T6 Aluminum
3. Break all sharp edges prior to powder coat
4. Part is to be powder coated with Cardinal
color C241-BK109.5. Mask all threads prior
to coating. Coating thickness:
6. All unspecified featured ⌓1mm based on
3d model

626 West 66th Street
Loveland, Colorado 80538, USA
Phone +1-970-377-1111
www.alephobjects.com

UNLESS OTHERWISE SPECIFIED
DIMENSIONS ARE IN MILLIMETERS.
TOLERANCES ARE:
DECIMALS
.XXX .125
.XXXX .050
BREAK EDGES 0.1/0.5
FILLET RADIUS 0.1/0.5

cube to front of bed

TITLE
bed mount plate

DO NOT SCALE DRAWING

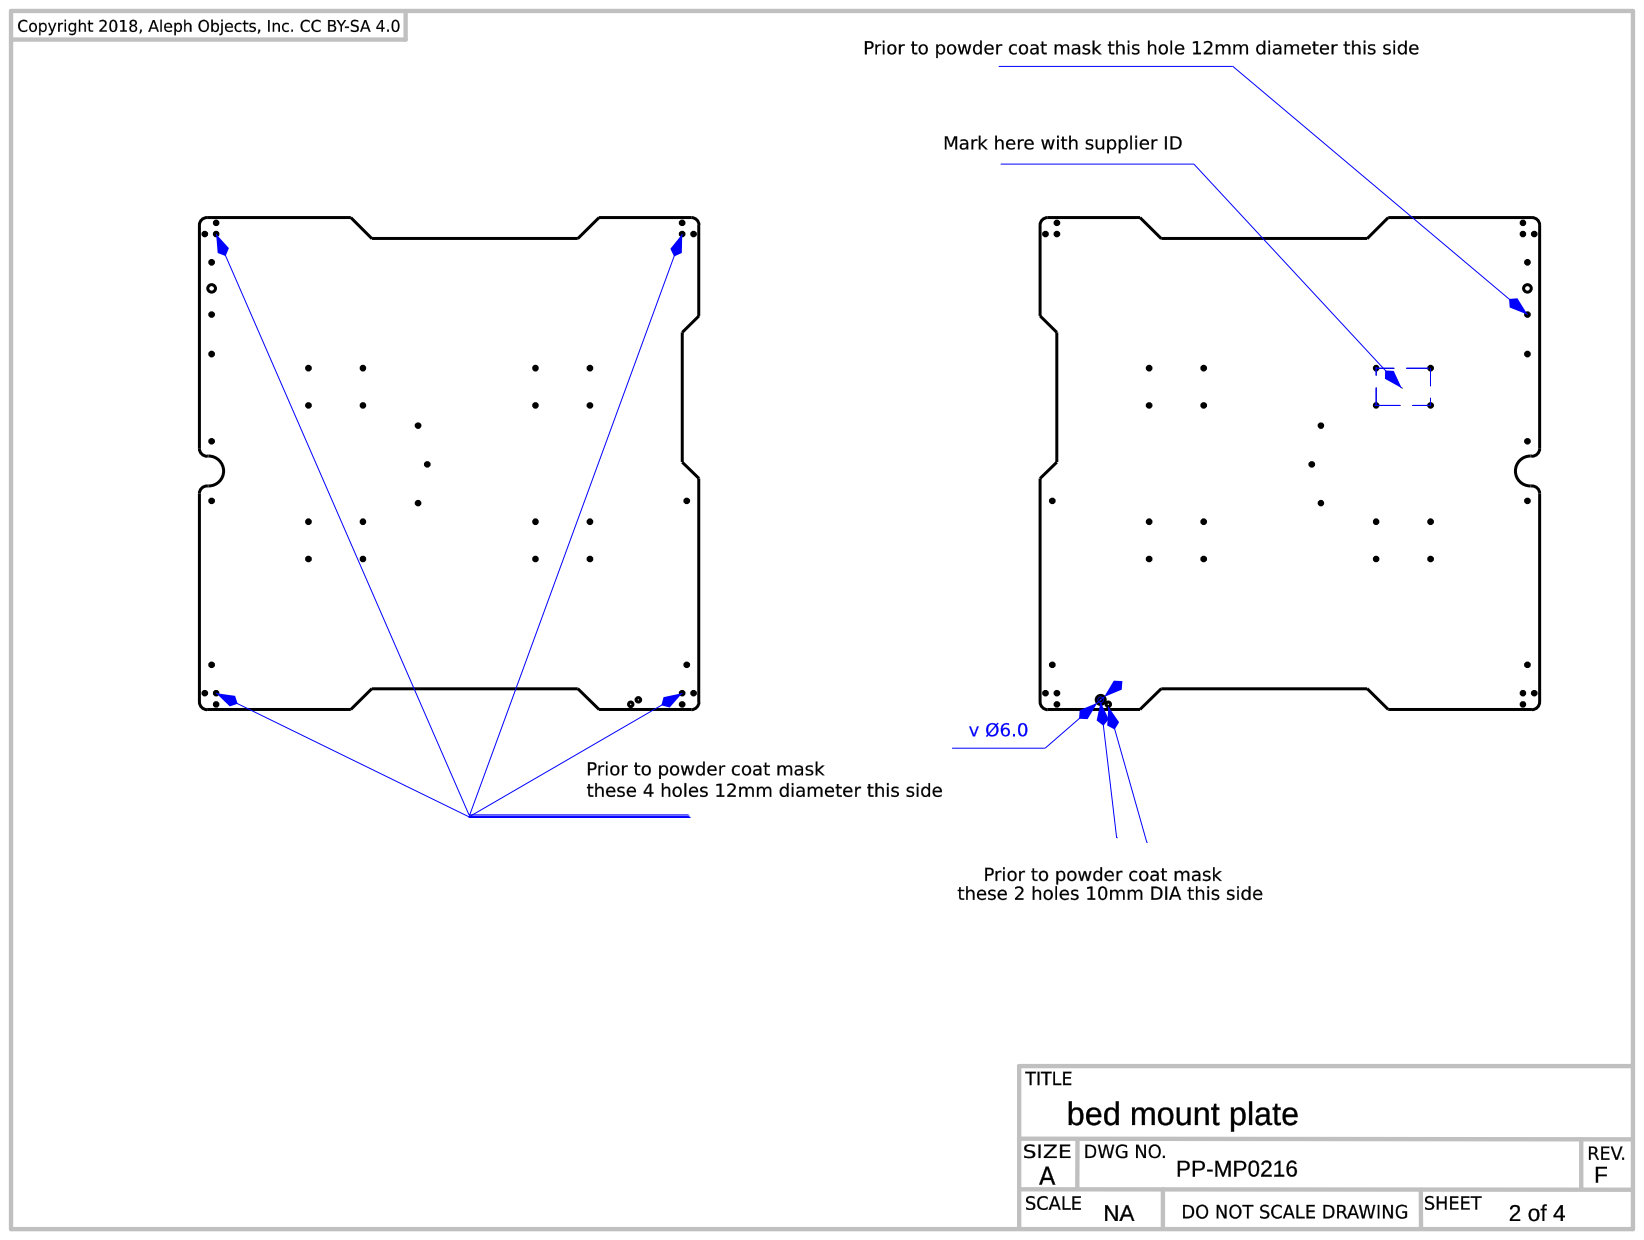
[picture p113: page 2]

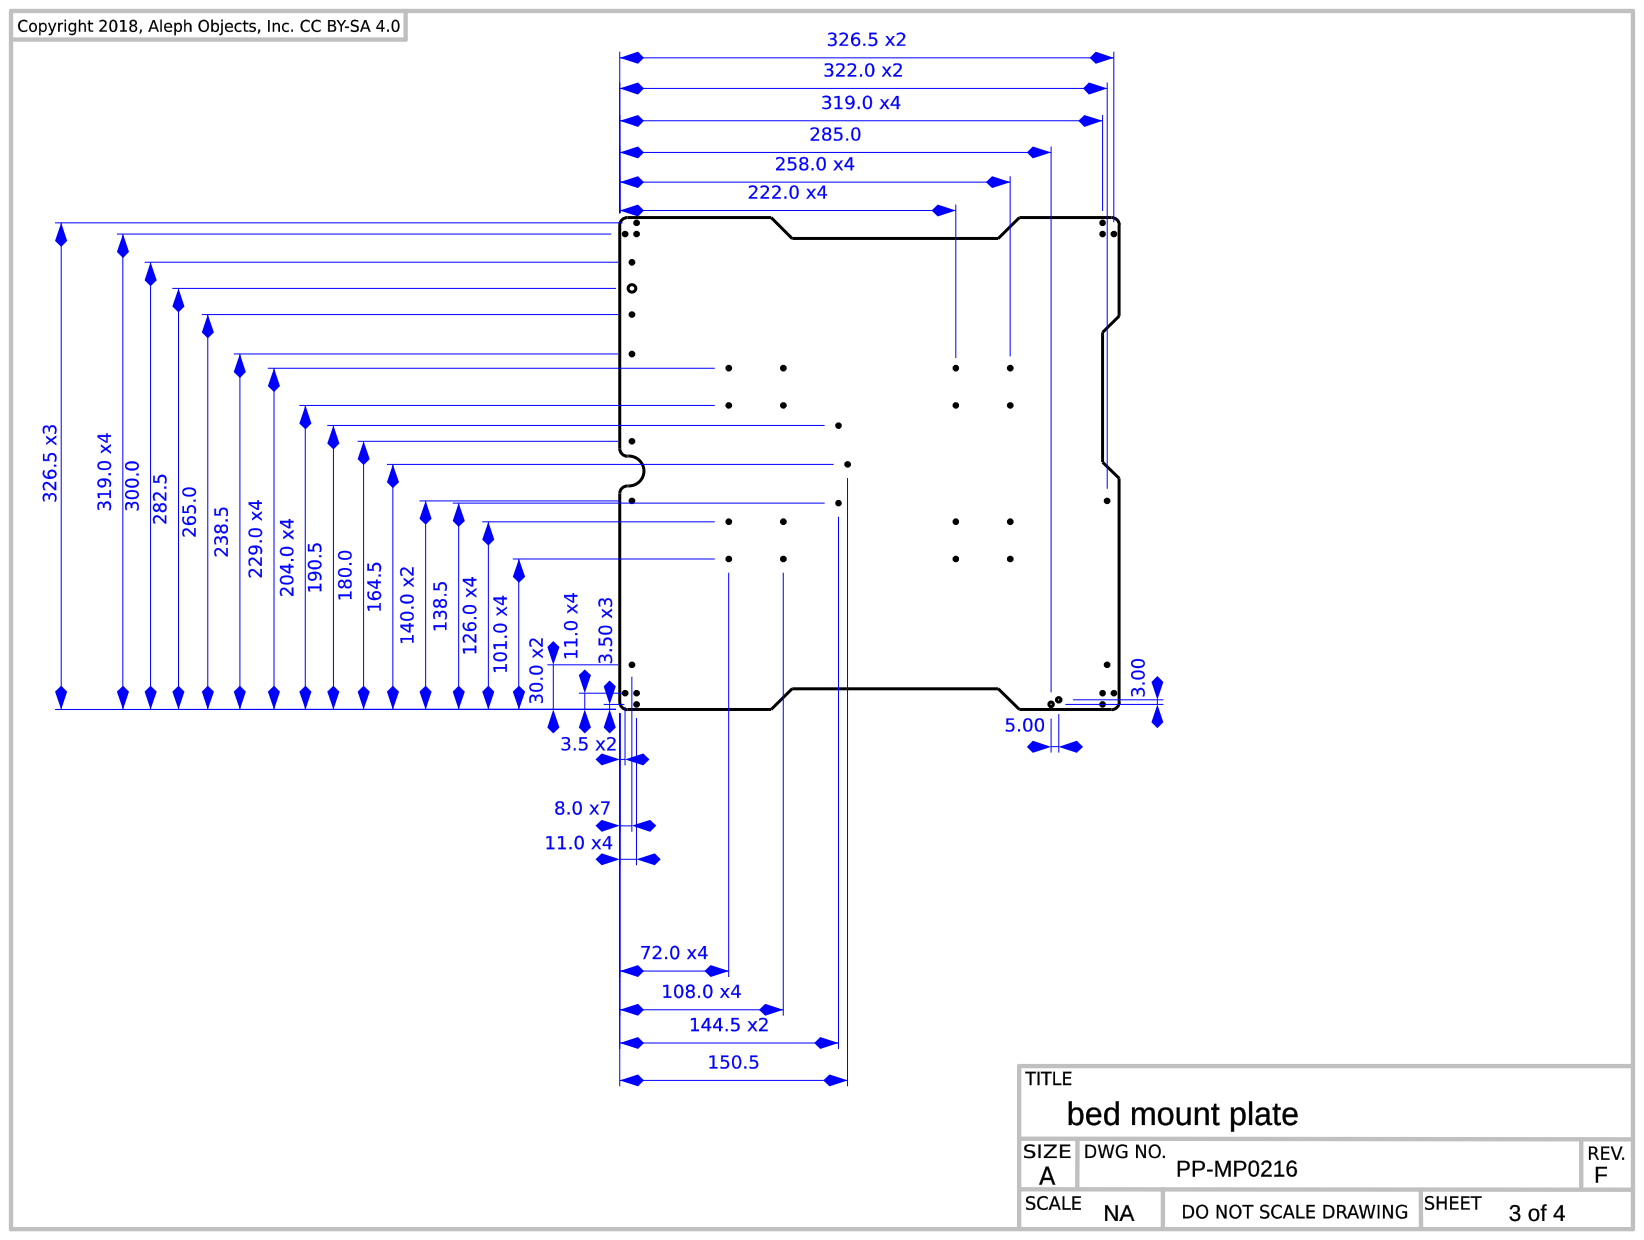
[picture p114: page 3]

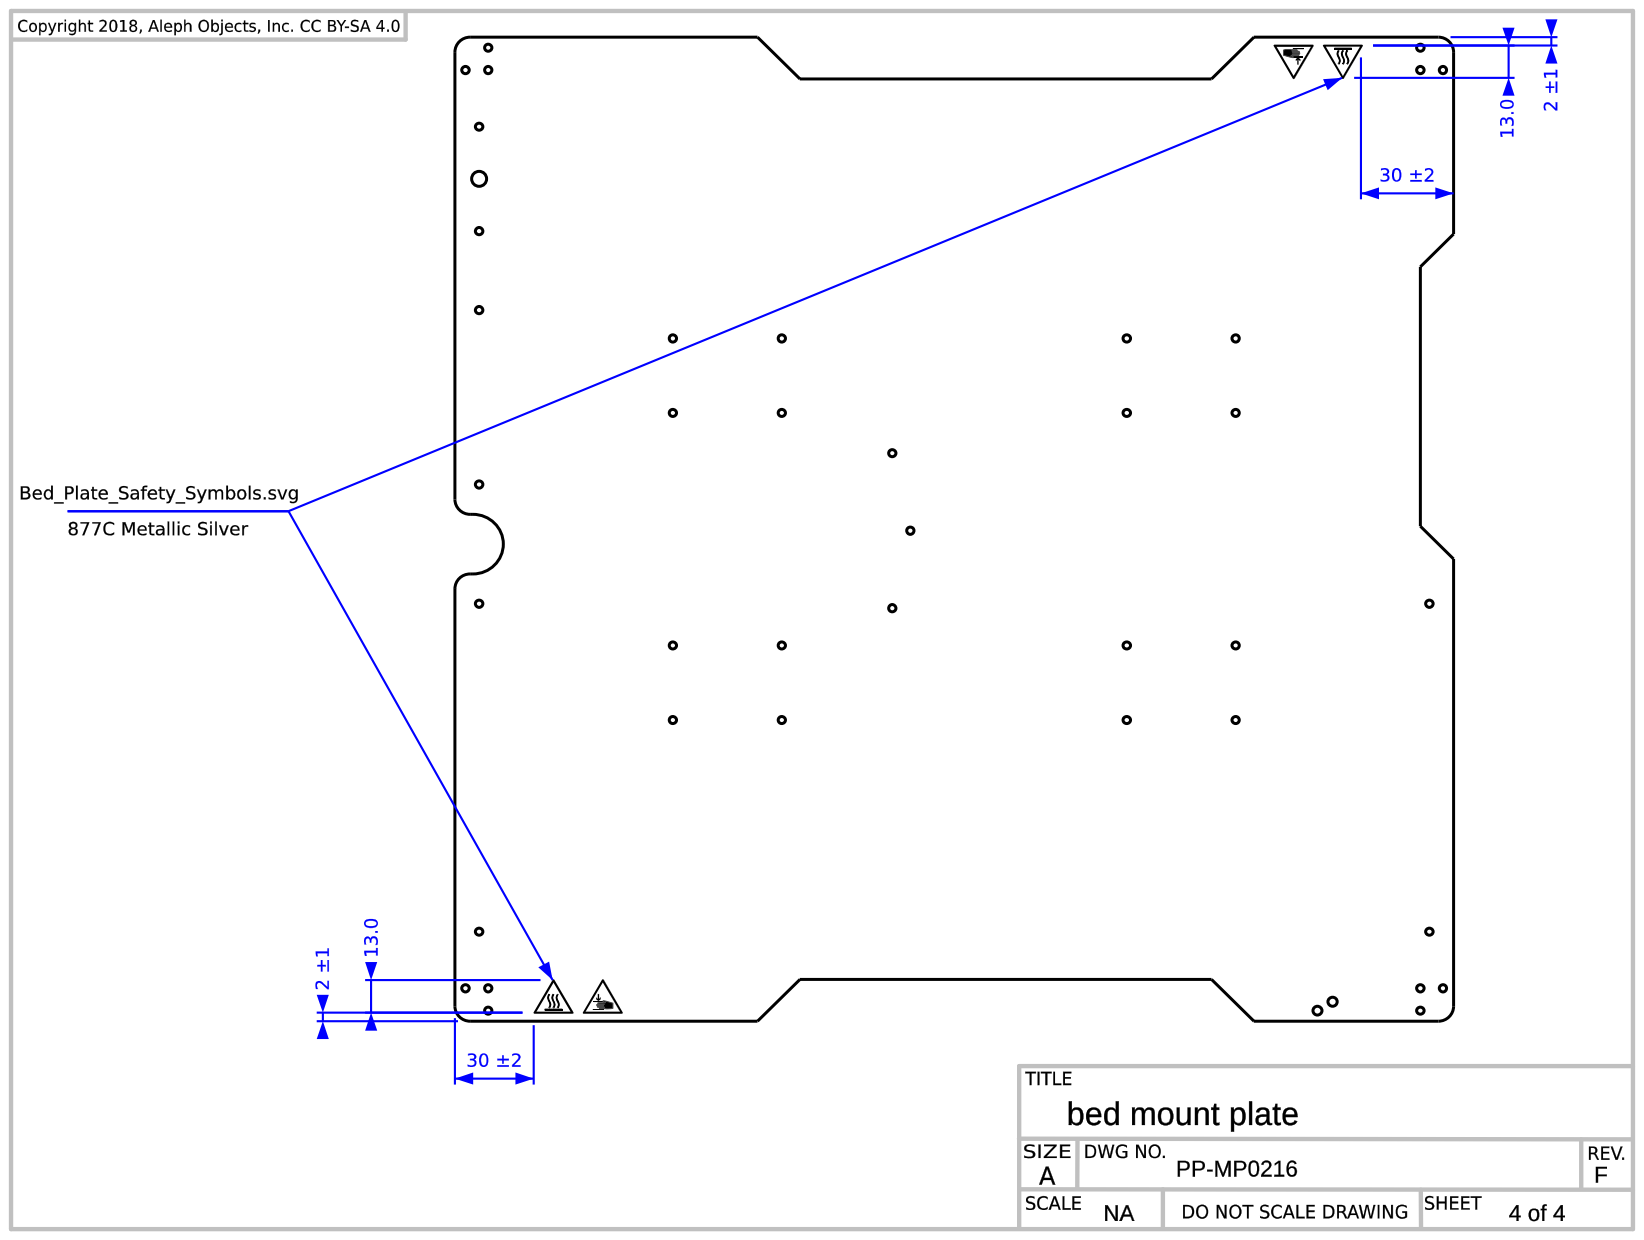
[picture p115: page 4]
