joeyliu522/VVI-project/CAD files/Older 3D printed parts/documentation/Quick_Start_Guide/TAZ_Workhorse_QuickStartGuide_Cover.pdf

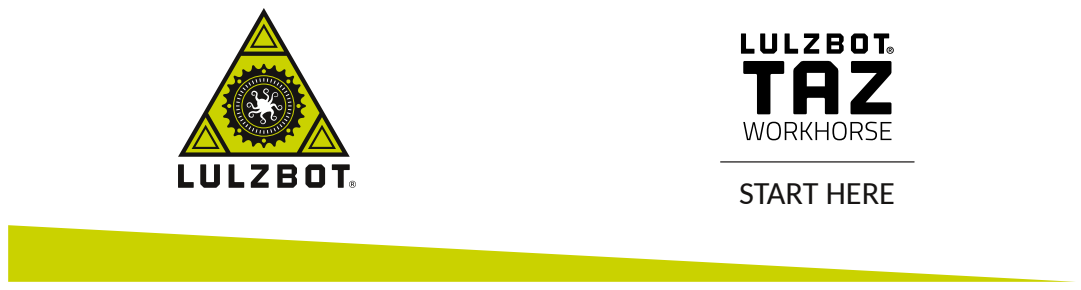
[picture p116: page 1]
START HERE

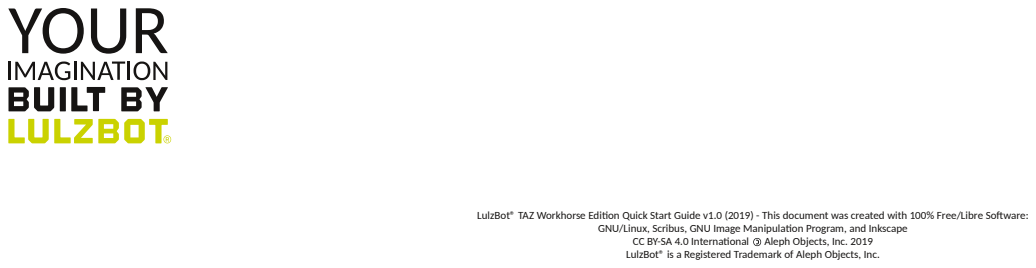
[picture p117: page 2]
CC BY-SA 4.0 Internaonal; Aleph Objects, Inc. 2019

LulzBot® TAZ Workhorse Edion Quick Start Guide v1.0 (2019) - This document was created with 100% Free/Libre Soware:

GNU/Linux, Scribus, GNU Image Manipulaon Program, and Inkscape

LulzBot® is a Registered Trademark of Aleph Objects, Inc.
