joeyliu522/VVI-project/CAD files/Older 3D printed parts/production_docs/compliance/safety_warnings_LulzBot_TAZWorkhorse.pdf

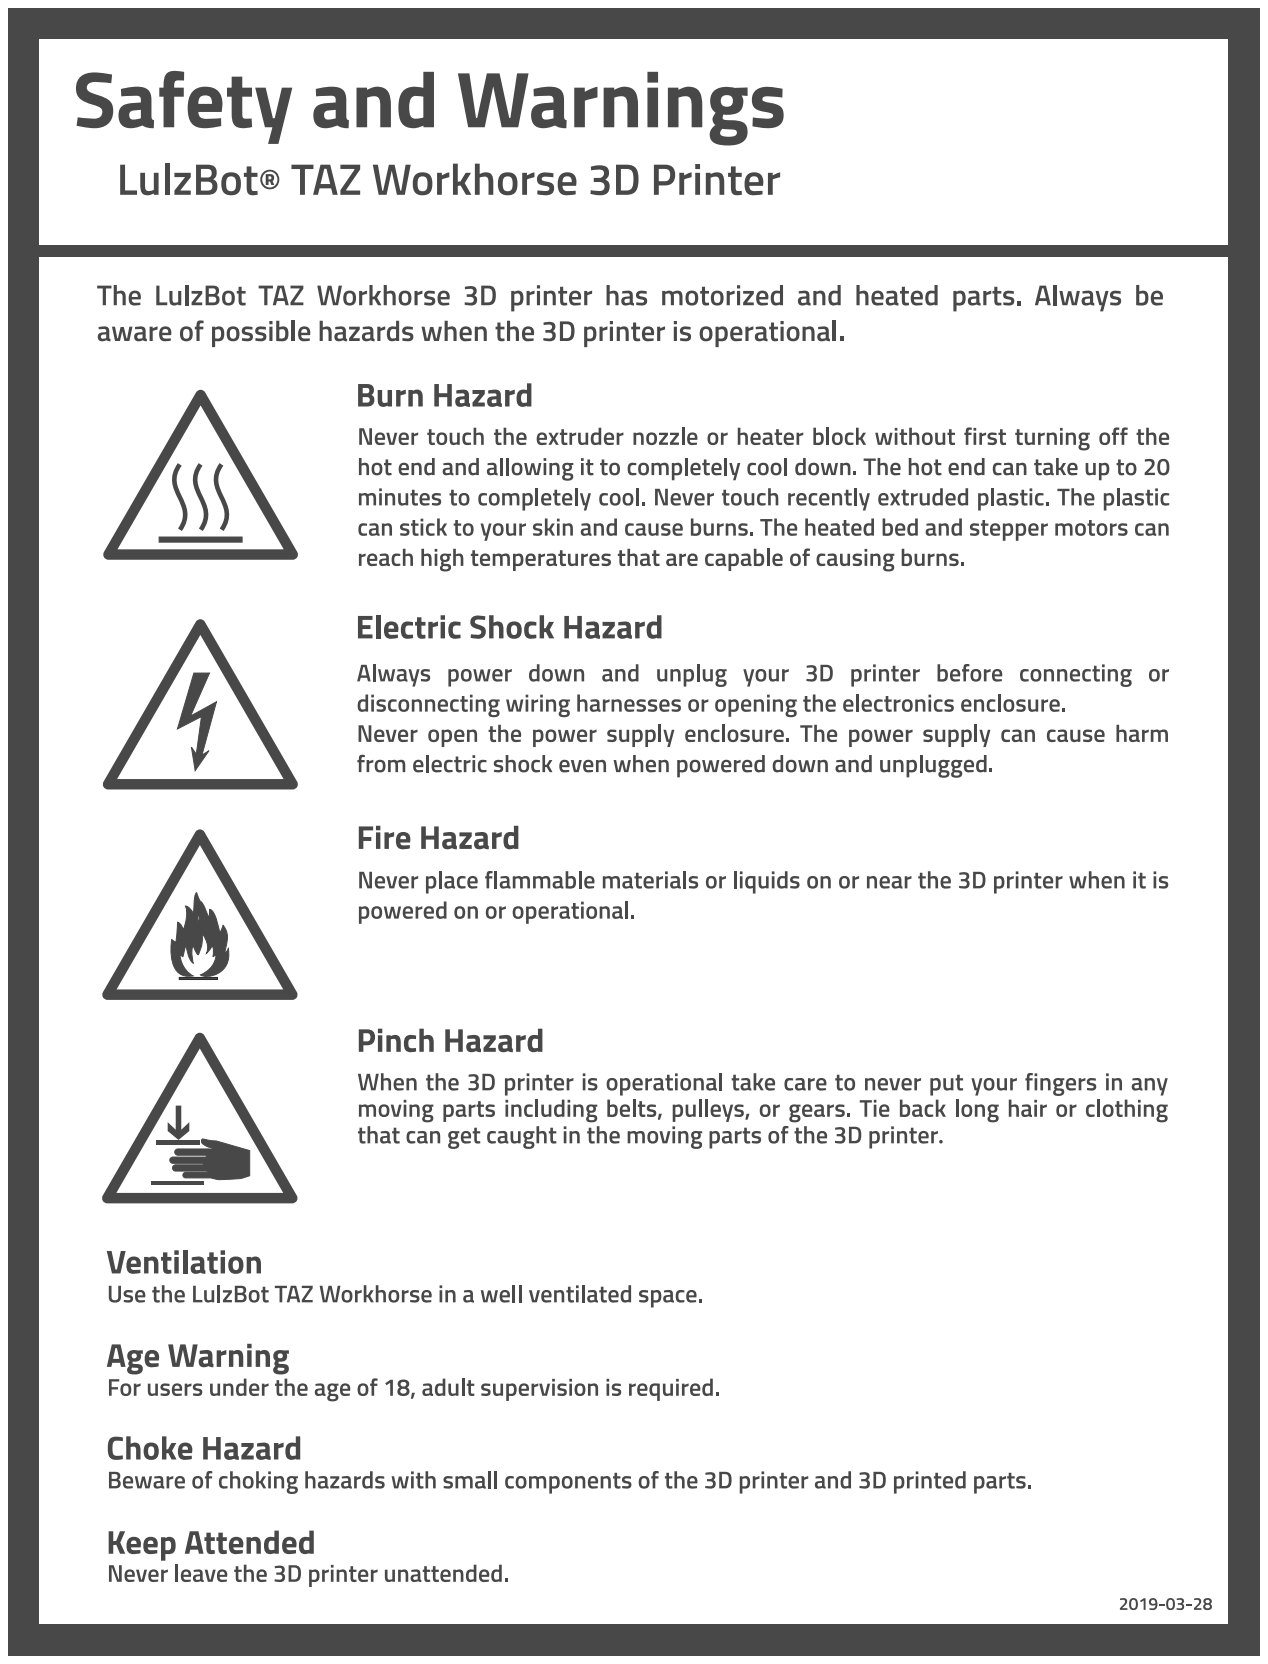
[picture p118: page 1]
