joeyliu522/VVI-project/CAD files/Older 3D printed parts/production_parts/assemblies/insert_assmeblies/AS-PR0127_x_idler_inserts.pdf

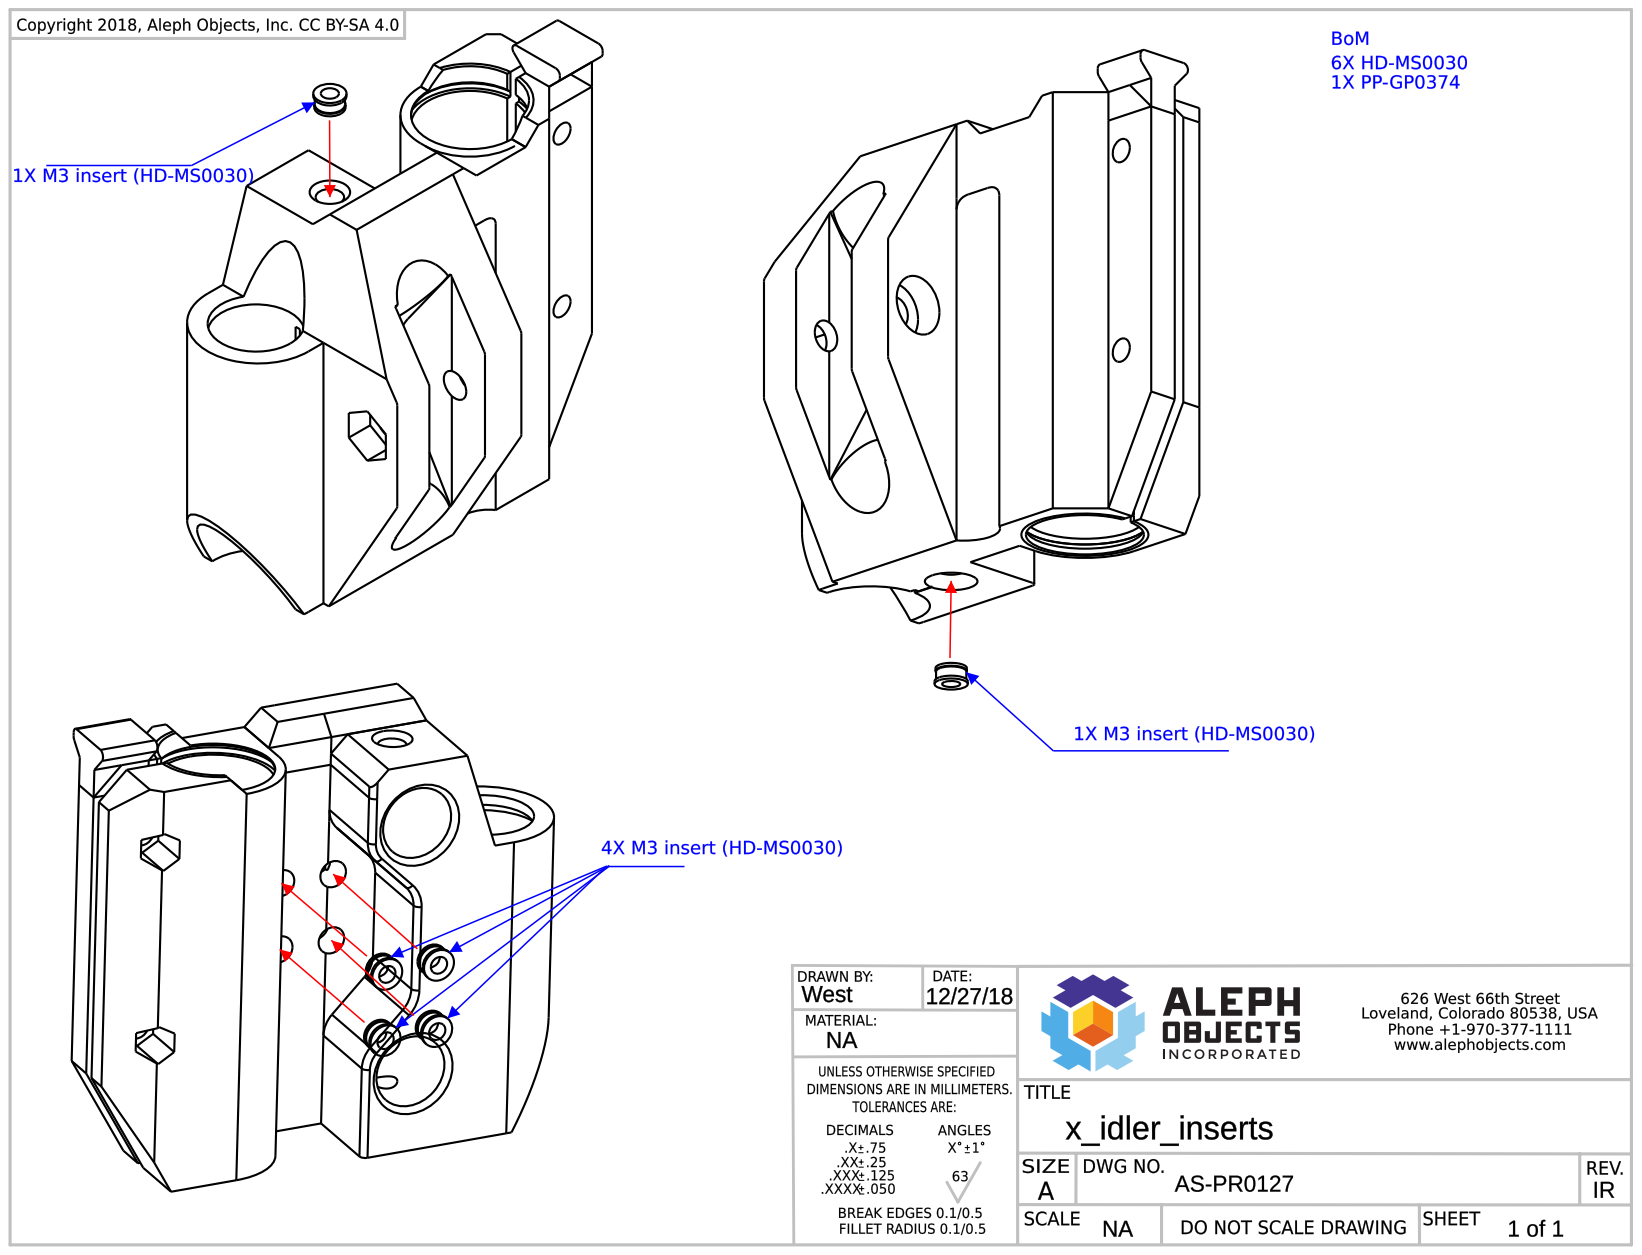
[picture p119: page 1]
