joeyliu522/VVI-project/CAD files/Older 3D printed parts/production_parts/assemblies/insert_assmeblies/AS-PR0158_x_carriage_sub_assembly.pdf

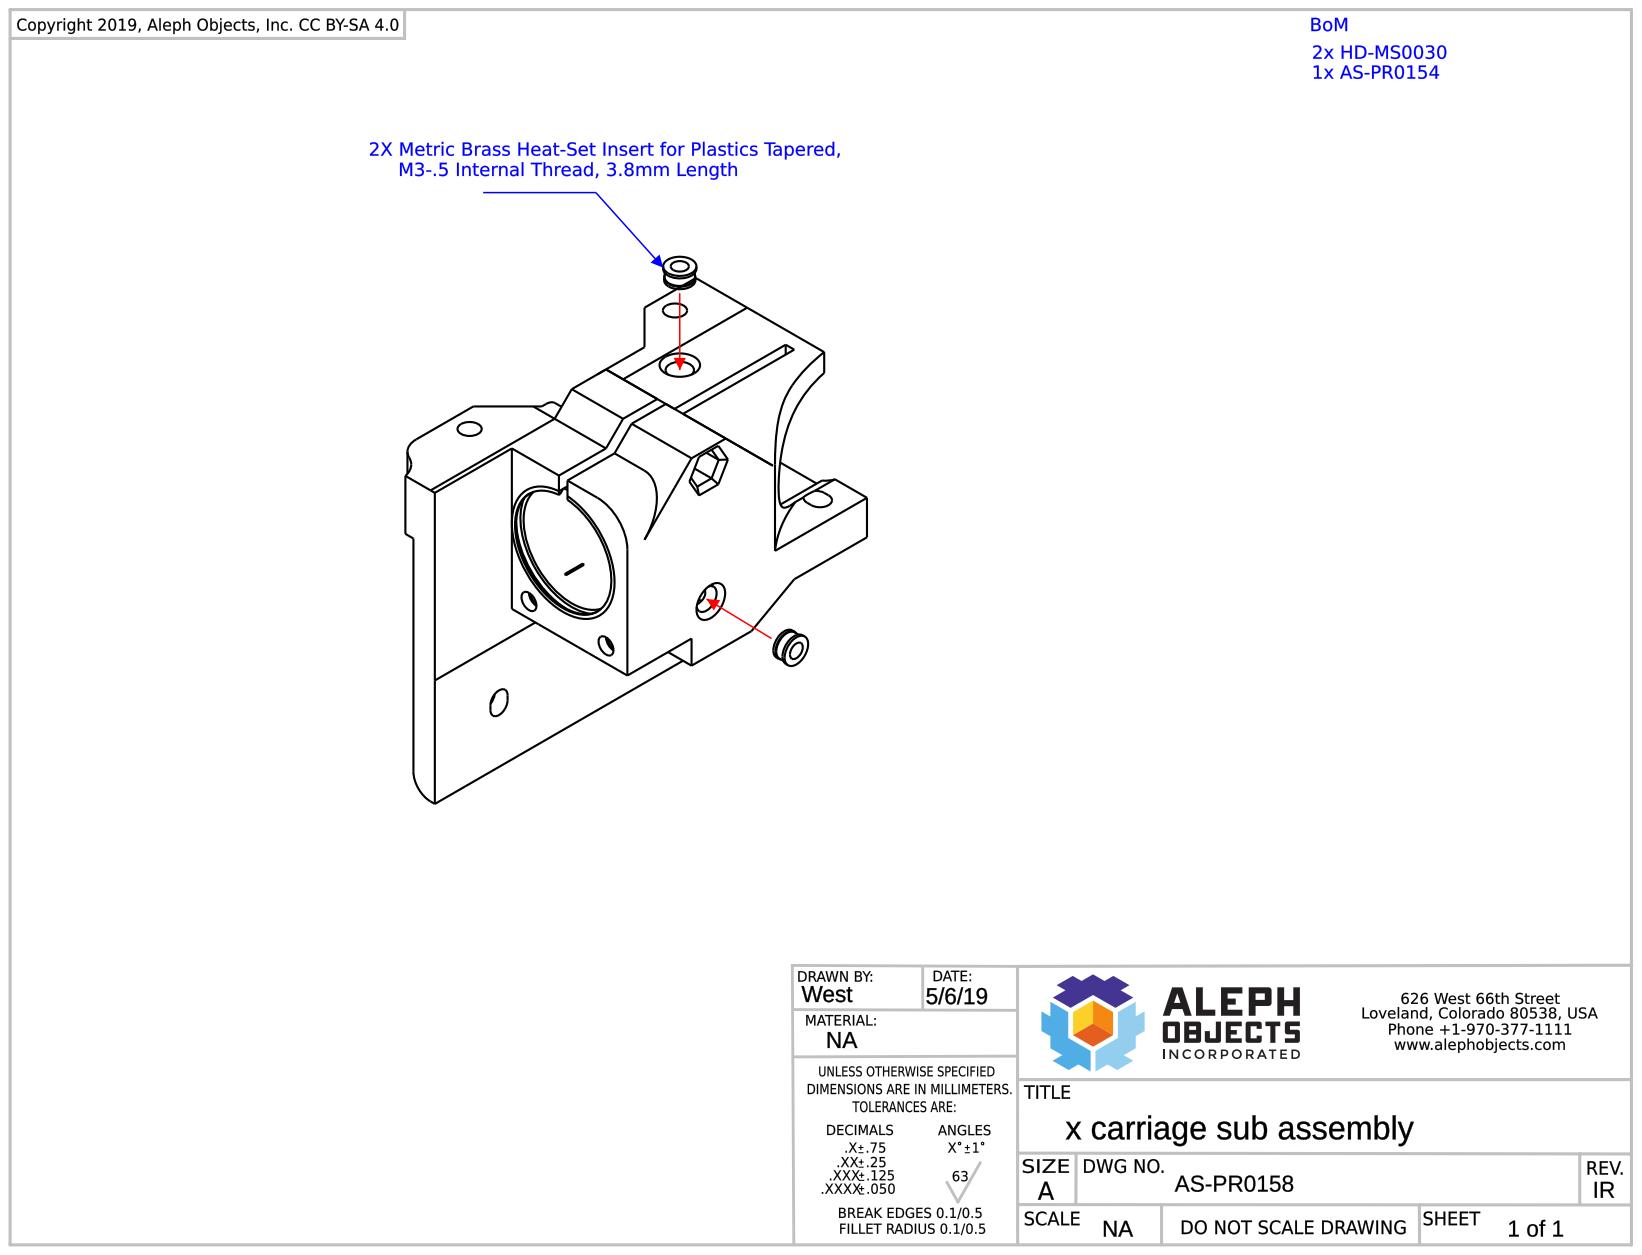
[picture p120: page 1]
