joeyliu522/VVI-project/CAD files/Older 3D printed parts/production_parts/assemblies/insert_assmeblies/AS-PR0159_x_double_bearing_holder_sub-assembly.pdf

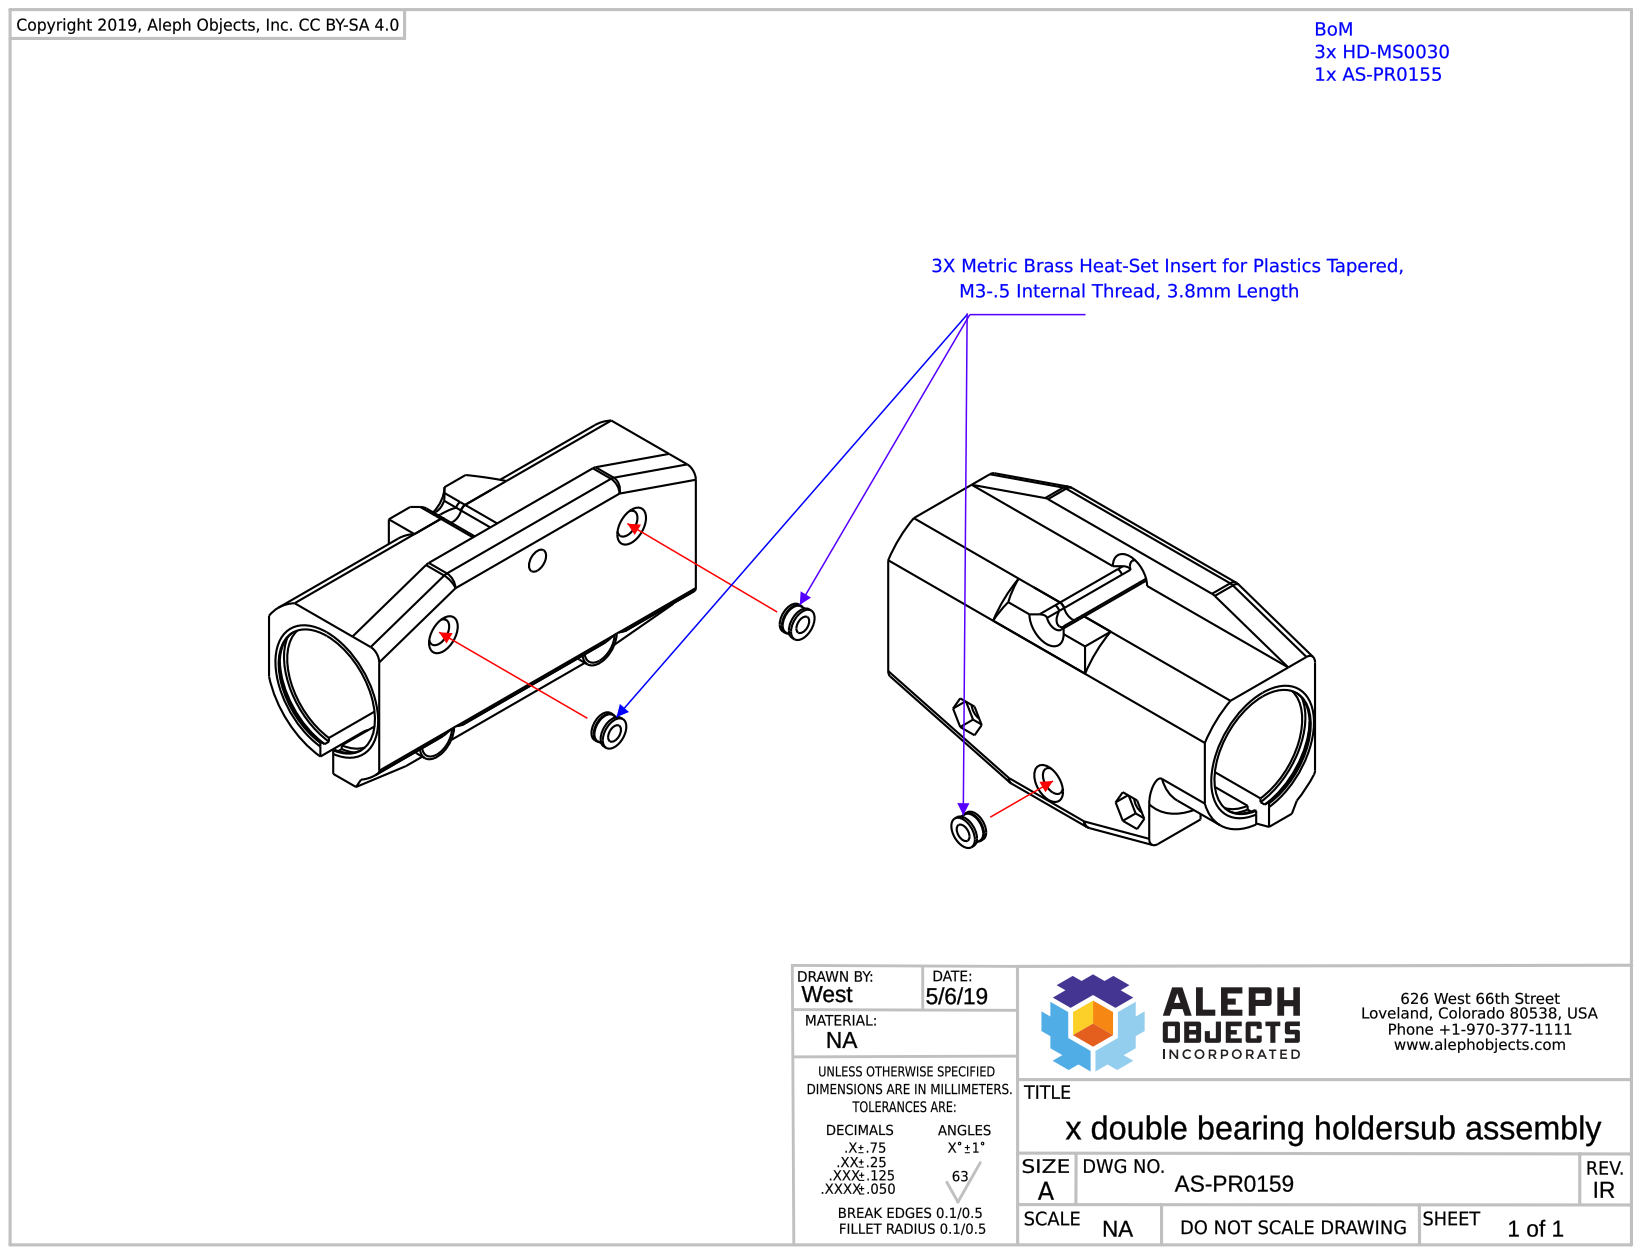
[picture p121: page 1]
