joeyliu522/VVI-project/CAD files/Older 3D printed parts/production_parts/assemblies/insert_assmeblies/AS-PR0160_x_motor_sub_assmebly.pdf

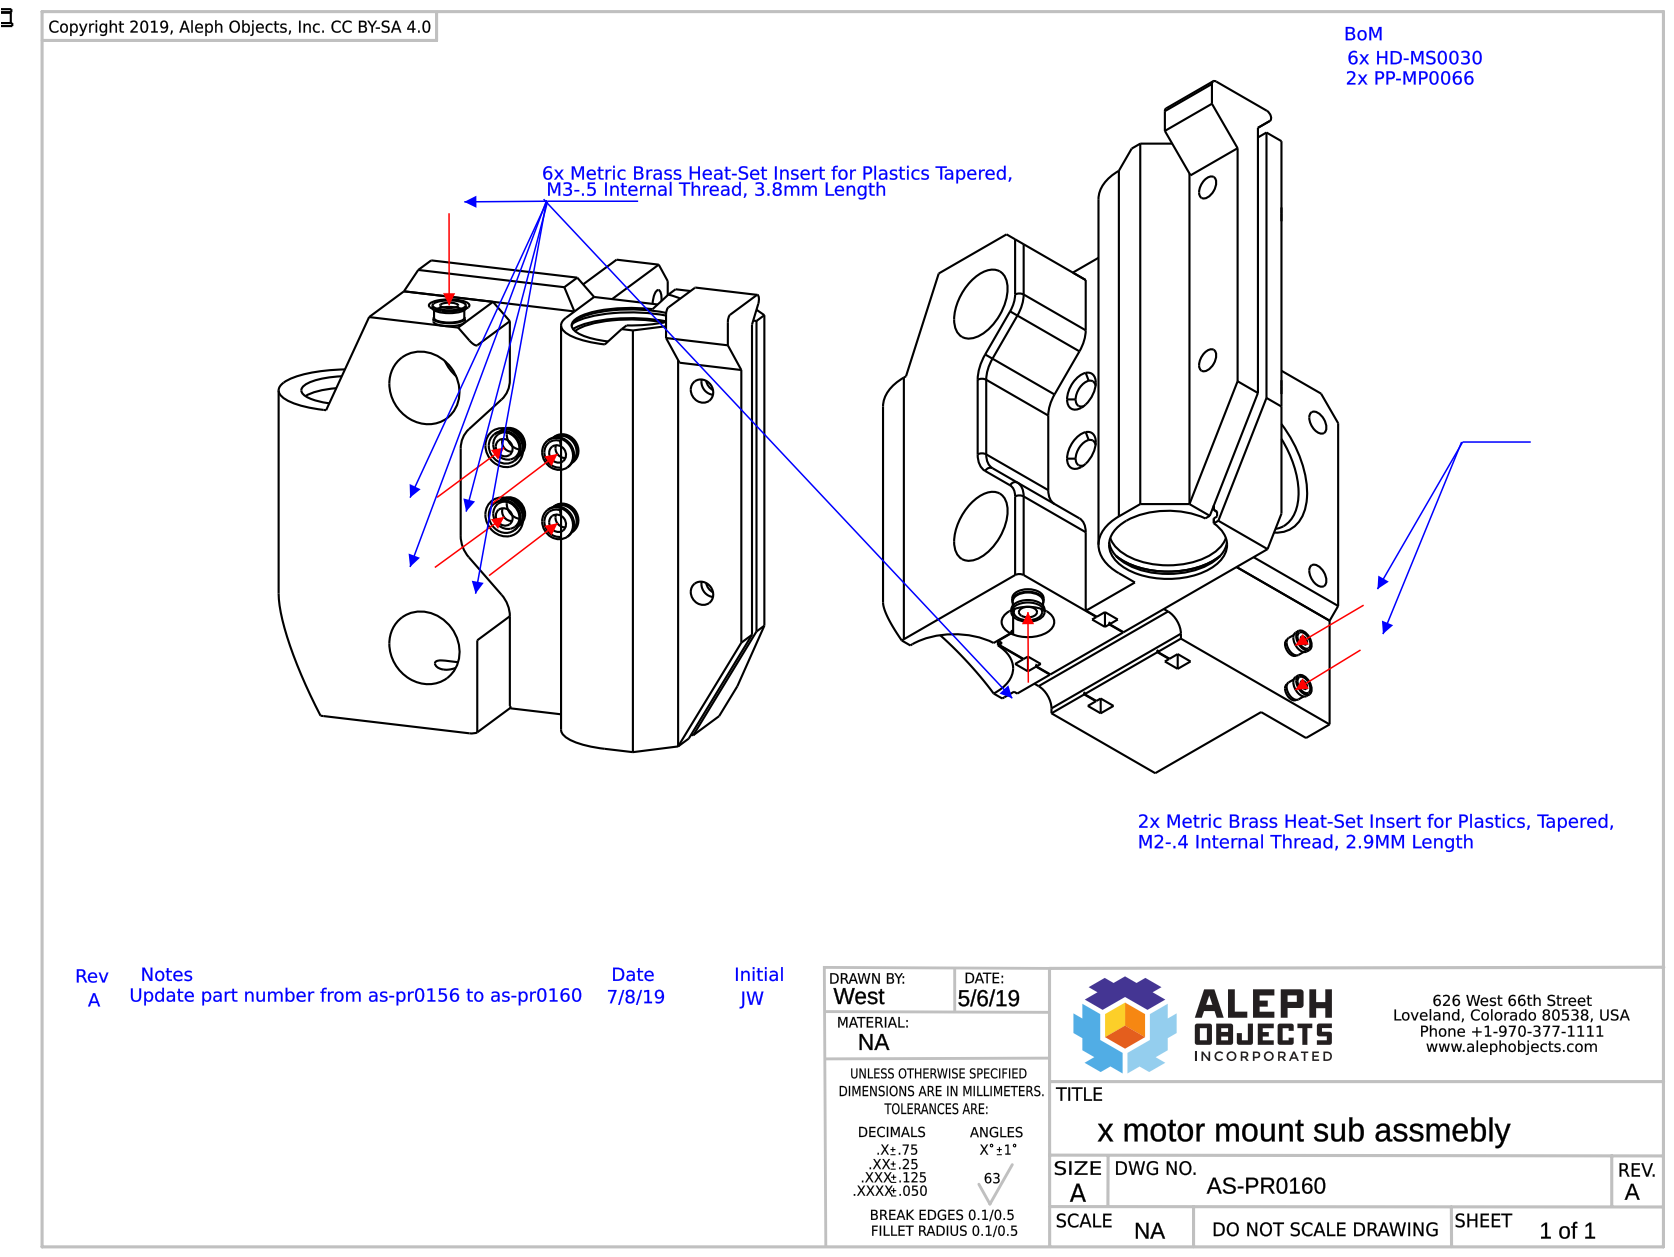
[picture p122: page 1]
