joeyliu522/VVI-project/CAD files/Older 3D printed parts/production_parts/assemblies/insert_assmeblies/PP-IS0053_extruder_mount_inserts.pdf

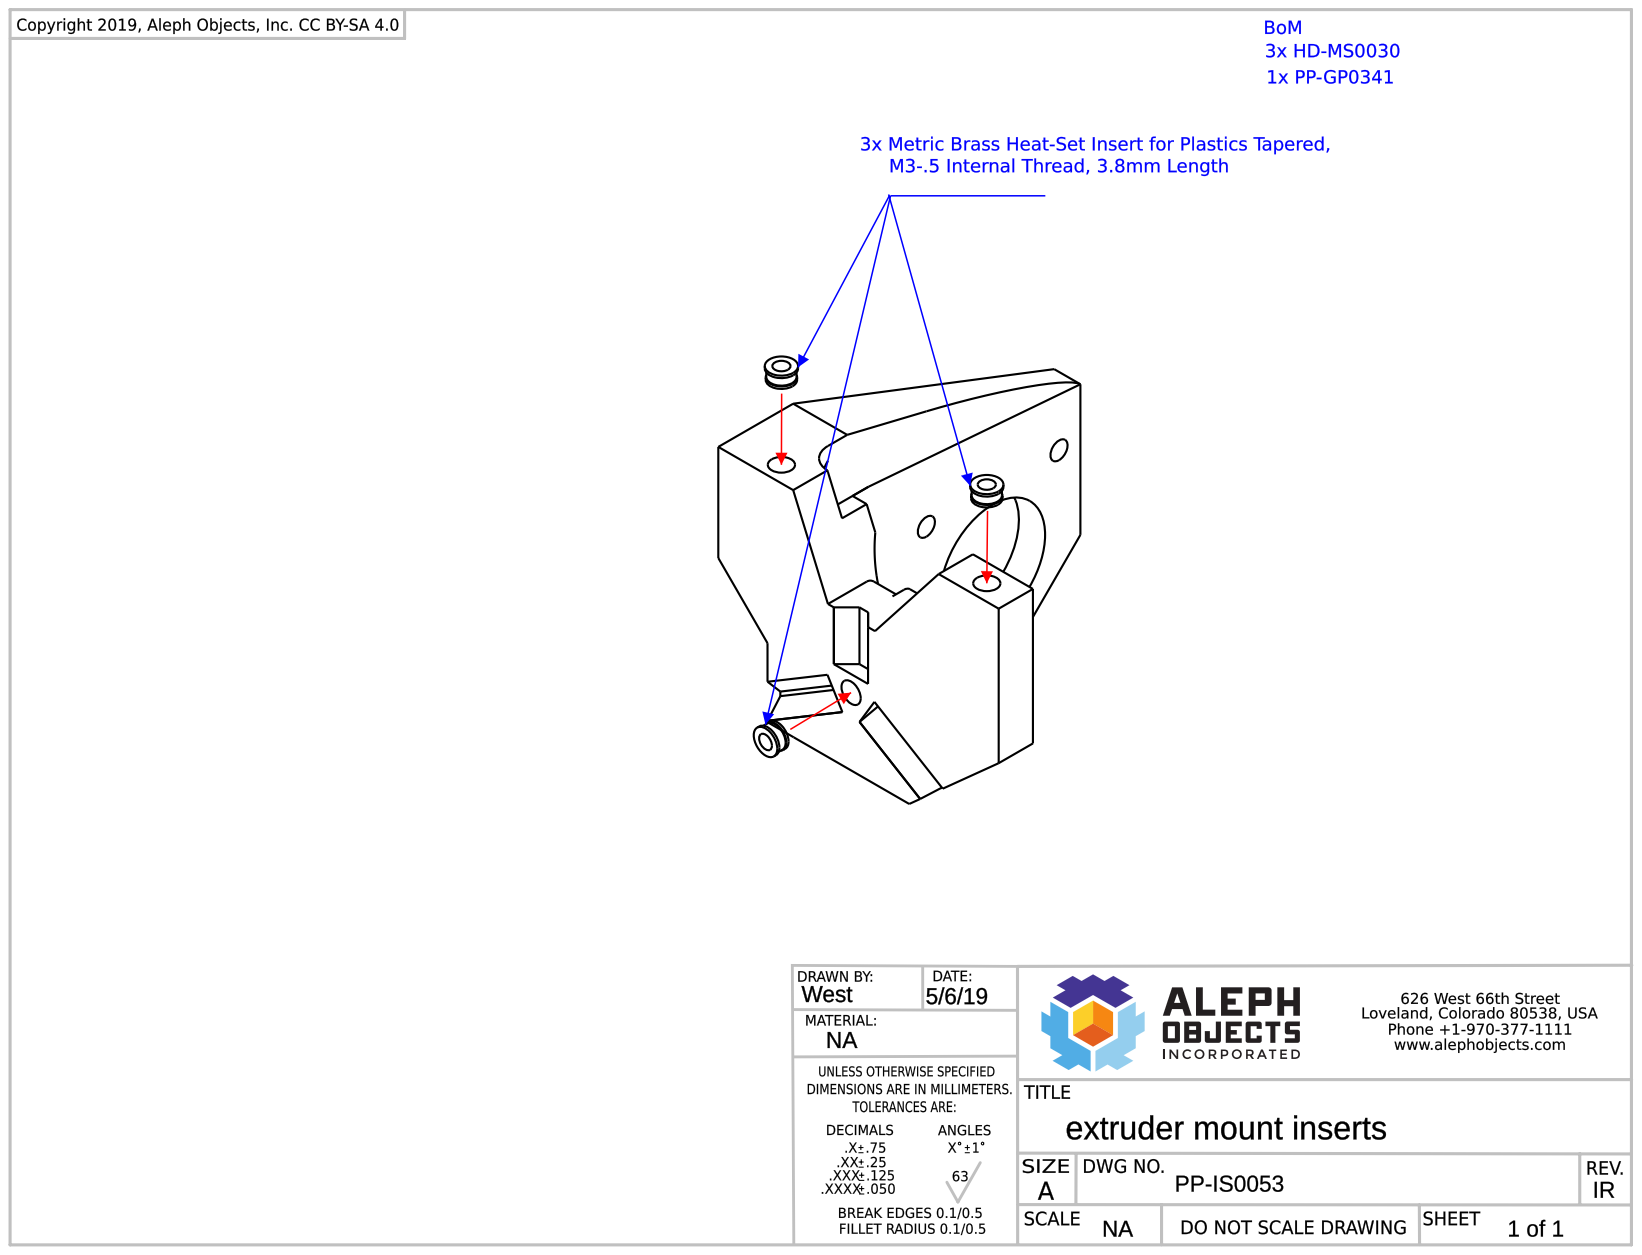
[picture p123: page 1]
