joeyliu522/VVI-project/CAD files/Older 3D printed parts/production_parts/assemblies/insert_assmeblies/PP-IS0057_universal_blower_shroud_inserts.pdf

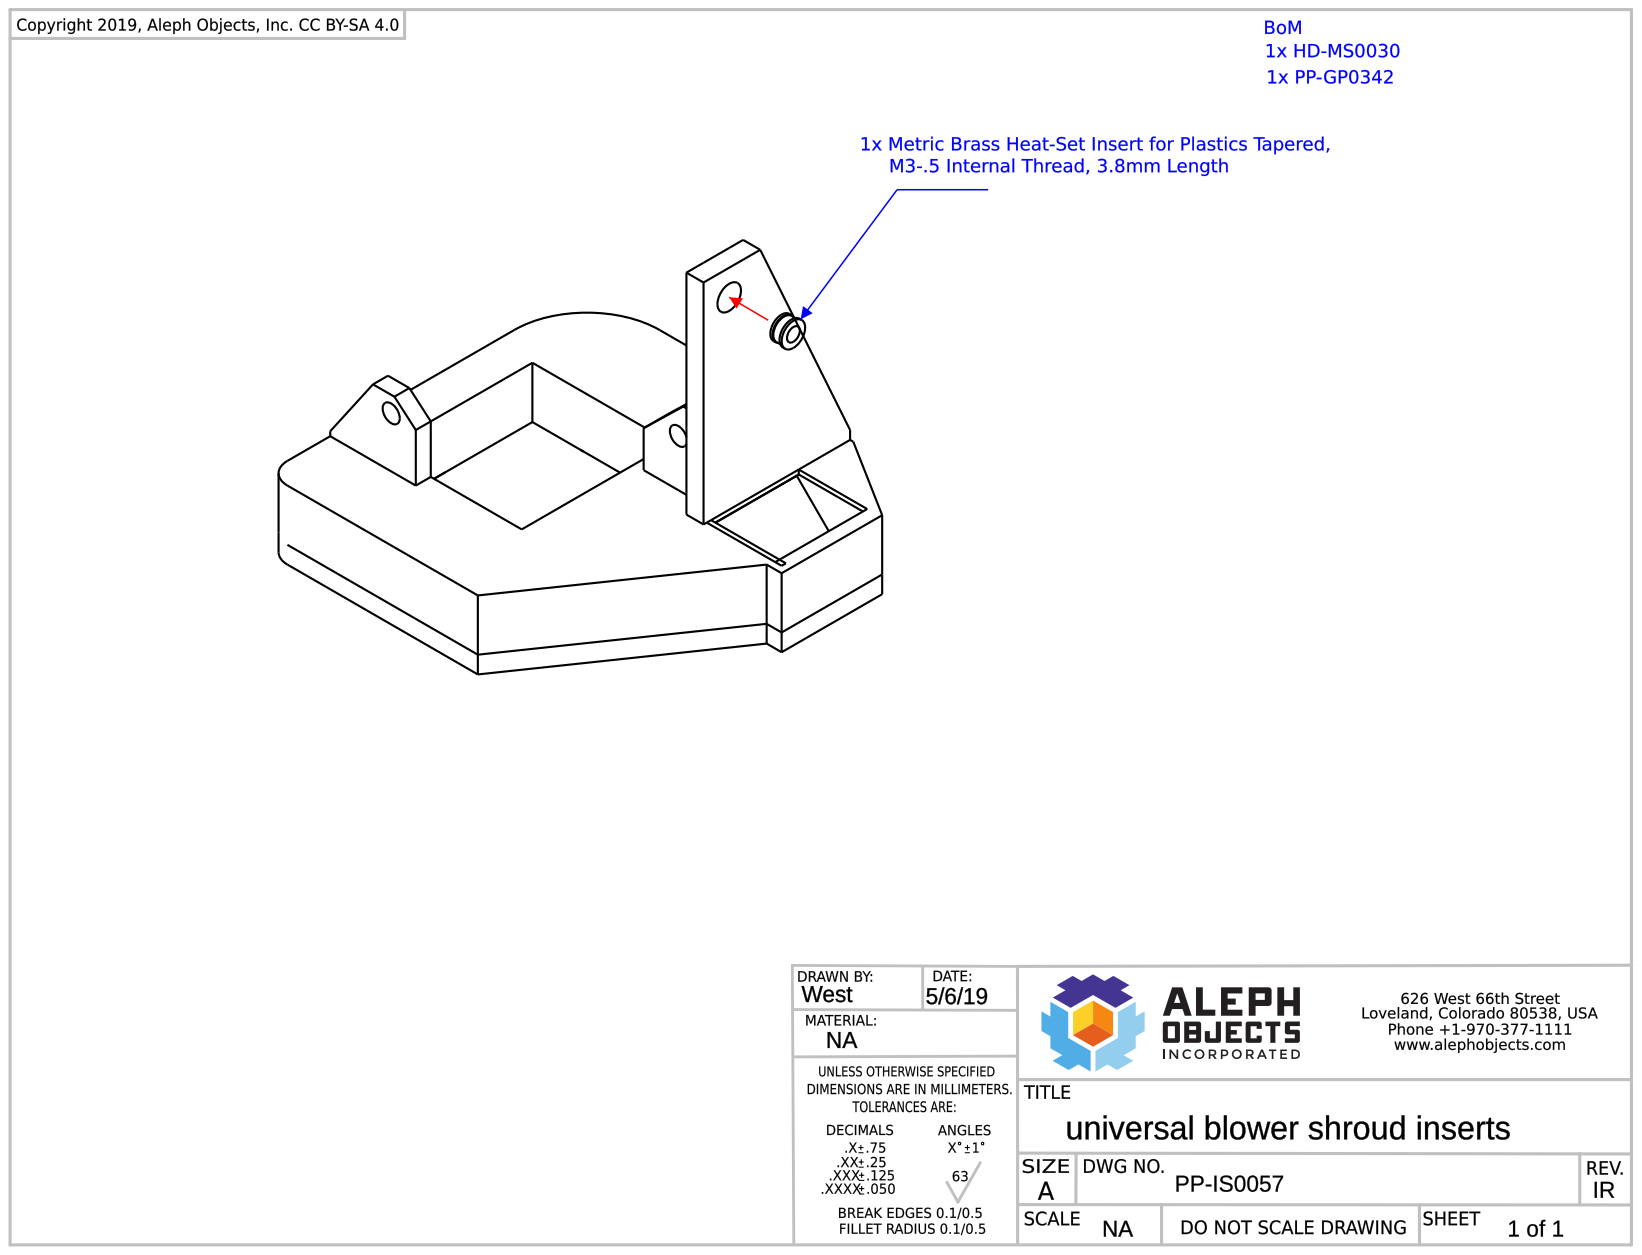
[picture p124: page 1]
