joeyliu522/VVI-project/CAD files/Older 3D printed parts/production_parts/assemblies/insert_assmeblies/PP-IS0083_idler_tube_clamp_right_inserts.pdf

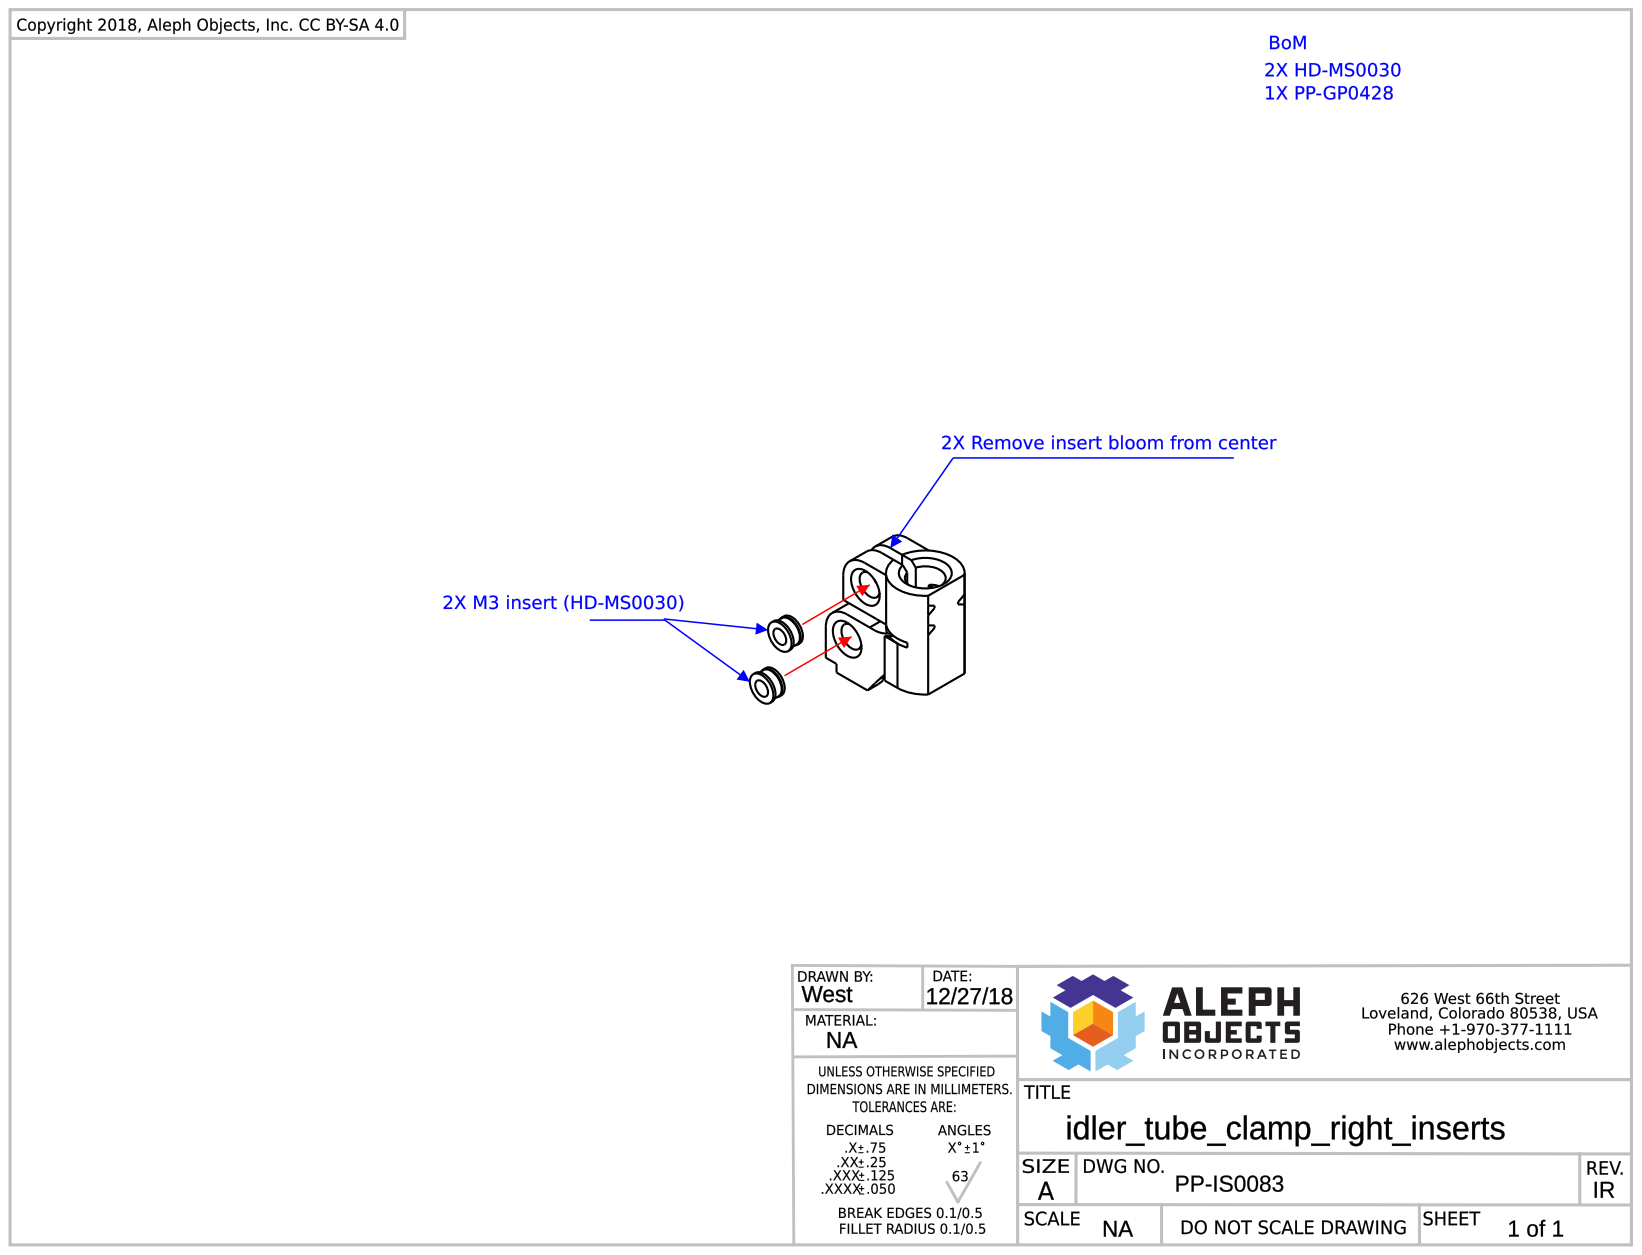
[picture p125: page 1]
