joeyliu522/VVI-project/CAD files/Older 3D printed parts/production_parts/assemblies/insert_assmeblies/PP-IS0088_y_belt_clamp_inserts.pdf

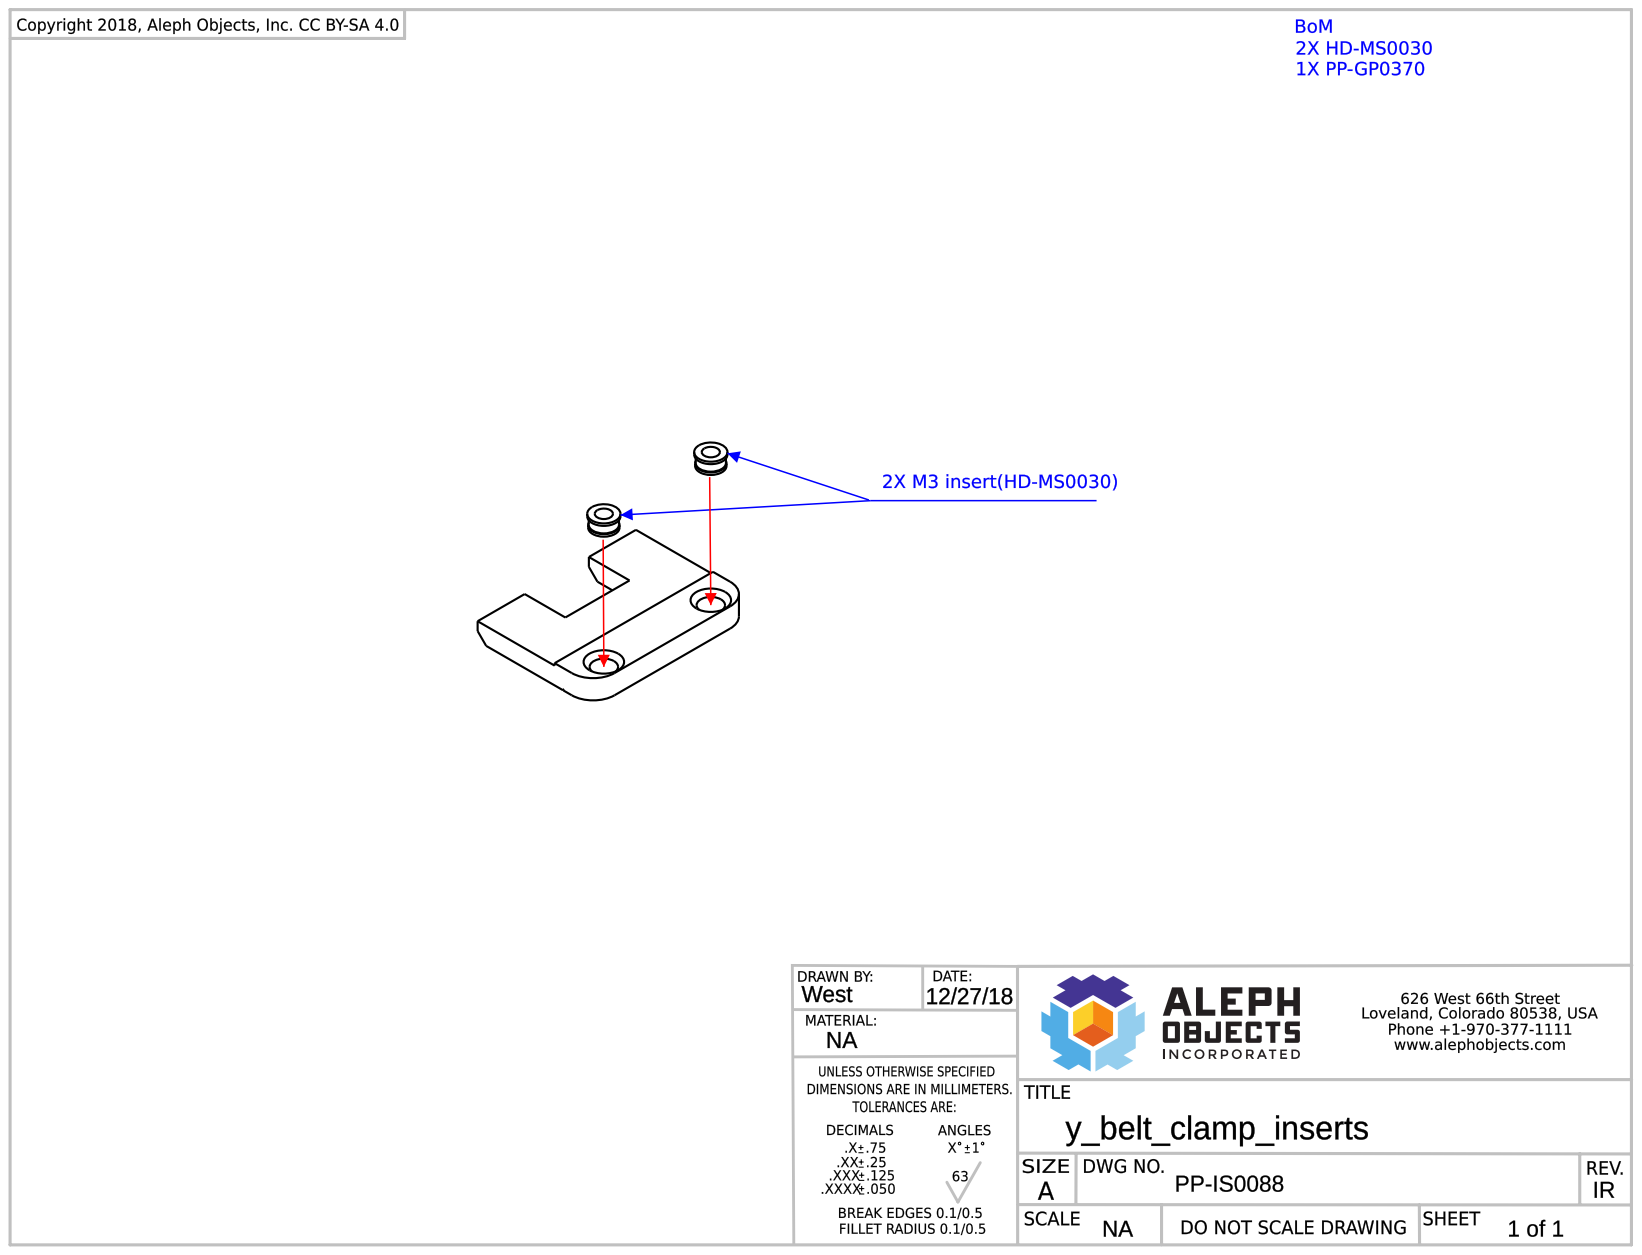
[picture p126: page 1]
