joeyliu522/VVI-project/CAD files/Older 3D printed parts/production_parts/assemblies/insert_assmeblies/PP-IS0089_y_corner_left_inserts.pdf

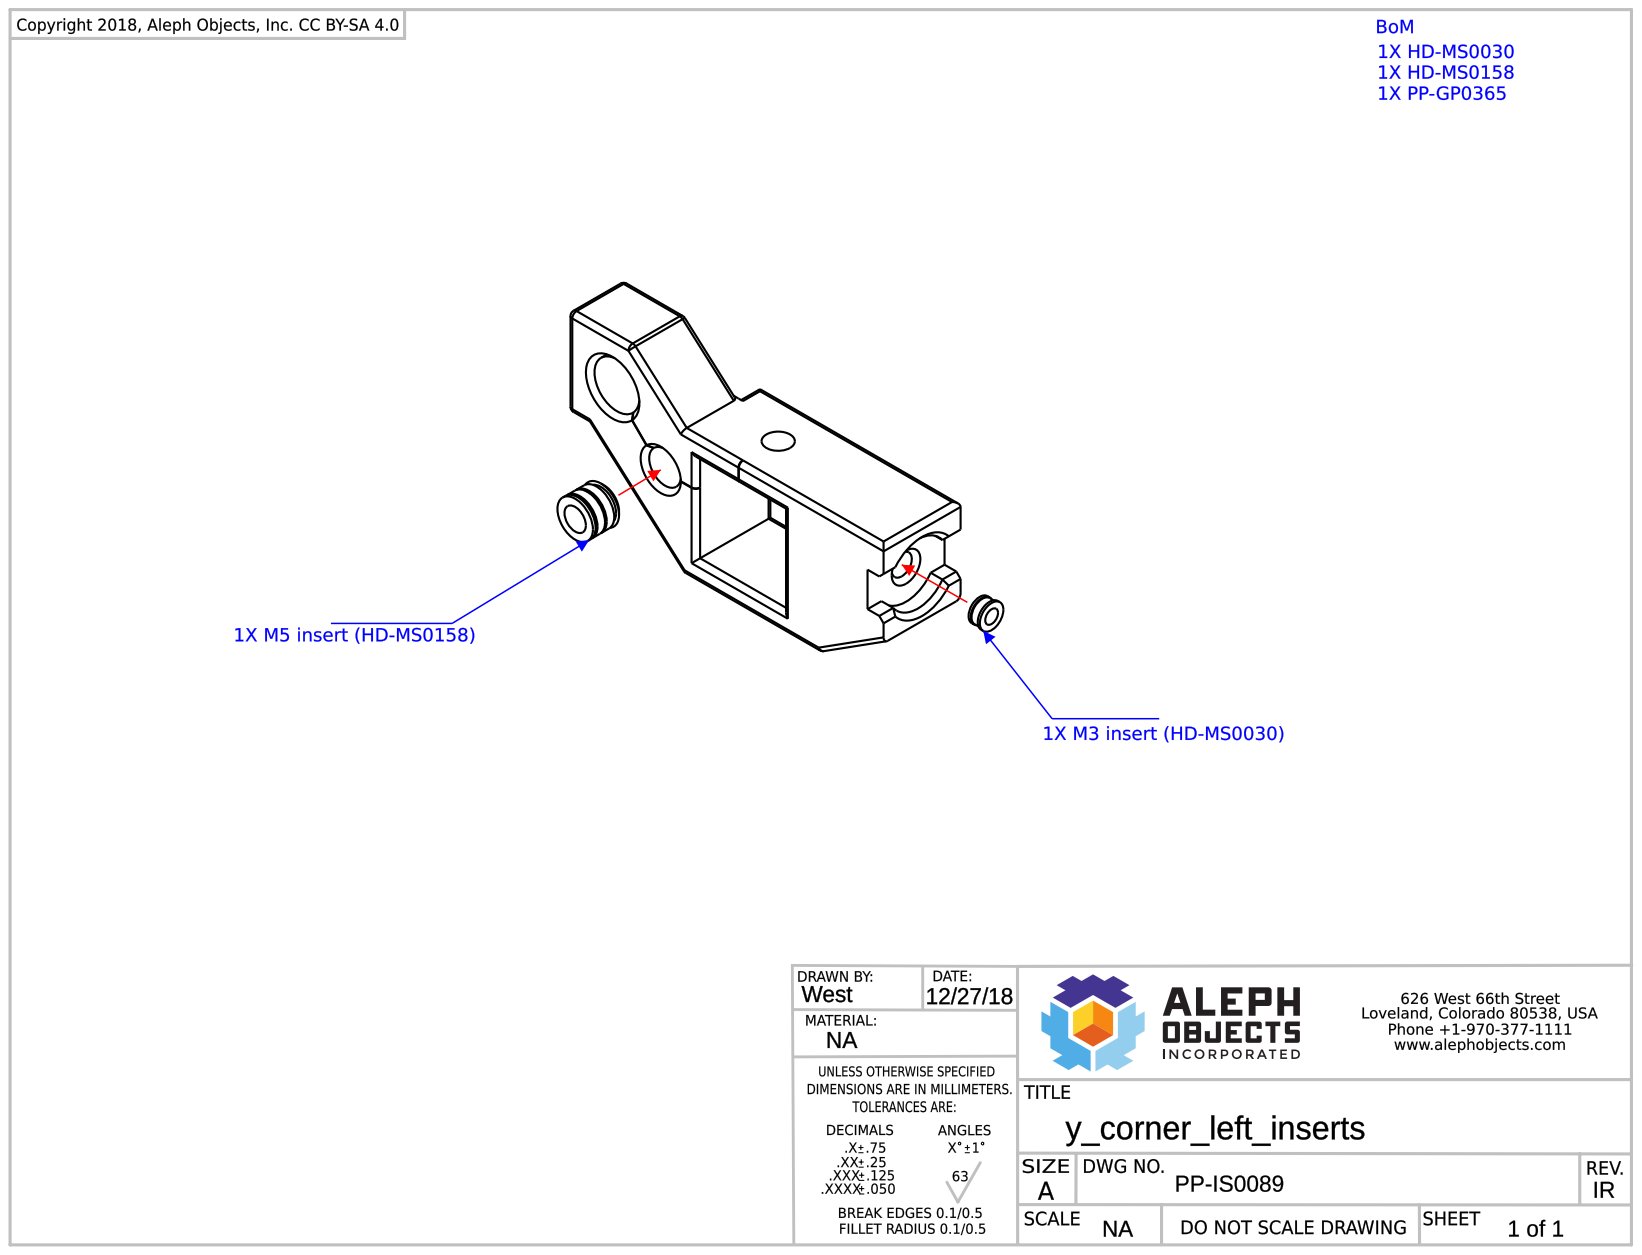
[picture p127: page 1]
