joeyliu522/VVI-project/CAD files/Older 3D printed parts/production_parts/assemblies/insert_assmeblies/PP-IS0090_y_corner_right_inserts.pdf

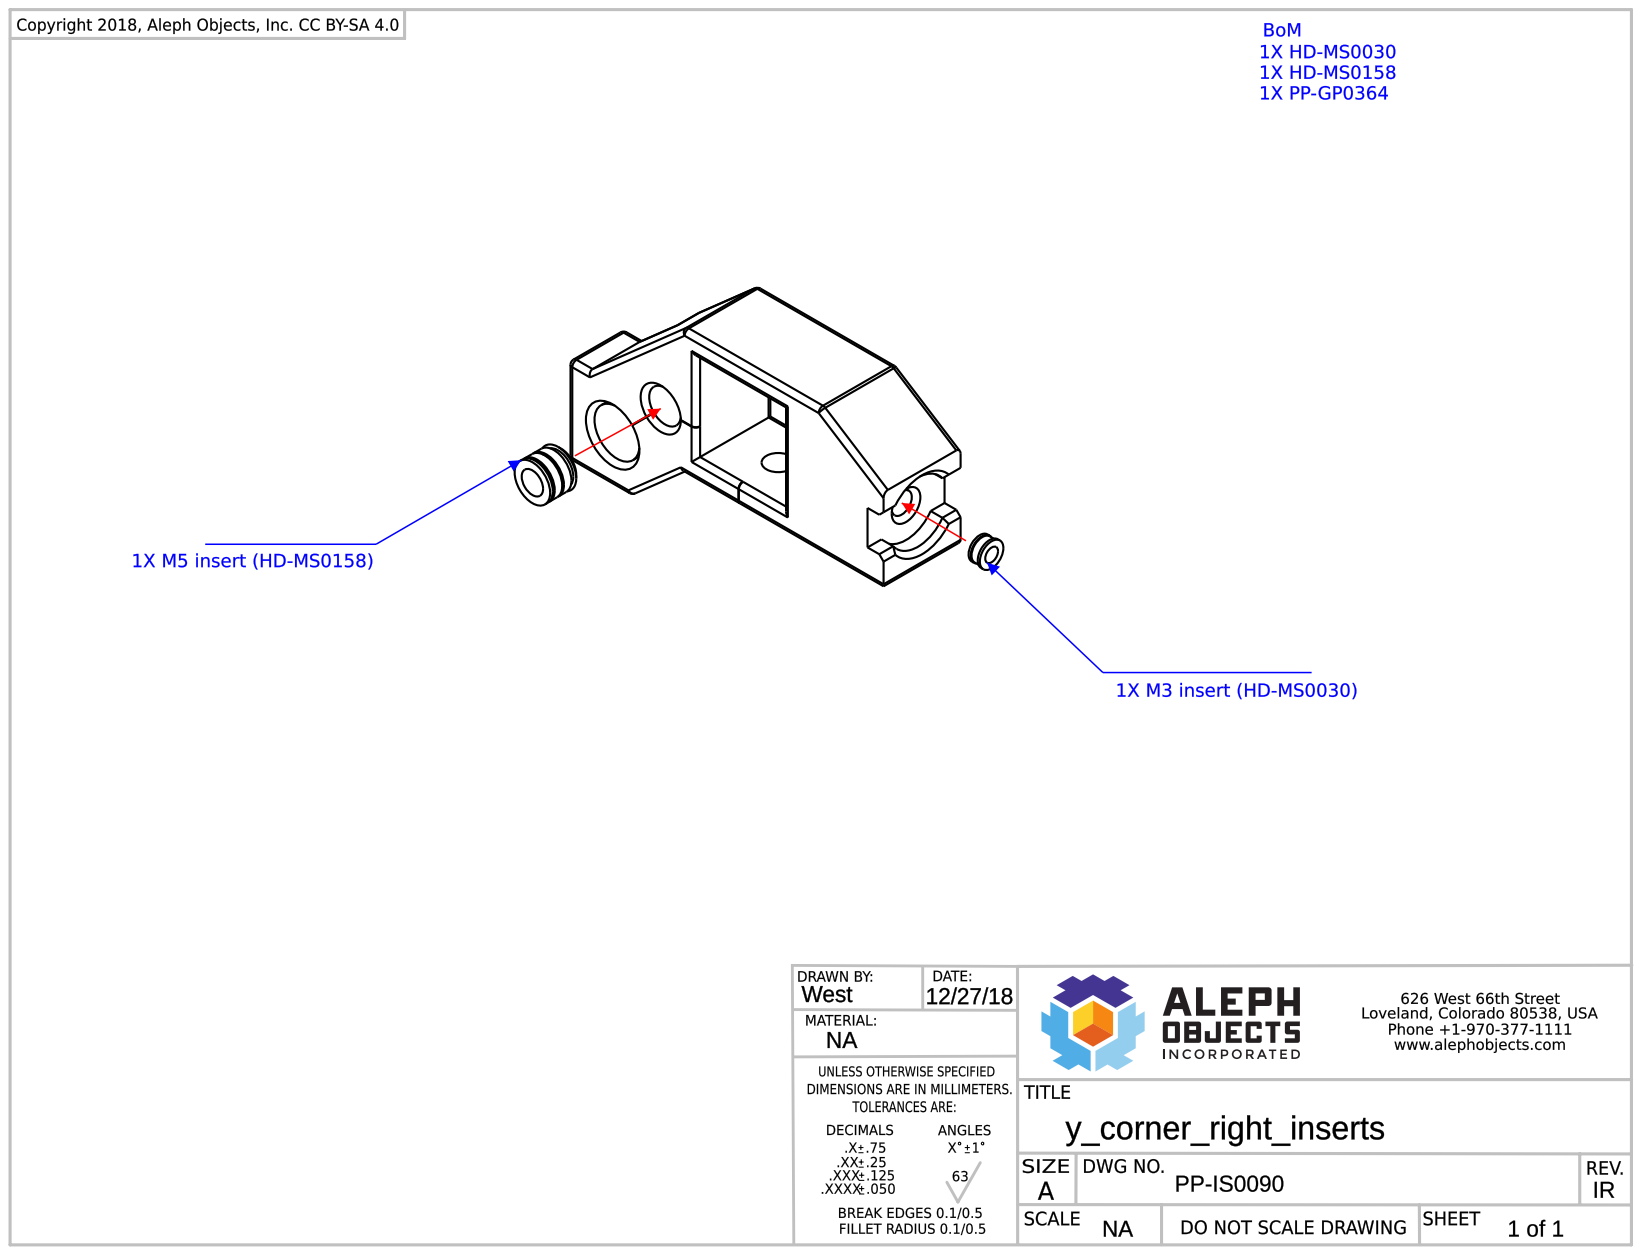
[picture p128: page 1]
