joeyliu522/VVI-project/CAD files/Older 3D printed parts/production_parts/assemblies/insert_assmeblies/PP-IS0091_y_idler_housing_inserts.pdf

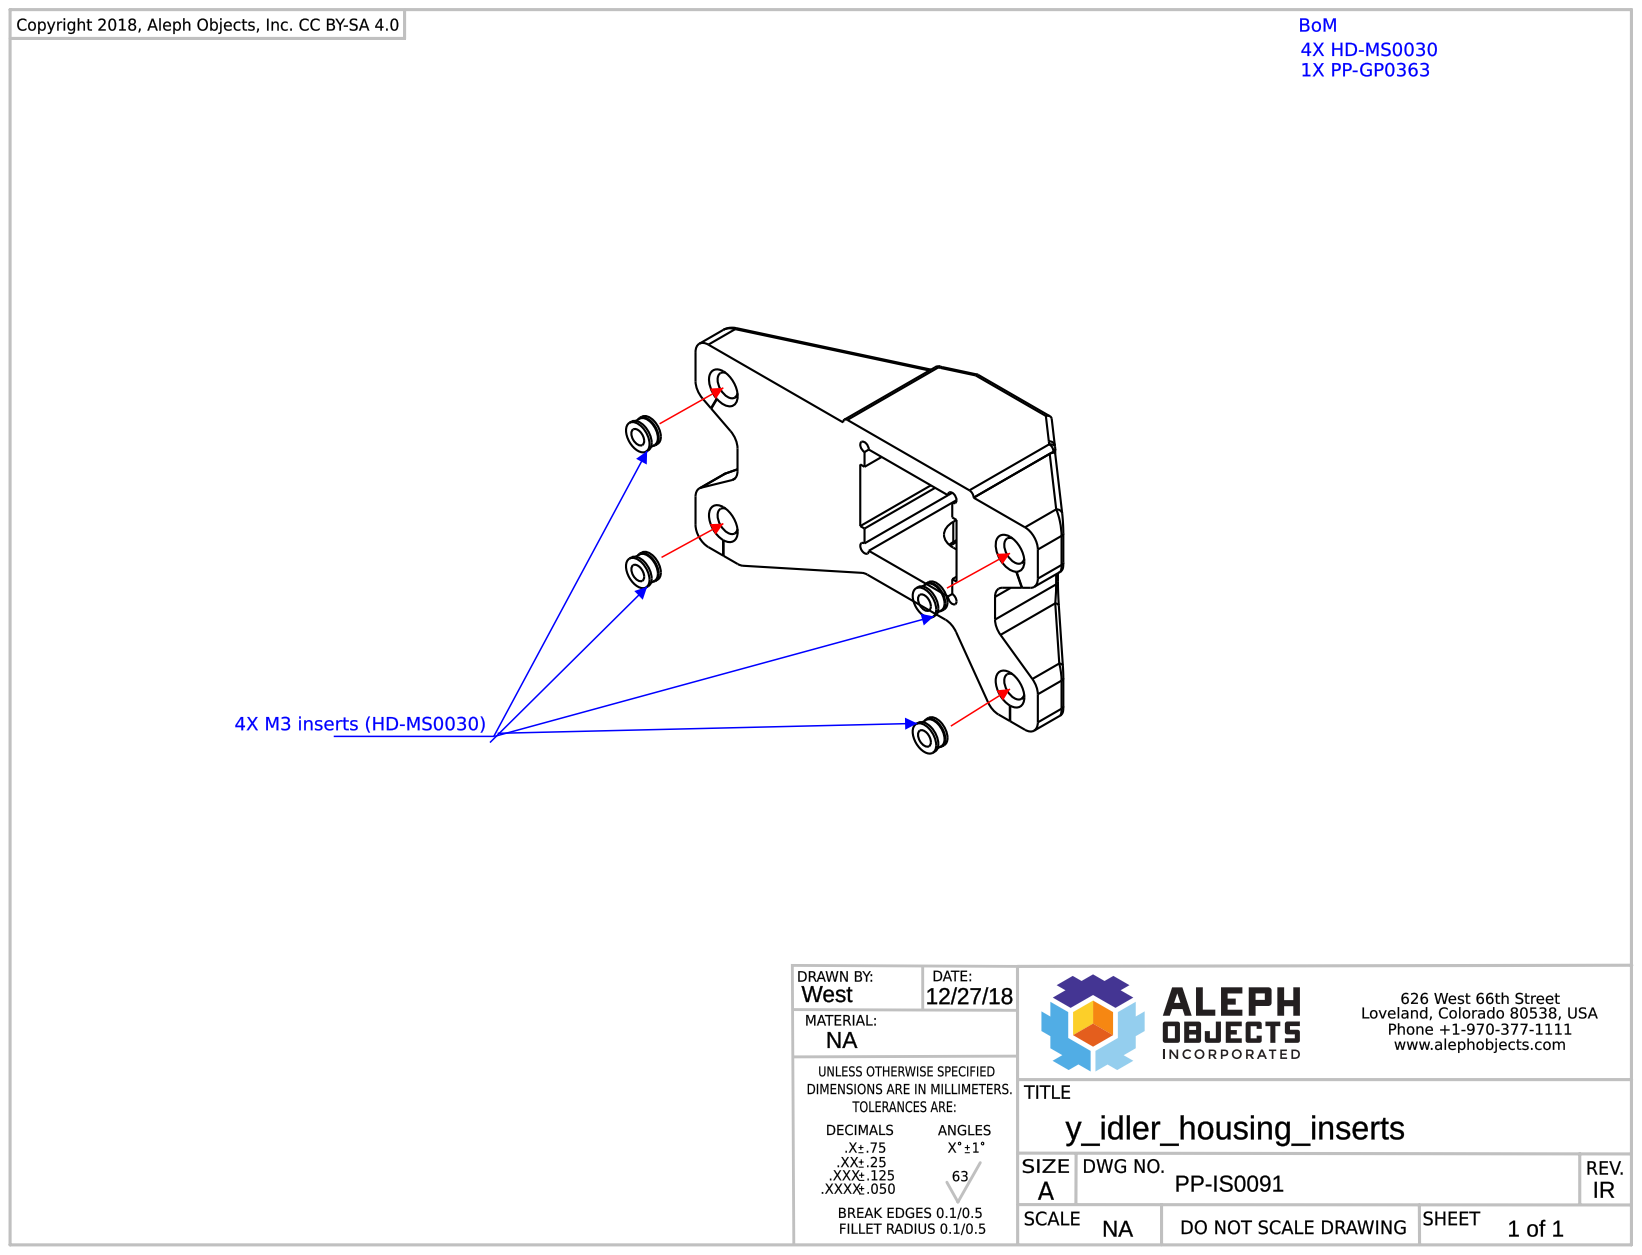
[picture p129: page 1]
