joeyliu522/VVI-project/CAD files/Older 3D printed parts/production_parts/assemblies/insert_assmeblies/PP-IS0093_z_upper_right_inserts.pdf

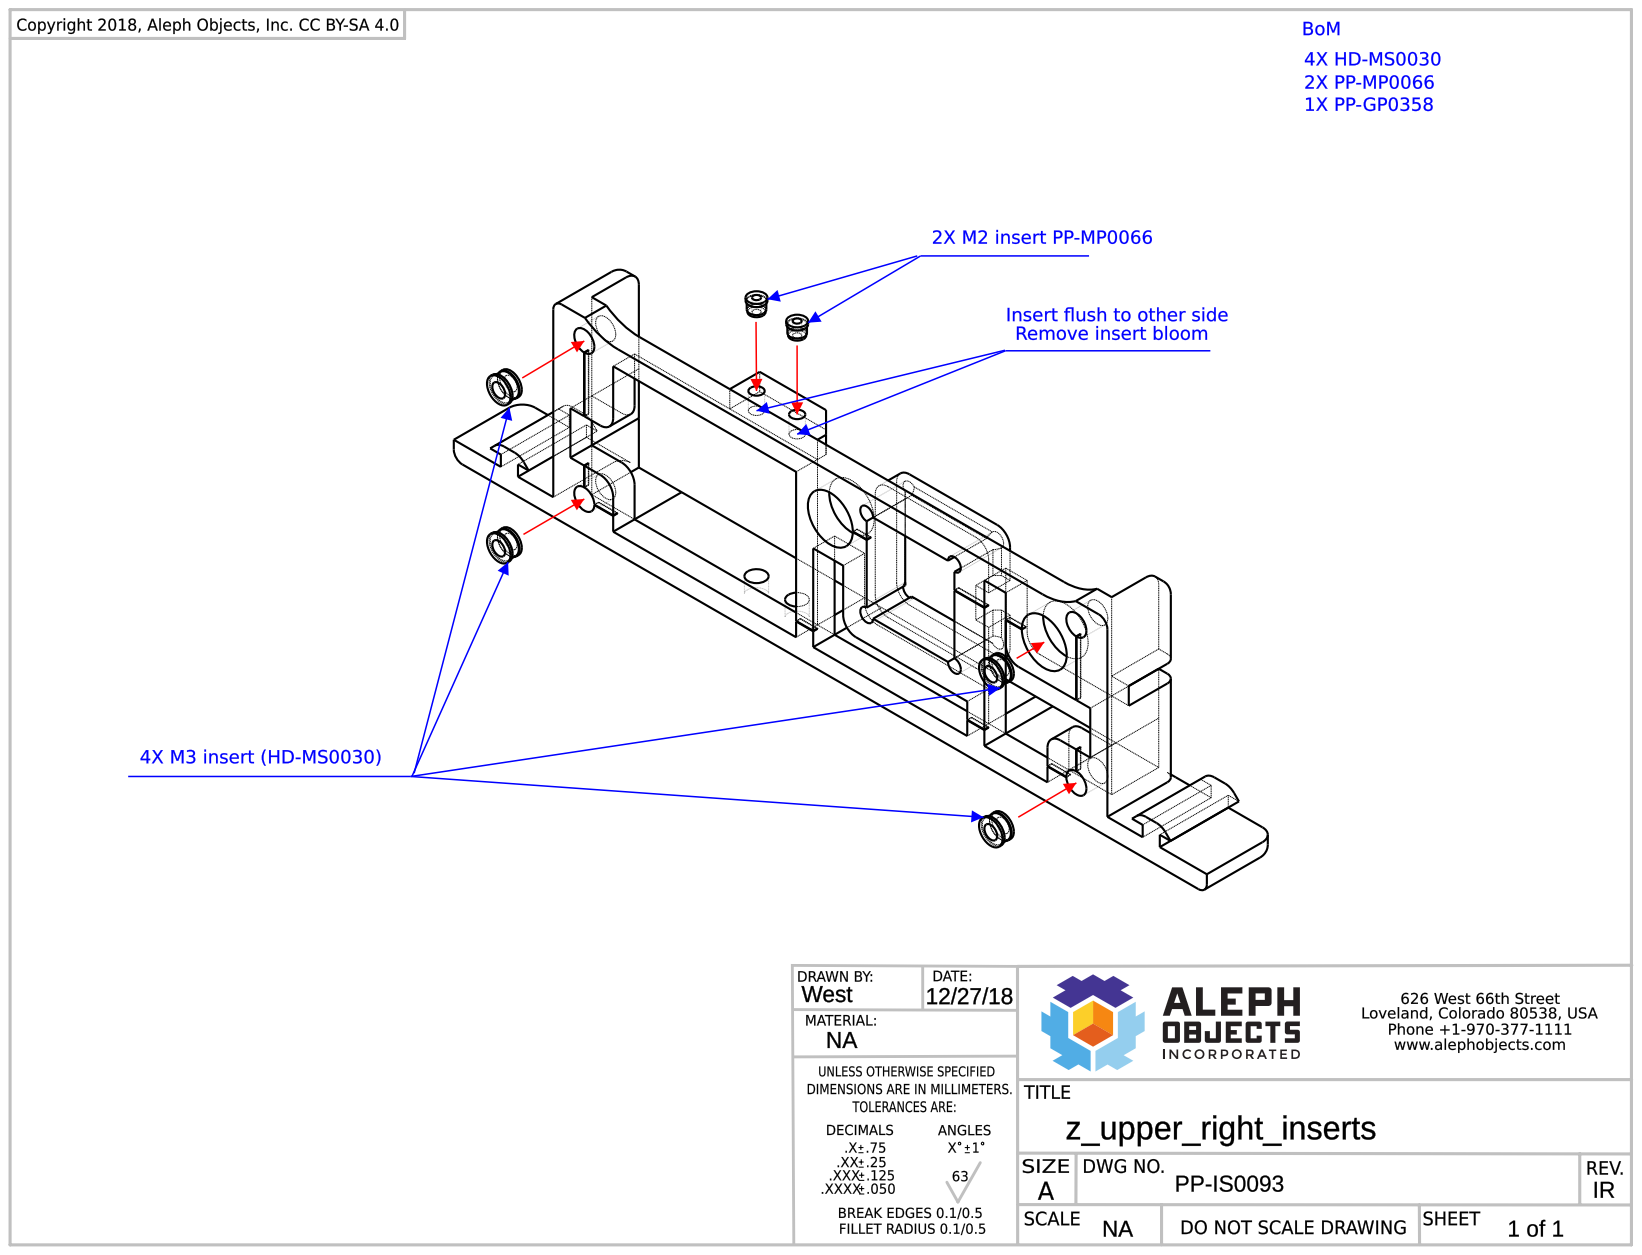
[picture p130: page 1]
