joeyliu522/VVI-project/CAD files/Older 3D printed parts/production_parts/assemblies/insert_assmeblies/PP-IS0094_z_upper_left_inserts.pdf

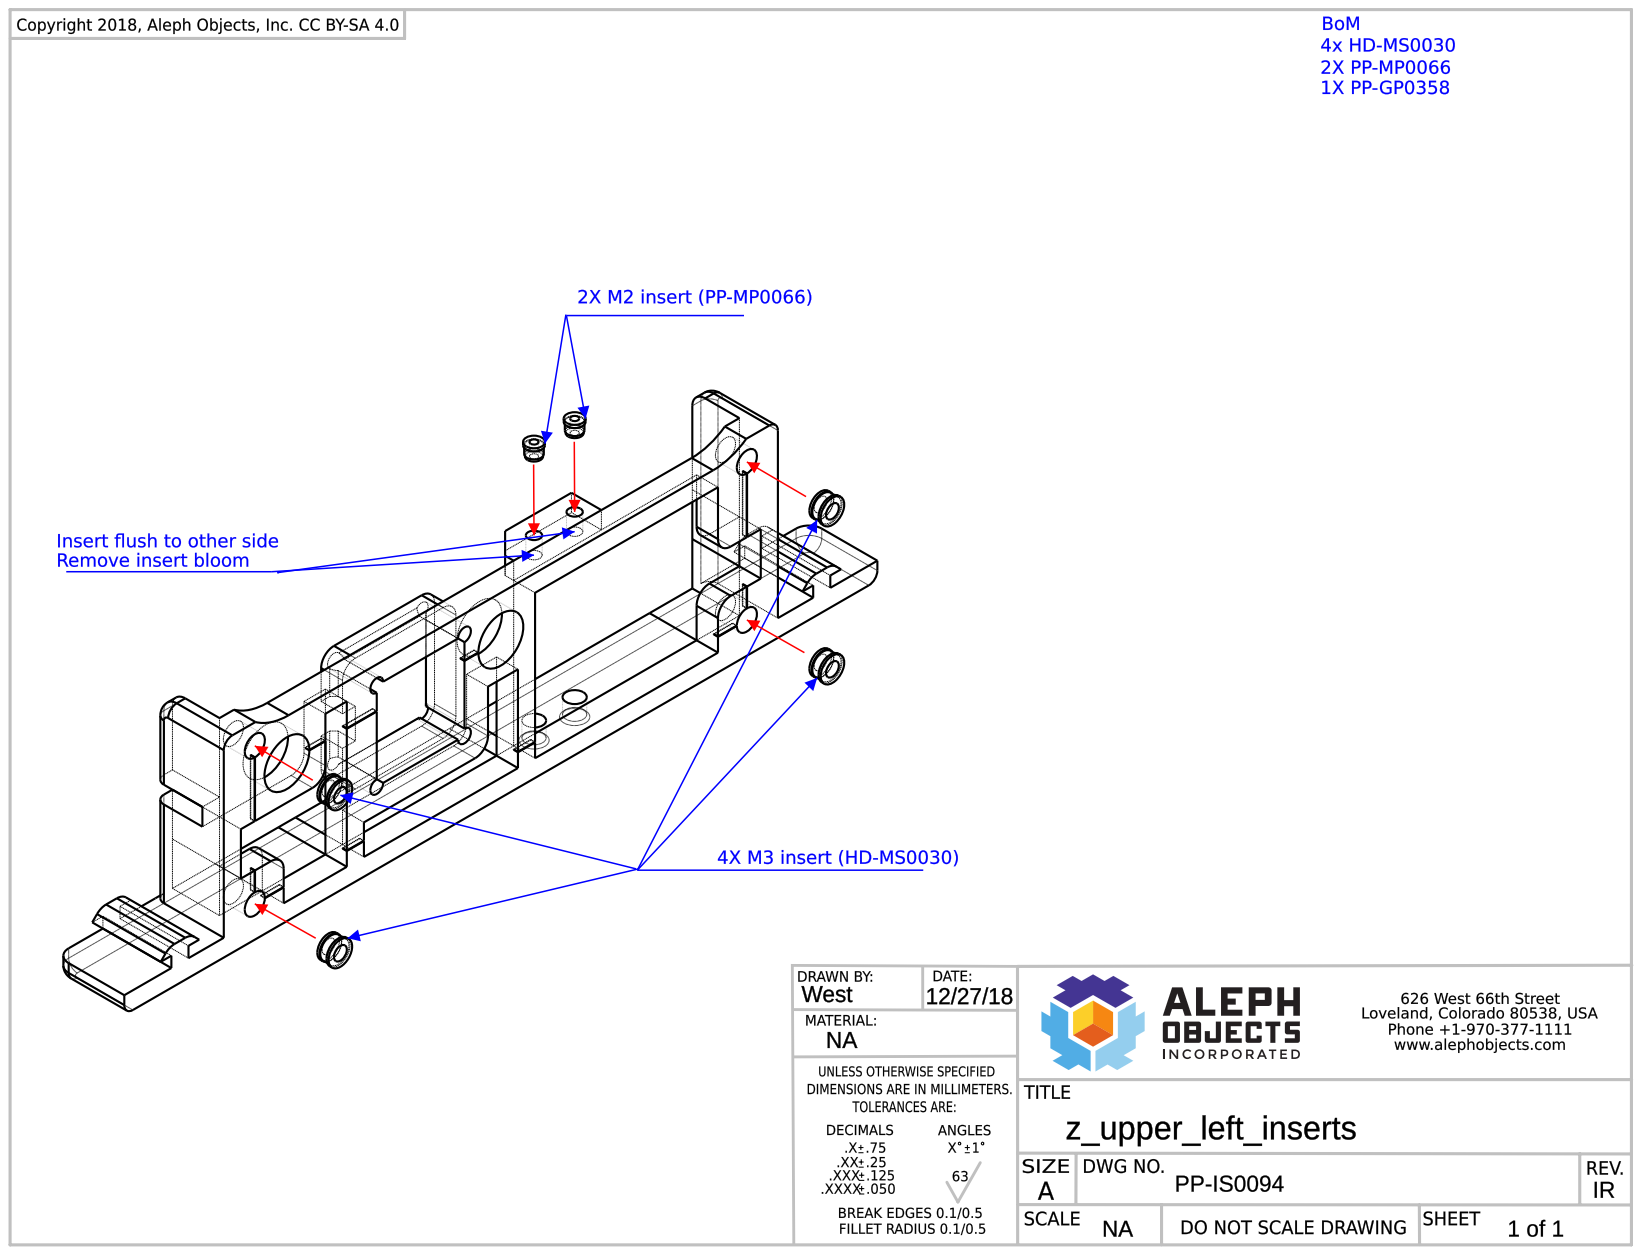
[picture p131: page 1]
