joeyliu522/VVI-project/CAD files/Older 3D printed parts/production_parts/assemblies/insert_assmeblies/PP-IS0098_bed_mount_chassis_inserts.pdf

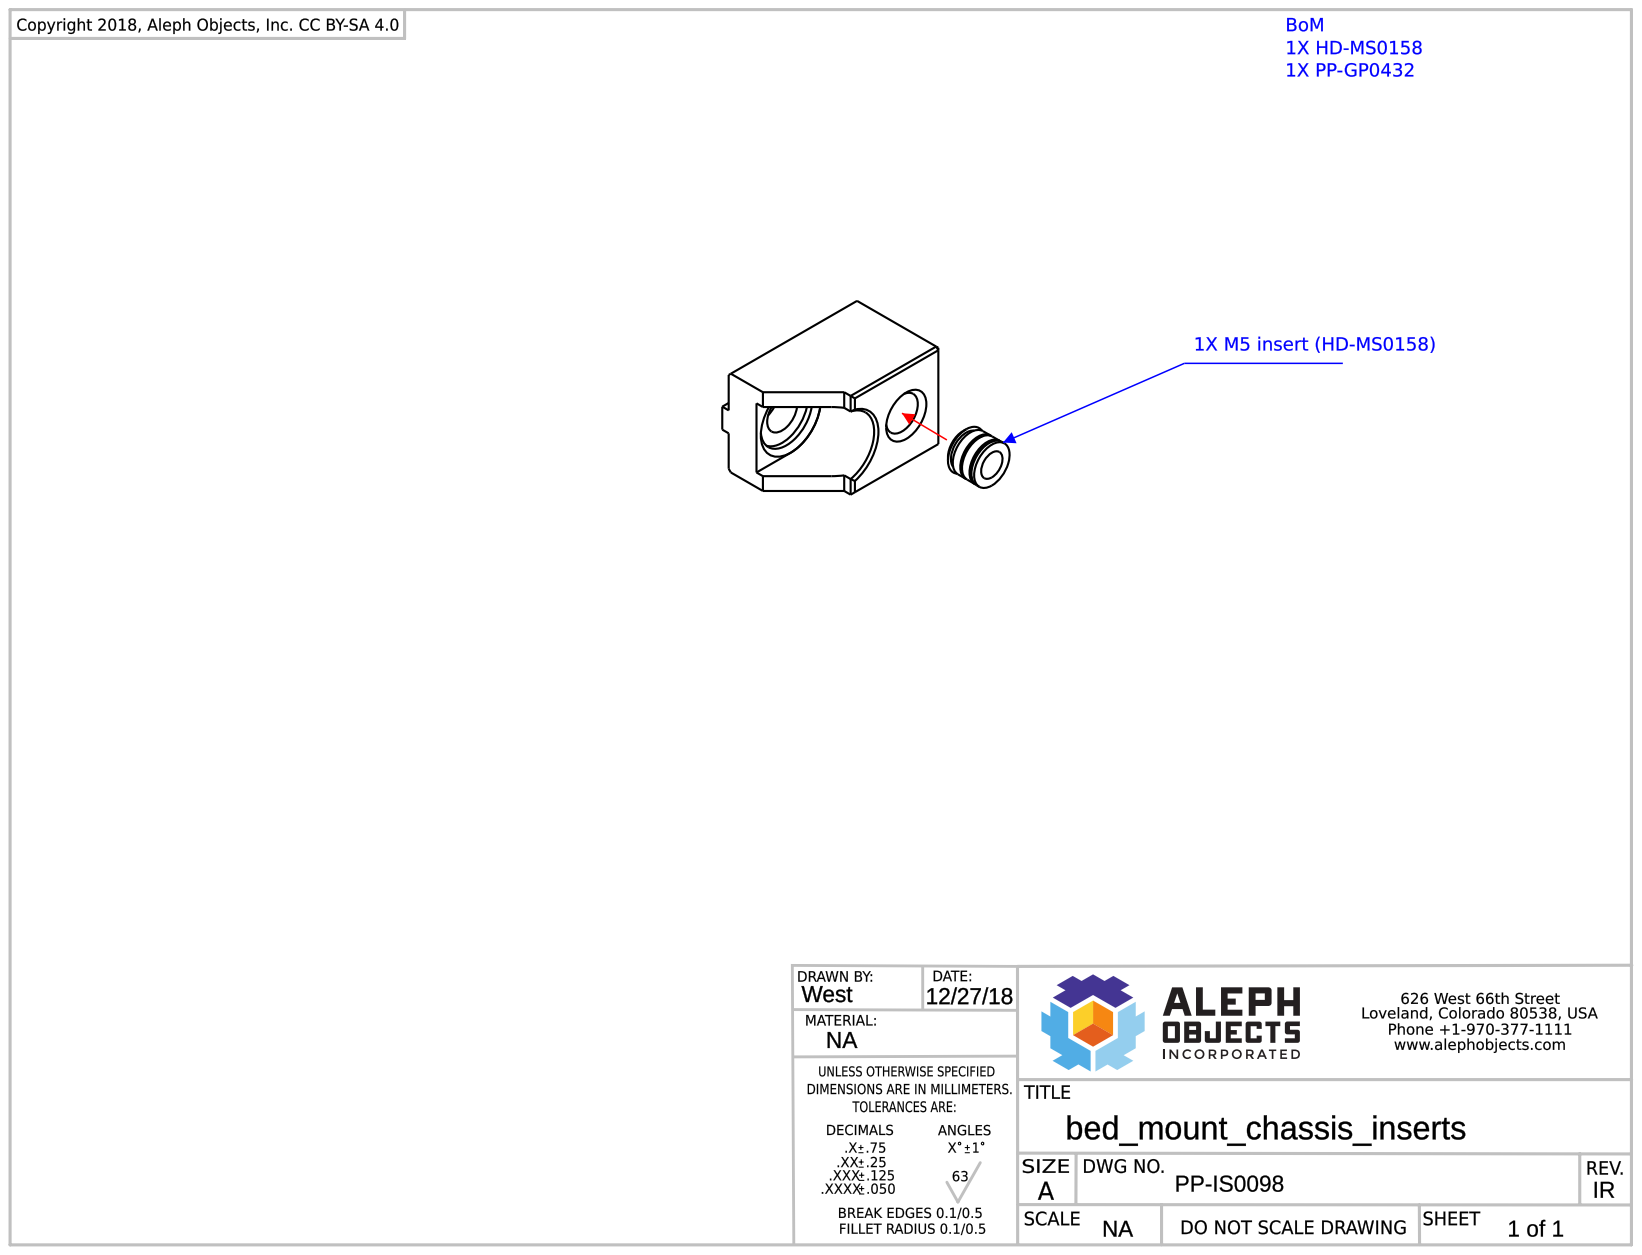
[picture p132: page 1]
