joeyliu522/VVI-project/CAD files/Older 3D printed parts/production_parts/assemblies/insert_assmeblies/PP-IS0100_x_belt_clamp_inserts.pdf

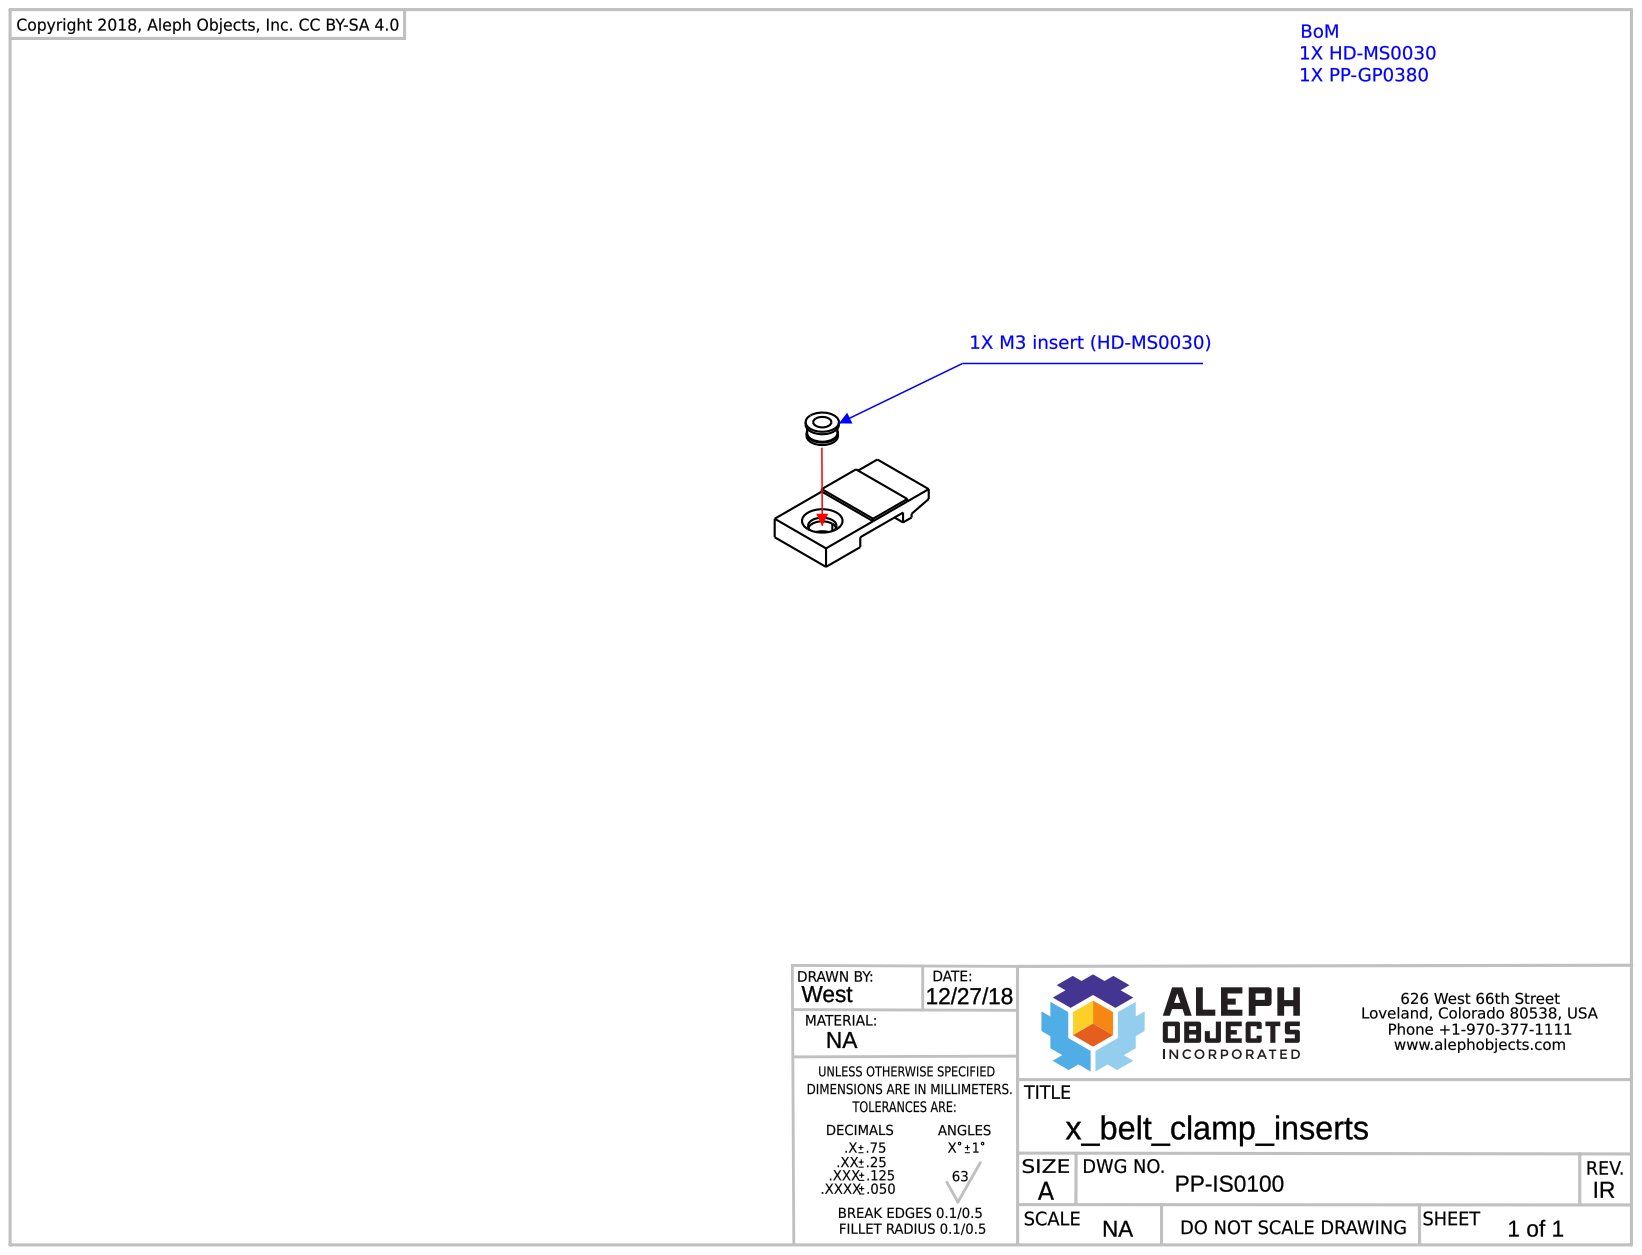
[picture p133: page 1]
