joeyliu522/VVI-project/CAD files/Older 3D printed parts/production_parts/assemblies/insert_assmeblies/PP-IS0102_x_belt_tensioner_inserts.pdf

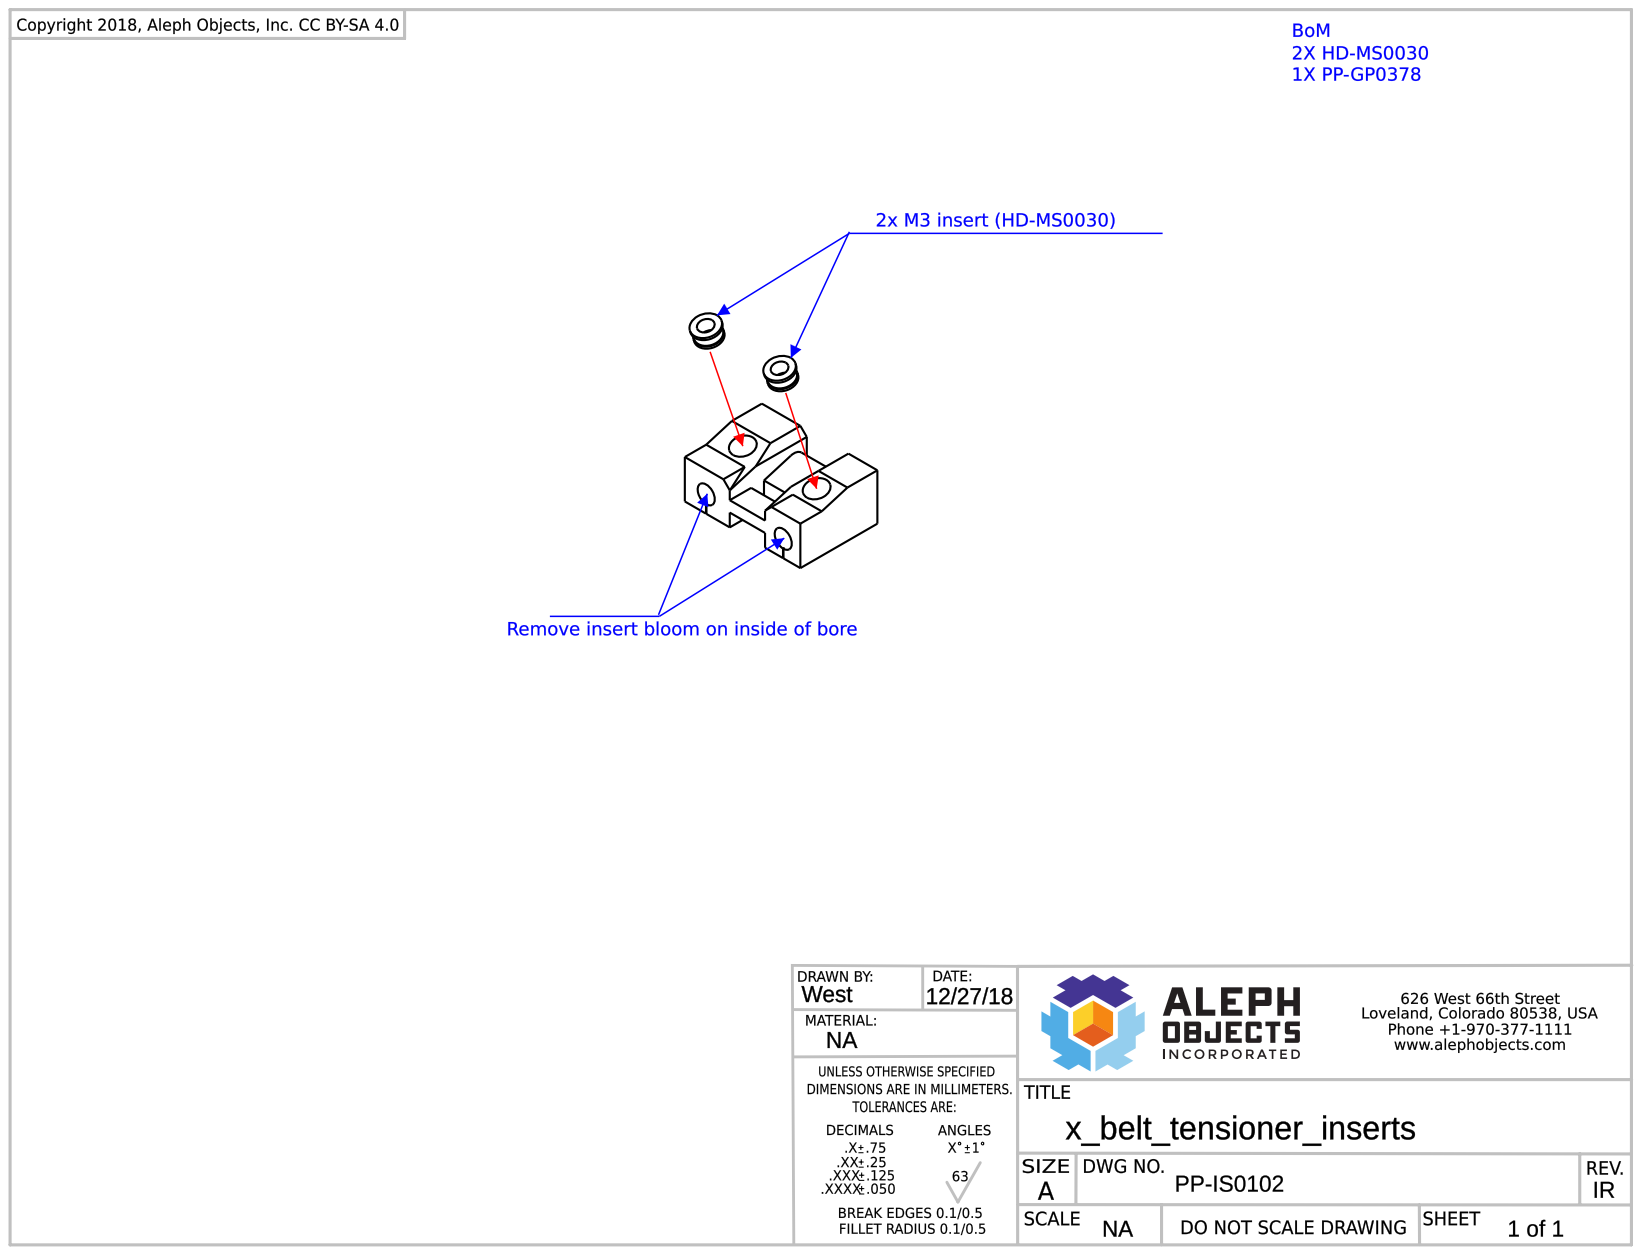
[picture p134: page 1]
