joeyliu522/VVI-project/CAD files/Older 3D printed parts/production_parts/assemblies/insert_assmeblies/PP-IS0107_x_idler_inserts.pdf

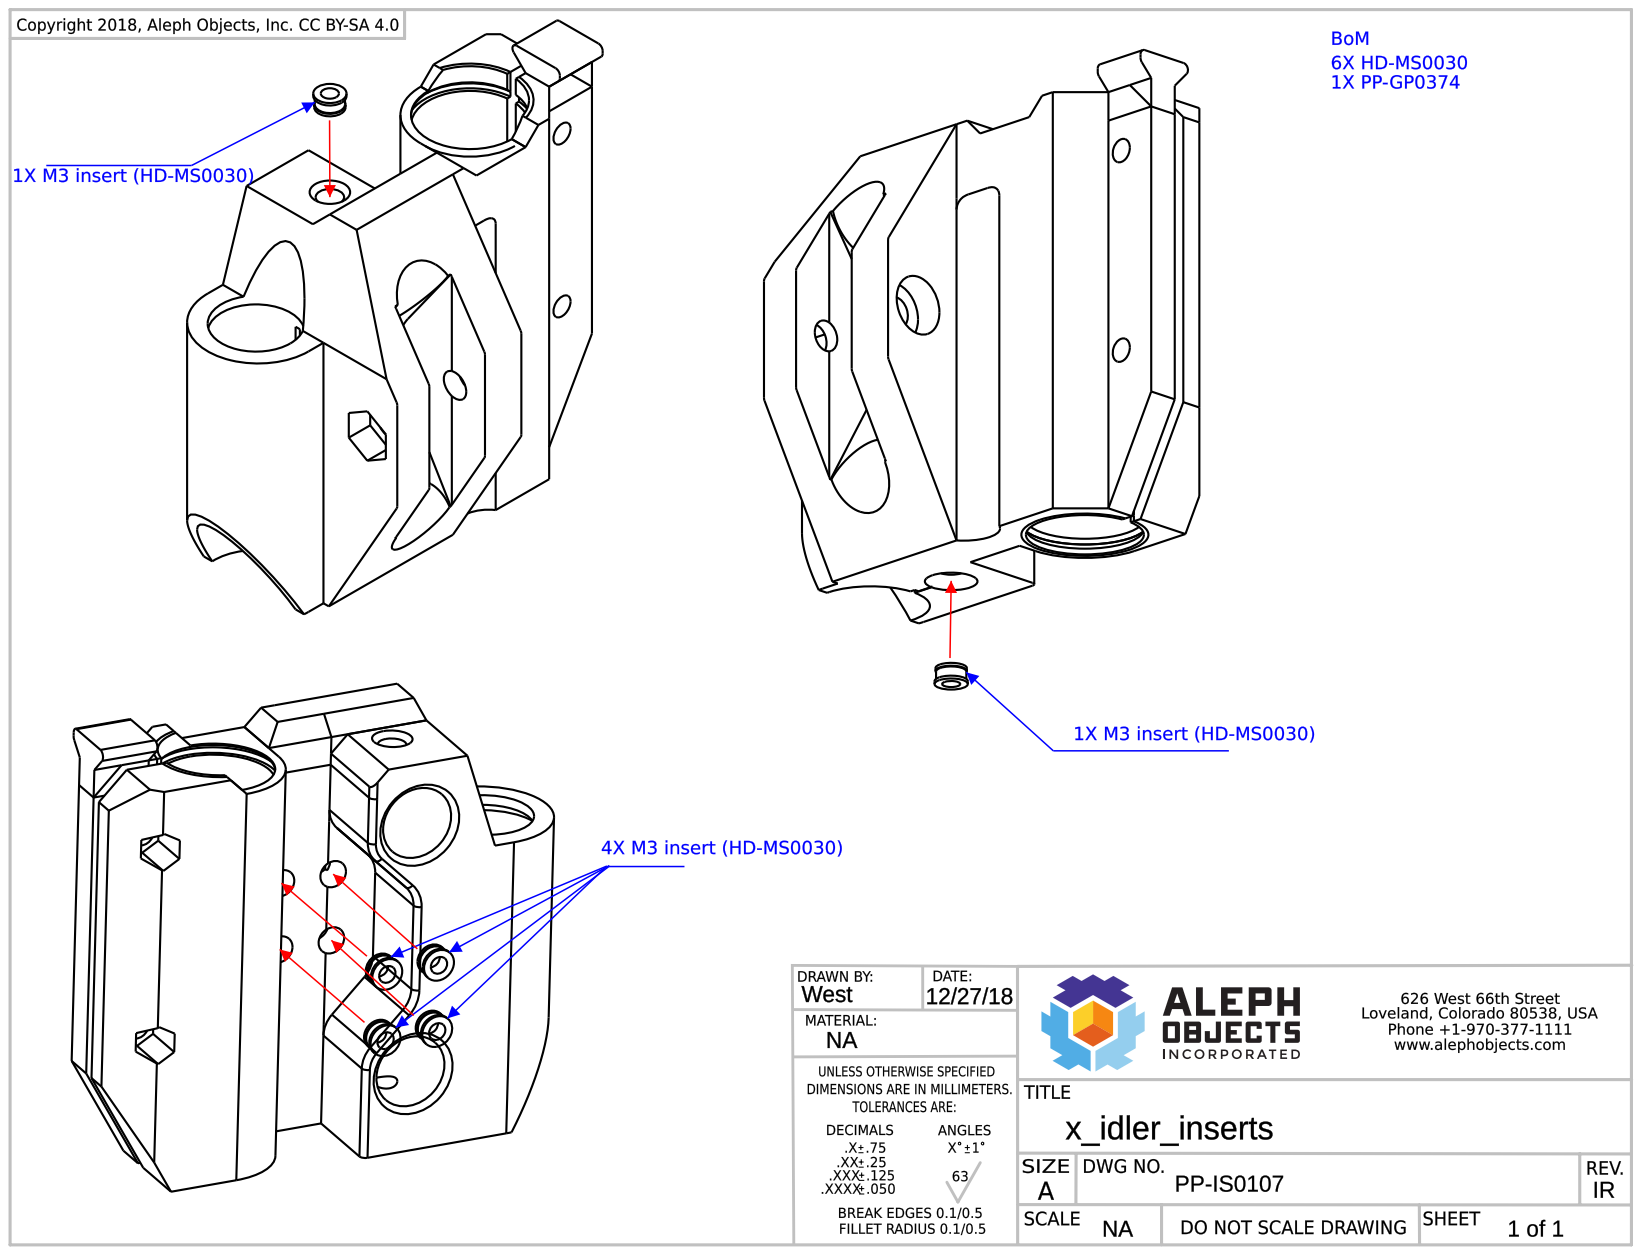
[picture p135: page 1]
