joeyliu522/VVI-project/CAD files/Older 3D printed parts/production_parts/assemblies/insert_assmeblies/PP-IS0115_y_motor_mount_inserts.pdf

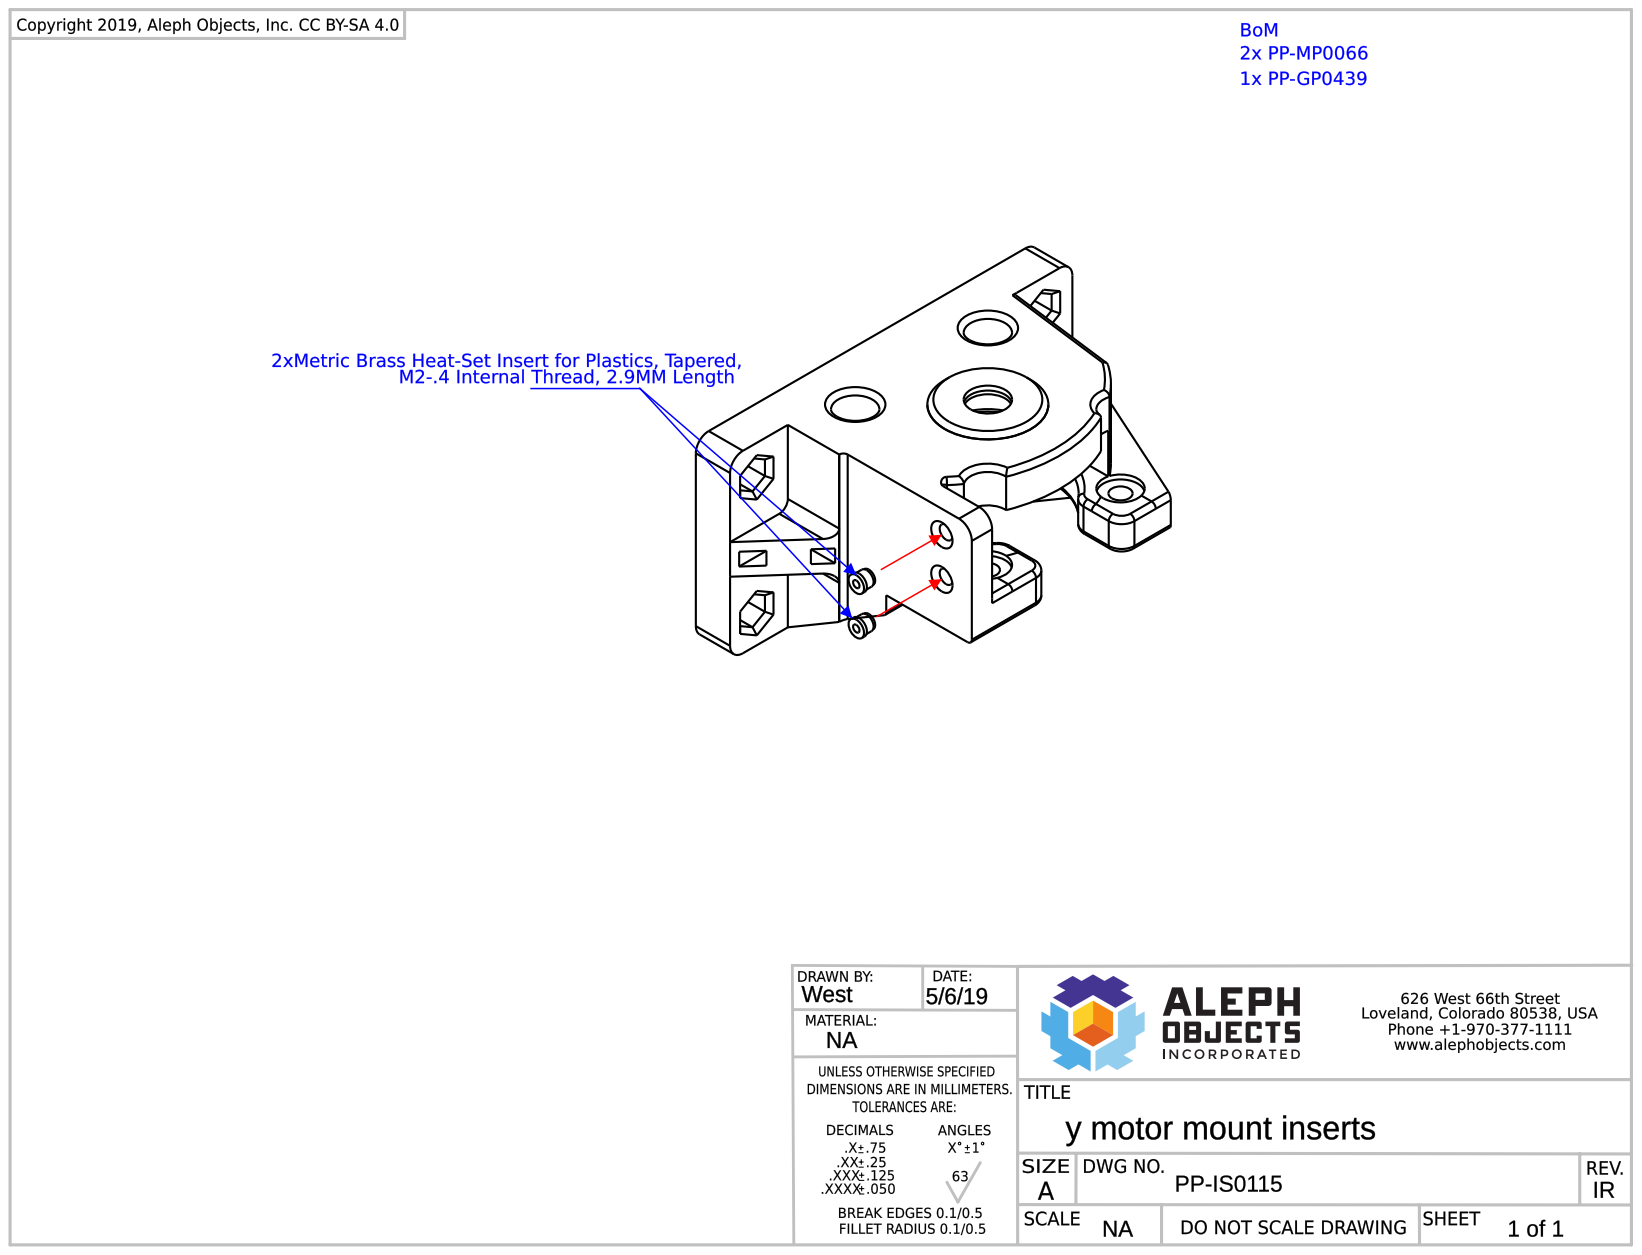
[picture p136: page 1]
