joeyliu522/VVI-project/CAD files/Older 3D printed parts/production_parts/assemblies/insert_assmeblies/PP-IS0116_y_cable_mount_inserts.pdf

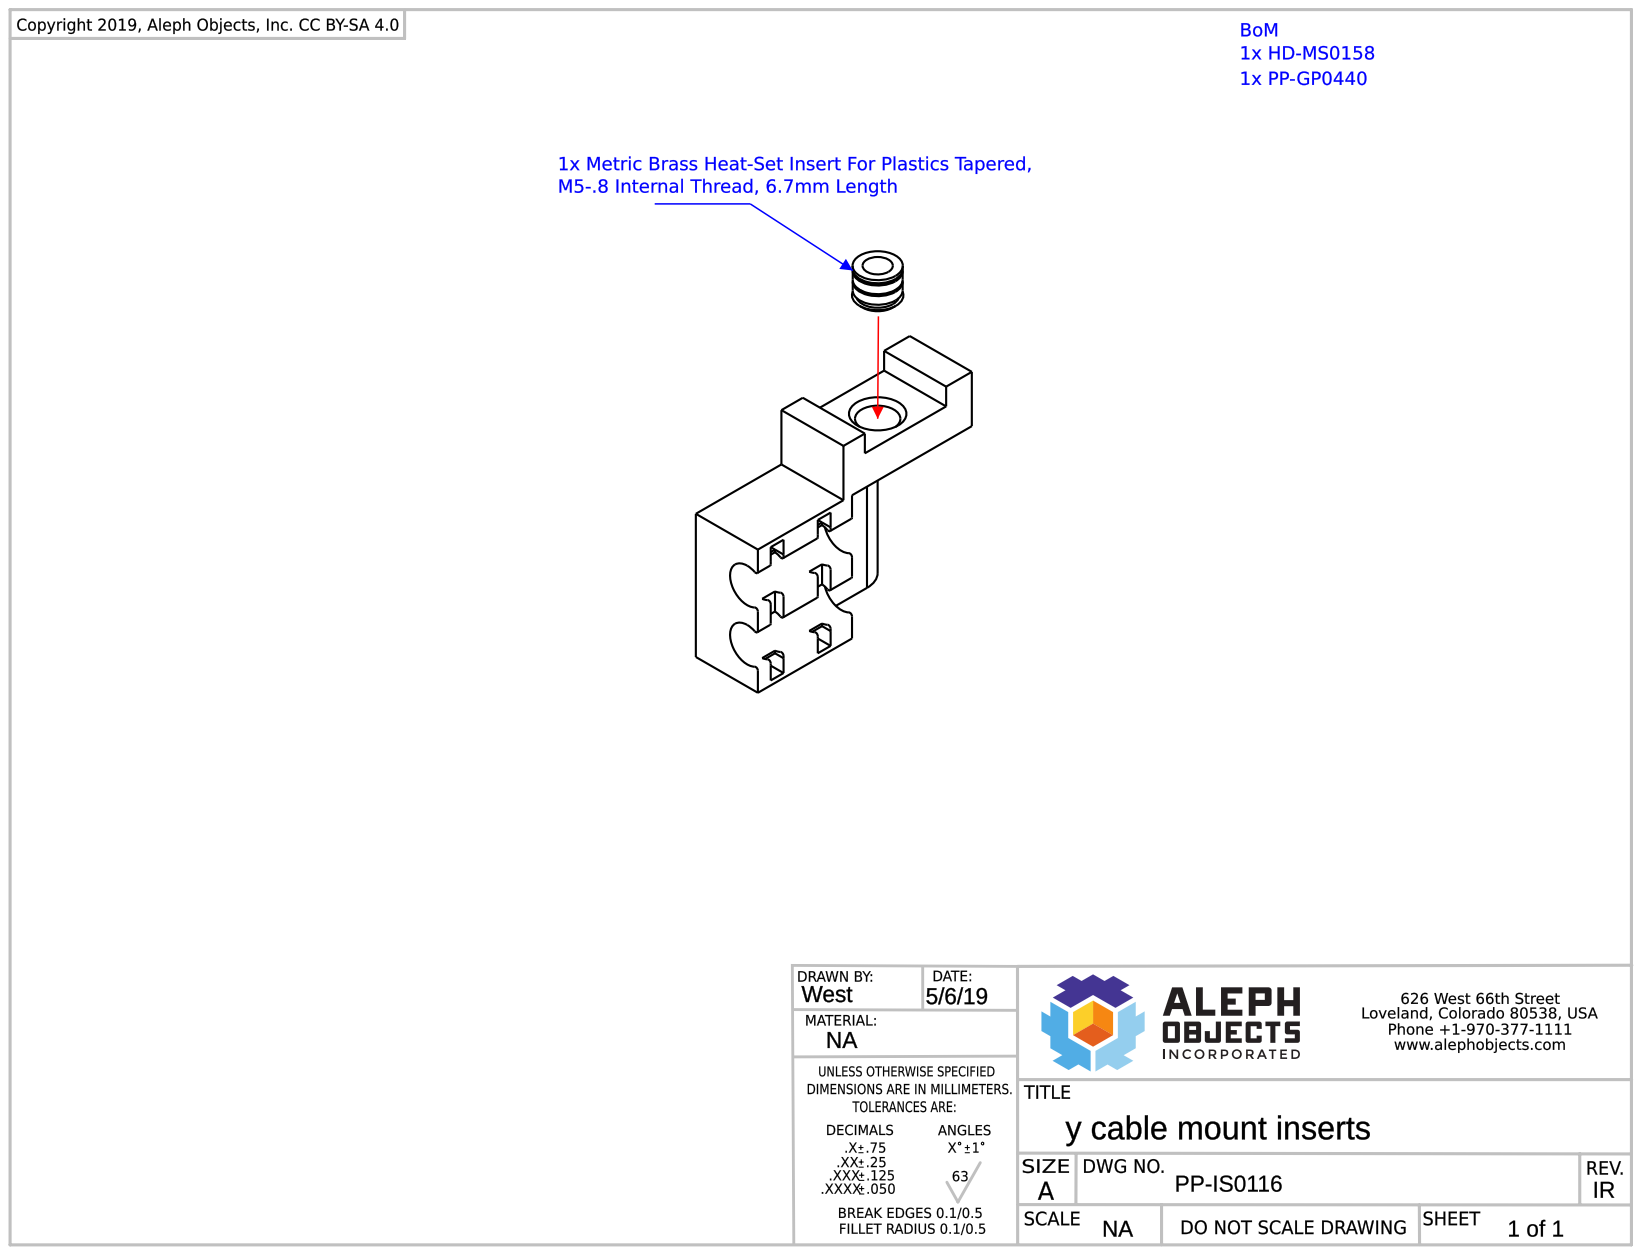
[picture p137: page 1]
