joeyliu522/VVI-project/CAD files/Older 3D printed parts/production_parts/assemblies/insert_assmeblies/PP-IS0117_x_carriage_cover_inserts.pdf

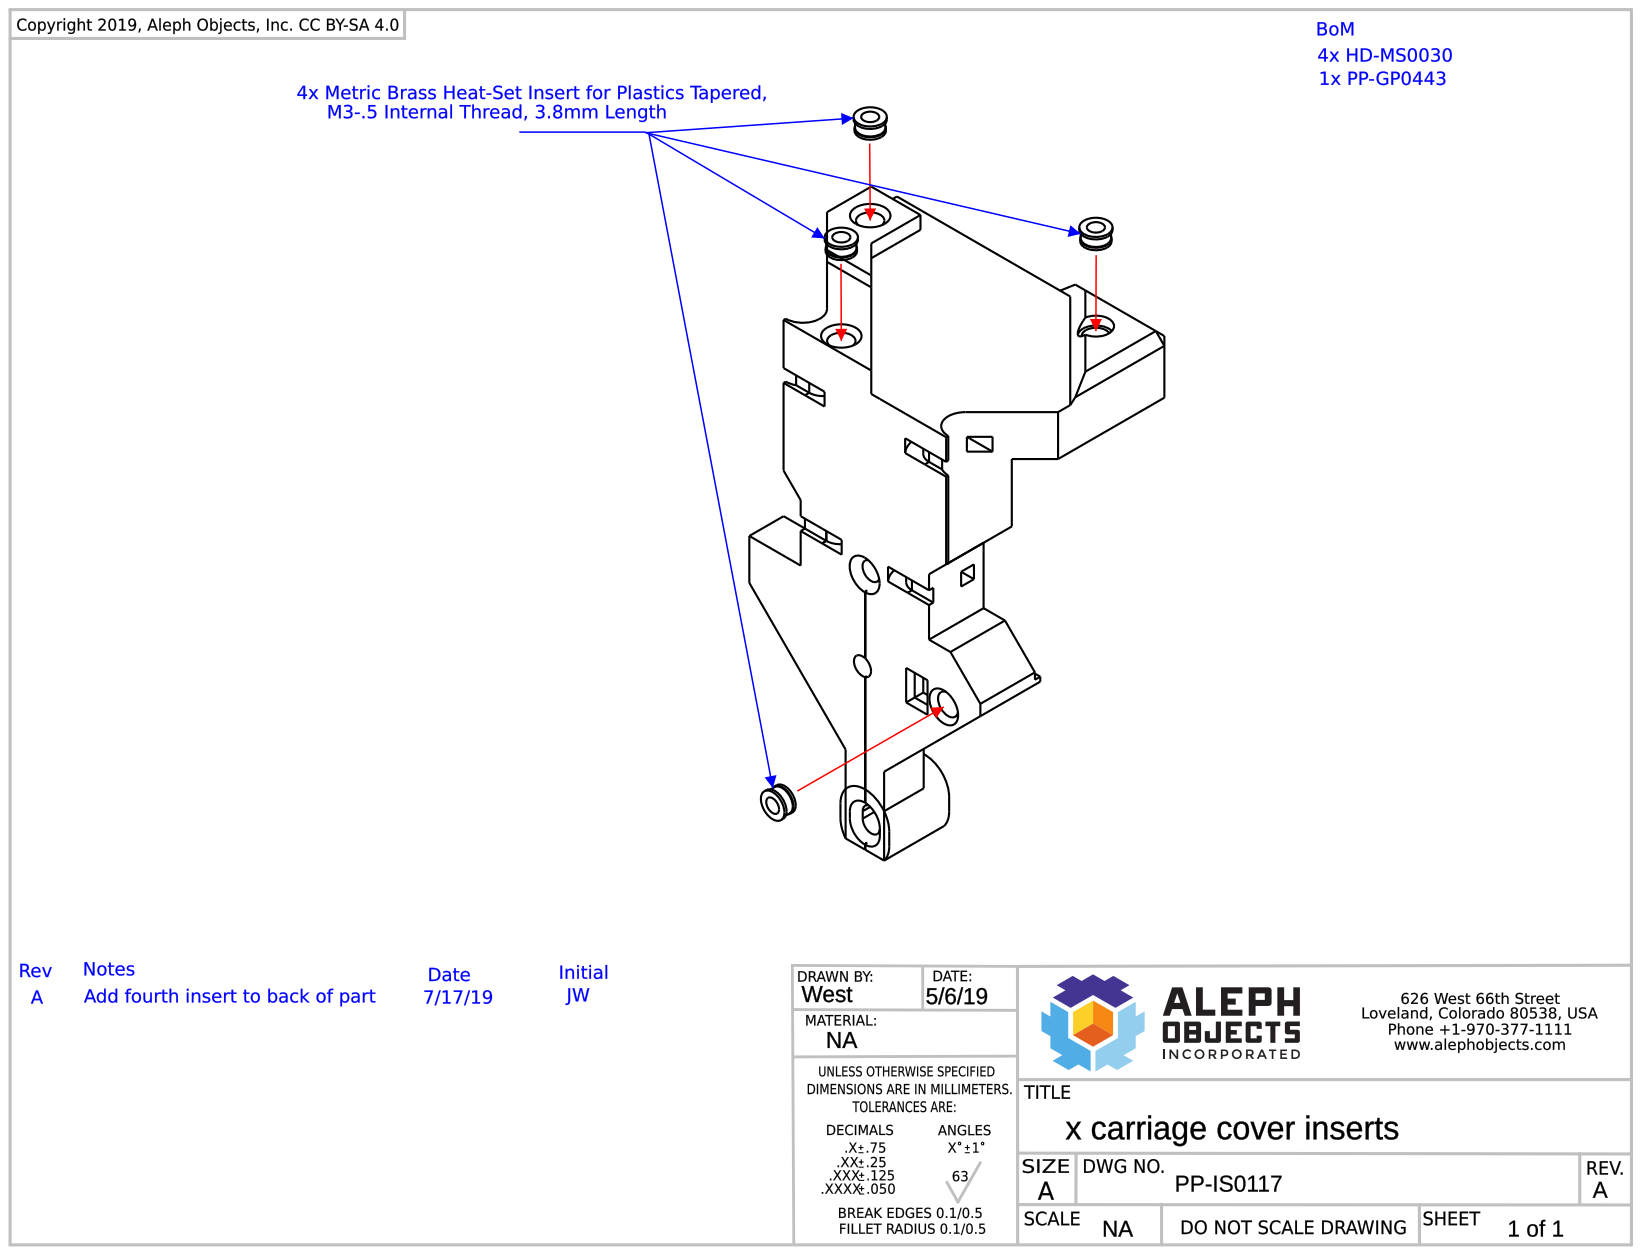
[picture p138: page 1]
