joeyliu522/VVI-project/CAD files/Older 3D printed parts/production_parts/assemblies/insert_assmeblies/PP-IS0118_extruder_cap_inserts_revA.pdf

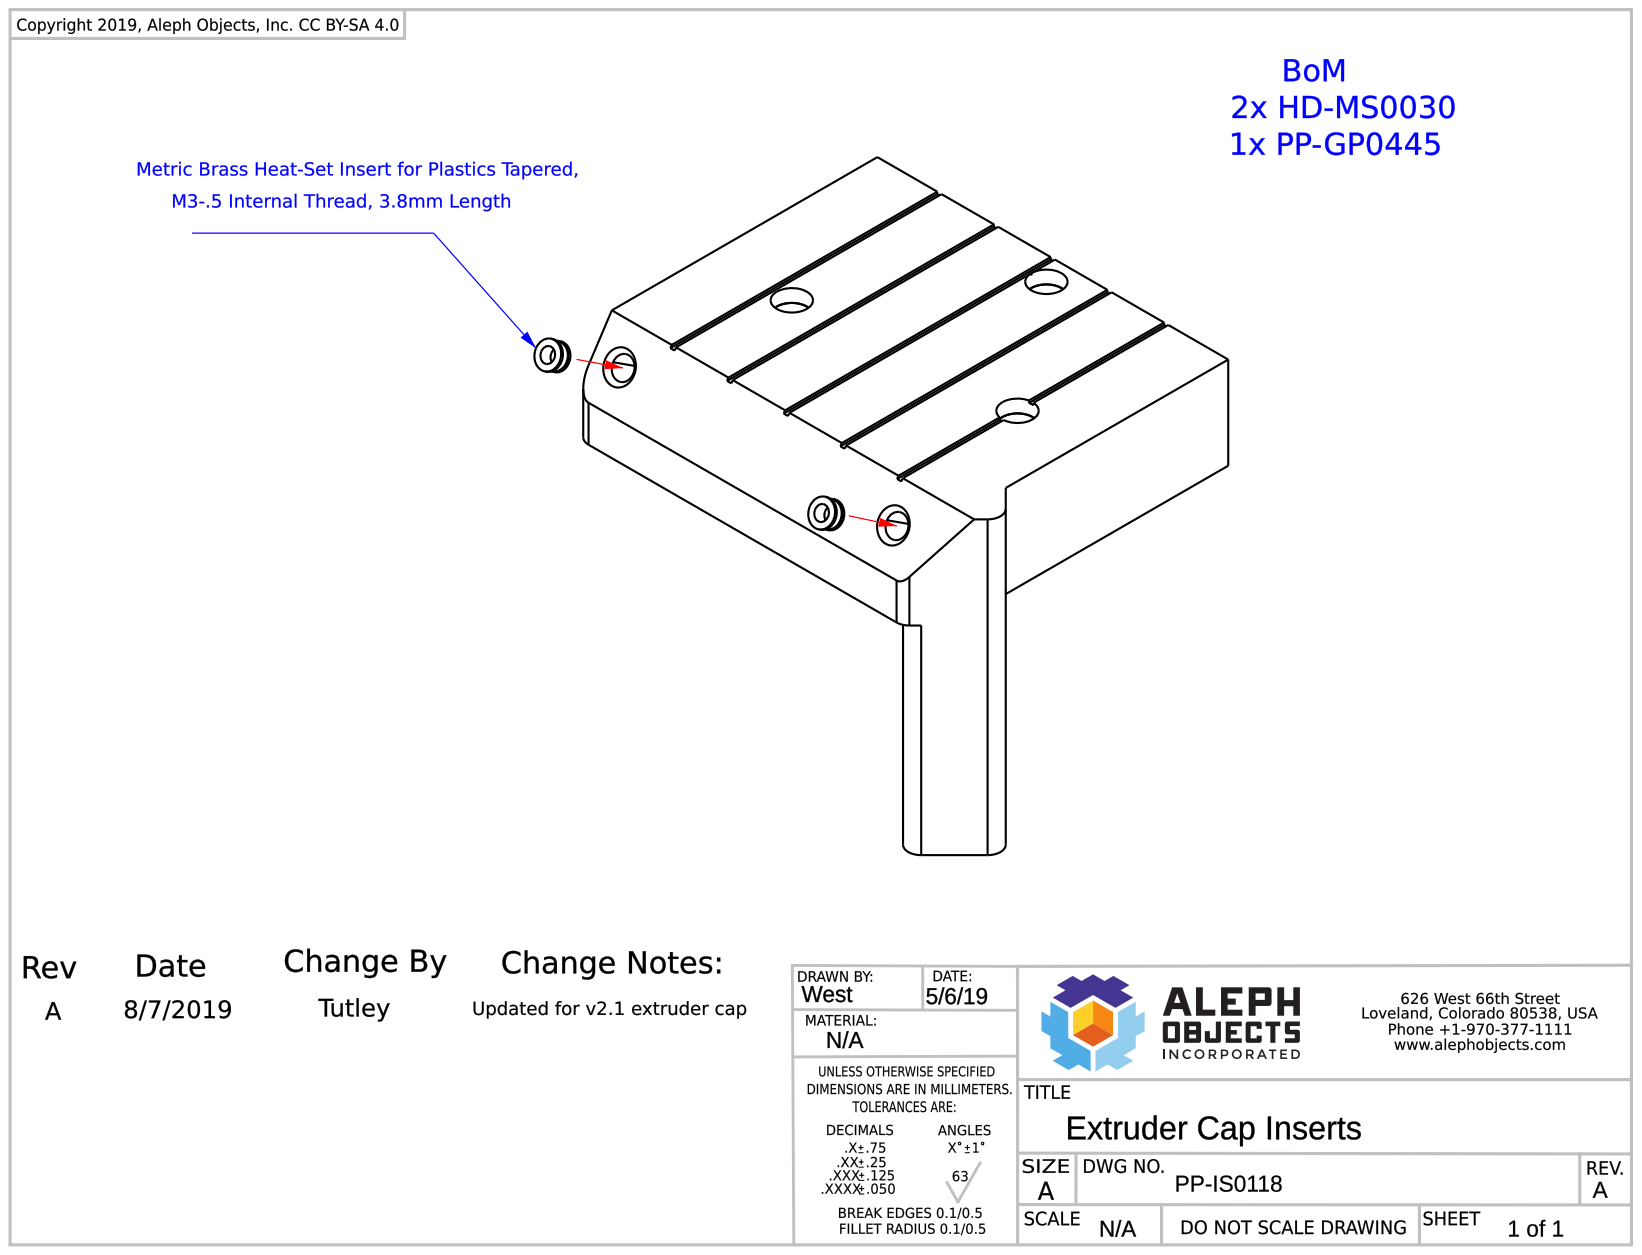
[picture p139: page 1]
