joeyliu522/VVI-project/CAD files/Older 3D printed parts/production_parts/hot_end/e3d_hot_tightened_assembly/hardened_steel_0.5_hot_end.pdf

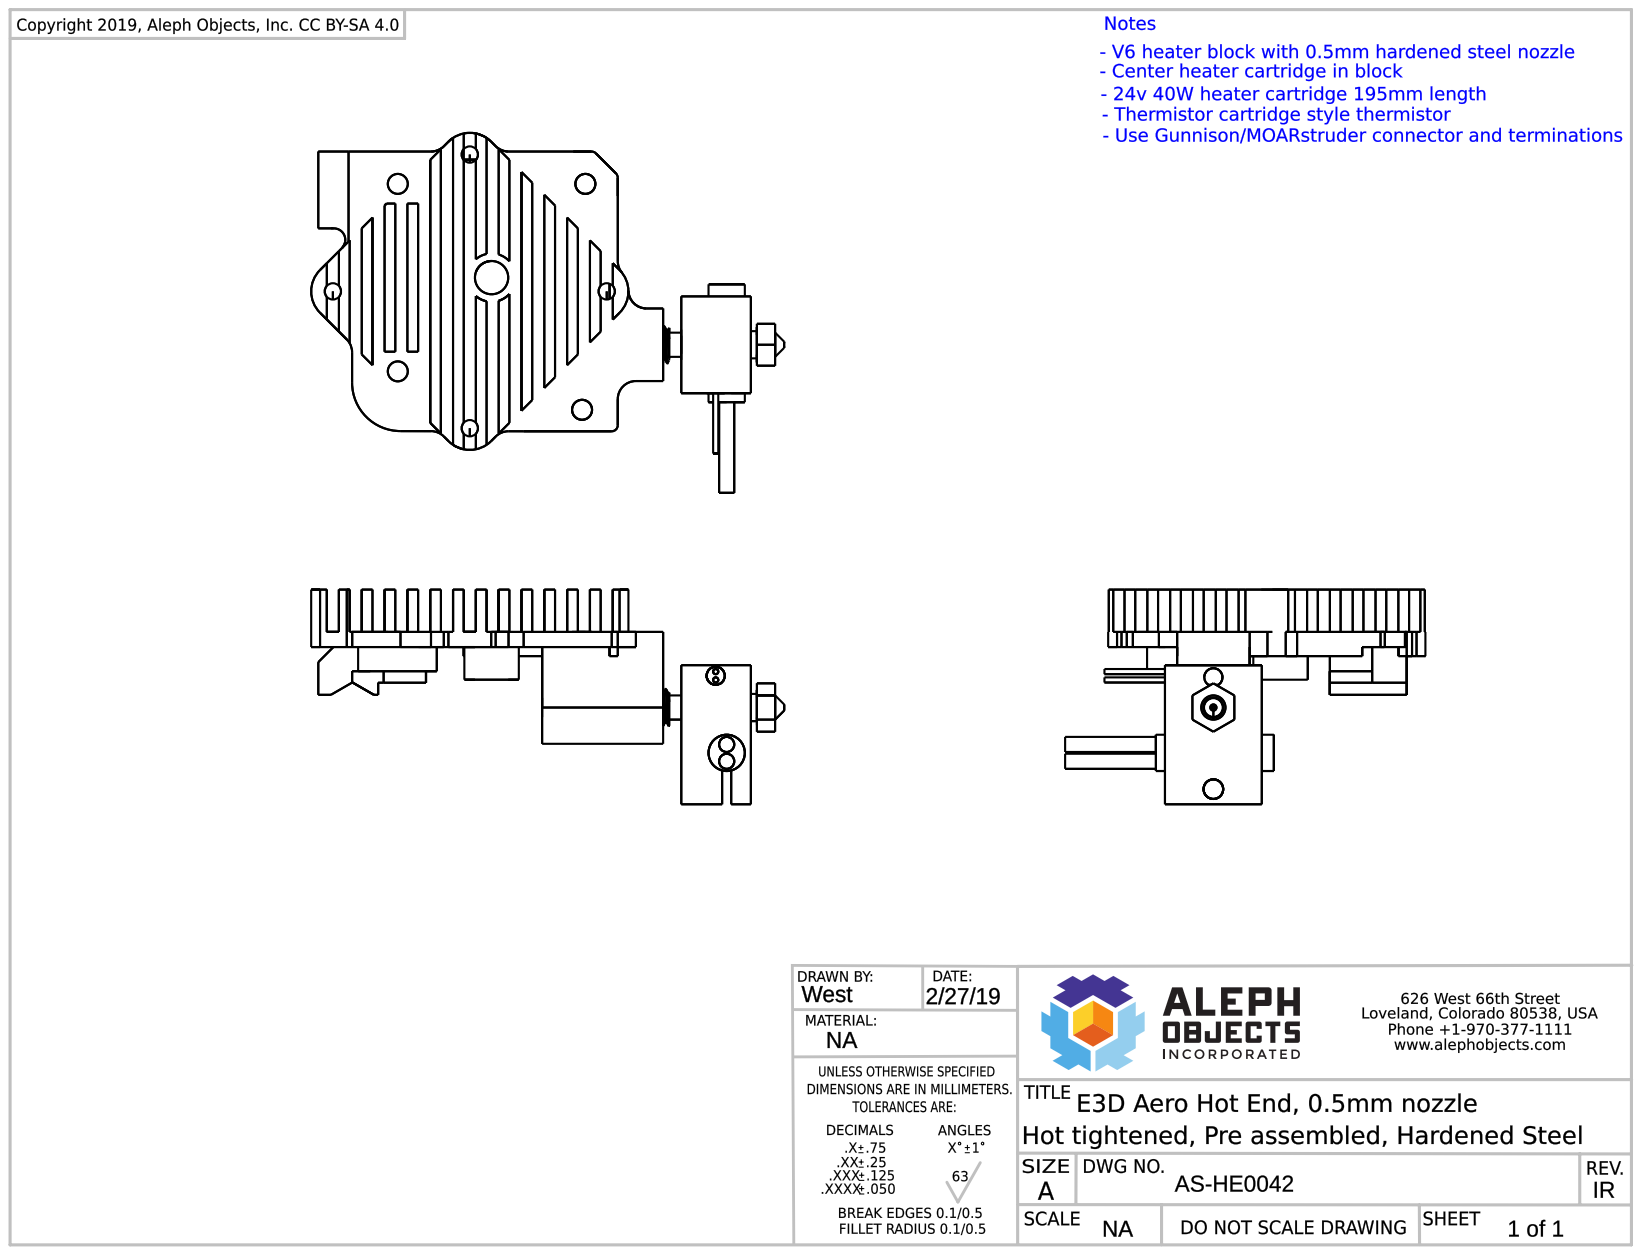
[picture p140: page 1]
