joeyliu522/VVI-project/CAD files/Older 3D printed parts/production_parts/machined_parts/10_12_mm_smooth_rods/12mmx540_rod.pdf

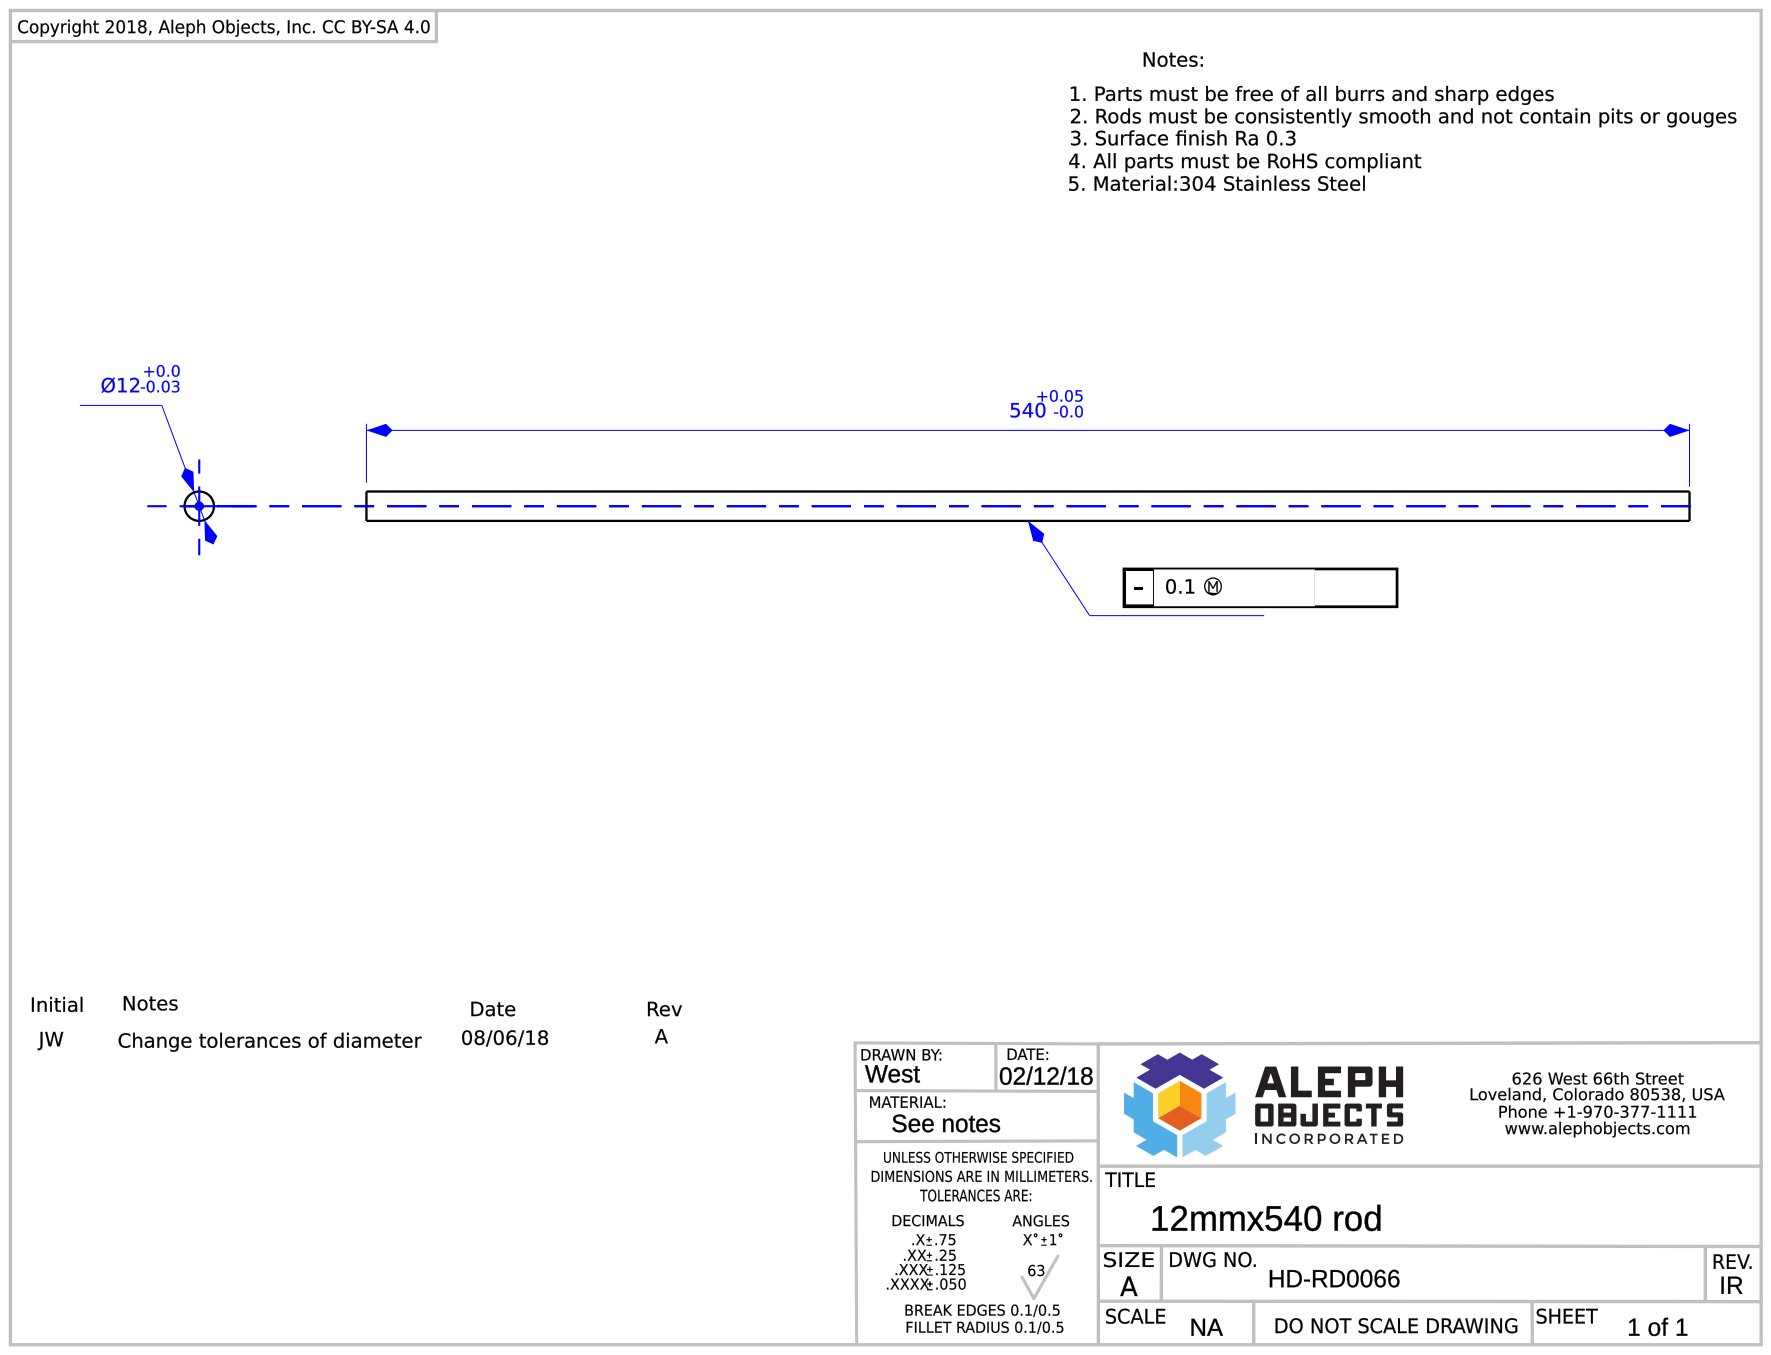
[picture p145: page 1]
