joeyliu522/VVI-project/CAD files/Older 3D printed parts/production_parts/machined_parts/LULZBOT_plaque/LULZBOT_plaque.pdf

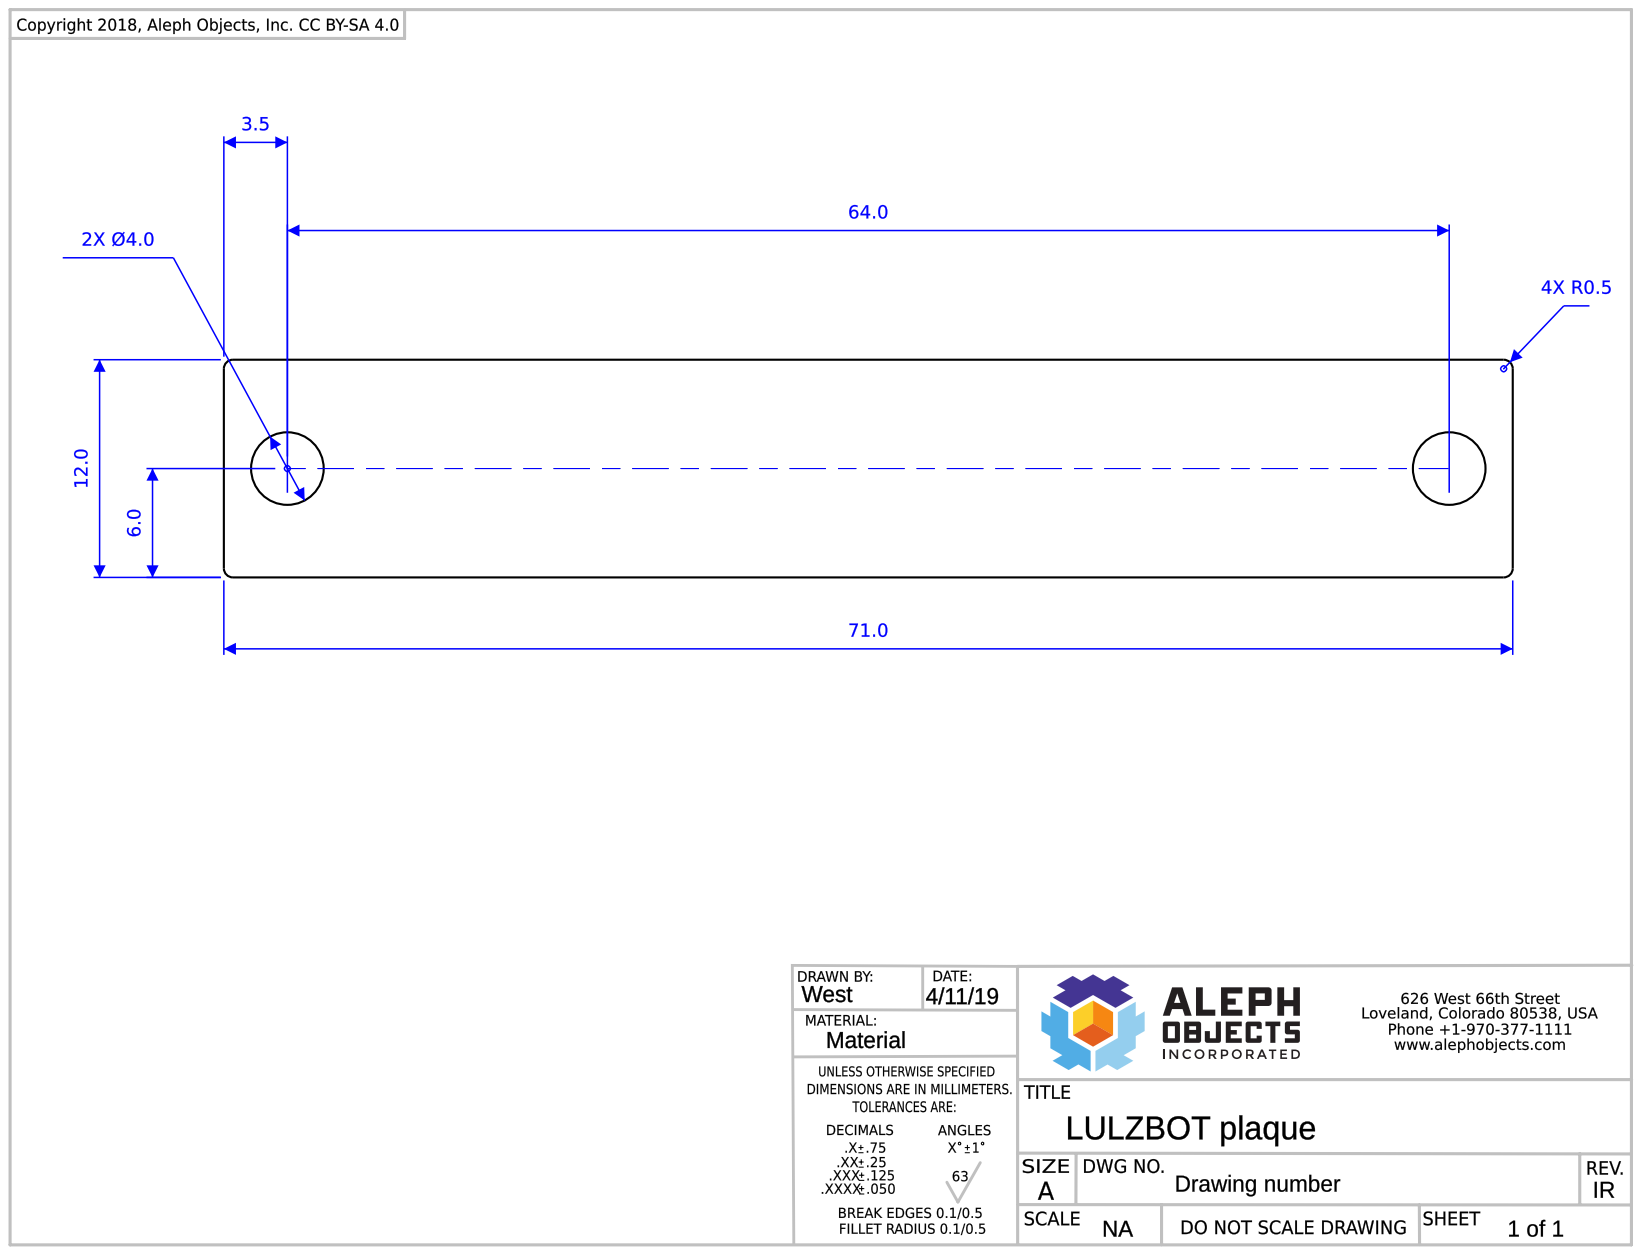
[picture p146: page 1]
