joeyliu522/VVI-project/CAD files/Older 3D printed parts/production_parts/electronics/RAMBo/board/Adapters/RAMBoSCadapter/RAMBoSCadapter.brd

## EAGLE design CAD files/Older 3D printed parts/production_parts/electronics/RAMBo/board/Adapters/RAMBoSCadapter/RAMBoSCadapter.brd (2023-08-08, an earlier design)

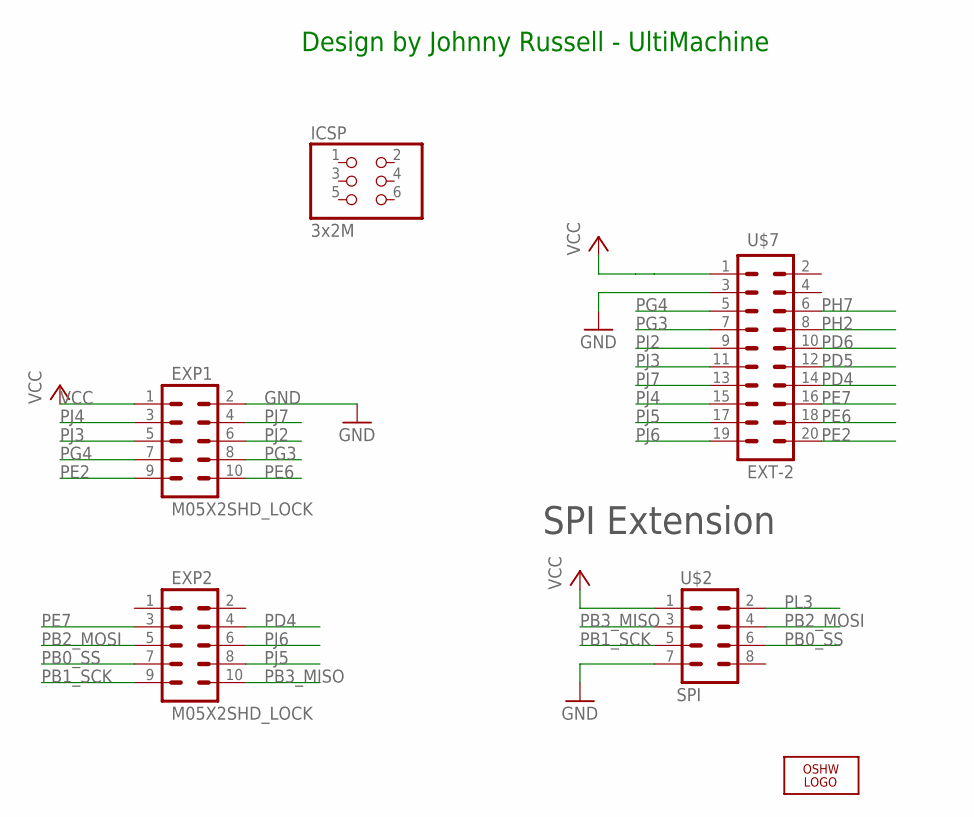
[picture p150: schematic RAMBoSCadapter.sch]

Parts:
EXP1, EXP2: M05X2SHD_LOCK; 2X5-SHROUDED_LOCK
ICSP: 3x2M; 2X03
LOGO1: OSHW_LOGO_8MILX0150-NT; OSHW_8X150_NOTEXT
U$2: SPI; 2X4
U$7: EXT-2; 2X10

Connections:
GND: EXP1.2, U$2.7, U$7.3
PB0_SS: EXP2.7, U$2.6
PB1_SCK: EXP2.9, U$2.5
PB2_MOSI: EXP2.5, U$2.4
PB3_MISO: EXP2.10, U$2.3
PD4: EXP2.4, U$7.14
PD5: U$7.12
PD6: U$7.10
PE2: EXP1.9, U$7.20
PE6: EXP1.10, U$7.18
PE7: EXP2.3, U$7.16
PG3: EXP1.8, U$7.7
PG4: EXP1.7, U$7.5
PH2: U$7.8
PH7: U$7.6
PJ2: EXP1.6, U$7.9
PJ3: EXP1.5, U$7.11
PJ4: EXP1.3, U$7.15
PJ5: EXP2.8, U$7.17
PJ6: EXP2.6, U$7.19
PJ7: EXP1.4, U$7.13
PL3: U$2.2
VCC: EXP1.1, U$2.1, U$7.1

Notes on the sheet:
SPI Extension
Design by Johnny Russell - UltiMachine

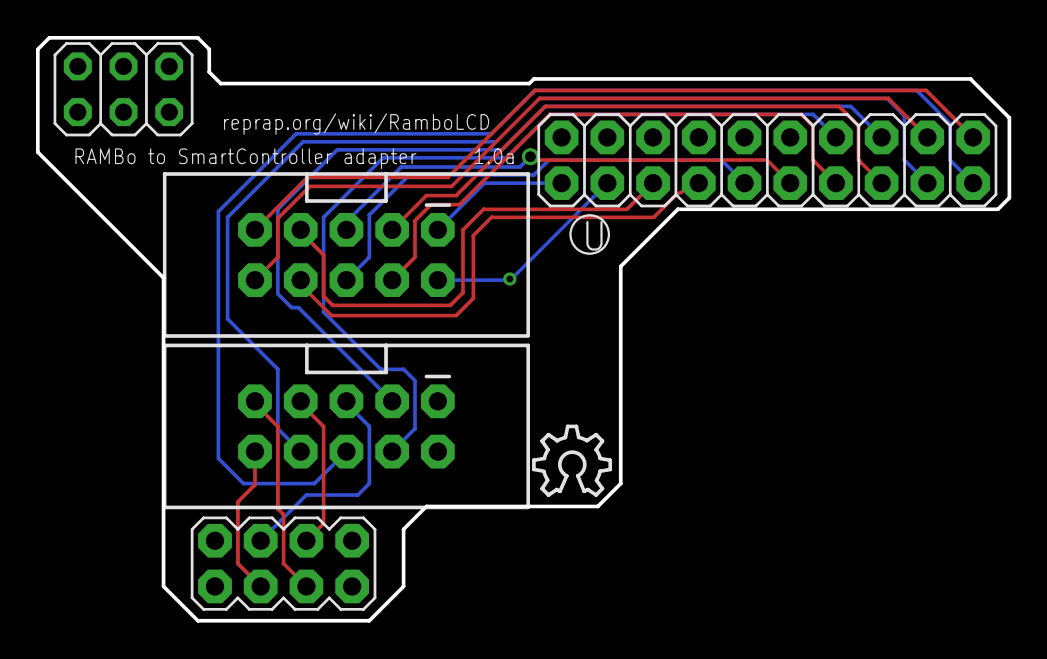
[picture p151: board RAMBoSCadapter.brd from above]

Board: 2 copper layers, 54.0 x 32.4 mm, 6 parts (0 on the bottom side), 18 nets.
