joeyliu522/VVI-project/CAD files/Older 3D printed parts/production_parts/electronics/RAMBo/board/Adapters/rambo_e2p/rambo_e2p.brd

## EAGLE design CAD files/Older 3D printed parts/production_parts/electronics/RAMBo/board/Adapters/rambo_e2p/rambo_e2p.brd (2023-08-08, an earlier design)

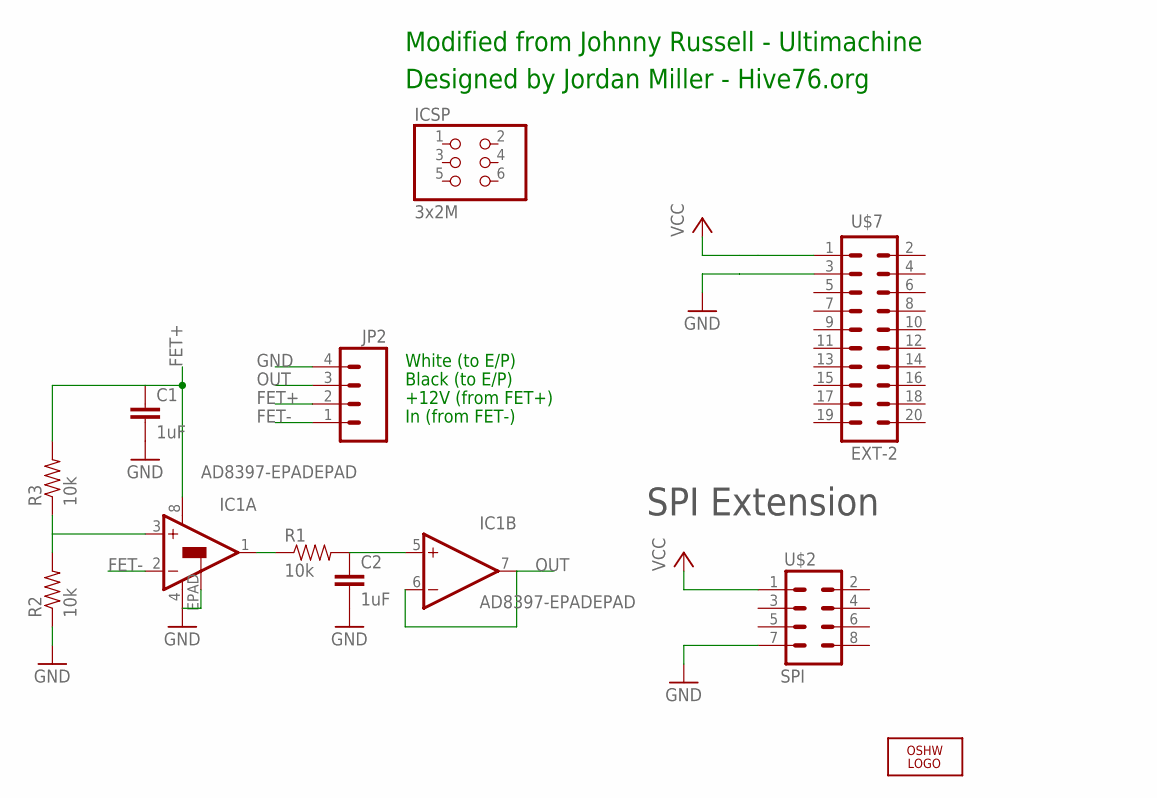
[picture p152: schematic rambo_e2p.sch]

Parts:
C1, C2: 1uF; 0805
IC1: AD8397-EPADEPAD; SO08-EPAD
ICSP: 3x2M; 2X03
JP2: M04SCREW; SCREWTERMINAL-3.5MM-4
LOGO1: OSHW_LOGO_8MILX0150-NT; OSHW_8X150_NOTEXT
R1, R2, R3: 10k; 0805
U$2: SPI; 2X4
U$7: EXT-2; 2X10

Connections:
FET+: C1.1, IC1.8 (V+), JP2.2, R3.2
FET-: IC1.2 (-IN), JP2.1
GND: C1.2, C2.2, IC1.4 (V-), IC1.EPAD, JP2.4, R2.1, U$2.7, U$7.3
unnamed: IC1.1 (OUT), R1.1
unnamed: C2.1, IC1.5 (+IN), R1.2
unnamed: IC1.3 (+IN), R2.2, R3.1
OUT: IC1.6 (-IN), IC1.7 (OUT), JP2.3
VCC: U$2.1, U$7.1

Notes on the sheet:
SPI Extension
+12V (from FET+)
White (to E/P)
Black (to E/P)
In (from FET-)
Modified from Johnny Russell - Ultimachine
Designed by Jordan Miller - Hive76.org

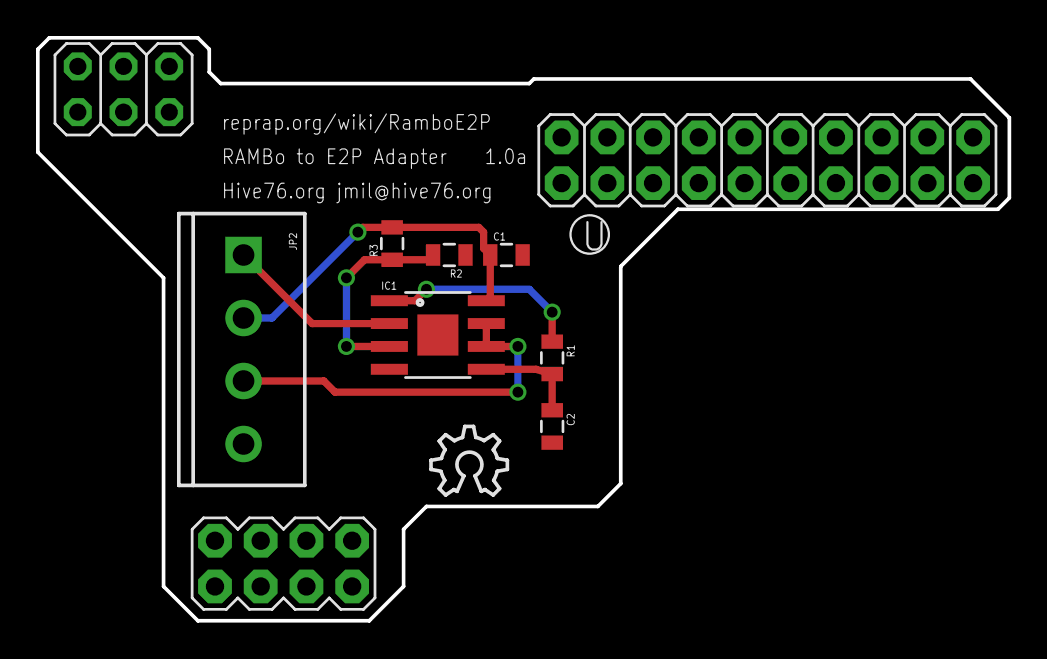
[picture p153: board rambo_e2p.brd from above]

Board: 2 copper layers, 54.0 x 32.4 mm, 11 parts (0 on the bottom side), 8 nets.
