joeyliu522/VVI-project/Arduino/Main Code/Sorter/Sorter.ino

/// Libraries to include
#include <elapsedMillis.h>
#include <Servo.h>

///Declaring Variables/Values
Servo gate1;
Servo gate2;

#define IRSENSOR1pin 22 //IR detector gate 1 for sensor 1 (S1)
#define IRSENSOR2pin 23 //IR detector gate 2 for sensor 2 (S2)
#define IRSENSOR3pin 24 //IR detector center tube for sensor 3 (S3)

#define Relay1pin 6 //Relay 1 signal for Antenna 1 (A1)
#define Relay2pin 7 //Relay 2 signal for Antenna 2 (A2)
#define Relay3pin 8 //Relay 3 signal for Antenna 3 (A3)

//Sorter 1 gate settings
//const int gateOpen = 1450; 
//const int gateClosed = 1150;

//////Sorter 2 gate settings
//const int gateOpen = 1550; 
//const int gateClosed = 1250;

//////Sorter 3 gate settings
//const int gateOpen = 1650; 
//const int gateClosed = 1250;

//////Sorter 4 gate settings
const int gateOpen = 1350; 
const int gateClosed = 1625;

//Various Timer values
const int checkTime1 = 5000; // Time to wait for mouse to trigger Antenna 2 on its way to MedPC chamber
const int checkTime2 = 3000; // Time to check only one mouse in center tube on its way to MedPC chamber
const int checkTime3 = 4000; // Time to hold mouse in center tube before allowing it back to home cage on its way back
const int gateTime = 5000; // How long the first gate stays open when a mouse is in the center tube and returning to the cage.
//When multiple mice were at the first gate we experienced that Antenna 1 could sometimes not read the mouse leaving and thus not resetting the main loop. 
//This makes sure the door closes, resets the main loop, and a new mouse is able to enter.
const int rfidTime = 4000; // How long Antenna 2 is turned on for when checkTime1 runs out G1 closes and Sensor 3 detects a mouse inside. 
//This was added because we saw that mice can be hesistant and stay right underneath the gate blocking the IR sensor and not triggering Antenna 2. After the mice are comfortable they then
//enter the center tube and this way we give them a 2nd chance to be read by Antenna 2.
 

//Gate variables
const int steps = 12; 
const int degreePerStep = (gateOpen-gateClosed)/steps;
int gateCounter = 0;

//IR variables
int sensorState1 = 0;
int sensorState2 = 0;
int sensorState3 = 0;


//Values obtained from Python
int maxEntries;
int numMice;
String IDarray[] = {"","","","","","","","","",""};
int TimeoutBool[] = {1,1,1,1,1,1,1,1,1,1};


String ID = ""; //Used for scanning in ID 

//Keeping track of entries of each mouse for arduino so it knows if it should allow a mouse to enter based on the max entries constraint
int entries[] = {0,0,0,0,0,0,0,0,0,0};
int attemptedEntries [] ={0,0,0,0,0,0,0,0,0,0};
String invalidArray [] = {"","","","","","","","","",""};

//TRUE OR FALSE that get changed by Python
bool ExperimentTimeReached = false;  
bool BeginExp = false;
bool ContExp = true;
bool ExpTerm = false;

//Changed by IR sensors
bool MouseInCenter = true;

//The variable that receives python command to continue executing
String readstring = "";//RENAME 



void setup() {
  
  //Setup serial ports, servo pin locations, IR sensor pin type, initiate pull-up resistor on IR pins
  Serial.begin(9600);  
  Serial1.begin(9600);
  Serial1.setTimeout(100);
 
  gate1.attach(9);
  gate2.attach(10);

  pinMode(IRSENSOR1pin, INPUT);
  pinMode(IRSENSOR2pin, INPUT);
  pinMode(IRSENSOR3pin, INPUT);

  digitalWrite(IRSENSOR1pin,HIGH);
  digitalWrite(IRSENSOR2pin,HIGH);
  digitalWrite(IRSENSOR3pin,HIGH);


  pinMode(Relay1pin, OUTPUT);
  pinMode(Relay2pin, OUTPUT);
  pinMode(Relay3pin, OUTPUT);

  digitalWrite(Relay1pin,LOW);
  digitalWrite(Relay2pin,LOW);
  digitalWrite(Relay3pin,LOW);

  
  // Reset gates to be closed,allows you to see if gates become blocked 
  //Keep gate open so you dont have to turn on/off
  gate1.writeMicroseconds(gateOpen);
  delay(2000);
  gate1.writeMicroseconds(gateClosed);
  delay(2000);
  gate1.writeMicroseconds(gateOpen);
  delay(1000);
  gate2.writeMicroseconds(gateOpen);
  delay(2000);
  gate2.writeMicroseconds(gateClosed);
  delay(2000);
  gate2.writeMicroseconds(gateOpen);



  //For Event based med closure
  //pinMode(26,INPUT);

  //Set RFID module active (when RFID module is powered on it is by default set active. This is incnase it was set deactive during testing) and turn on Antenna 1
  Serial1.write("SRA\r");
  Serial1.readString();
  
  digitalWrite(Relay1pin,HIGH);


  //Send Arduino Ready message, Scan ID's if neccessary, and begin experiment function
  Serial.println("Arduino Ready");
  while (!BeginExp){
  while (Serial.available() ==0) {}
  readstring = Serial.readString();
  if (readstring == "1"){
  Serial.println("Scan Mouse ID");
  while (Serial1.available() ==0) {}
  ID = "ScanID:" + Serial1.readString().substring(4,16);
  Serial.println(ID);
  }
  
  else if(readstring == "0") {
  Serial.println("Begin Experiment");
  BeginExp = true;
  }
  }

  //Python transfers relevant variables/arrays to Arduino
  while(Serial.available() == 0){}
  numMice = Serial.readString().toInt();
  while(Serial.available() == 0){}
  maxEntries = Serial.readString().toInt();

  int i = 0; 
  while (i < numMice) {
  while(Serial.available() == 0){}
  IDarray[i] = Serial.readString();
  Serial.println(IDarray[i]);
  Serial.println(i);
  i++;
  }

  // Close gate before experiment
  gate1.writeMicroseconds(gateClosed);
  delay(500);
  gate2.writeMicroseconds(gateClosed);

  //Send message to Python to start Experiment Timer
  Serial.println("Experiment Timer Started");
 }
 





void loop() {


//Main loop for regulating mouse entrance into the sorter, is described by the logic flowchart 
while (ContExp){ 


  //Variables that reinitialize upon every mouse entrance
  int check = 0; //index that is used when finding which mouse enters. We search thru the ID array and check will be set to the slot number in the array which has the entering mouse's ID.
  bool M2eM1 = false; // M @ Antenna 2 equals M @ Antenna 1
  bool Mscanned = false; //M scanned at Antenna 2
  bool Zone2Cont = true; // Correct mouse in chamber, only 1
  bool tORf; //Flexible boolean variable
  //bool zone1 = false; THIS WAS COMMENTED PROBABLY NOT NEEDED BUT COULD BE A CAUSING A PROBLEM IF WE ENCOUNTER SOME WEIRD SHIT

  //Variables changed by Python
  bool MinTestTimeReached = false;
  bool MaxTestTimeReached = false;

  //Variables that store the ID read at each antenna
  String mouseZone1=""; //ID read @Antenna 1
  String mouseZone2=""; //ID read @Antenna 2
  String mouseZone3=""; //ID read @Antenna 3

  //Extra variables that store ID values for special cases when a mouse is stuck or multiple mice enter
  String mouseStuckID = ""; //mouse in the center tube when it shouldn't be
  String mouseCheck="";   //Checking for multiple mice
  String ExitID = "";     //Store ID when mouse is coming back into cage 

  
  // Wait for a mouse to trigger Antenna 1 
  while (Serial1.available() == 0) {}
 
  
  //Read ID from Antenna 1, only stores the string values from position 4 to position 16 of the string(with our current tags it removes -->  999_ or 900_ )
  mouseZone1 = Serial1.readString().substring(4,16);

  //Prints out the ID to Python serial monitor
  Serial.println(mouseZone1);

  //Check if time is under total Exp Time
  Serial.println("Check Exp Time");
  while(Serial.available()==0){}
  readstring = Serial.readString();
  if (readstring == "1"){
  ContExp = true;
    }
  else {
  ContExp = false;
  ExpTerm = true;
    }

  //If current experiment time is less than the total allowable experiment time
  if (ContExp) {

  //Find which mouse is trying to enter by searching thru ID array
  check = 0;
  while (mouseZone1 != IDarray[check]) { 
  check++;
  }


  //Send signal to Python to get the updated Timeout status of each mouse
  Serial.println("Update Timeout");

  //Read the timeout array values from Python
  String TimeoutString = "";
  while(Serial.available() == 0){}
  TimeoutString = Serial.readString();
  
  int k = 0; 
  while (k < numMice) {
  TimeoutBool[k] = TimeoutString.substring(k,k+1).toInt();
  Serial.println(TimeoutBool[k]);
  k++;
  }
  
  
  //Check if mouse can enter based entries  and timeout criteria, turn off Antenna 1, turn on Antenna 2, Open Gate 1
  if (entries[check] < maxEntries &&  TimeoutBool[check] == 1) {

    digitalWrite(Relay1pin,LOW); //turn off Antenna 1
    digitalWrite(Relay2pin,HIGH); //turn on Antenna 2

    gate1.writeMicroseconds(gateOpen); //open gate 1
    Serial.println("G1 Open");
    
    //Start checktimer,
    tORf= true;
    elapsedMillis checkTimer;
 

  //Wait for Antenna 2 to be triggered , close once it is triggered or checkTime 1 is reached
  while(Mscanned == false && checkTimer < checkTime1){ 
  mouseZone2 = Serial1.readString().substring(4,16);
  Serial.println(mouseZone2);


    //the case where the mouse that triggered Antenna 1 triggered Antenna 2
    if(mouseZone2 == mouseZone1){ 
    Mscanned = true;
    M2eM1 = true; 
    }
    
    if(mouseZone2 != mouseZone1 && mouseZone2 != ""){// the case where mouse that triggersgate to open turns around and another mouse enters the tube these conditions are set
    Mscanned = true;
    M2eM1 = false;  
    }  

    //if no mouse read at Antenna 2
    if(mouseZone2 == ""){      
    Mscanned= false;
      }
    }

    //Close gate 1 slowly
    while(gateCounter < steps){
    sensorState1 = digitalRead(IRSENSOR1pin);
    if ( sensorState1 == HIGH){
    gate1.writeMicroseconds(gateOpen - (gateCounter+1)*degreePerStep);
    gateCounter ++;
    delay(150);
    }
    else if (sensorState1 == LOW){
    while(digitalRead(IRSENSOR1pin) == LOW){}  
    }
    }
    gateCounter = 0;
    Serial.println("G1 close");


    // If M2 = M1 , ID read at Antenna 2 equals ID read at Antenna 1
    if(Mscanned == true && M2eM1 == true){ 

    //Check to see if there is a mouse inside center tube
    sensorState3 = digitalRead(IRSENSOR3pin);
    if(sensorState3 == LOW){
    MouseInCenter = true ;
    Serial.println("Mouse in tube");
   }
   else if (sensorState3 == HIGH){
    MouseInCenter = false;
    Serial.println("Mouse not in tube");

    }
    
  //Mouse in center tube  
  if (MouseInCenter) {  

    
  //Wait checkTime2 seconds and read Antenna 2 to make sure only one mouse 

          //Start timer 
          tORf = true;
          elapsedMillis checkTimer;
          
          int i = 0; /////added this for invalidArray to store the invalid 
          while(Zone2Cont && checkTimer < checkTime2){ 
          if(Serial1.available() !=0 ){                   /////////ADDEDEDED NEW TO CHECK
          mouseCheck = Serial1.readString().substring(4,16);
          Serial.println(mouseCheck);
          if(mouseCheck == mouseZone2 || mouseCheck== ""){
          Zone2Cont = true;
          Serial.println("Only 1 Mouse");
          }
          
          else{
          int inval = 0;
          while (mouseCheck != IDarray[inval]) {
          inval++;
          }
          invalidArray[inval]=invalidArray[inval]+1;
          Zone2Cont = false;
          Serial.println("More than 1 Mouse");
          }
          }
          }

          

          ///Turn off Antenna 2
          digitalWrite(Relay2pin,LOW); 
          
        
          //If only 1 mouse is in center tube
          if(Zone2Cont){
          AllowEntry://This is a goto point when M @ A2 is not read, but there is a mouse in the center tube


          //Turn on Antenna 3
          digitalWrite(Relay3pin,HIGH);
            
          //Open gate 2 
          gate2.writeMicroseconds(gateOpen);
          Serial.println("G2 Open");

         

          ///Wait for trigger @ Antenna 3, close Gate 2
          while (Serial1.available() == 0) {}
          /////////////ADD some code here to store the ID value and check zone 3 = zone 2 to final check         

          //Close gate 2 slowly
          while(gateCounter < steps){
          sensorState2 = digitalRead(IRSENSOR2pin);
          if (sensorState2 == HIGH){
          gate2.writeMicroseconds(gateOpen - (gateCounter+1)*degreePerStep);
          gateCounter ++;
          delay(150);
          }

          else if (sensorState2 == LOW){
          while(digitalRead(IRSENSOR2pin) == LOW){}
          }
          } 
          gateCounter = 0;
          Serial.println("G2 close");

          
         
          //Check to see if mouse in center tube
          MouseInCenter = true;
          while (MouseInCenter){

          //Read IR tube sensor
          sensorState3 = digitalRead(IRSENSOR3pin);
          if(sensorState3 == LOW){
          MouseInCenter = true ;
          Serial.println("Mouse in tube");

         }
         else if (sensorState3 == HIGH){
          MouseInCenter = false;
          Serial.println("Mouse not in tube");

          }

          //Mouse in center tube
          if(MouseInCenter){
            
          //Open Gate 2
          delay(1500);//To have a little wait time
          gate2.writeMicroseconds(gateOpen);
          Serial.println("G2 Open");

          ///Read from Antenna3 3 and close gate 2
          while (Serial1.available() == 0) {}
          /////////////ADD some code here to store the ID value and check zone 3 = zone 2 to final check


         ///Close gate 2 slowly
          while(gateCounter < steps){
          sensorState2 = digitalRead(IRSENSOR2pin);
          if (sensorState2 == HIGH){
          gate2.writeMicroseconds(gateOpen - (gateCounter+1)*degreePerStep);
          gateCounter ++;
          delay(150);
          }

          else if (sensorState2 == LOW){
          while(digitalRead(IRSENSOR2pin) == LOW){}
          }
          } 
          gateCounter = 0;
          Serial.println("G2 close");
          }  
          }



          //Turn off Antenna 3
          digitalWrite(Relay3pin, LOW);

          
          entries[check]=entries[check]+1; 
          
          //Send signal to Python to Start Med PC session
          //readstring = "StartMED:";
          Serial.print("M:");
          Serial.println(check);
          Serial.println("StartMED:");

          //Waiting for Python to send signal to continue executing code below
          while(Serial.available() == 0){}
          readstring = Serial.readString();
          

          //Minimum Time check
          while(!MinTestTimeReached){  
          ////read RFID 3 and see if another mouse is present, could be a nice to have 
          
          //Ask Python if Min time reached
          Serial.println("Mintimechck");
          while(Serial.available() == 0) {} 
          readstring = Serial.readString();
          if (readstring == "0"){
            MinTestTimeReached = true;
            }
          }
          
          Serial.println("Min Time Reached");


          //Turn on Antenna 3
          digitalWrite(Relay3pin,HIGH);
          Serial1.readString();///CLEAR ANY INFO ,BANDAID FIX

         
          //Ask Python if max test time reached
          tORf = true;
          while(!MaxTestTimeReached && tORf){
          ///////read RFID 3 and see if another mouse is present, end session could be a nice to have
          mouseZone3= Serial1.readString().substring(4,16);
          if(mouseZone3 != ""){ //********Changed bc mouse was able to move past gate

          Serial.println(mouseZone3);


          ///MOVED Closing of MED PC and COPY DATA before gate 2 opening, mice trigger shut off if they trigger antenna 3 after min time 
          Serial.println("CloseMED");
          //Serial.println("Remove Zeros"); // we no longer use this since we've implemented the K pulse
          Serial.println("Copy Data");

          
          //Turn off Antenna 3
          digitalWrite(Relay3pin, LOW);

          //Turn on Antenna 2
          digitalWrite(Relay2pin,HIGH);

          //Open gate 2 
          gate2.writeMicroseconds(gateOpen);
          Serial.println("G2 Open");

          //Wait until mouse triggers Antenna 2
          while(Serial1.available() ==0){}


          //Close gate 2 slowly
          while(gateCounter < steps){
          sensorState2 = digitalRead(IRSENSOR2pin);
          if (sensorState2 == HIGH){
          gate2.writeMicroseconds(gateOpen - (gateCounter+1)*degreePerStep);
          gateCounter ++;
          delay(150);
          }

          else if (sensorState2 == LOW){
          while(digitalRead(IRSENSOR2pin) == LOW){}
          }
          } 
          gateCounter = 0;
          Serial.println("G2 close");
      

         //Turn off antenna 2
         digitalWrite(Relay2pin,LOW);

        tORf = false;

          
        //Check to see if there is a mouse inside center tube
        MouseInCenter = false;
        while(!MouseInCenter){

        //Read IR tube sensor
        sensorState3 = digitalRead(IRSENSOR3pin);
        if(sensorState3 == LOW){
        MouseInCenter = true ;
        Serial.println("Mouse in tube");

       }
       else if (sensorState3 == HIGH){
        MouseInCenter = false;
       Serial.println("Mouse not in tube");

        }


        //No mouse in center tube
        if(!MouseInCenter){

          //Turn On Antenna 2
          digitalWrite(Relay2pin,HIGH);

          delay(1000); //ADDED ON 10/14 gate was openly quickly
          gate2.writeMicroseconds(gateOpen);
          Serial.println("G2 Open");
          while(Serial1.available() == 0 ){}
          mouseZone3= Serial1.readString().substring(4,16);
          Serial.println(mouseZone3);

             
          //Turn off Antenna 2
          digitalWrite(Relay2pin,LOW);
          
          //Close gate 2 with gate safety
          while(gateCounter < steps){
          sensorState2 = digitalRead(IRSENSOR2pin);
          if (sensorState2 == HIGH){
          gate2.writeMicroseconds(gateOpen - (gateCounter+1)*degreePerStep);
          gateCounter ++;
          delay(150);
          }

          else if (sensorState2 == LOW){
          while(digitalRead(IRSENSOR2pin) == LOW){}
          }
          } 
          gateCounter = 0;
          Serial.println("G2 close");
      }
      
      }
          }

          //Send signal to Python to check if Maxtime has been reached, read signal from Python
          Serial.println("Maxtimechck");
          while(Serial.available() == 0) {}
          readstring = Serial.readString();
          if (readstring == "0"){
            MaxTestTimeReached = true;
            }
            
          }//While loop for maxtime

          //Mouse didnt leave before max time reached
          if(tORf){

          //Turn off Antenna 3
          digitalWrite(Relay3pin,LOW);

          //Turn on Antenna 2
          digitalWrite(Relay2pin,HIGH);

          //Open Gate 2
          gate2.writeMicroseconds(gateOpen);
        
          Serial.println("Max Time Reached");

          //Read from Antenna2
          while (Serial1.available() == 0) {}
          mouseZone3= Serial1.readString();
             

          //Turn off Antenna 2
          digitalWrite(Relay2pin,LOW);

          //Close gate 2 slowly
          while(gateCounter < steps){
          sensorState2 = digitalRead(IRSENSOR2pin);
          if (sensorState2 == HIGH){
          gate2.writeMicroseconds(gateOpen - (gateCounter+1)*degreePerStep);
          gateCounter ++;
          delay(150);
          }
          
          else if (sensorState2 == LOW){
          while(digitalRead(IRSENSOR2pin) == LOW){}
          }
          } 
          gateCounter = 0;
          Serial.println("G2 close"); 


        //Check to see if there is a mouse inside center tube
        MouseInCenter = false;
        while(!MouseInCenter){

        //Read IR tube sensor
        sensorState3 = digitalRead(IRSENSOR3pin);
        if(sensorState3 == LOW){
        MouseInCenter = true ;
       Serial.println("Mouse in tube");
       
       }
       else if (sensorState3 == HIGH){
        MouseInCenter = false;
        Serial.println("Mouse  not in tube");

        }

        //No mouse in center tube
        if(!MouseInCenter){

          //Turn on antenna 2
          digitalWrite(Relay2pin,HIGH);
          
          gate2.writeMicroseconds(gateOpen);
          Serial.println("G2 Open");
          while(Serial1.available() == 0 ){}
          mouseZone3= Serial1.readString().substring(4,16);
          Serial.println(mouseZone3);

           
          //Turn off Antenna 2
          digitalWrite(Relay2pin,LOW);

          
          //Close gate 2 with gate safety
          while(gateCounter < steps){
          sensorState2 = digitalRead(IRSENSOR2pin);
          if (sensorState2 == HIGH){
          gate2.writeMicroseconds(gateOpen - (gateCounter+1)*degreePerStep);
          gateCounter ++;
          delay(150);
          }

          else if (sensorState2 == LOW){
          while(digitalRead(IRSENSOR2pin) == LOW){}
          }
          } 
          gateCounter = 0;
          Serial.println("G2 close");
     }
       }

    //Send Signal to Python to copy data to excel
    Serial.println("Copy Data");     
     }



    //Turn on Antenna 1
    digitalWrite(Relay1pin,HIGH);
    delay(checkTime2);//MOVED HERE TO ALLOW TIME

    //Open G1
    gate1.writeMicroseconds(gateOpen);
    Serial.println("G1 Open");

    tORf = true;

   
    //Continously read from Antenna 1 until the mouse leaves
    while(tORf){ 
    elapsedMillis gateTimer;
    while(gateTimer < gateTime && tORf){///// ADDED A TIME HERE AS THE FIX WHEN A MOUSE IS TRYING TO EXIT AND ANOTHER IS PRESENT IN TUBE 1
    ExitID = Serial1.readString().substring(4,16);
    Serial.println(ExitID);
//  if(ExitID == mouseZone3){ //Added ExitID instead of readstring and "==" instead of "=", and mouseZone3 insteaed of 2
    if(ExitID == mouseZone2){ //changed back to mouseZone2

     
    //Close gate 1 with gate safety 
    while(gateCounter < steps){
    sensorState1 = digitalRead(IRSENSOR1pin);
    if ( sensorState1 == HIGH){
    gate1.writeMicroseconds(gateOpen - (gateCounter+1)*degreePerStep);
    gateCounter ++;
    delay(150);
    }

    else if (sensorState1 == LOW){
    while(digitalRead(IRSENSOR1pin) == LOW){}  
    }
    }
    gateCounter = 0;
    Serial.println("G1 close");


    //Turn off antenna 1
    digitalWrite(Relay1pin,LOW);
  
    tORf=false;
    }
    }//while for gatetimer


   //If ID not read by Antenna 1 within gatetime
   if(tORf){
    //Close gate 1 with gate safety 
    while(gateCounter < steps){
    sensorState1 = digitalRead(IRSENSOR1pin);
    if ( sensorState1 == HIGH){
    gate1.writeMicroseconds(gateOpen - (gateCounter+1)*degreePerStep);
    gateCounter ++;
    delay(150);
    }

    else if (sensorState1 == LOW){
    while(digitalRead(IRSENSOR1pin) == LOW){}  
    }
    }
    gateCounter = 0;
    Serial.println("G1 close");


    //Read IR tube sensor
    sensorState3 = digitalRead(IRSENSOR3pin);
    if(sensorState3 == LOW){
    MouseInCenter = true ;
    Serial.println("Mouse in tube");

    // Open Gate 1
    delay(500); //ADDED NEEDED A LITTLE BIT OF TIME HERE
    gate1.writeMicroseconds(gateOpen);
    Serial.println("G1 Open");

    tORf = true;
    }
   
    else if (sensorState3 == HIGH){
    MouseInCenter = false;
    Serial.println("Mouse  not in tube");
    tORf = false;
    }
    }

    }

//Send commant to Python to execute closing events 
Serial.println("Session Finished");
     


//Read the timeout array values from Python
TimeoutString = "";
while(Serial.available() == 0){}
TimeoutString = Serial.readString();

k = 0; 
while (k < numMice) {
TimeoutBool[k] = TimeoutString.substring(k,k+1).toInt();
Serial.println(TimeoutBool[k]);
k++;
}



          
}////IF not only one mouse 

      else {
          //Turn ON RFID 1, Open gate 1, check that each mouse made it out by scanning  


          //Turn Antenna 1 on
          digitalWrite(Relay1pin,HIGH);
          
          gate1.writeMicroseconds(gateOpen);
          Serial.println("G1 Open");
          
          //read the ID's of the 2 mice in the center tube or until rfidTime is reached. Don't want to trap them inside trying to read ID's.
          int k =0;
          elapsedMillis rfidTimer;
          while (k <2 &&  rfidTimer < rfidTime ){
          while(Serial1.available()==0){}
          readstring = Serial1.readString().substring(4,16);
       
          if (readstring == mouseZone2 || readstring == mouseCheck) { ///////NEEDS TO BE FIXED MAKE mousecheck AN ARRAY BECAUSE MOUSECHECK COULD BE EQUAL TO MOUSEZONE 2
          Serial.println(readstring);
          k++;  
          }
          }


 

          //Turn off antenna 1
          digitalWrite(Relay1pin,LOW);

    //Close gate 1 with gate safety 
    while(gateCounter < steps){
    sensorState1 = digitalRead(IRSENSOR1pin);
    if ( sensorState1 == HIGH){
    gate1.writeMicroseconds(gateOpen - (gateCounter+1)*degreePerStep);
    gateCounter ++;
    delay(150);
    }

    else if (sensorState1 == LOW){
    while(digitalRead(IRSENSOR1pin) == LOW){}  
    }
    }
    gateCounter = 0;
    Serial.println("Gclose");
          
      }
      
    }//If mouse not detected in center tube after Antenna 2 triggered
    
                 
                                                                        
}///If no mouse scanned at Antenna 2 after checktime1
   else if (Mscanned == false){

  
   ///Check to see if there is a mouse inside center tube
   //Read IR tube sensor
    sensorState3 = digitalRead(IRSENSOR3pin);
    if(sensorState3 == LOW){
    MouseInCenter = true ;
    Serial.println("Mouse in tube");

   }
   else if (sensorState3 == HIGH){
    MouseInCenter = false;
    Serial.println("Mouse not in tube");

    }

   if (MouseInCenter){
    elapsedMillis rfidTimer;


    ////EDITED THE while loop below 9/10
//    while(rfidTimer < rfidTime){
//    //******ADDD 8/5
//      
//    if(Serial1.available()!= 0){
//    mouseStuckID = Serial1.readString().substring(4,16);
//    }
//    }
    bool RFIDnotread = true;
    while(rfidTimer < 5000 and RFIDnotread){
    //******ADDD 8/5
      
    if(Serial1.available()!= 0){
    mouseStuckID = Serial1.readString().substring(4,16);
    RFIDnotread = false;
    }
    }


      //Turn antenna 2 off
      digitalWrite(Relay2pin,LOW);



   if (mouseStuckID == mouseZone1) {
      mouseZone2 = mouseStuckID;
      goto AllowEntry;
    }

      delay(200);

      //Turn antenna 1 on
      digitalWrite(Relay1pin,HIGH);
      
    gate1.writeMicroseconds(gateOpen);
    Serial.println("G1 Open");




     ///ADDED NEW CODE HERE FORGATE TIMER
    tORf = true;
   
    //Continously read from RFID 1 until the mouse leaves
    while(tORf){ 
    elapsedMillis gateTimer;
    while(gateTimer < gateTime && tORf){///// ADDED A TIME HERE AS THE FIX WHEN A MOUSE IS TRYING TO EXIT AND ANOTHER IS PRESENT IN TUBE 1
    ExitID = Serial1.readString().substring(4,16);
    Serial.println(ExitID);
    if(ExitID == mouseStuckID && ExitID !=""){ 

     
    //Close gate 1 slowly
    while(gateCounter < steps){
    sensorState1 = digitalRead(IRSENSOR1pin);
    if ( sensorState1 == HIGH){
    gate1.writeMicroseconds(gateOpen - (gateCounter+1)*degreePerStep);
    gateCounter ++;
    delay(150);
    }

    else if (sensorState1 == LOW){
    while(digitalRead(IRSENSOR1pin) == LOW){}  
    }
    }
    gateCounter = 0;
    Serial.println("G1 close");



    //Turn off antenna 1
    digitalWrite(Relay1pin,LOW);
    
    
    tORf=false;
    }
    }//while for gatetimer

   if(tORf){
    //Close gate 1 with gate safety 
    while(gateCounter < steps){
    sensorState1 = digitalRead(IRSENSOR1pin);
    if ( sensorState1 == HIGH){
    gate1.writeMicroseconds(gateOpen - (gateCounter+1)*degreePerStep);
    gateCounter ++;
    delay(150);
    }

    else if (sensorState1 == LOW){
    while(digitalRead(IRSENSOR1pin) == LOW){}  
    }
    }
    gateCounter = 0;
    Serial.println("G1 close");



    //Read IR tube sensor
    sensorState3 = digitalRead(IRSENSOR3pin);
    if(sensorState3 == LOW){
    MouseInCenter = true ;
    Serial.println("Mouse in tube");

    // Open Gate 1
    delay(500); //ADDED NEEDED A LITTLE BIT OF TIME HERE
    gate1.writeMicroseconds(gateOpen);
    Serial.println("G1 Open");

//    //Reset gate timer
//    elapsedMillis gateTimer;
    tORf = true;
    }
   
    else if (sensorState3 == HIGH){
    MouseInCenter = false;
    Serial.println("Mouse  not in tube");
    tORf = false;
    }
    }

    }
//    tORf = true;
//    //Continously read from RFID 1 until the invalid mouse leaves
//    while(tORf == true){ 
//    while(Serial1.available()==0){}
//    ExitID = Serial1.readString().substring(4,16);
////    if(Serial1.readString().substring(4,16) = mouseStuckID){
//    if(ExitID == mouseStuckID){ //added ExitID to store var and added +"==" instead if "="
//
// 
//     //Close gate 1 implement gate safety
//    while(gateCounter < steps){
//    sensorState1 = digitalRead(IRSENSOR1pin);
//    if ( sensorState1 == HIGH){
//    gate1.writeMicroseconds(gateOpen - (gateCounter+1)*degreePerStep);
//    gateCounter ++;
//    delay(150);
//    }
//
//    else if (sensorState1 == LOW){
//    while(digitalRead(IRSENSOR1pin) == LOW){}  
//    }
//    }
//    gateCounter = 0;
//    Serial.println("G1 close");
//
//     //Turn OFF RFID 1 
////      Serial1.write("SRD\r");
////      Serial1.readString(); 
//
//      //Turn off antenna 1
//      digitalWrite(Relay1pin,LOW);
//    tORf=false;
//    }
//
//    }

   }

   }//If mouse read at Antenna 2 is not the same as entry mouse
    else if(Mscanned == true && M2eM1 == false) {
   

 
    





    //Check to see if there is a mouse inside center tube
   //Read IR tube sensor
    sensorState3 = digitalRead(IRSENSOR3pin);
    if(sensorState3 == LOW){
    MouseInCenter = true ;
    Serial.println("Mouse in tube");

   }
   else if (sensorState3 == HIGH){
    MouseInCenter = false;
    Serial.println("Mouse not in tube");

    }

   if (MouseInCenter){
//    while(Serial2.available() == 0){}
//    mouseStuckID = Serial2.readString().substring(4,16);

      //Turn off antenna 2
      digitalWrite(Relay2pin,LOW);

      //Turn on antenna 1
      digitalWrite(Relay1pin,HIGH);

    
      delay(500); //OPENED TOO QUICKLY AFTER CHECKING FOR MOUSE IN TUBE
      gate1.writeMicroseconds(gateOpen);
      Serial.println("G1 Open");





///ADDED NEW CODE HERE FORGATE TIMER
    tORf = true;
   
    //Continously read from RFID 1 until the mouse leaves
    while(tORf){ 
    elapsedMillis gateTimer;
    while(gateTimer < gateTime && tORf){///// ADDED A TIME HERE AS THE FIX WHEN A MOUSE IS TRYING TO EXIT AND ANOTHER IS PRESENT IN TUBE 1

    
    ExitID = Serial1.readString().substring(4,16);
    Serial.println(ExitID);
    if(ExitID == mouseZone2){ 

     
    //Close gate 1 with gate safety 
    while(gateCounter < steps){
    sensorState1 = digitalRead(IRSENSOR1pin);
    if ( sensorState1 == HIGH){
    gate1.writeMicroseconds(gateOpen - (gateCounter+1)*degreePerStep);
    gateCounter ++;
    delay(150);
    }

    else if (sensorState1 == LOW){
    while(digitalRead(IRSENSOR1pin) == LOW){}  
    }
    }
    gateCounter = 0;
    Serial.println("G1 close");


      //Turn off antenna 1
      digitalWrite(Relay1pin,LOW);
    
    
    tORf=false;
    }
    }//while for gatetimer

   if(tORf){
    //Close gate 1 with gate safety 
    while(gateCounter < steps){
    sensorState1 = digitalRead(IRSENSOR1pin);
    if ( sensorState1 == HIGH){
    gate1.writeMicroseconds(gateOpen - (gateCounter+1)*degreePerStep);
    gateCounter ++;
    delay(150);
    }

    else if (sensorState1 == LOW){
    while(digitalRead(IRSENSOR1pin) == LOW){}  
    }
    }
    gateCounter = 0;
    Serial.println("G1 close");



    //Read IR tube sensor
    sensorState3 = digitalRead(IRSENSOR3pin);
    if(sensorState3 == LOW){
    MouseInCenter = true ;
    Serial.println("Mouse in tube");

    // Open Gate 1
    delay(500); //ADDED NEEDED A LITTLE BIT OF TIME HERE
    gate1.writeMicroseconds(gateOpen);
    Serial.println("G1 Open");

//    //Reset gate timer
//    elapsedMillis gateTimer;
    tORf = true;
    }
   
    else if (sensorState3 == HIGH){
    MouseInCenter = false;
    Serial.println("Mouse  not in tube");
    tORf = false;
    }
    }

    }






    
//    tORf = true;
//    //Continously read from RFID 1 until the invalid mouse leaves
//    while(tORf == true){ 
//    while(Serial1.available()==0){}
//    ExitID = Serial1.readString().substring(4,16);
////    if(Serial1.readString().substring(4,16) = mouseStuckID){
//    if(ExitID == mouseZone2){ //added ExitID to store var and added +"==" instead if "="
//
// 
//     //Close gate 1 implement gate safety
//    while(gateCounter < steps){
//    sensorState1 = digitalRead(IRSENSOR1pin);
//    if ( sensorState1 == HIGH){
//    gate1.writeMicroseconds(gateOpen - (gateCounter+1)*degreePerStep);
//    gateCounter ++;
//    delay(150);
//    }
//
//    else if (sensorState1 == LOW){
//    while(digitalRead(IRSENSOR1pin) == LOW){}  
//    }
//    }
//    gateCounter = 0;
//    Serial.println("G1 close");
//
//     //Turn OFF RFID 1 
////      Serial1.write("SRD\r");
////      Serial1.readString(); 
//
//      //Turn off antenna 1
//      digitalWrite(Relay1pin,LOW);
//        
//    tORf=false;
//    }
//
//    }
    }

    else{
//    Serial2.write("SRD\r");
//    Serial2.readString(); 

    //Turn off antenna 2
    digitalWrite(Relay2pin,LOW);
   }
   
 }




} //IF entries > maxEntries or time < timeout for mouse trying to enter

//Attempted entry message and check that mouse has left zone 1
else{
attemptedEntries[check]= attemptedEntries[check]+1;
Serial.print("Mouse ");
Serial.print(mouseZone1);
Serial.println(" attempted to enter");
tORf= true;
while(tORf ==true){
Serial1.write("LTG\r");
if(Serial1.readString() =="?1\r"){
tORf=false;
}
}
}


//Check to see if there is a mouse inside center tube before restarting cycle,

  //Read IR tube sensor
    sensorState3 = digitalRead(IRSENSOR3pin);
    if(sensorState3 == LOW){
    MouseInCenter = true ;
    Serial.println("Mouse in tube");

   }
   else if (sensorState3 == HIGH){
    MouseInCenter = false;
    Serial.println("Mouse  not in tube");

    }

    //Mouse stuck
    if (MouseInCenter){

    //Turn antenna 2 on
    digitalWrite(Relay2pin,HIGH);
    
    //Read from Antenna 2 for rfidTime in order to identify the ID of the stuck mouse for exit
    elapsedMillis rfidTimer;
    while(rfidTimer < rfidTime){
      
    if(Serial1.available()!= 0){
    mouseStuckID = Serial1.readString().substring(4,16);
    }
    }
    
      //Turn antenna 2 off
      digitalWrite(Relay2pin,LOW);
    
      //Turn antenna 1 on
      digitalWrite(Relay1pin,HIGH);

      //Open Gate 1
      gate1.writeMicroseconds(gateOpen);
      Serial.println("G1 Open");

    tORf = true;
   
    //Continously read from RFID 1 until the mouse leaves
    while(tORf){ 
    elapsedMillis gateTimer;
    while(gateTimer < gateTime && tORf){
    ExitID = Serial1.readString().substring(4,16);
    Serial.println(ExitID);
    if(ExitID == mouseStuckID && ExitID !=""){ 

    
    //Close gate 1 slowly
    while(gateCounter < steps){
    sensorState1 = digitalRead(IRSENSOR1pin);
    if ( sensorState1 == HIGH){
    gate1.writeMicroseconds(gateOpen - (gateCounter+1)*degreePerStep);
    gateCounter ++;
    delay(150);
    }

    else if (sensorState1 == LOW){
    while(digitalRead(IRSENSOR1pin) == LOW){}  
    }
    }
    gateCounter = 0;
    Serial.println("G1 close");


    //Turn off antenna 1
    digitalWrite(Relay1pin,LOW);
    
    
    tORf=false;
    }
    }//while loop end for timer

   //If ID was read at Antenna 1
   if(tORf){
    //Close gate 1 with gate safety 
    while(gateCounter < steps){
    sensorState1 = digitalRead(IRSENSOR1pin);
    if ( sensorState1 == HIGH){
    gate1.writeMicroseconds(gateOpen - (gateCounter+1)*degreePerStep);
    gateCounter ++;
    delay(150);
    }

    else if (sensorState1 == LOW){
    while(digitalRead(IRSENSOR1pin) == LOW){}  
    }
    }
    gateCounter = 0;
    Serial.println("G1 close");



    //Read IR tube sensor
    sensorState3 = digitalRead(IRSENSOR3pin);
    if(sensorState3 == LOW){
    MouseInCenter = true ;
    Serial.println("Mouse in tube");

    // Open Gate 1
    delay(500); //ADDED NEEDED A LITTLE BIT OF TIME HERE
    gate1.writeMicroseconds(gateOpen);
    Serial.println("G1 Open");

//    //Reset gate timer
//    elapsedMillis gateTimer;
    tORf = true;
    }
   
    else if (sensorState3 == HIGH){
    MouseInCenter = false;
    Serial.println("Mouse  not in tube");
    tORf = false;
    }
    }

    }
 }// if mouse is stuck 
 


//Resetting everything before starting a new cycle as a system redundancy
//Turn on Antenna 1, off Antenna 2/3
digitalWrite(Relay1pin,HIGH);
digitalWrite(Relay2pin,LOW);
digitalWrite(Relay3pin,LOW);

//Clear RFID board of any tags read at antenna 1
while(Serial1.available()!= 0){
Serial1.readString();
}


//Print restart cycle
Serial.println("Restart Cycle");

}//If experiment time is less than total allowable experiment time
}//While loop for overall experiment time


if (ExpTerm == true){
Serial.println("Experiment Terminated");
ExpTerm = false;
}

}
