joeyliu522/VVI-project/Python Files/serial_rx_tx.py

import serial
import sys
import _thread
import time

class SerialPort:
    def __init__(self):
        self.comportName = ""
        self.baud = 0
        self.timeout = None
        self.ReceiveCallback = None
        self.isopen = False
        self.receivedMessage = None
        self.serialport = serial.Serial()

    def __del__(self):
        try:
            if self.serialport.is_open():
                self.serialport.close()
        except:
            print("Destructor error closing COM port: ", sys.exc_info()[0] )

    def RegisterReceiveCallback(self,aReceiveCallback):
        self.ReceiveCallback = aReceiveCallback
        try:
            _thread.start_new_thread(self.SerialReadlineThread, ())
        except:
            print("Error starting Read thread: ", sys.exc_info()[0])

    def SerialReadlineThread(self):
        while True:
            try:
                if self.isopen:
                    self.receivedMessage = self.serialport.readline()
                    if self.receivedMessage != "":
                        self.ReceiveCallback(self.receivedMessage)
            except:
                print("Error reading COM port: ", sys.exc_info()[0])
                print("THE TIME IS XXXX")

    def IsOpen(self):
        return self.isopen

    def Open(self,portname,baudrate):
        if not self.isopen:
            # serialPort = 'portname', baudrate, bytesize = 8, parity = 'N', stopbits = 1, timeout = None, xonxoff = 0, rtscts = 0)
            self.serialport.port = portname
            self.serialport.baudrate = baudrate
            try:
                self.serialport.open()
                self.isopen = True
            except:
                print("Error opening COM port: ", sys.exc_info()[0])


    def Close(self):
        if self.isopen:
            try:
                self.serialport.close()
                self.isopen = False
            except:
                print("Close error closing COM port: ", sys.exc_info()[0])

    def Send(self,message):
        if self.isopen:
            try:
                # Ensure that the end of the message has both \r and \n, not just one or the other
                newmessage = message.strip()
                # newmessage += '\r\n'
                self.serialport.write(newmessage.encode('utf-8'))
            except:
                print("Error sending message: ", sys.exc_info()[0] )
            else:
                return True
        else:
            return False

    def Write_True(self):
        self.serialport.write("1".encode("utf-8"))

    def Write_False(self):
        self.serialport.write("0".encode("utf-8"))
