joeyliu522/VVI-project/(commit log)

2023-08-08 Arduino files
    Current versions of arduino files
2023-08-08 CAD Files upload
    [_1st Tube Connector.4cade9b8-f869-45e8-87a3-46bc367efd48.f3d, _2nd Tube Connector _ Revised.989060ed-b37c-41b8-80d0-8e338d962d62.f3d, _2nd Tube Connector.18cfd7fd-12f1-41a2-8cf5-8ab671b28b44.f3d, _3rd Tube Connector.98e6ea30-230d-4ec6-be3d-76e0818ba304.f3d, _3rd Tube Connector_Revised.2ad35bc1-2791-4dd6-ba4c-fde006455498.f3d, _90 Degree Cage Connector.246fc412-886c-4534-991c-9823573da5f2.f3d, _90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]
2023-08-08 CAD Update
    [10mm_bushing_retaining_ring_v0.1.fcstd, 10mm_bushing_retaining_ring_v0.1.stl, 10mm_high_precision_bushing.fcstd, 10mm_leveling_washer_spacer.fcstd, 10mm_self_aligning_bushing.fcstd, 10mmx405_rod.fcstd, 10mmx405_rod.step, 10mmx500mm_rod_v0.1_revA.fcstd]
2023-08-09 Removing old fils
    [_1st Tube Connector.4cade9b8-f869-45e8-87a3-46bc367efd48.f3d, _2nd Tube Connector _ Revised.989060ed-b37c-41b8-80d0-8e338d962d62.f3d, _2nd Tube Connector.18cfd7fd-12f1-41a2-8cf5-8ab671b28b44.f3d, _3rd Tube Connector.98e6ea30-230d-4ec6-be3d-76e0818ba304.f3d, _3rd Tube Connector_Revised.2ad35bc1-2791-4dd6-ba4c-fde006455498.f3d, _90 Degree Cage Connector.246fc412-886c-4534-991c-9823573da5f2.f3d, _90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]
